Ground-Support-Equipment-SCRT/Pad-Side-Systems/LRUs/Pad Control Unit/IDC Interface Board/idc_interface_board/.step

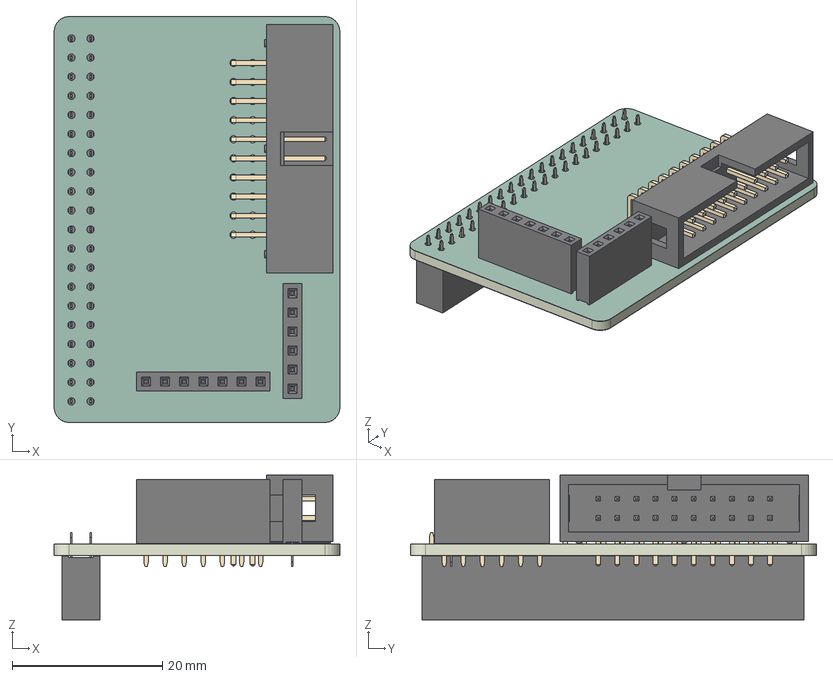
[picture p3: CAD file, 2026-10-17]
LRUs/Pad Control Unit/IDC Interface Board/idc_interface_board/.step
38.0 x 54.0 x 19.3 mm
PinSocket_1x06_P2.54mm_Vertical
IDC_Header_2x10_P254mm_Horizontal
PinSocket_1x07_P2.54mm_Vertical
PinSocket_2x20_P2.54mm_Vertical
idc_interface_board_copper
idc_interface_board_soldermask x 2
idc_interface_board_PCB
