Ground-Support-Equipment-SCRT/Pad-Side-Systems/LRUs/Valve Control Unit/Electrical/Valve Power Board/valve_control_pcb/components/36903255S/Download_STP_WE-SHC-36903255S+%28rev1%29.stp

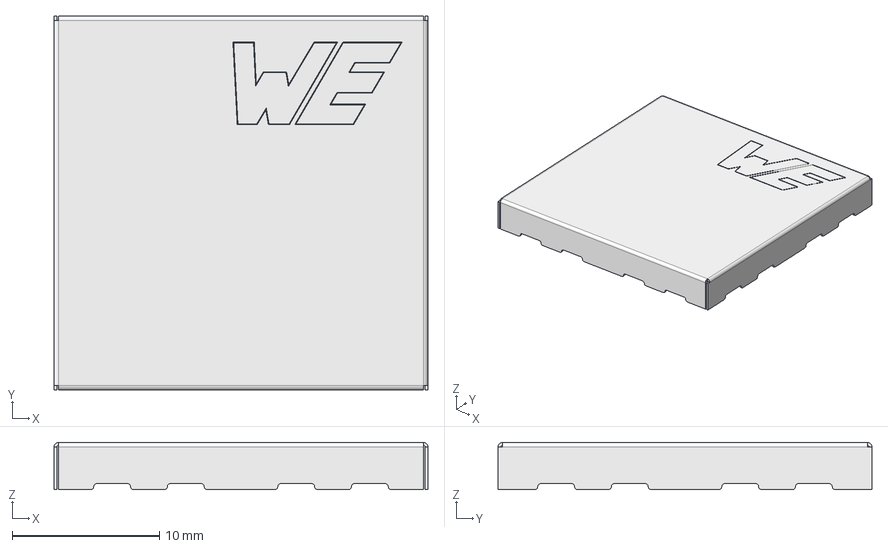
[picture p4: CAD file, 2026-07-26]
LRUs/Valve Control Unit/Electrical/Valve Power Board/valve_control_pcb/components/36903255S/Download_STP_WE-SHC-36903255S+%28rev1%29.stp
25.4 x 25.4 x 3.20 mm
