Ground-Support-Equipment-SCRT/Pad-Side-Systems/LRUs/Valve Control Unit/Electrical/Valve Power Board/valve_control_pcb/components/4259_63/SC-70-6_PSM.step

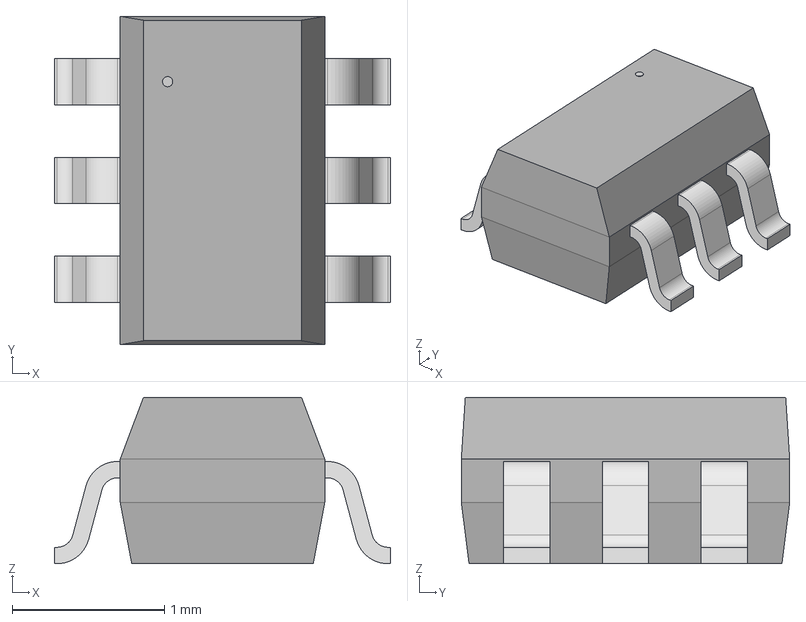
[picture p5: CAD file, 2026-07-26]
LRUs/Valve Control Unit/Electrical/Valve Power Board/valve_control_pcb/components/4259_63/SC-70-6_PSM.step
2.21 x 2.16 x 1.09 mm
