Ground-Support-Equipment-SCRT/Pad-Side-Systems/LRUs/Valve Control Unit/Electrical/Valve Power Board/valve_control_pcb/components/ADS124S08IPBSR/ADS124S08IPBSR.step

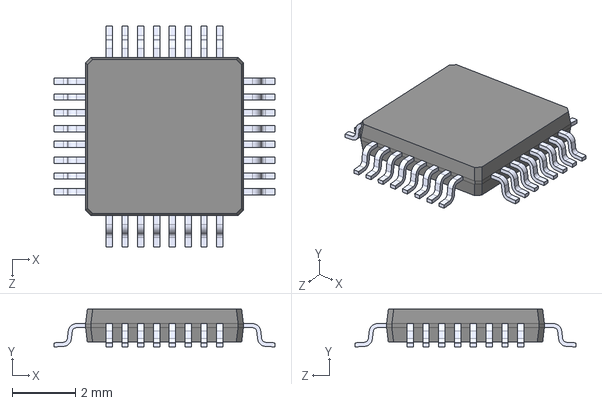
[picture p6: CAD file, 2026-08-30]
LRUs/Valve Control Unit/Electrical/Valve Power Board/valve_control_pcb/components/ADS124S08IPBSR/ADS124S08IPBSR.step
7.00 x 1.20 x 7.00 mm
