Ground-Support-Equipment-SCRT/Pad-Side-Systems/LRUs/Valve Control Unit/Electrical/Valve Power Board/valve_control_pcb/components/ESD441DPLR/DPL0002A.stp

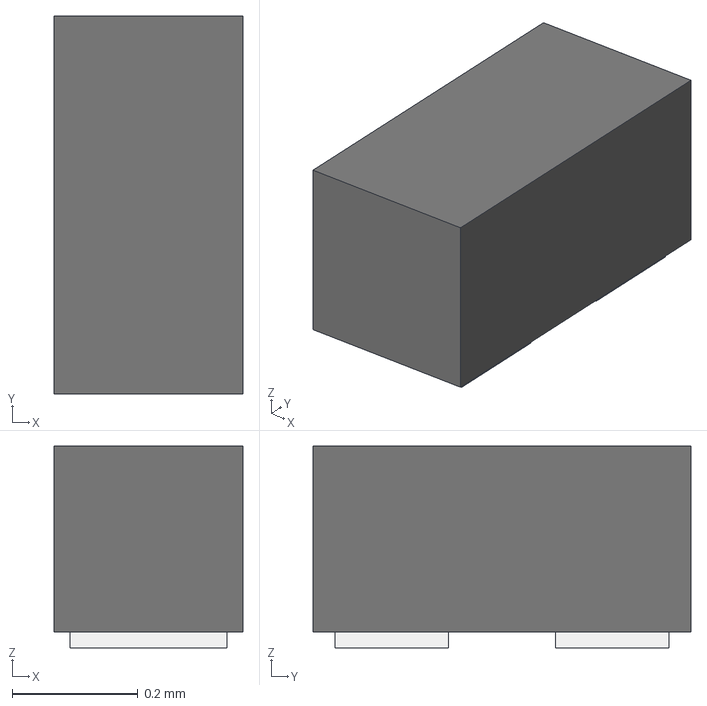
[picture p7: CAD file, 2026-07-26]
LRUs/Valve Control Unit/Electrical/Valve Power Board/valve_control_pcb/components/ESD441DPLR/DPL0002A.stp
0.3 x 0.6 x 0.32 mm
FRAME
MOLD
