Ground-Support-Equipment-SCRT/Pad-Side-Systems/LRUs/Valve Control Unit/Electrical/Valve Power Board/valve_control_pcb/components/FTSH_107_01_L_DV_K/FTSH-107-01-X-DV-K.step

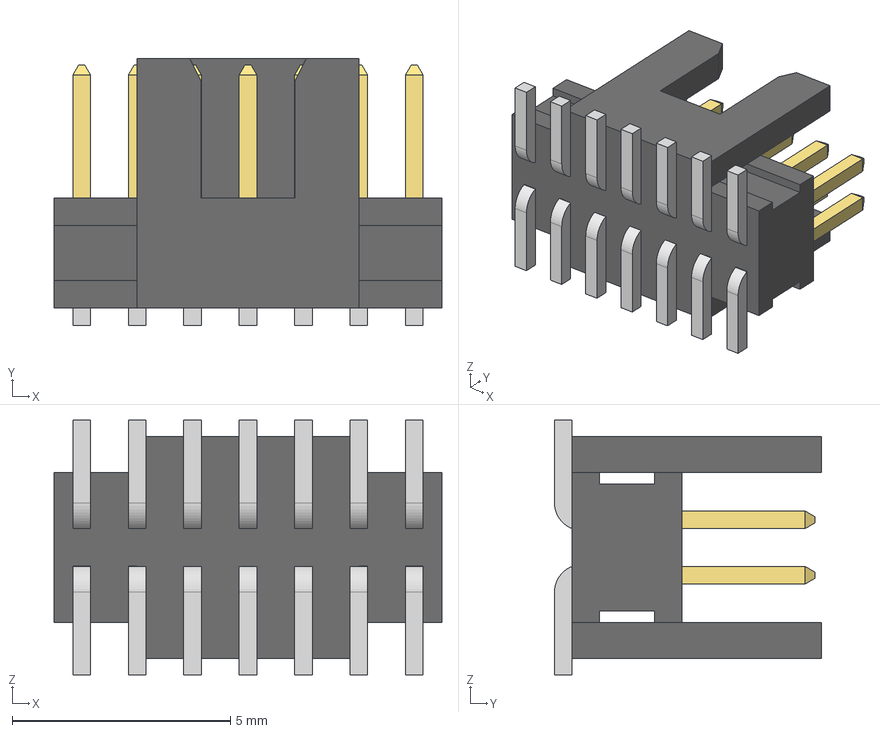
[picture p8: CAD file, 2026-10-01]
LRUs/Valve Control Unit/Electrical/Valve Power Board/valve_control_pcb/components/FTSH_107_01_L_DV_K/FTSH-107-01-X-DV-K.step
8.89 x 6.12 x 5.84 mm
FTSH-107-01-L-DV-K_body
FTSH-107-01-L-DV-K_pins1
FTSH-107-01-L-DV-K_pins2
