Ground-Support-Equipment-SCRT/Pad-Side-Systems/LRUs/Valve Control Unit/Electrical/Valve Power Board/valve_control_pcb/components/GSB1C41110SSHR/GSB1C41110SSHR.step

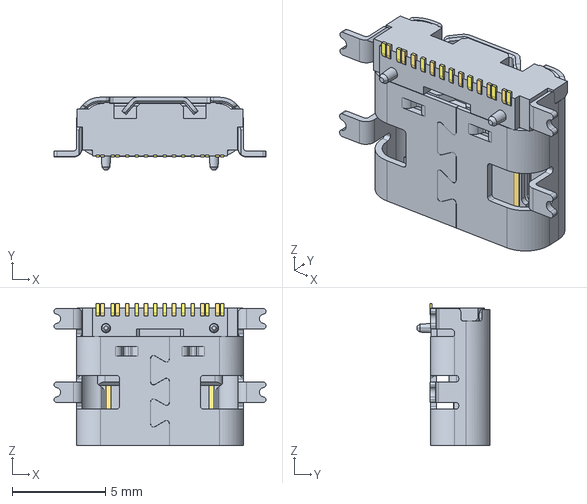
[picture p9: CAD file, 2026-07-26]
LRUs/Valve Control Unit/Electrical/Valve Power Board/valve_control_pcb/components/GSB1C41110SSHR/GSB1C41110SSHR.step
11.3 x 3.89 x 7.60 mm
