Ground-Support-Equipment-SCRT/Pad-Side-Systems/LRUs/Valve Control Unit/Electrical/Valve Power Board/valve_control_pcb/components/INA220/INA220AIDGSR-Henry-comp.step

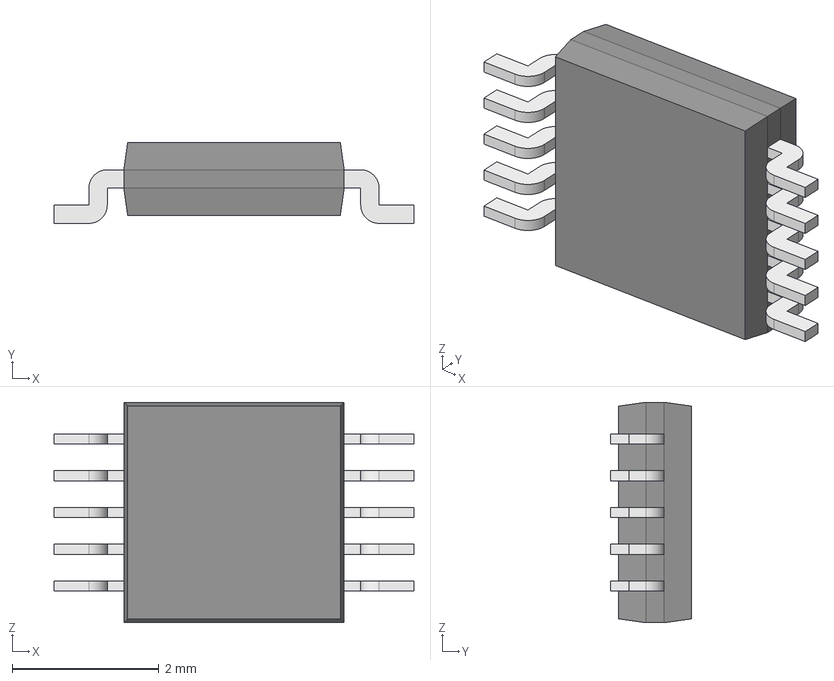
[picture p10: CAD file, 2026-08-24]
LRUs/Valve Control Unit/Electrical/Valve Power Board/valve_control_pcb/components/INA220/INA220AIDGSR-Henry-comp.step
4.90 x 1.10 x 3.00 mm
Body001 (Mirror #1) x 5
XY-plane x 12
X-axis x 12
