Ground-Support-Equipment-SCRT/Pad-Side-Systems/LRUs/Valve Control Unit/Electrical/Valve Power Board/valve_control_pcb/components/J107F1CS205VDC_45/J107F1C.stp

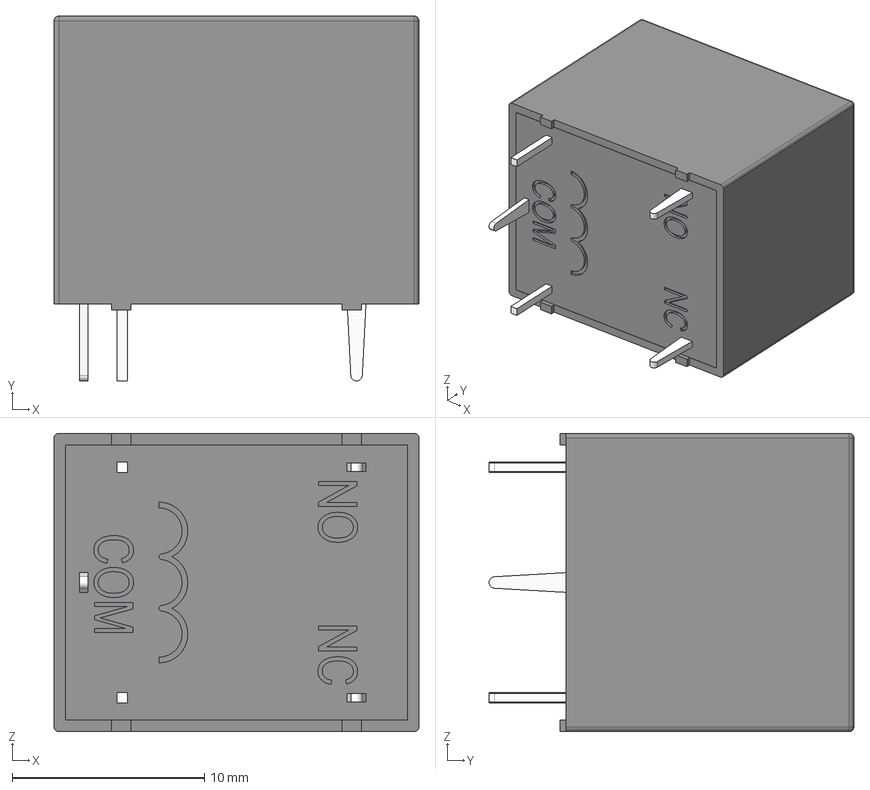
[picture p11: CAD file, 2026-07-26]
LRUs/Valve Control Unit/Electrical/Valve Power Board/valve_control_pcb/components/J107F1CS205VDC_45/J107F1C.stp
19.0 x 19.0 x 15.5 mm
J107F1C_BASE
J107F_COVER
J107F_SQ_LEAD x 2
J107F_LEAD 1 x 2
J107F_LEAD 2
