Ground-Support-Equipment-SCRT/Pad-Side-Systems/LRUs/Valve Control Unit/Electrical/Valve Power Board/valve_control_pcb/components/LM5145RGYR/RGY0020B.stp

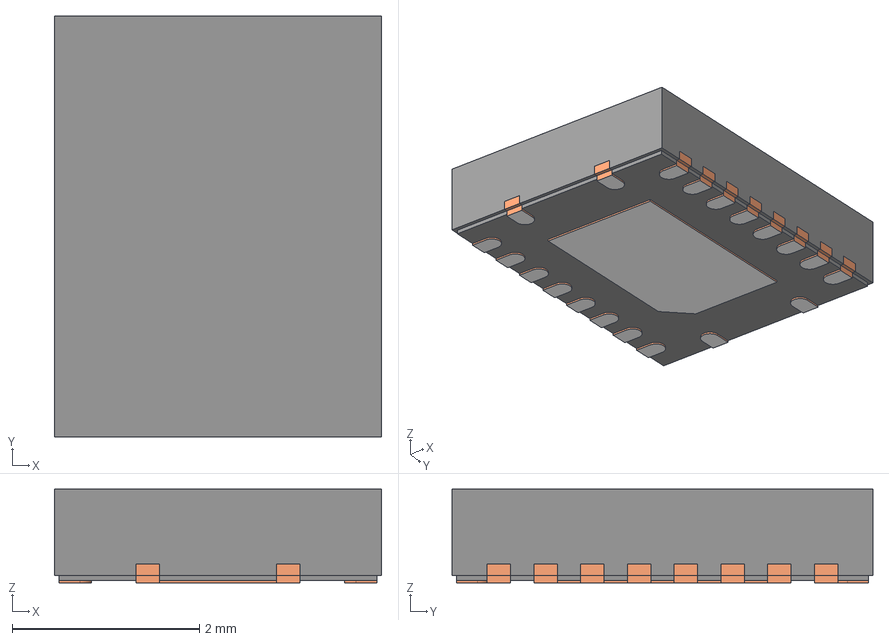
[picture p12: CAD file, 2026-07-26]
LRUs/Valve Control Unit/Electrical/Valve Power Board/valve_control_pcb/components/LM5145RGYR/RGY0020B.stp
3.50 x 4.50 x 1.00 mm
BODY-QFN_AF0
FRAME-RGY0020B_AF0
PIN1-ID
