Ground-Support-Equipment-SCRT/Pad-Side-Systems/LRUs/Valve Control Unit/Electrical/Valve Power Board/valve_control_pcb/components/MSS1278_822MLD/MSS1278.STEP

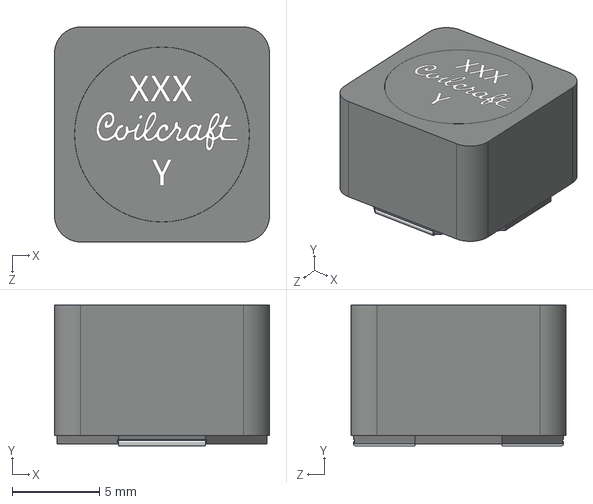
[picture p13: CAD file, 2026-08-24]
LRUs/Valve Control Unit/Electrical/Valve Power Board/valve_control_pcb/components/MSS1278_822MLD/MSS1278.STEP
12.3 x 8.05 x 12.3 mm
