Ground-Support-Equipment-SCRT/Pad-Side-Systems/LRUs/Valve Control Unit/Electrical/Valve Power Board/valve_control_pcb/components/NVMFS021N10MCLT1G/NVMFS021N10MCLT1G.step

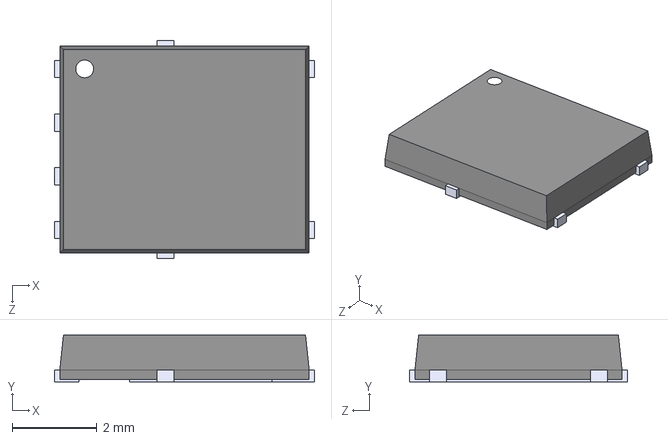
[picture p14: CAD file, 2026-07-26]
LRUs/Valve Control Unit/Electrical/Valve Power Board/valve_control_pcb/components/NVMFS021N10MCLT1G/NVMFS021N10MCLT1G.step
6.15 x 1.10 x 5.15 mm
