Ground-Support-Equipment-SCRT/Pad-Side-Systems/LRUs/Valve Control Unit/Electrical/Valve Power Board/valve_control_pcb/components/PKM22EPPH2002_B0/PKM22EPPH2002-B0.step

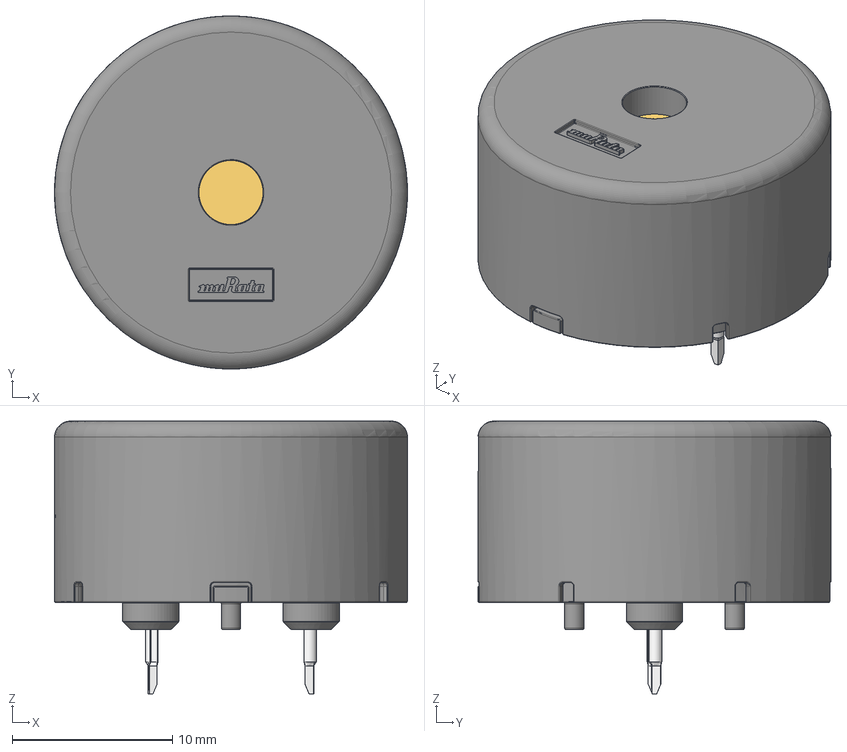
[picture p15: CAD file, 2026-07-26]
LRUs/Valve Control Unit/Electrical/Valve Power Board/valve_control_pcb/components/PKM22EPPH2002_B0/PKM22EPPH2002-B0.step
22.0 x 22.0 x 17.0 mm
Package
Membrane
Leads
