Ground-Support-Equipment-SCRT/Pad-Side-Systems/LRUs/Valve Control Unit/Electrical/Valve Power Board/valve_control_pcb/components/RAPC722X/RAPC722X.step

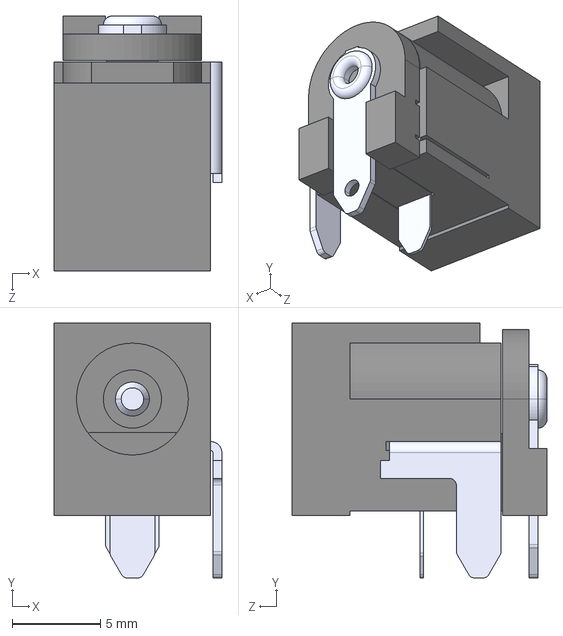
[picture p16: CAD file, 2026-07-26]
LRUs/Valve Control Unit/Electrical/Valve Power Board/valve_control_pcb/components/RAPC722X/RAPC722X.step
9.53 x 14.5 x 14.5 mm
