Ground-Support-Equipment-SCRT/Pad-Side-Systems/LRUs/Valve Control Unit/Electrical/Valve Power Board/valve_control_pcb/components/RFM69HW_433S2/RFM69HW-433S2.STEP

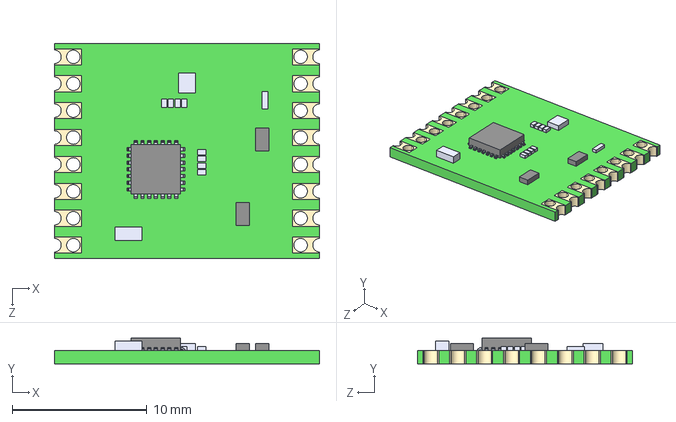
[picture p17: CAD file, 2026-07-26]
LRUs/Valve Control Unit/Electrical/Valve Power Board/valve_control_pcb/components/RFM69HW_433S2/RFM69HW-433S2.STEP
19.7 x 1.90 x 16.0 mm
