Ground-Support-Equipment-SCRT/Pad-Side-Systems/LRUs/Valve Control Unit/Electrical/Valve Power Board/valve_control_pcb/components/SiR882ADP/SIR882ADP-T1-GE3.STEP

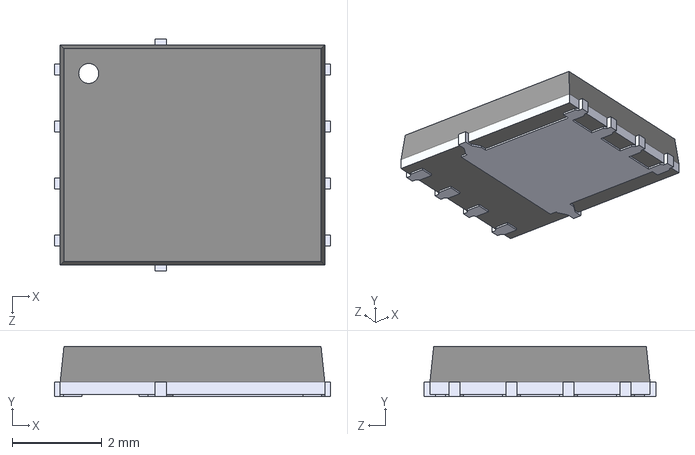
[picture p18: CAD file, 2026-07-26]
LRUs/Valve Control Unit/Electrical/Valve Power Board/valve_control_pcb/components/SiR882ADP/SIR882ADP-T1-GE3.STEP
6.15 x 1.12 x 5.16 mm
