Ground-Support-Equipment-SCRT/Pad-Side-Systems/LRUs/Valve Control Unit/Electrical/Valve Power Board/valve_control_pcb/components/SN74HC32DR/SN74HC32DR-Henry-comp.step

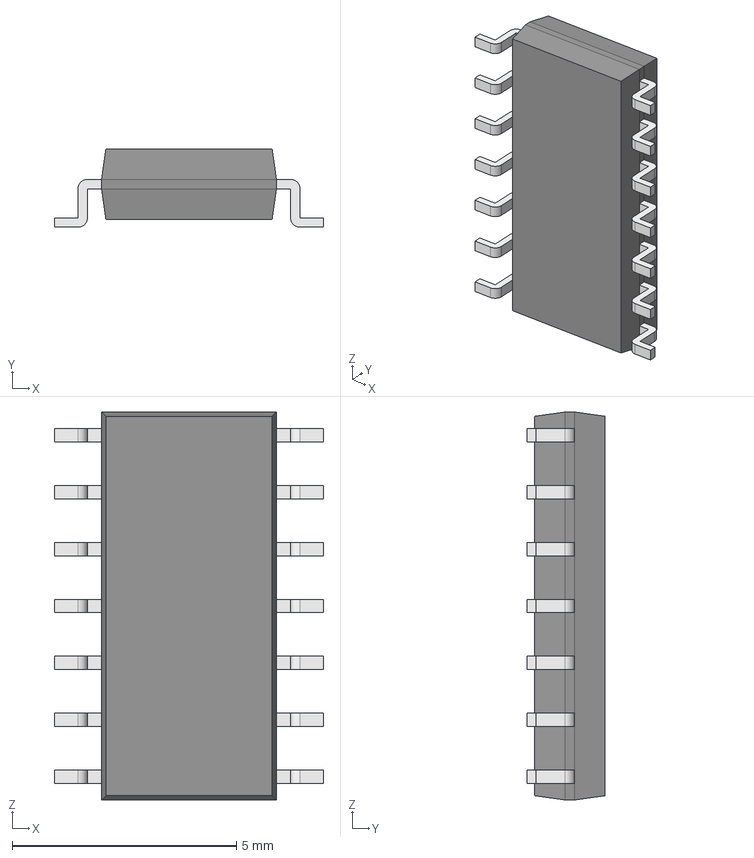
[picture p19: CAD file, 2026-08-24]
LRUs/Valve Control Unit/Electrical/Valve Power Board/valve_control_pcb/components/SN74HC32DR/SN74HC32DR-Henry-comp.step
6.00 x 1.75 x 8.65 mm
Body001 (Mirror #1) x 7
XY-plane x 12
X-axis x 12
