Ground-Support-Equipment-SCRT/Pad-Side-Systems/LRUs/Valve Control Unit/Electrical/Valve Power Board/valve_control_pcb/components/SN74LVC2G08MDCUREP/SN74LVC2G08MDCUREP.step

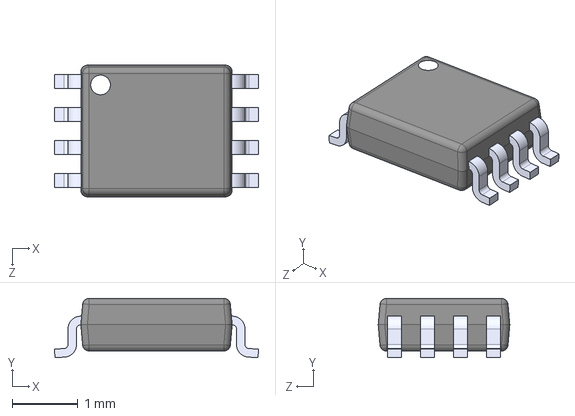
[picture p20: CAD file, 2026-07-26]
LRUs/Valve Control Unit/Electrical/Valve Power Board/valve_control_pcb/components/SN74LVC2G08MDCUREP/SN74LVC2G08MDCUREP.step
3.10 x 0.9 x 2.00 mm
