Ground-Support-Equipment-SCRT/Pad-Side-Systems/LRUs/Valve Control Unit/Electrical/Valve Power Board/valve_control_pcb/components/SP485EEN_L_TR/NSOIC-8.step

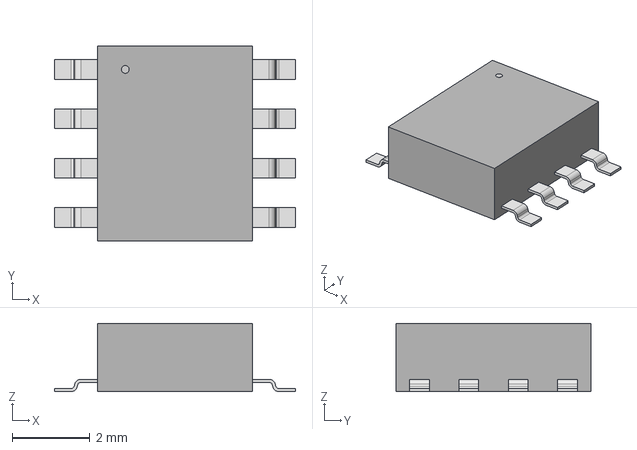
[picture p21: CAD file, 2026-07-26]
LRUs/Valve Control Unit/Electrical/Valve Power Board/valve_control_pcb/components/SP485EEN_L_TR/NSOIC-8.step
6.20 x 5.00 x 1.75 mm
