Ground-Support-Equipment-SCRT/Pad-Side-Systems/LRUs/Valve Control Unit/Electrical/Valve Power Board/valve_control_pcb/components/ul_TPS27SA08CPWPR/PWP0016M.stp

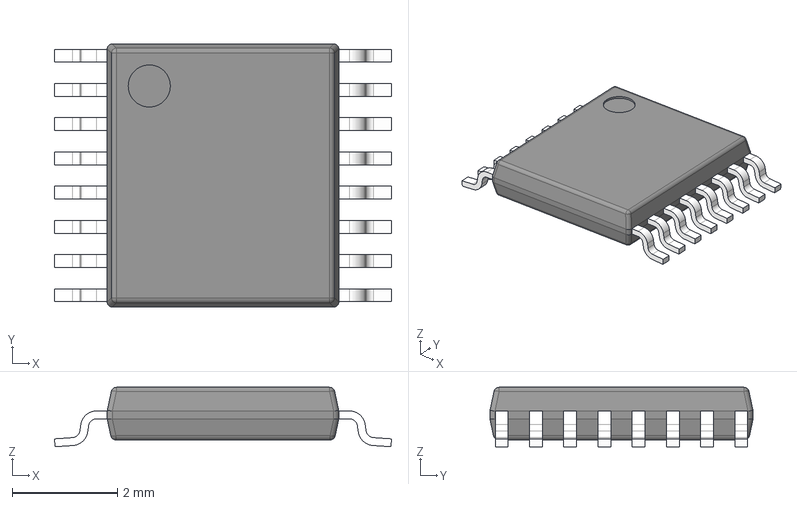
[picture p22: CAD file, 2026-08-24]
LRUs/Valve Control Unit/Electrical/Valve Power Board/valve_control_pcb/components/ul_TPS27SA08CPWPR/PWP0016M.stp
6.40 x 5.00 x 1.13 mm
BODY-TSSOP
LEAD-TSSOP x 16
PIN1
DAP
