Ground-Support-Equipment-SCRT/Pad-Side-Systems/LRUs/Valve Control Unit/Electrical/Valve Power Board/valve_control_pcb/components/USB-C/CQ-USB-C16PSMT01--3DModel-STEP-1.STEP

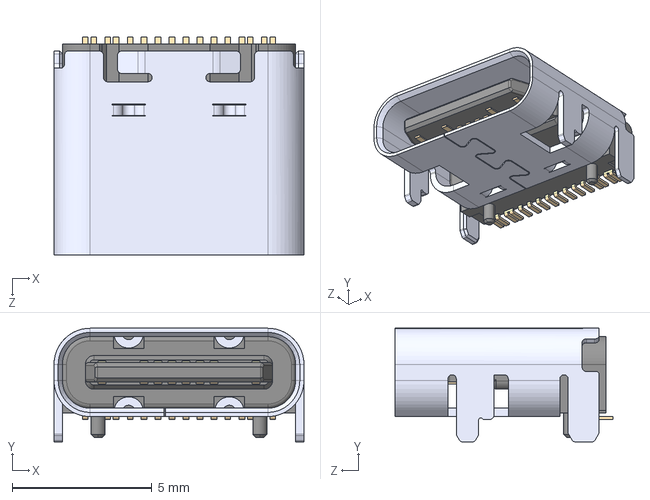
[picture p23: CAD file, 2026-07-26]
LRUs/Valve Control Unit/Electrical/Valve Power Board/valve_control_pcb/components/USB-C/CQ-USB-C16PSMT01--3DModel-STEP-1.STEP
8.94 x 4.06 x 7.81 mm
