Ground-Support-Equipment-SCRT/Pad-Side-Systems/LRUs/Valve Control Unit/Electrical/Valve Power Board/valve_control_pcb/components/W25Q128JVSIQ_TR/W25Q128JVSIQ TR.step

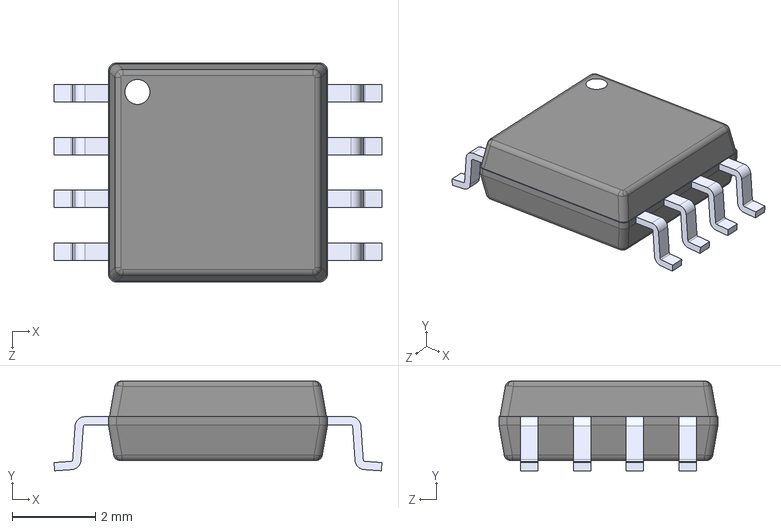
[picture p24: CAD file, 2026-10-01]
LRUs/Valve Control Unit/Electrical/Valve Power Board/valve_control_pcb/components/W25Q128JVSIQ_TR/W25Q128JVSIQ TR.step
7.90 x 2.16 x 5.28 mm
