Ground-Support-Equipment-SCRT/Pad-Side-Systems/LRUs/Valve Control Unit/Electrical/Valve Power Board/valve_control_pcb/components/XAL7030_161MEC/XAL7030-161MEC.step

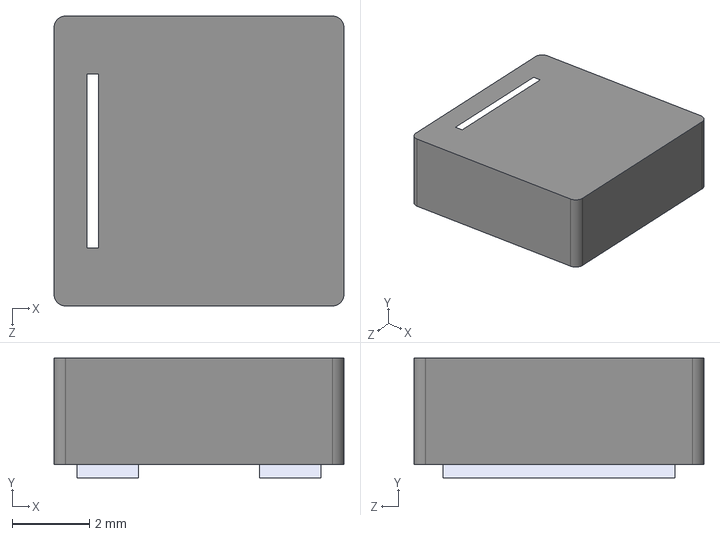
[picture p25: CAD file, 2026-08-24]
LRUs/Valve Control Unit/Electrical/Valve Power Board/valve_control_pcb/components/XAL7030_161MEC/XAL7030-161MEC.step
7.50 x 3.10 x 7.50 mm
