Ground-Support-Equipment-SCRT/Pad-Side-Systems/LRUs/Valve Control Unit/Electrical/Valve Power Board/valve_control_pcb/components/XAL7070-332MEC/XAL7070-332MEC-Henry-comp.step

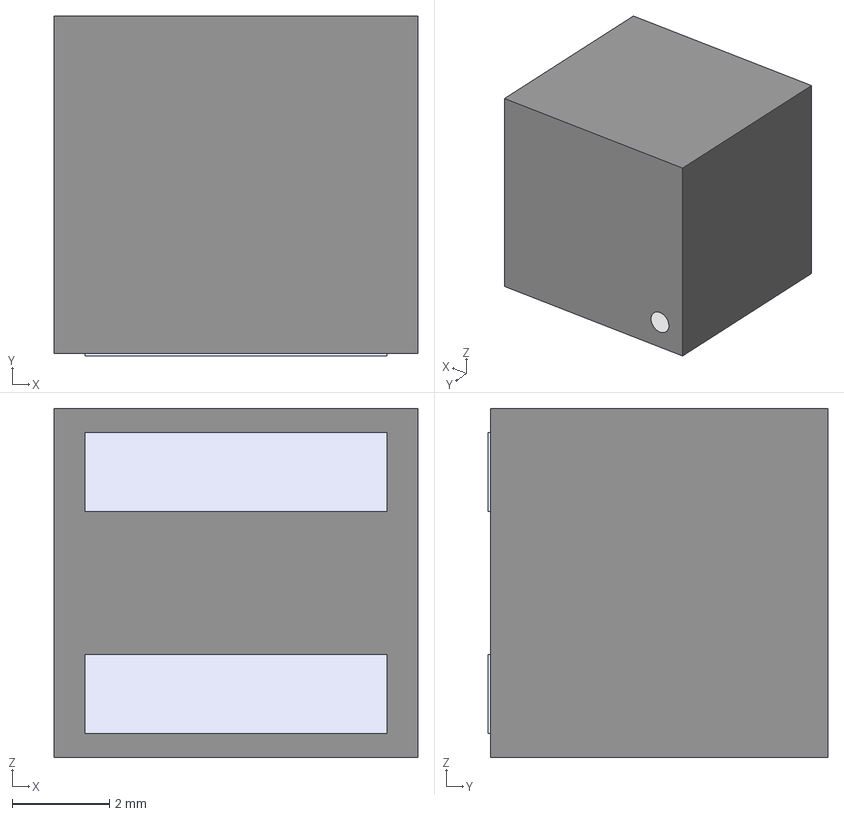
[picture p26: CAD file, 2026-08-24]
LRUs/Valve Control Unit/Electrical/Valve Power Board/valve_control_pcb/components/XAL7070-332MEC/XAL7070-332MEC-Henry-comp.step
7.50 x 7.00 x 7.20 mm
BaseWithTopCut
TopCircle_NewBody
