Ground-Support-Equipment-SCRT/Pad-Side-Systems/LRUs/Valve Control Unit/Electrical/Valve Power Board/valve_control_pcb/valve_control_pcb.step

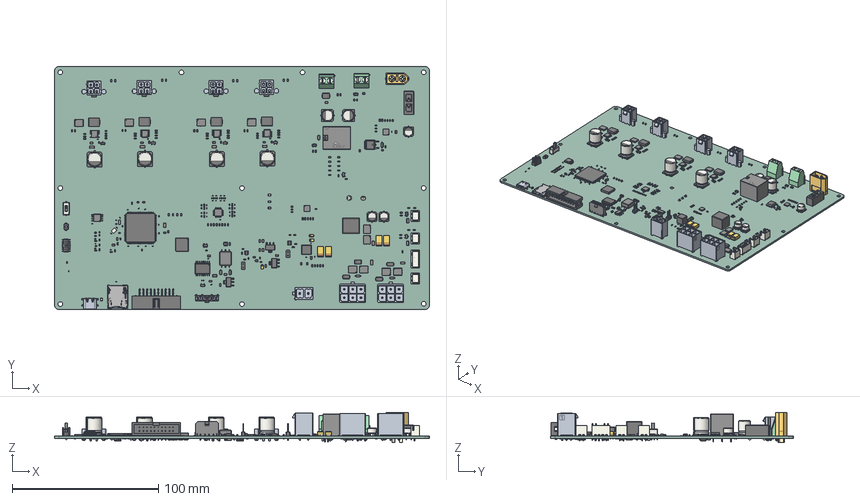
[picture p27: CAD file, 2026-10-08]
LRUs/Valve Control Unit/Electrical/Valve Power Board/valve_control_pcb/valve_control_pcb.step
256.0 x 166.0 x 20.5 mm
C_0402_1005Metric x 59
CP_Elec_10x126 x 4
R_0402_1005Metric x 44
LQFP-144_20x20mm_P0.5mm
LED_0603_1608Metric x 19
R_0603_1608Metric x 195
C_0805_2012Metric x 25
microSD_HC_Hirose_DM3AT-SF-PEJM5
D_SMB
C_0603_1608Metric x 16
CP_Elec_63x54 x 3
D_SOD-123 x 6
BODY-TSSOP x 4
LEAD-TSSOP x 64
PIN1 x 4
DAP x 4
SOT-223 x 3
SIR826ADP-T1-GE3 x 10
SOT-23 x 16
R_1206_3216Metric
JST_B2B_XH_A x 3
UCC21750
TerminalBlock_Phoenix_MKDS-1,5-2-5.08_1x02_P5.08mm_Horizontal x 2
LED_0805_2012Metric x 4
ADS124S08IPBSR
C_1206_3216Metric x 11
CP_EIA_3216_18_Kemet_A x 3
RGE24 x 2
Buzzer_Murata_PKMCS0909E4000_R1
A_Keystone_3568
CP_EIA_7343_31_Kemet_D x 4
CP_Elec_8x105 x 2
JST_B4B_XH_A
L_0603_1608Metric x 2
J107F1C_BASE
J107F_COVER
J107F_SQ_LEAD x 2
J107F_LEAD 1 x 2
J107F_LEAD 2
Crystal_SMD_3215-2Pin_3.2x1.5mm
U.FL_Hirose_U.FL-R-SMT-1_Vertical x 2
D_SMC x 4
SOT-583-8 x 2
L_Coilcraft_XAL1010-XXX
D_SMA x 4
SW_Push_SPST_NO_Alps_SKRK
FTSH-107-01-L-DV-K_body
FTSH-107-01-L-DV-K_pins1
FTSH-107-01-L-DV-K_pins2
SOT-23-6 x 3
W25Q32JWSSIQ
SOT-23-5
PinHeader_1x02_P254mm_Vertical x 2
250-1201_6A
150-3076_6A
SW_Slide_SPDT_Straight_CK_OS102011MS2Q
L_Coilcraft_XAL6060-XXX
_16P_7_35_3D_
IDC_Header_2x10_P254mm_Horizontal
Crystal_SMD_3225-4Pin_3.2x2.5mm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
