Ground-Support-Equipment-SCRT/Pad-Side-Systems/(list of files, cad)

Other CAD files:
LRUs/Valve Control Unit/Electrical/Valve Power Board/valve_control_pcb/components/09242206824/09242206824.stp
LRUs/Valve Control Unit/Electrical/Valve Power Board/valve_control_pcb/components/39299047/39299047.STEP
LRUs/Valve Control Unit/Electrical/Valve Power Board/valve_control_pcb/components/436500215/436500215.STEP
LRUs/Valve Control Unit/Electrical/Valve Power Board/valve_control_pcb/components/436500415/436500415.STEP
LRUs/Valve Control Unit/Electrical/Valve Power Board/valve_control_pcb/components/436500600/436500600.STEP
LRUs/Valve Control Unit/Electrical/Valve Power Board/valve_control_pcb/components/750315371/750315371.stp
LRUs/Valve Control Unit/Electrical/Valve Power Board/valve_control_pcb/components/768290110/768290110.STEP
LRUs/Valve Control Unit/Electrical/Valve Power Board/valve_control_pcb/components/ISO1450BDWR (1)/ISO1450BDWR.step
LRUs/Valve Control Unit/Electrical/Valve Power Board/valve_control_pcb/components/ISO3080DWR/ISO3080DWR.step
LRUs/Valve Control Unit/Electrical/Valve Power Board/valve_control_pcb/components/LIB_76829-0102/76829-0102/3D/76829-0102.stp
LRUs/Valve Control Unit/Electrical/Valve Power Board/valve_control_pcb/components/LIB_76829-0102/76829-0102/Allegro/768290102.psm
LRUs/Valve Control Unit/Electrical/Valve Power Board/valve_control_pcb/components/LIB_76829-0102/76829-0102/DEHDL/76829_0102/chips/chips.prt
LRUs/Valve Control Unit/Electrical/Valve Power Board/valve_control_pcb/components/LIB_76829-0106/76829-0106/3D/76829-0106.stp
LRUs/Valve Control Unit/Electrical/Valve Power Board/valve_control_pcb/components/LIB_76829-0106/76829-0106/Allegro/768290106.psm
LRUs/Valve Control Unit/Electrical/Valve Power Board/valve_control_pcb/components/LIB_76829-0106/76829-0106/DEHDL/76829_0106/chips/chips.prt
LRUs/Valve Control Unit/Electrical/Valve Power Board/valve_control_pcb/components/TPS259830ONRGER (1)/TPS259830ONRGER.step
LRUs/Valve Control Unit/Electrical/Valve Power Board/valve_control_pcb/components/TPS79533DCQR/TPS79533DCQR.step
