Ground-Support-Equipment-SCRT/Pad-Side-Systems/LRUs/Valve Control Unit/Electrical/Valve Power Board/Review Package/RUBY_REVA_SCHEMATIC.pdf

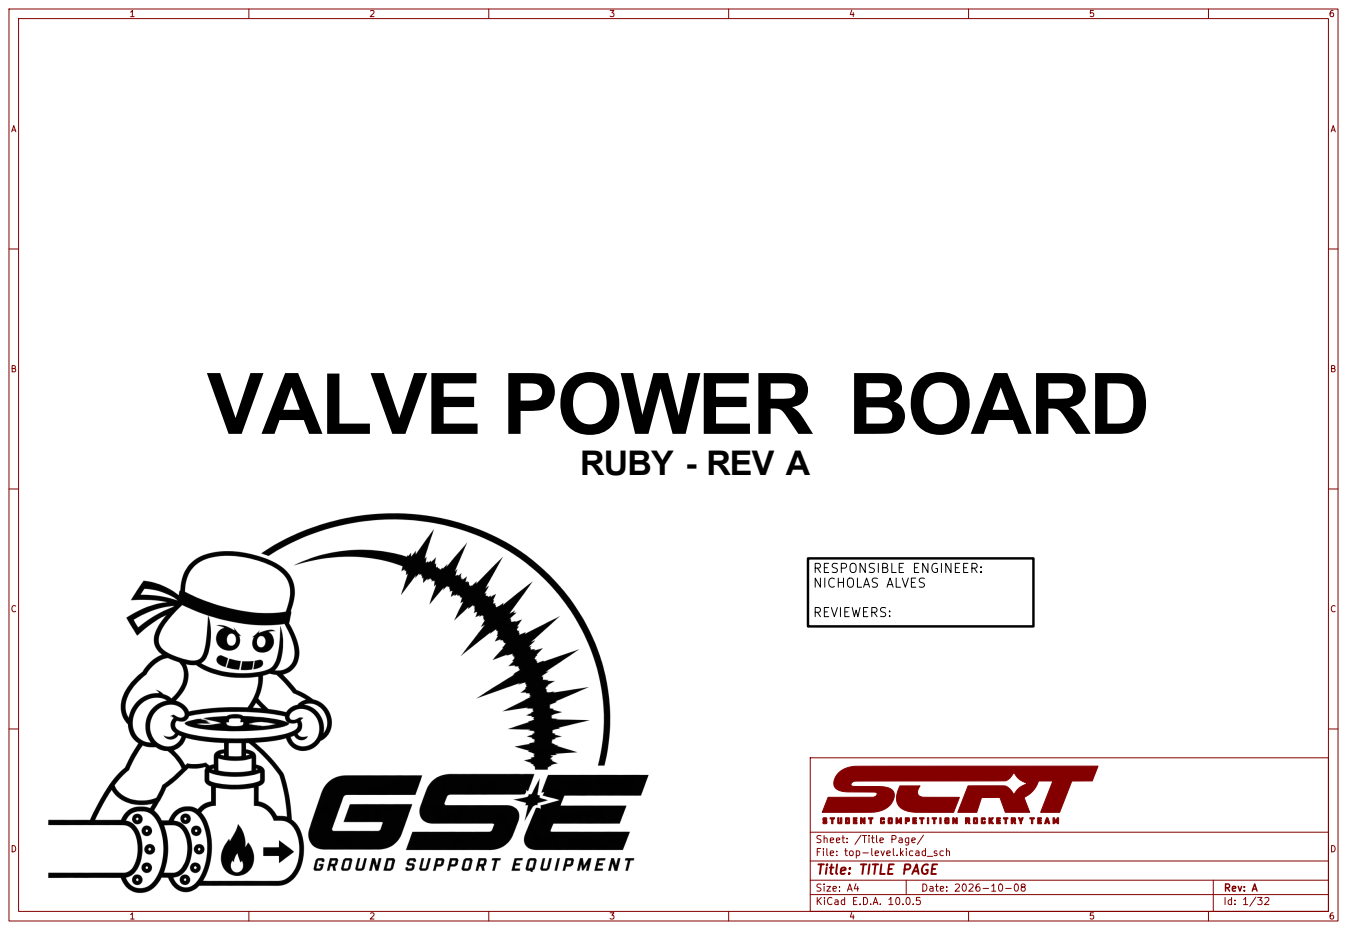
[picture p28: page 1]

Size: A4 | Rev: A
KiCad E.D.A. 10.0.5 | Id: 1/32

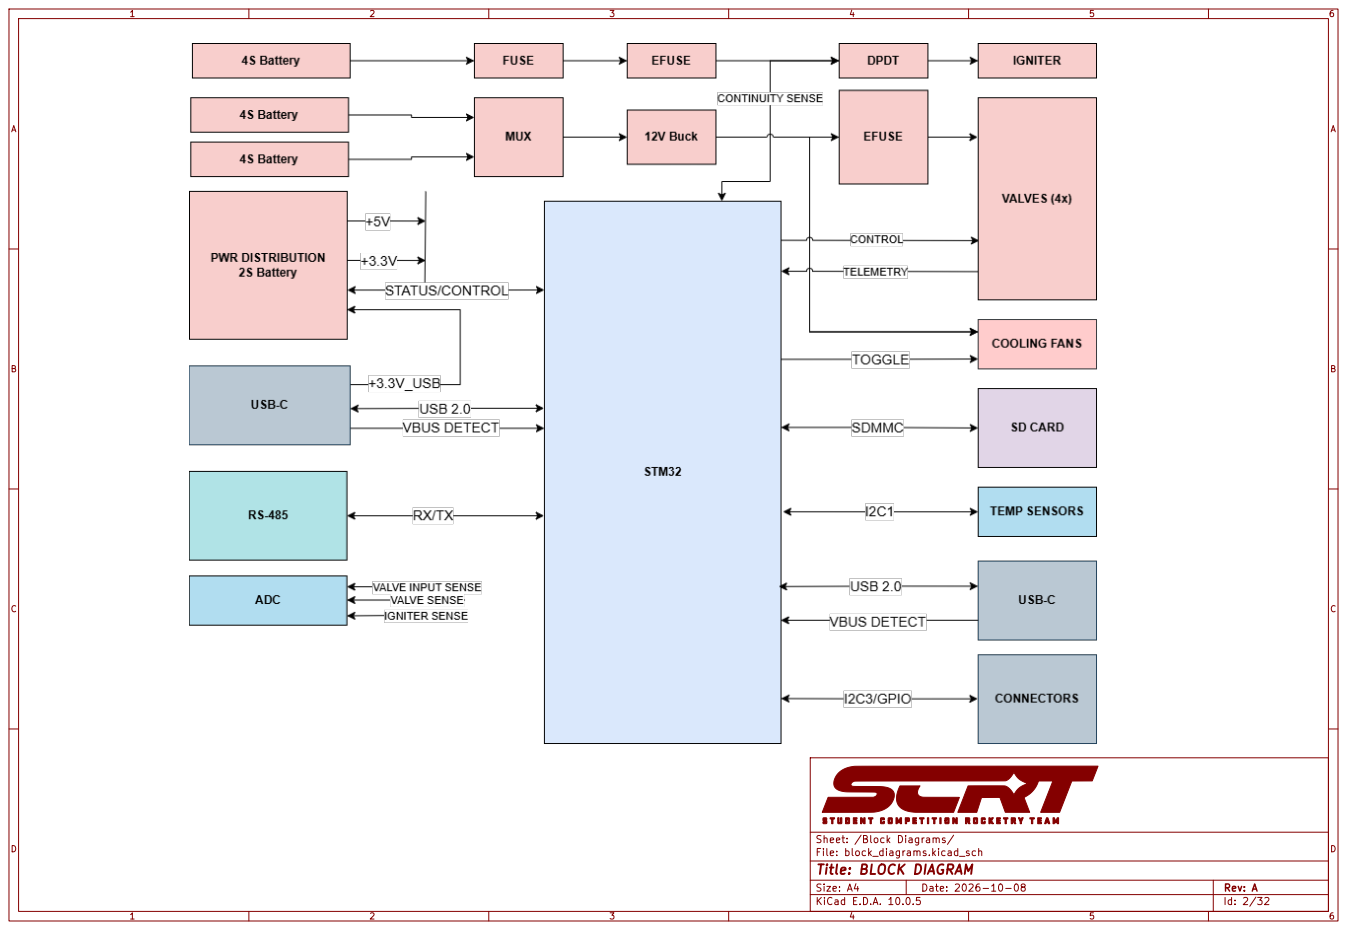
[picture p29: page 2]

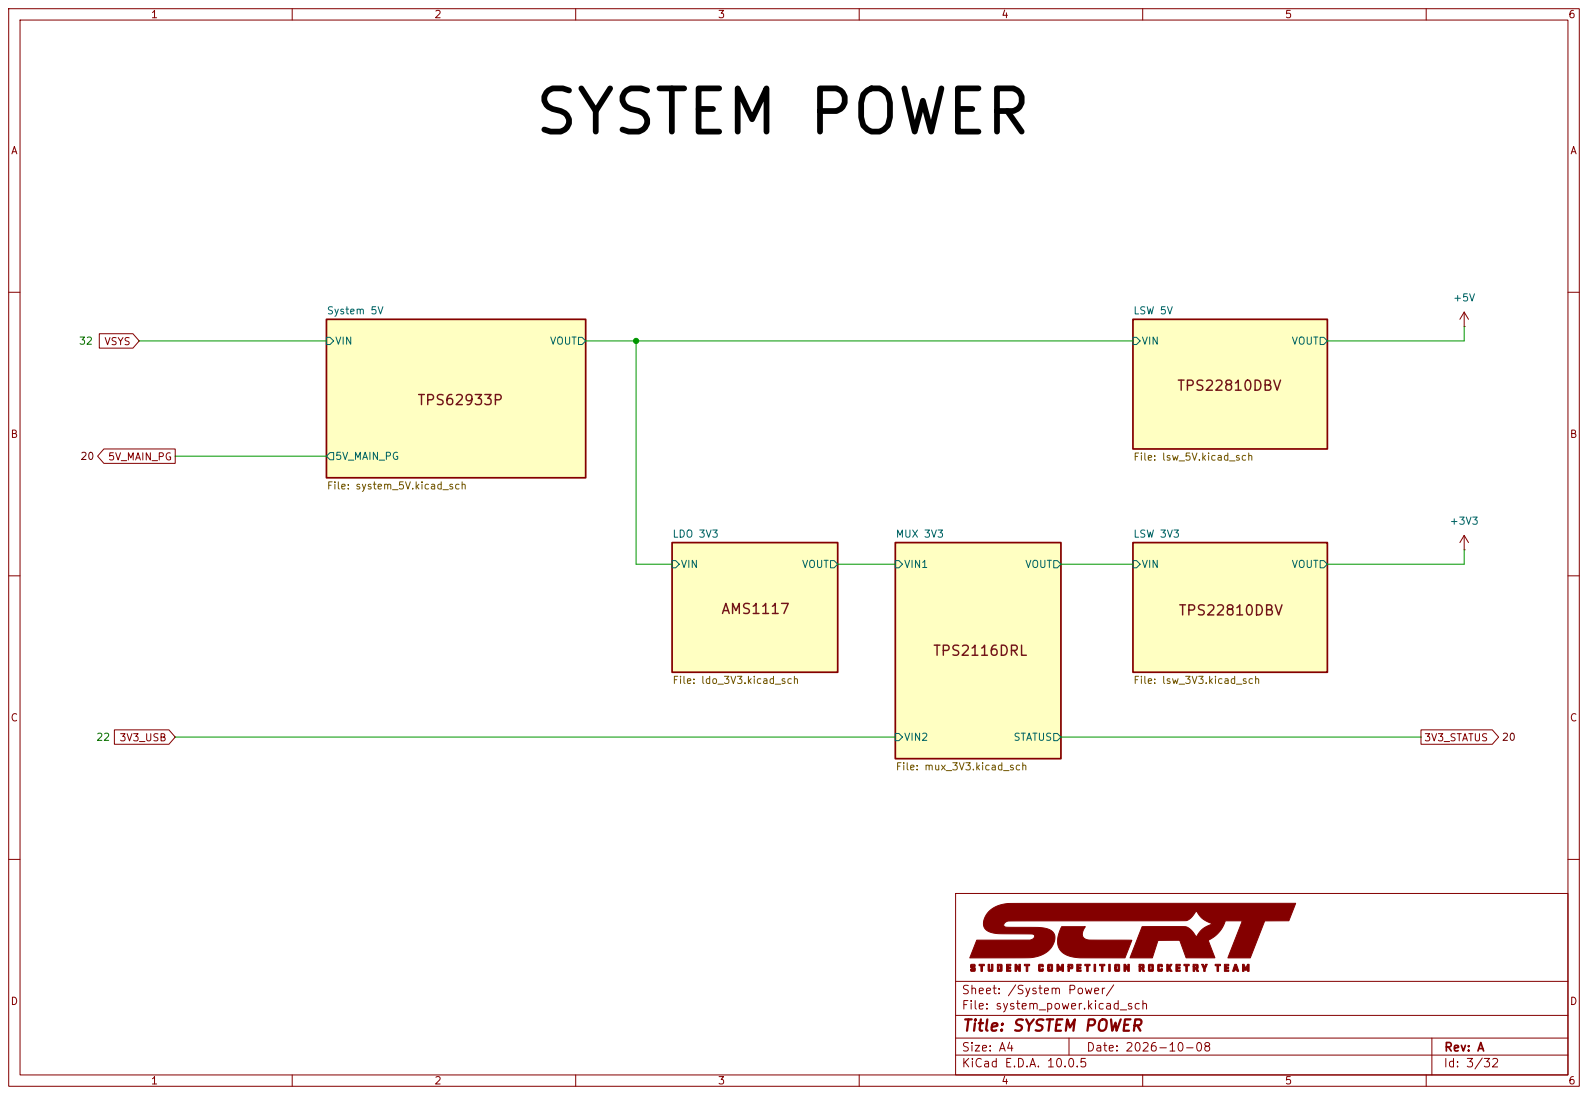
[picture p30: page 3]

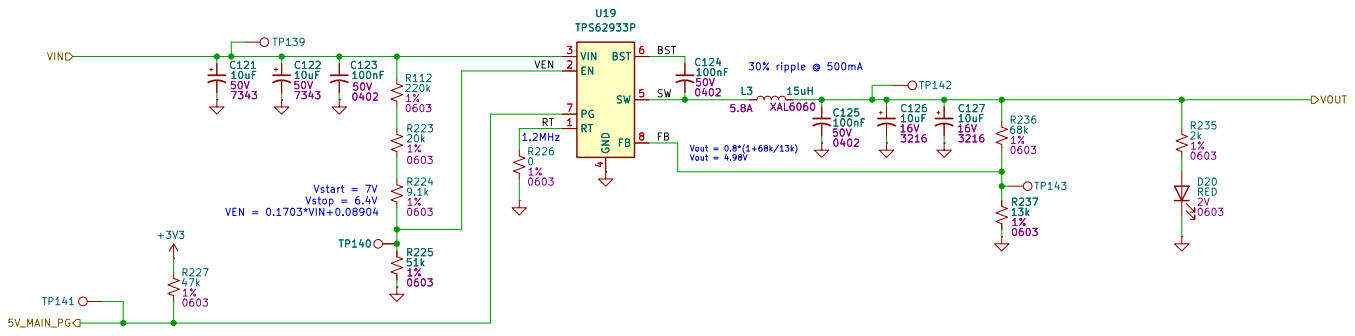
[picture p31: page 4]

Sheet: /System Power/System 5V/
File: system_5V.kicad_sch
Title: SYSTEM 5V

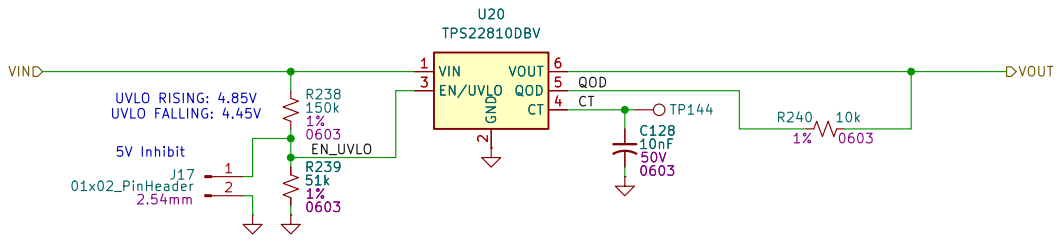
[picture p32: page 5]

Sheet: /System Power/LSW 5V/
File: lsw_5V.kicad_sch
Title: LSW 5V

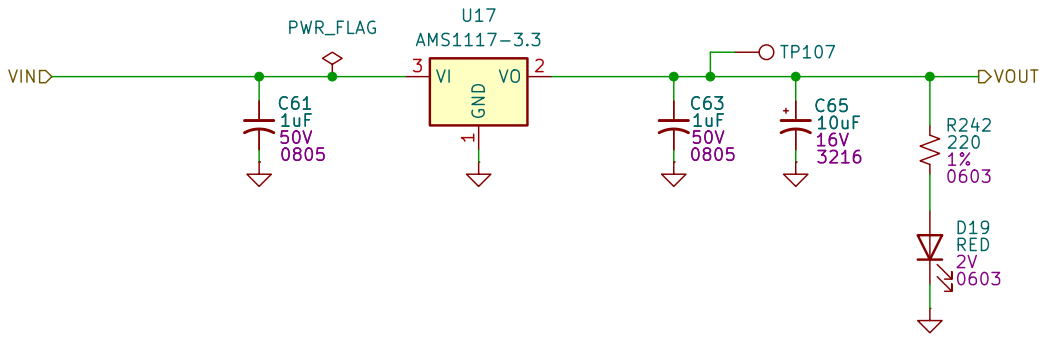
[picture p33: page 6]

Sheet: /System Power/LDO 3V3/
File: ldo_3V3.kicad_sch
Title: LDO 3V3

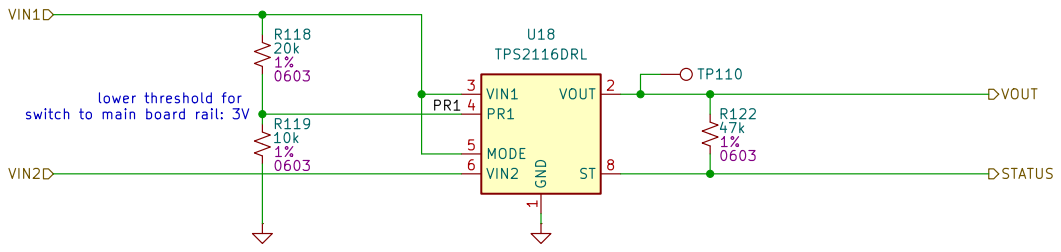
[picture p34: page 7]

Sheet: /System Power/MUX 3V3/
File: mux_3V3.kicad_sch
Title: MUX 3V3

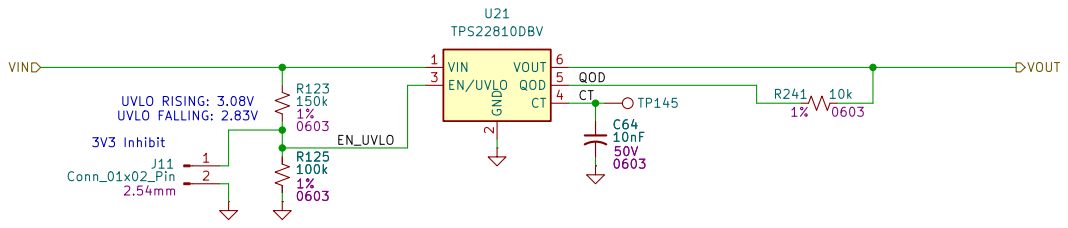
[picture p35: page 8]

Sheet: /System Power/LSW 3V3/
File: lsw_3V3.kicad_sch
Title: LSW 3V3

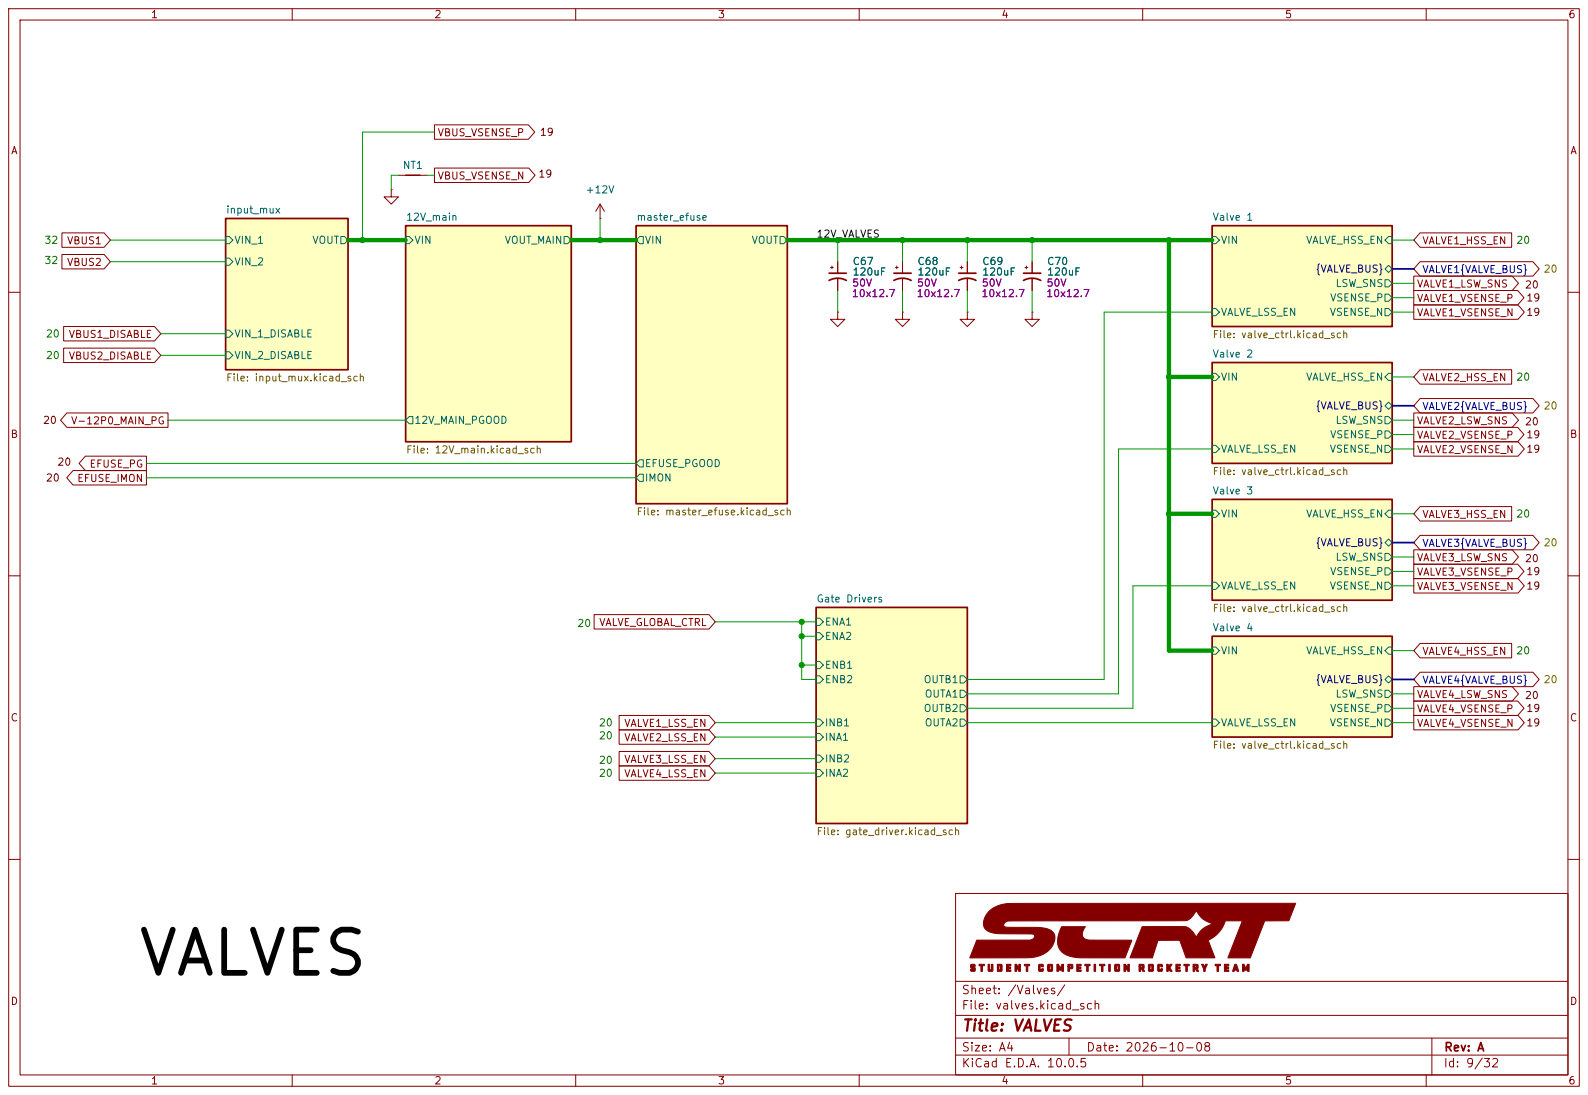
[picture p36: page 9]

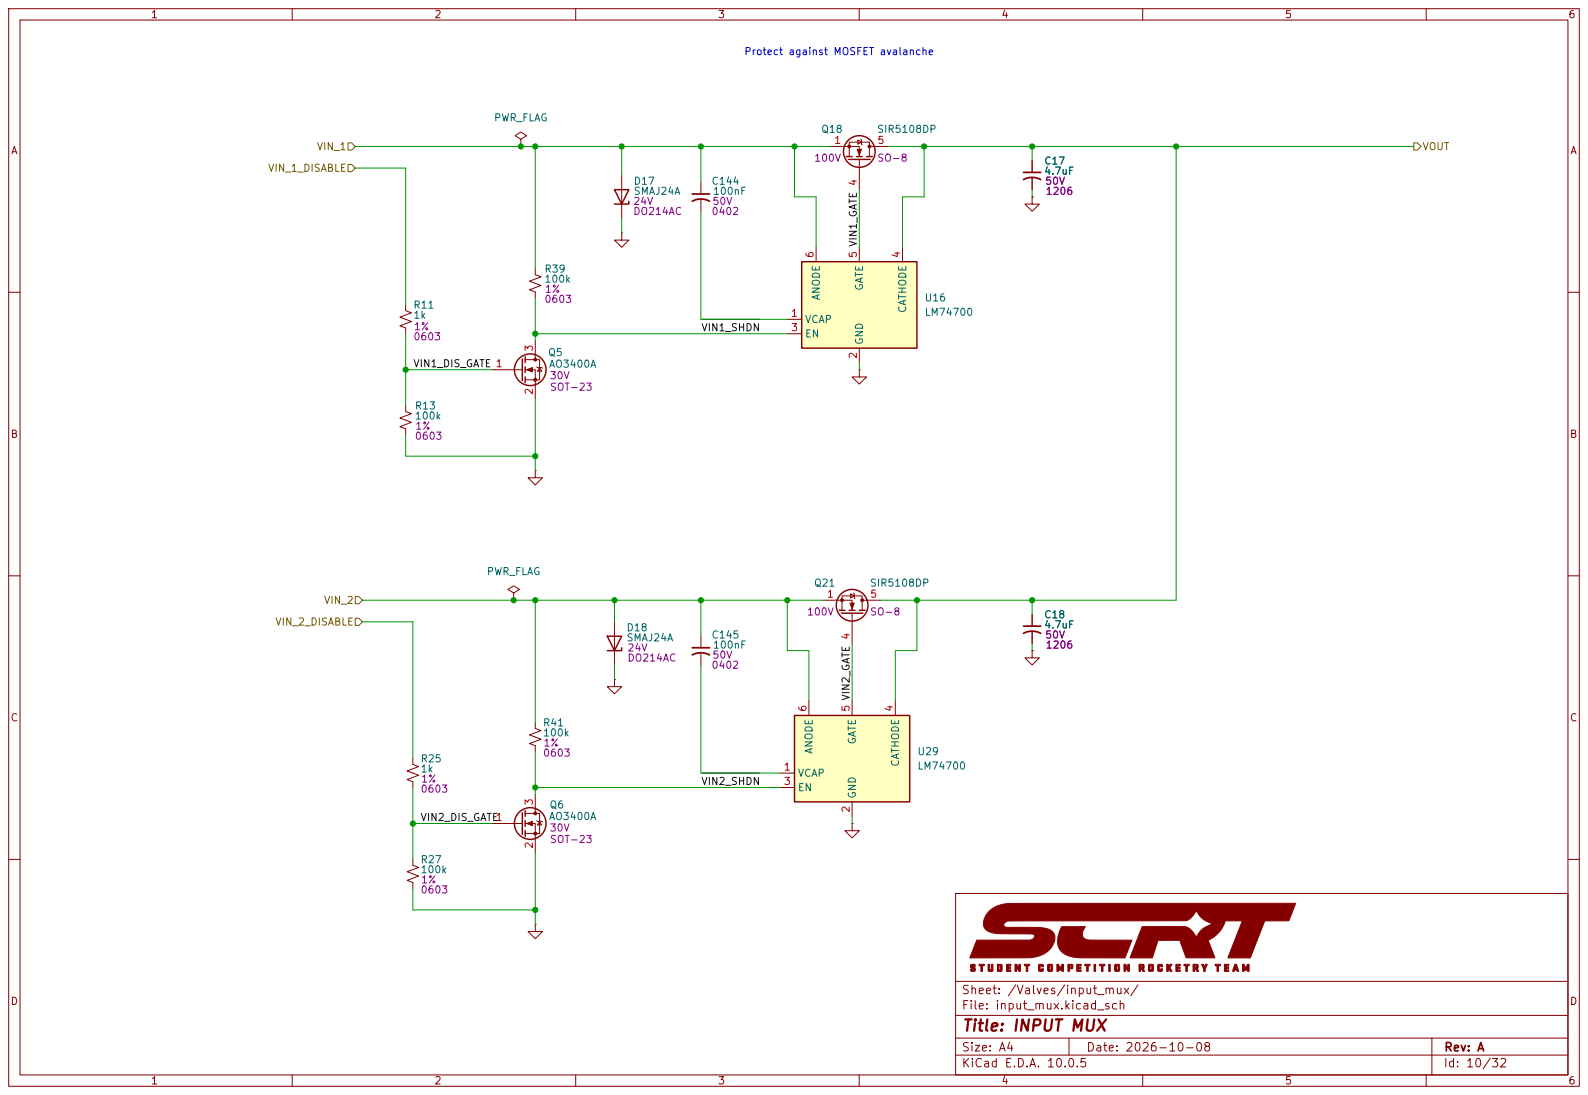
[picture p37: page 10]

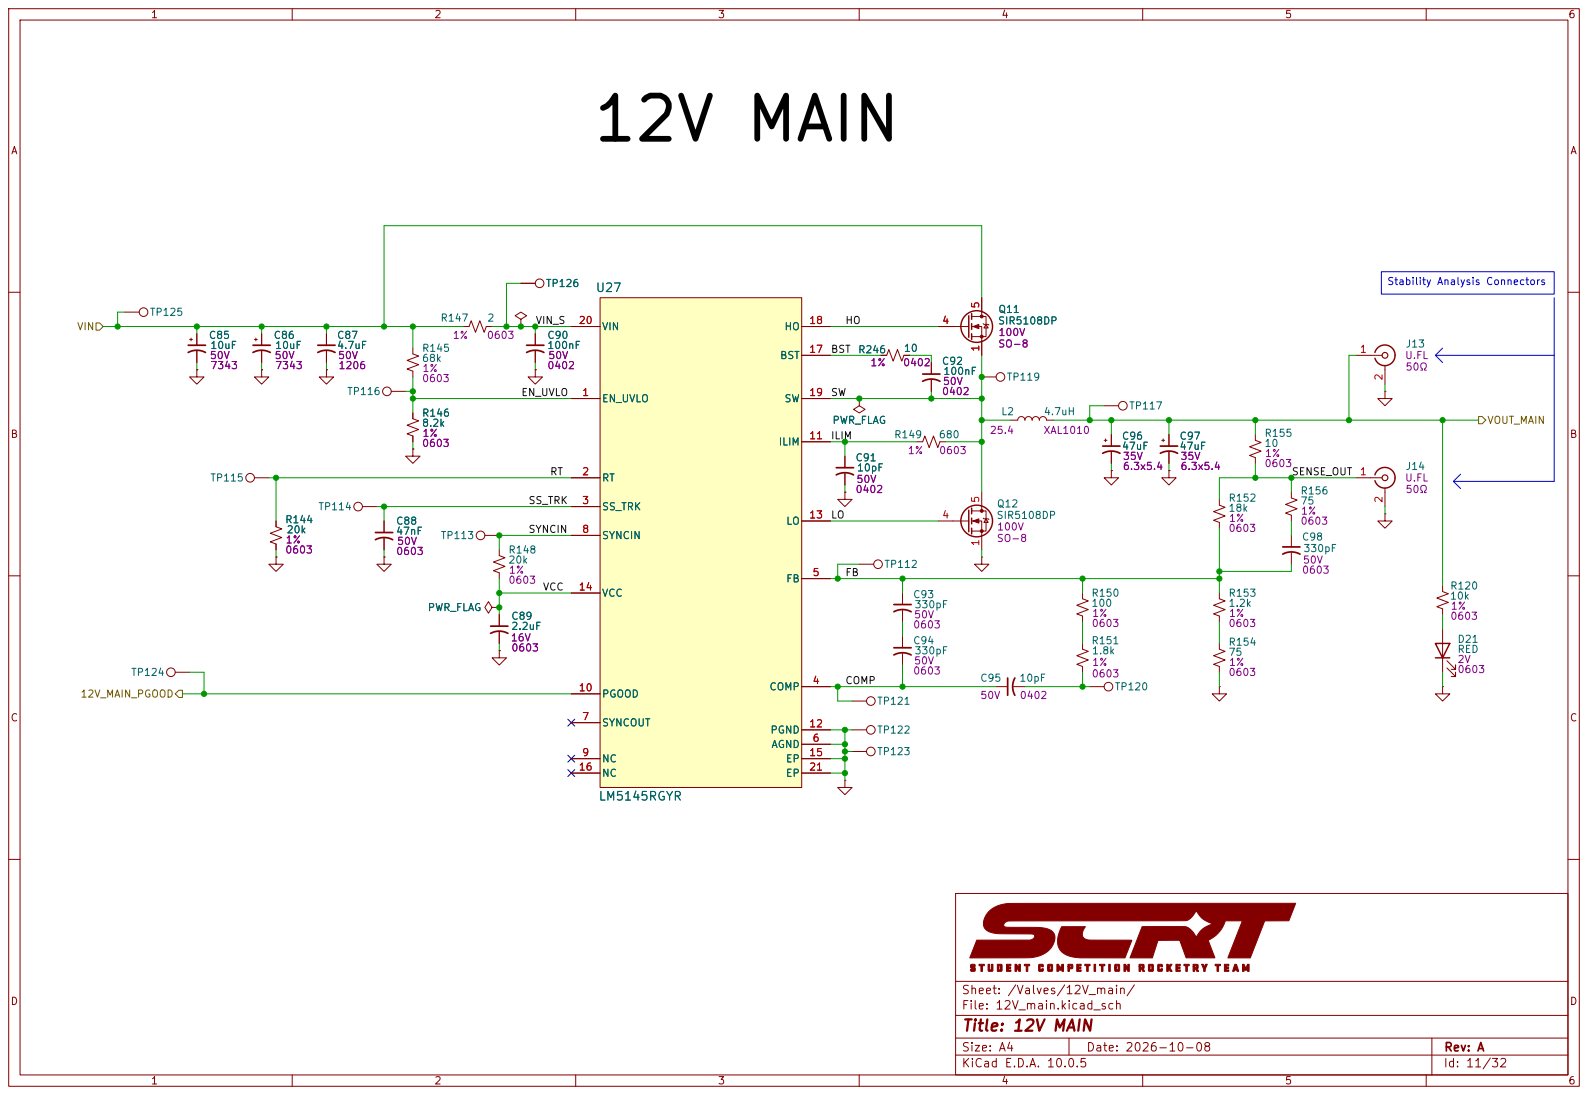
[picture p38: page 11]

Stability Analysis Connectors 12V MAIN

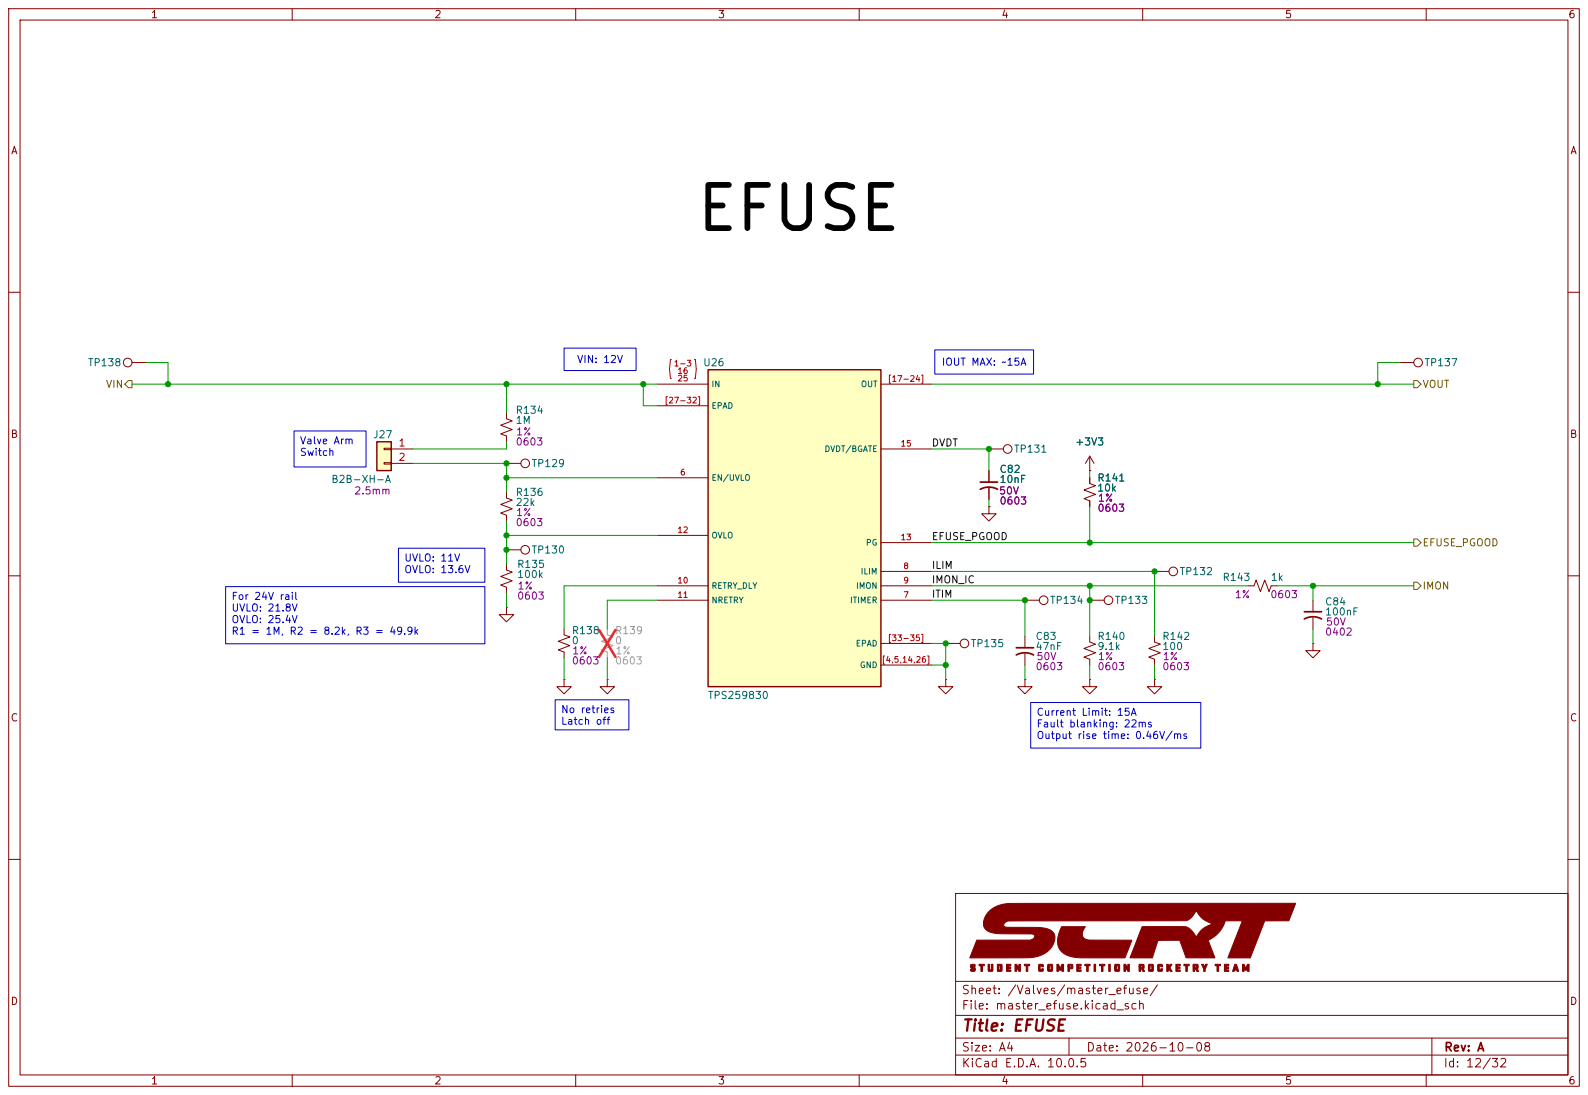
[picture p39: page 12]

Fault blanking: 22ms Output rise time: 0.46V/ms For 24V rail UVLO: 21.8V OVLO: 25.4V R1 = 1M, R2 = 8.2k, R3 = 49.9k UVLO: 11V OVLO: 13.6V

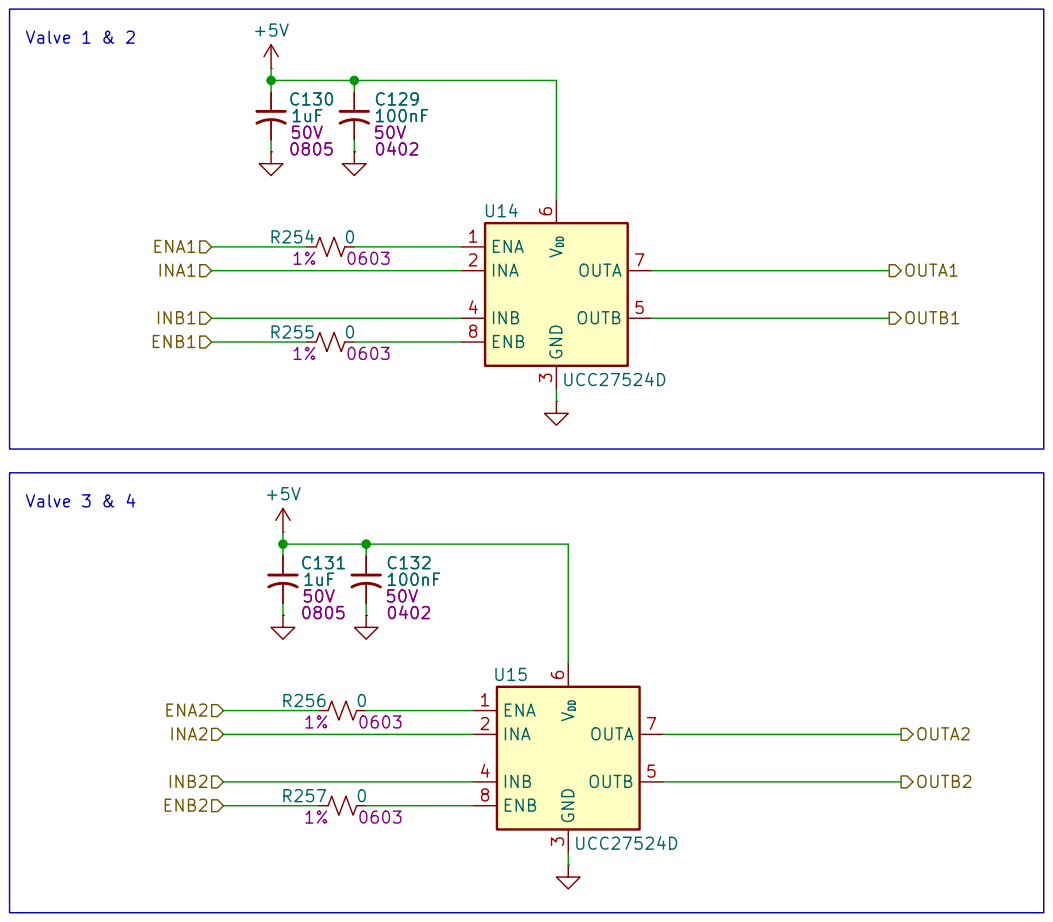
[picture p40: page 13]

Sheet: /Valves/Gate Drivers/
File: gate_driver.kicad_sch
Title: Gate Drivers

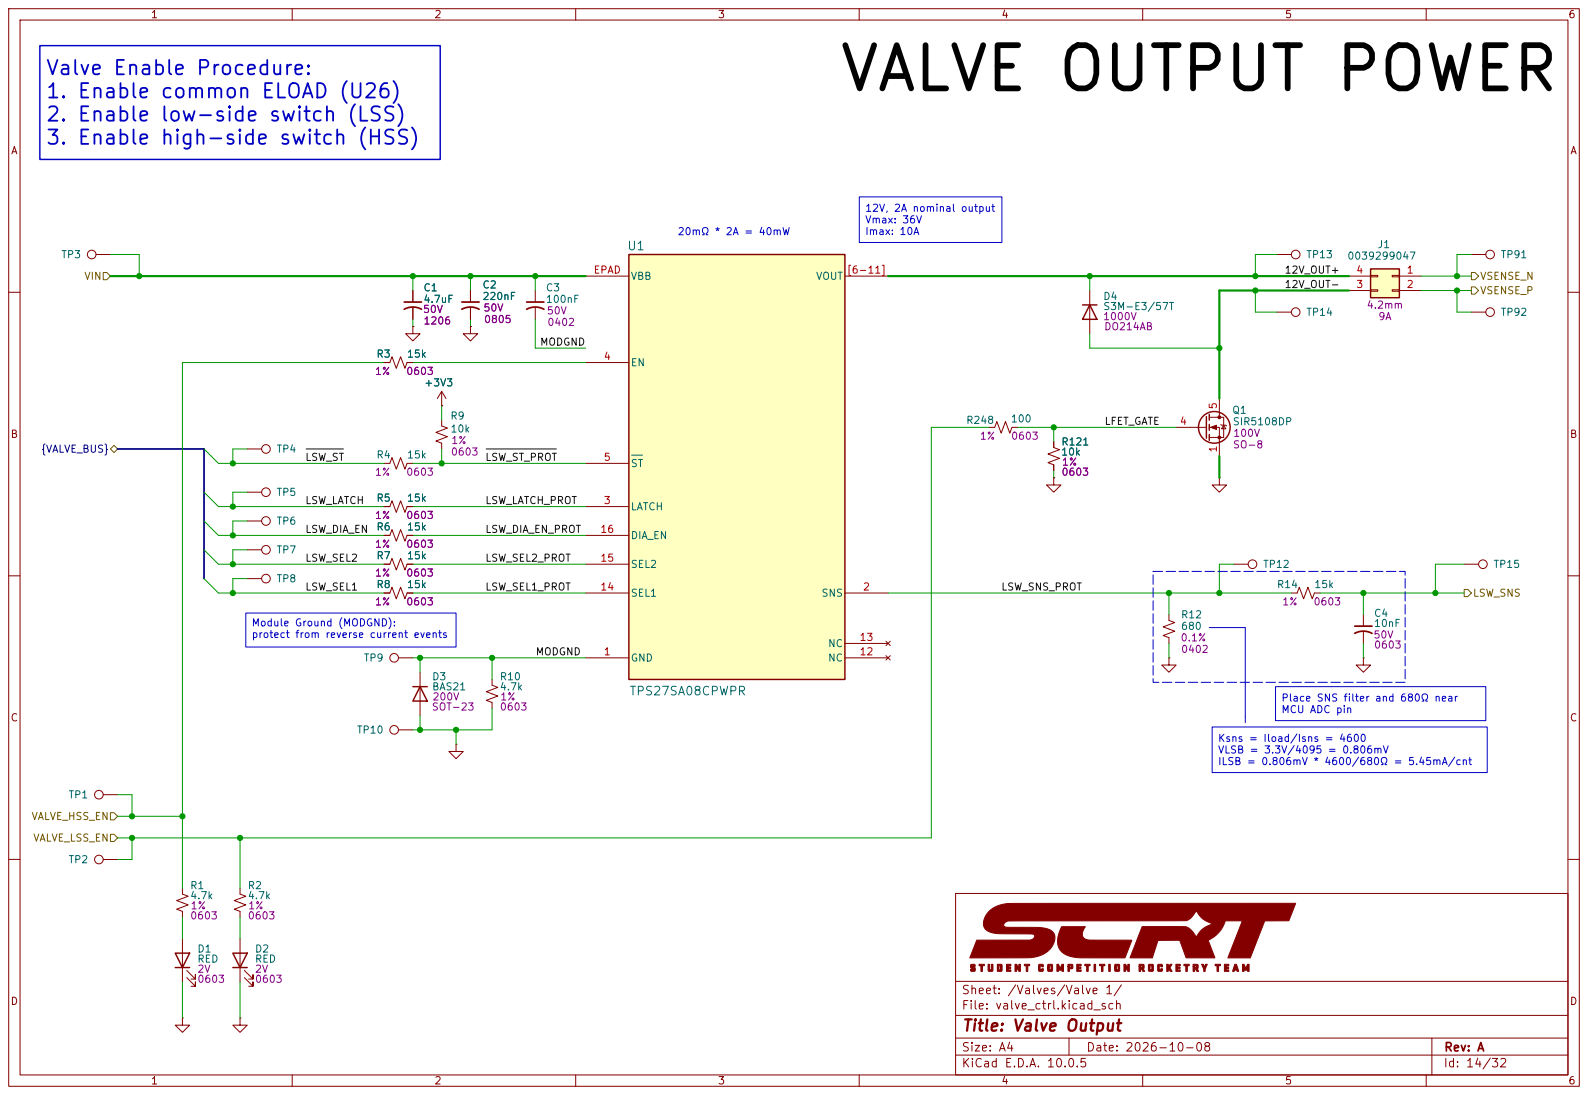
[picture p41: page 14]

Imax: 10A Valve Enable Procedure:
1. Enable common ELOAD (U26)
2. Enable low-side switch (LSS)
3. Enable high-side switch (HSS)

ILSB = 0.806mV * 4600/680Ω = 5.45mA/cnt Module Ground (MODGND):

Place SNS filter and 680Ω near MCU ADC pin

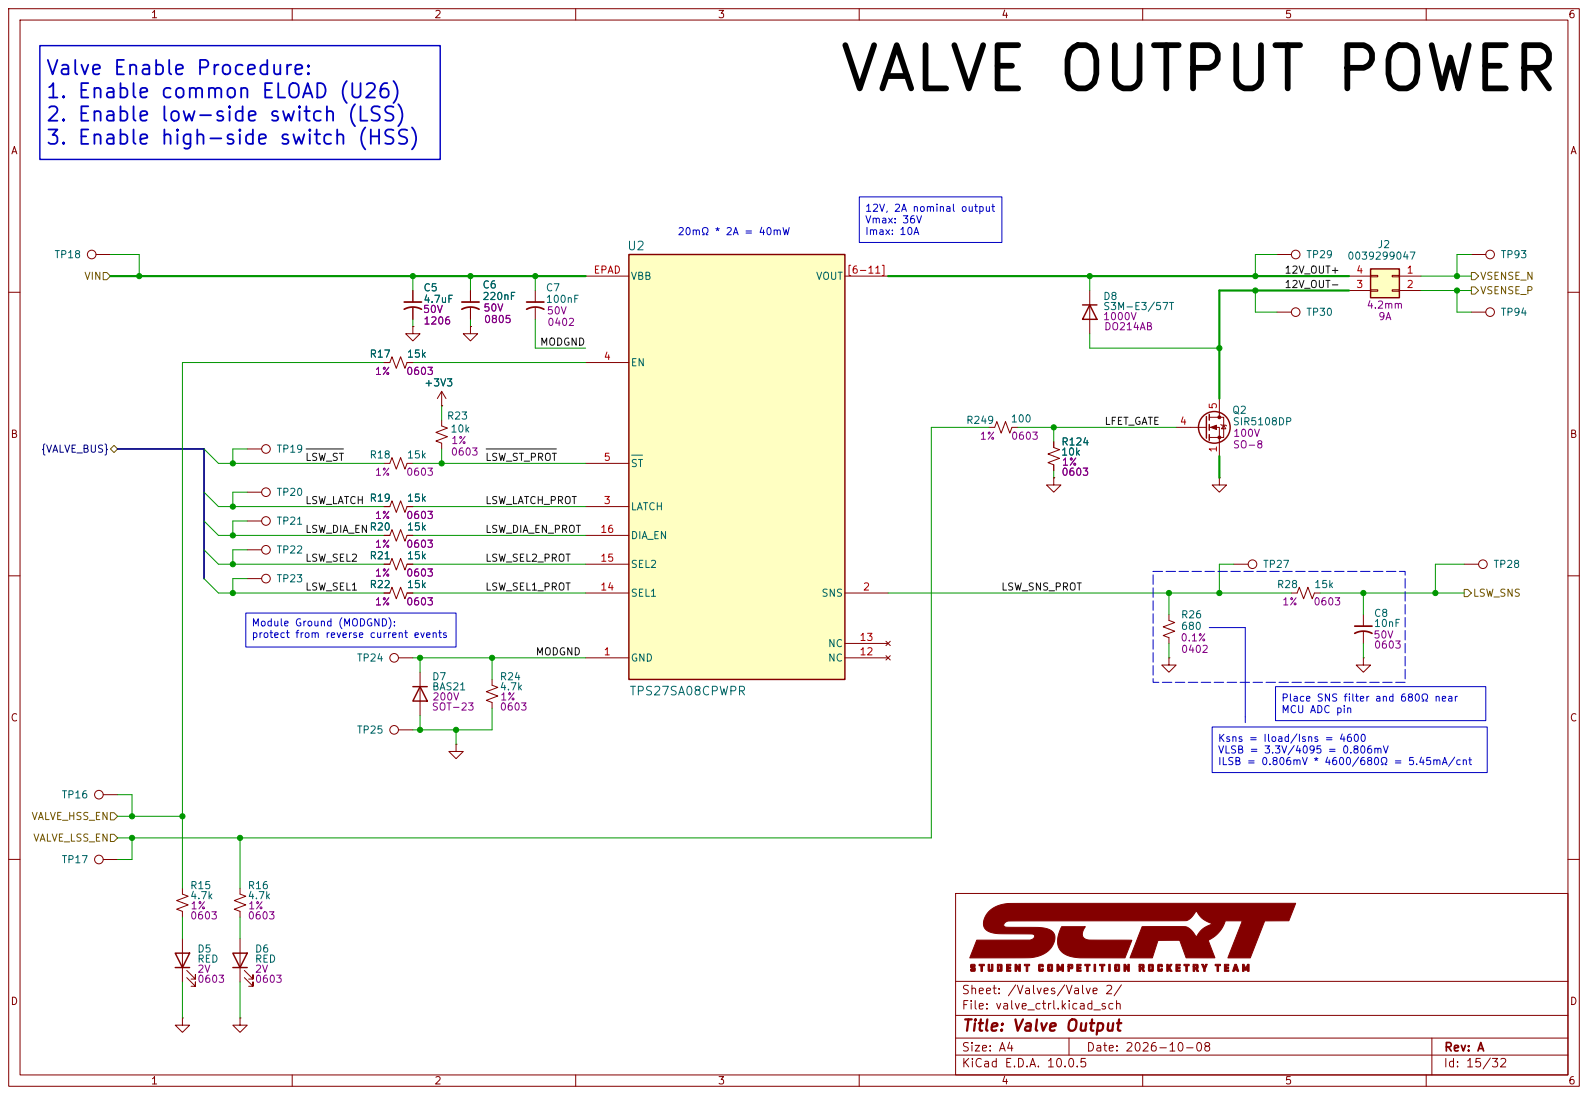
[picture p42: page 15]
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

ILSB = 0.806mV * 4600/680Ω = 5.45mA/cnt Module Ground (MODGND):

Place SNS filter and 680Ω near MCU ADC pin

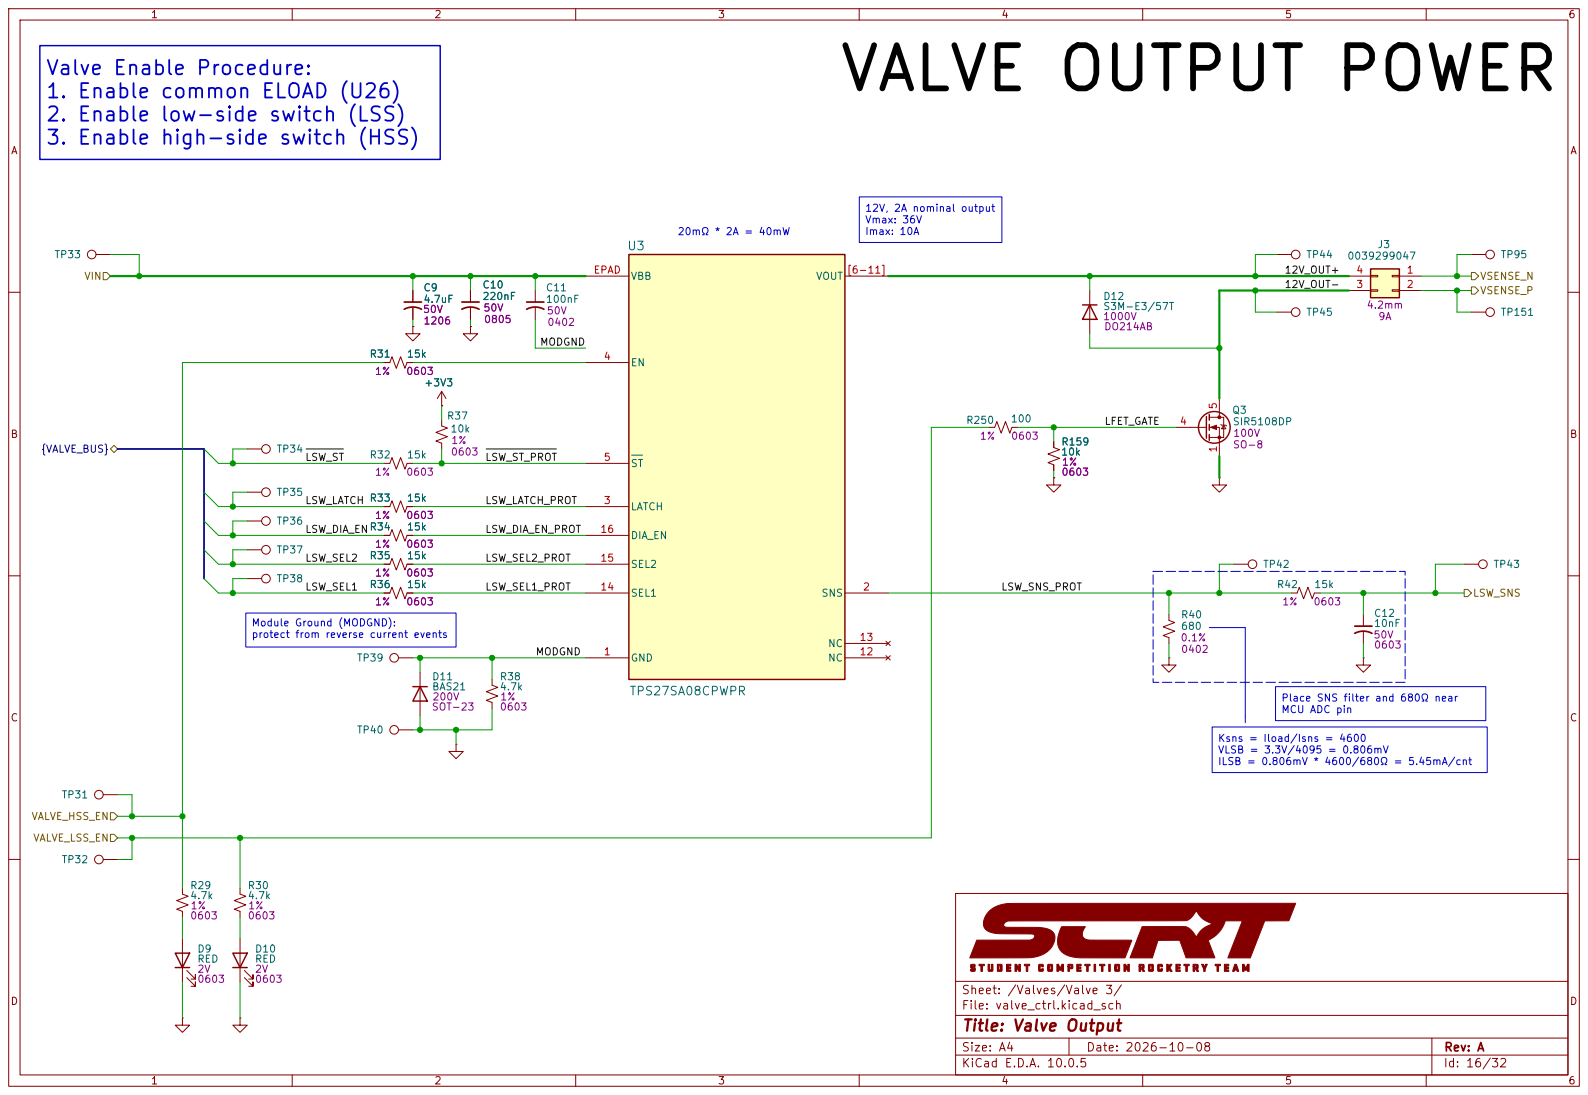
[picture p43: page 16]
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

ILSB = 0.806mV * 4600/680Ω = 5.45mA/cnt Module Ground (MODGND):

Place SNS filter and 680Ω near MCU ADC pin

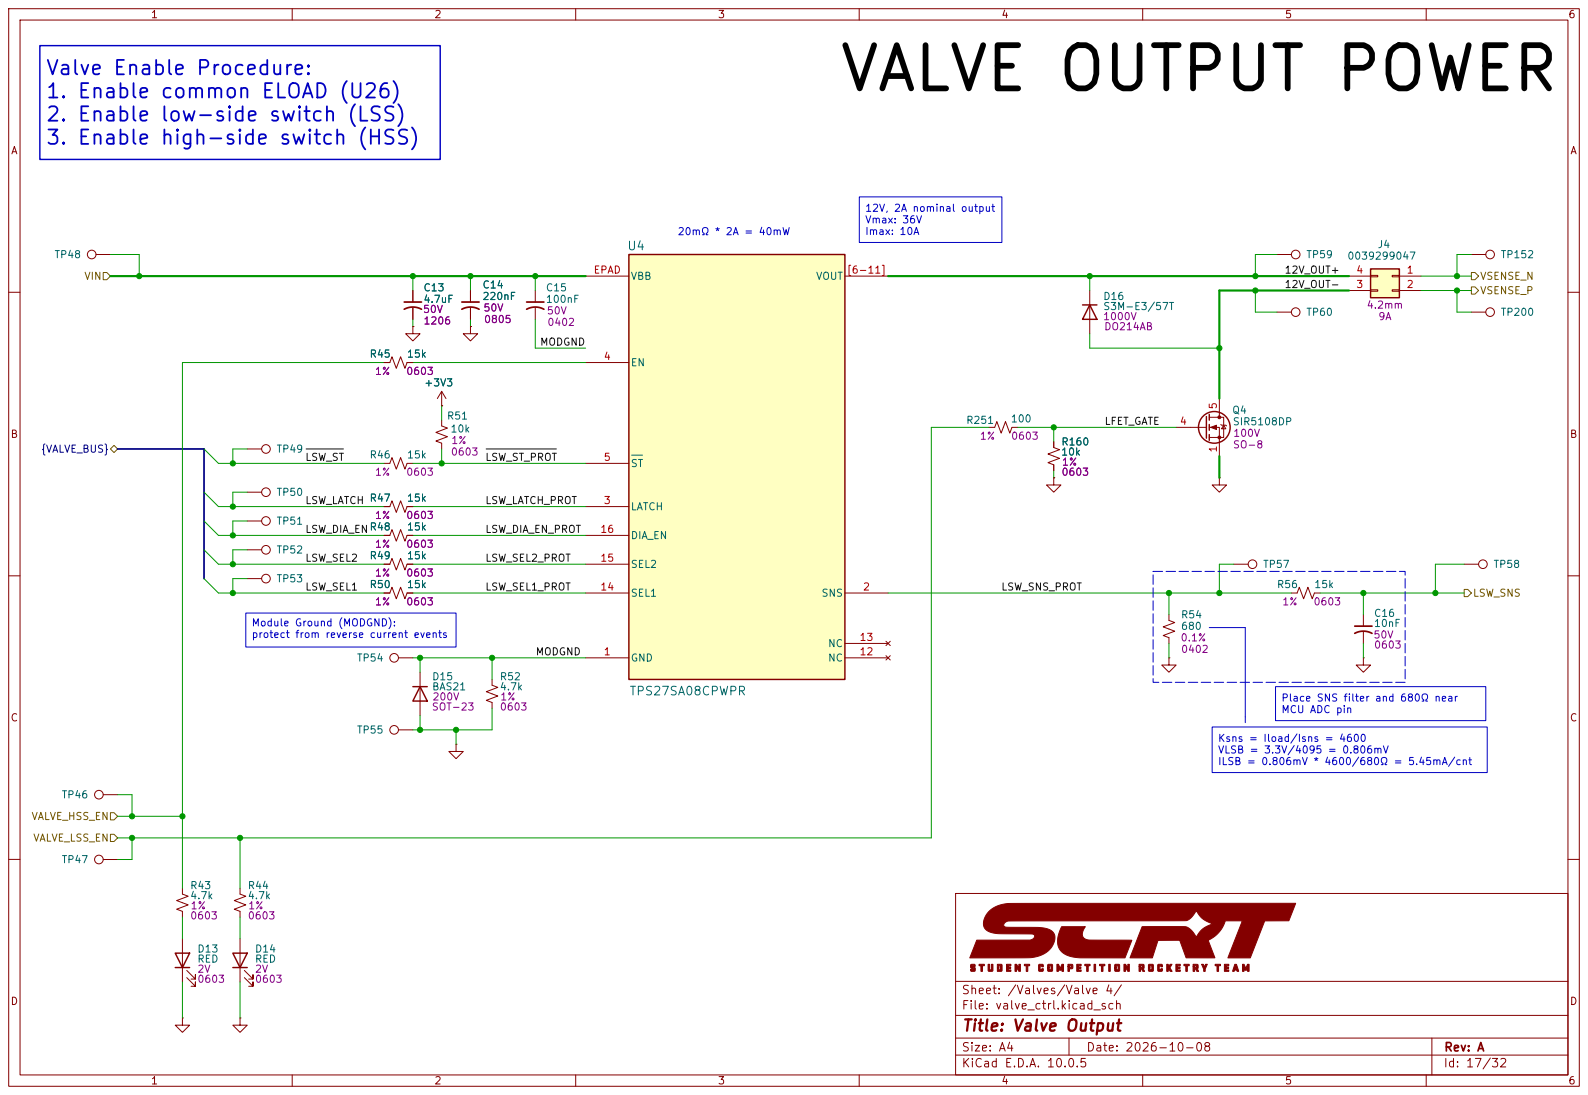
[picture p44: page 17]
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

ILSB = 0.806mV * 4600/680Ω = 5.45mA/cnt Module Ground (MODGND):

Place SNS filter and 680Ω near MCU ADC pin

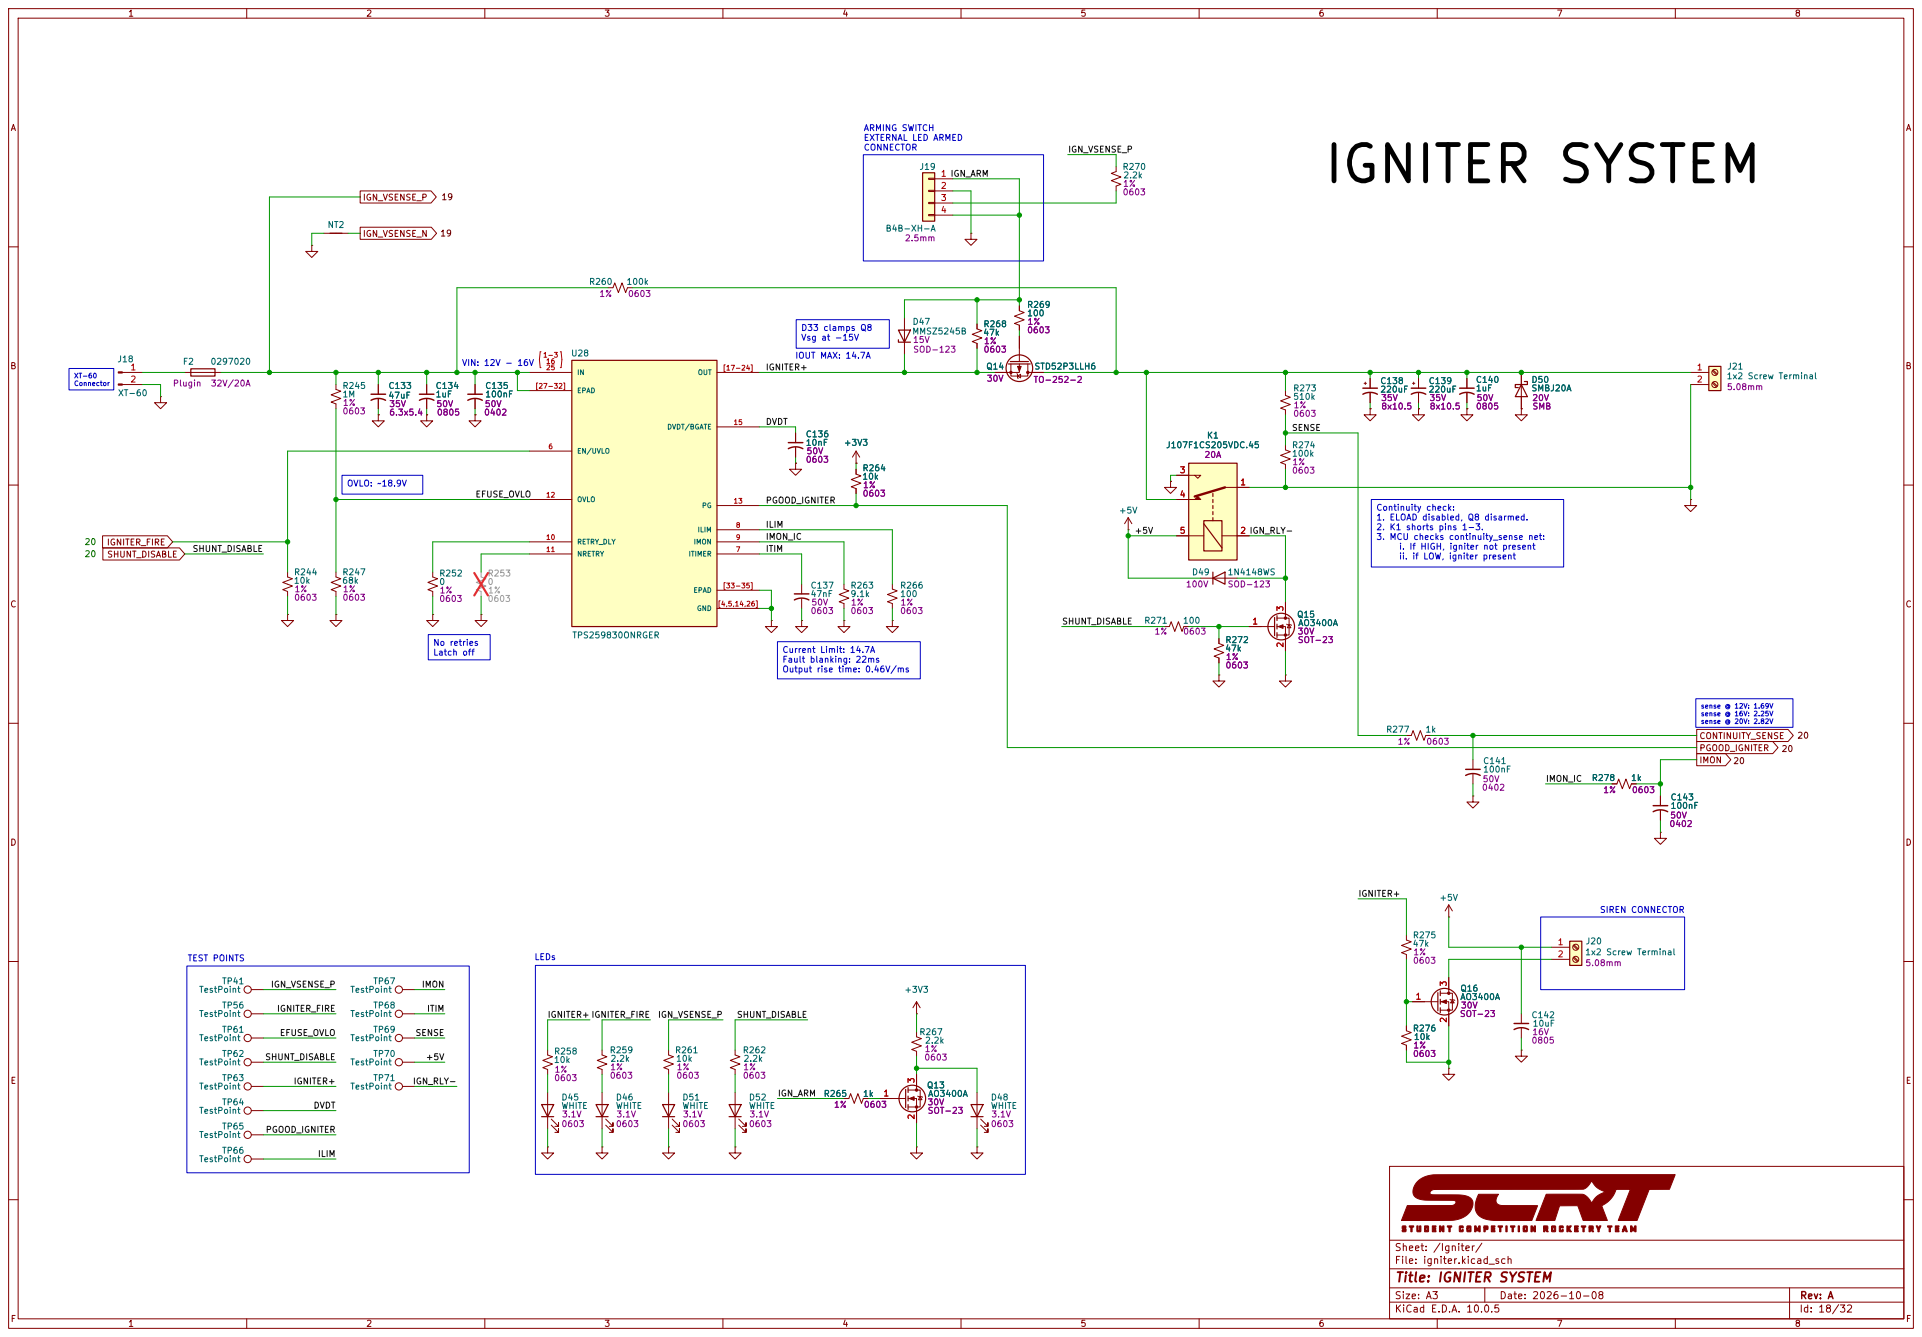
[picture p45: page 18]

i. If HIGH, igniter not present

Fault blanking: 22ms Output rise time: 0.46V/ms

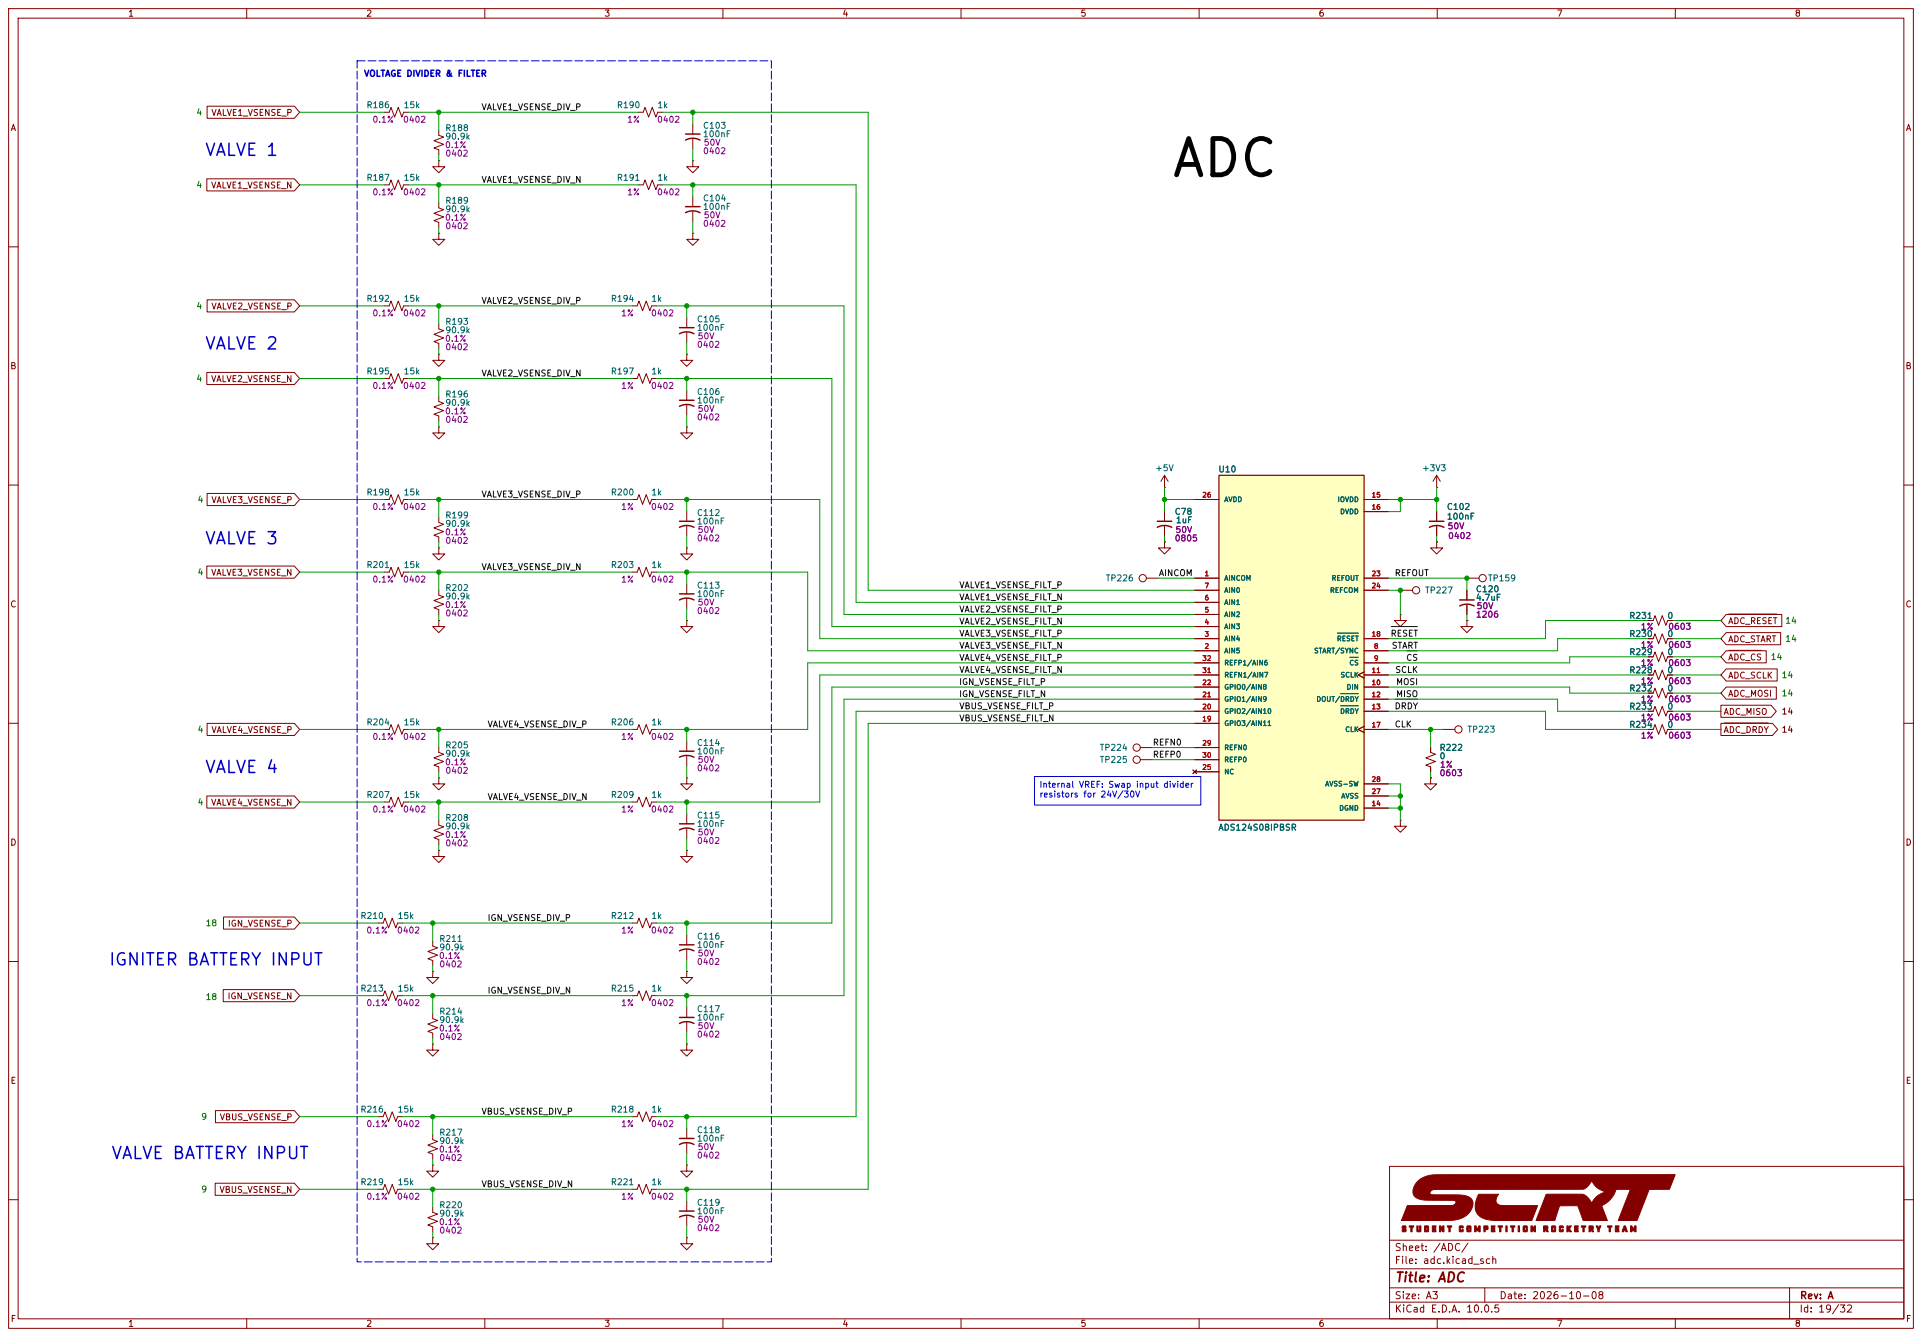
[picture p46: page 19]

RESET
START DRDY SCLK MISO MOSI CS

Internal VREF: Swap input divider
resistors for 24V/30V

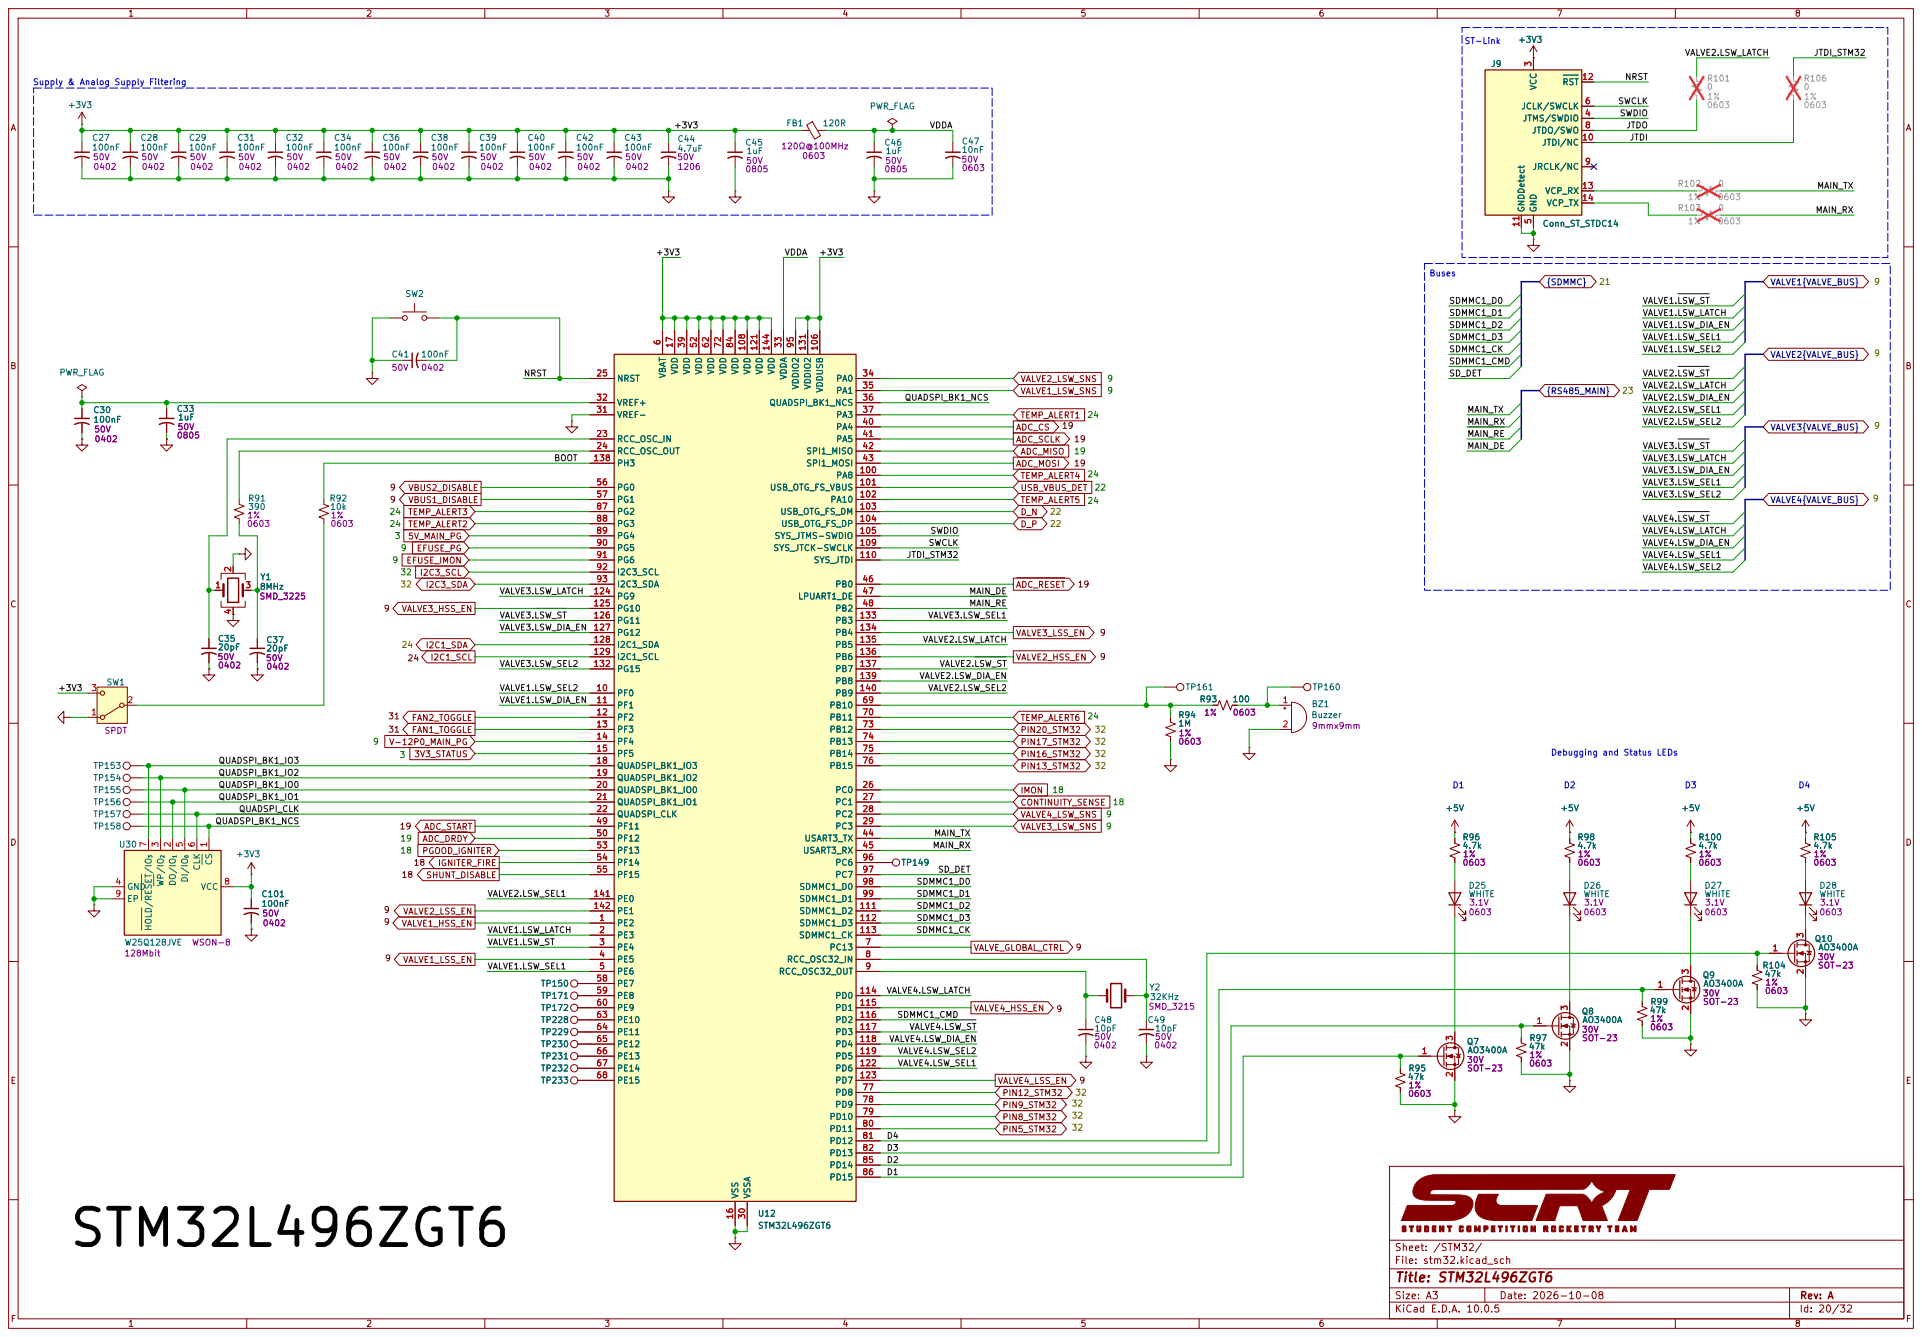
[picture p47: page 20]

1 DO/IO1 2 WP/IO2 3 GND 4 DI/IO0 5 CLK

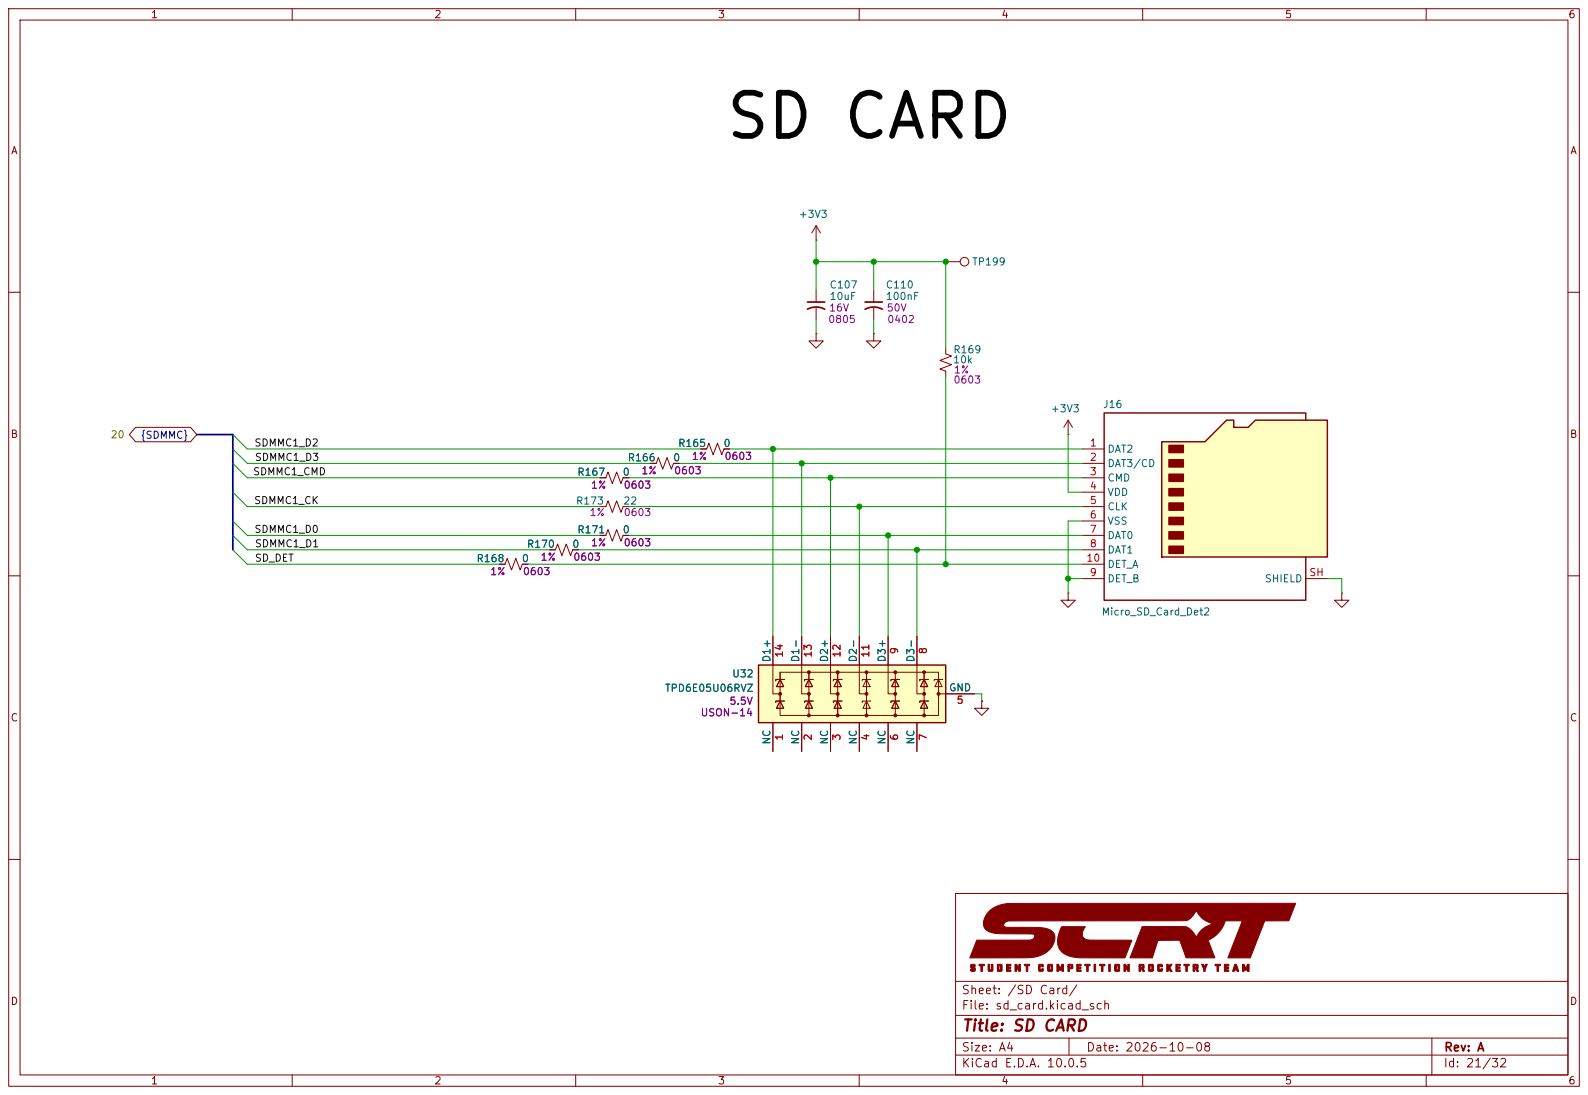
[picture p48: page 21]

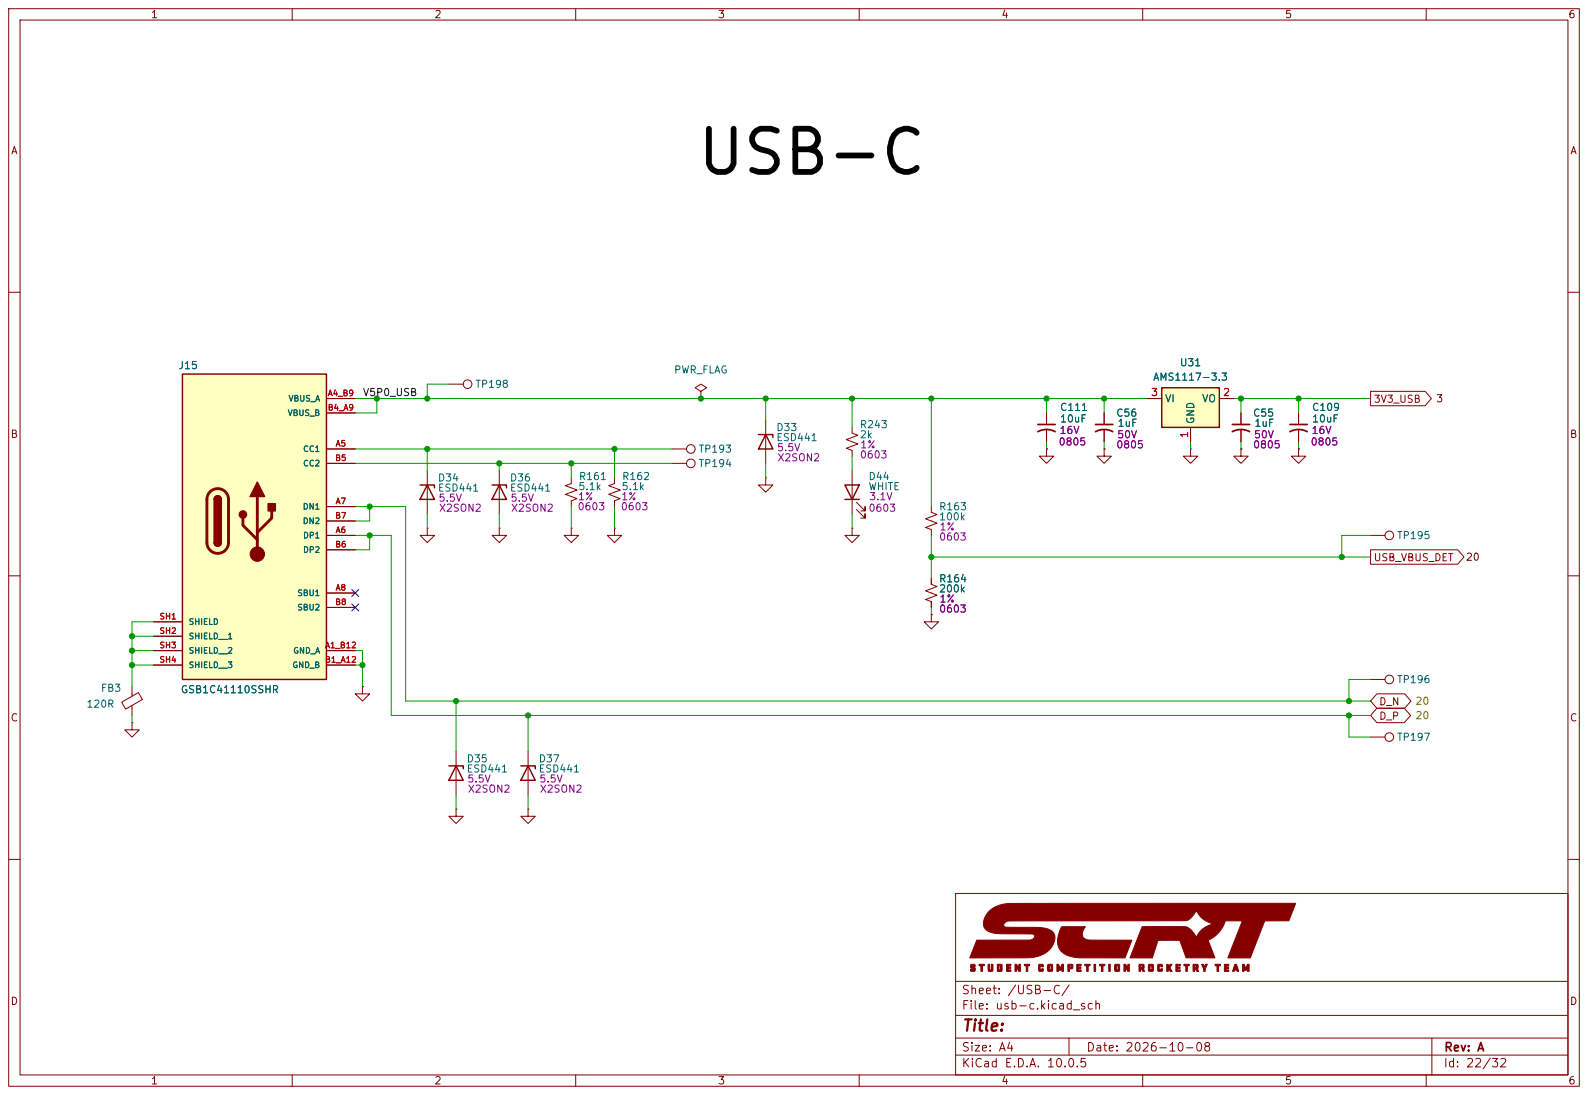
[picture p49: page 22]

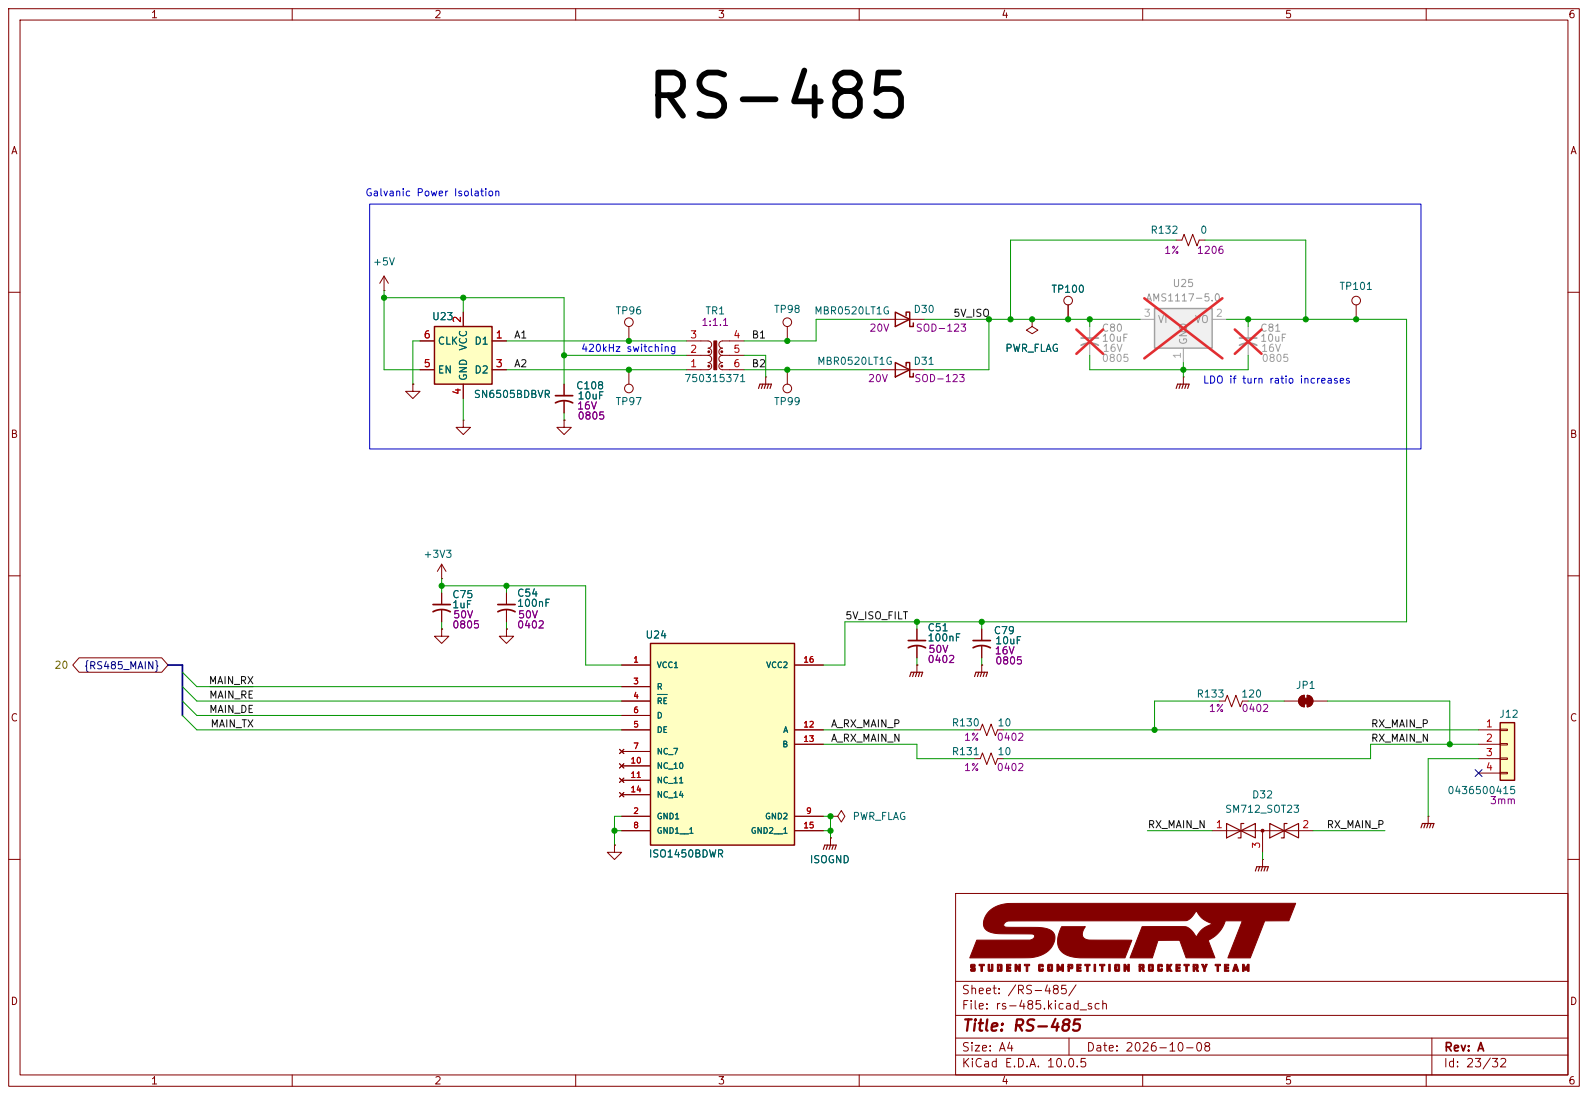
[picture p50: page 23]

LDO if turn ratio increases C108

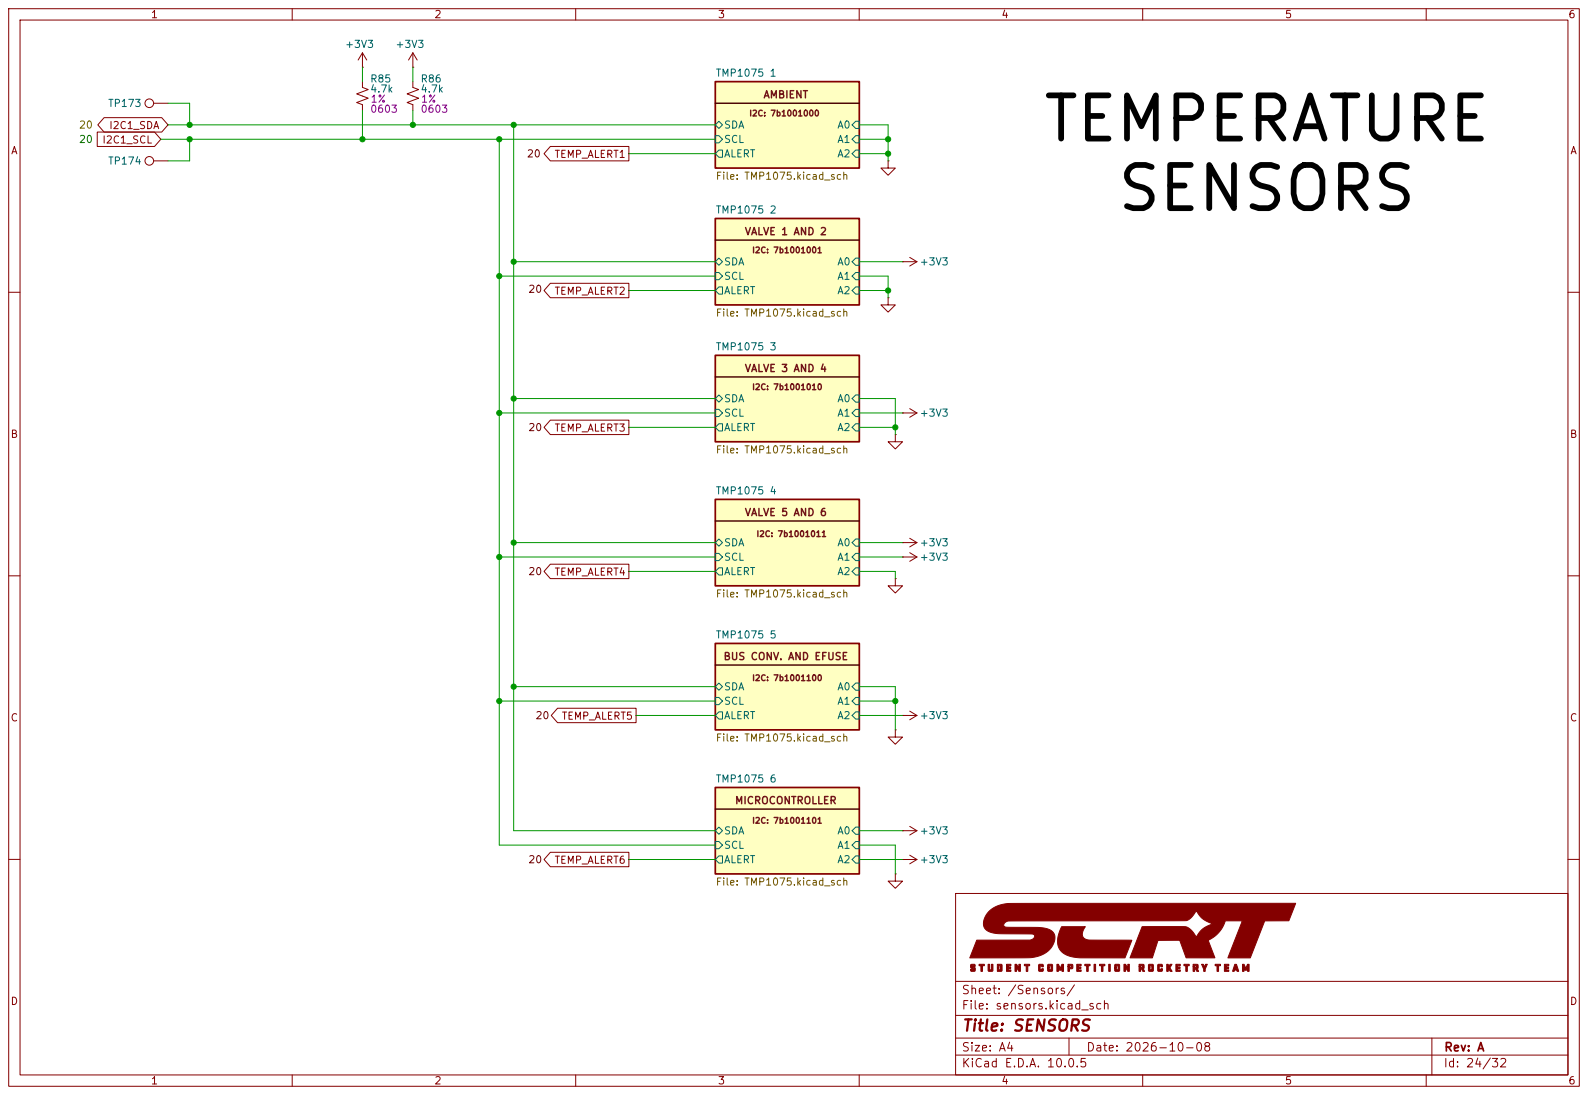
[picture p51: page 24]

BUS CONV. AND EFUSE 20
TEMP_ALERT3

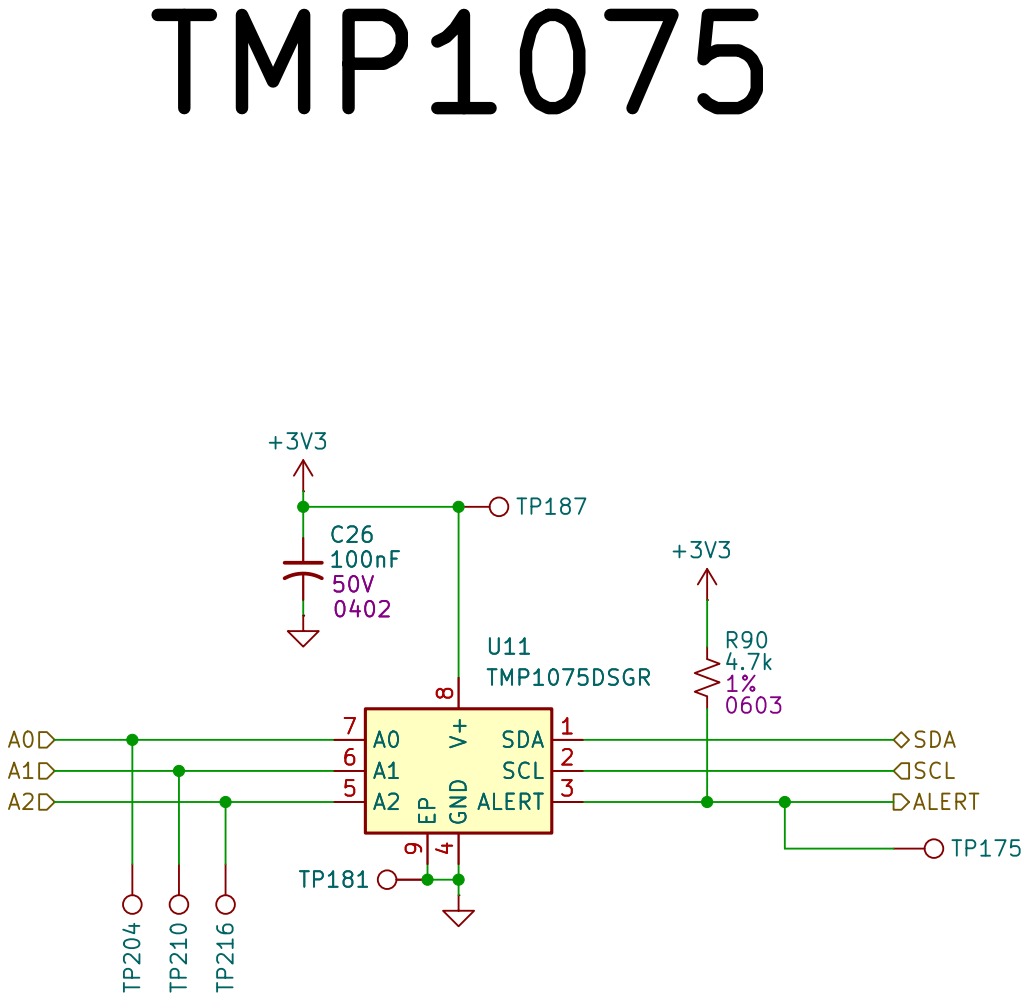
[picture p52: page 25]

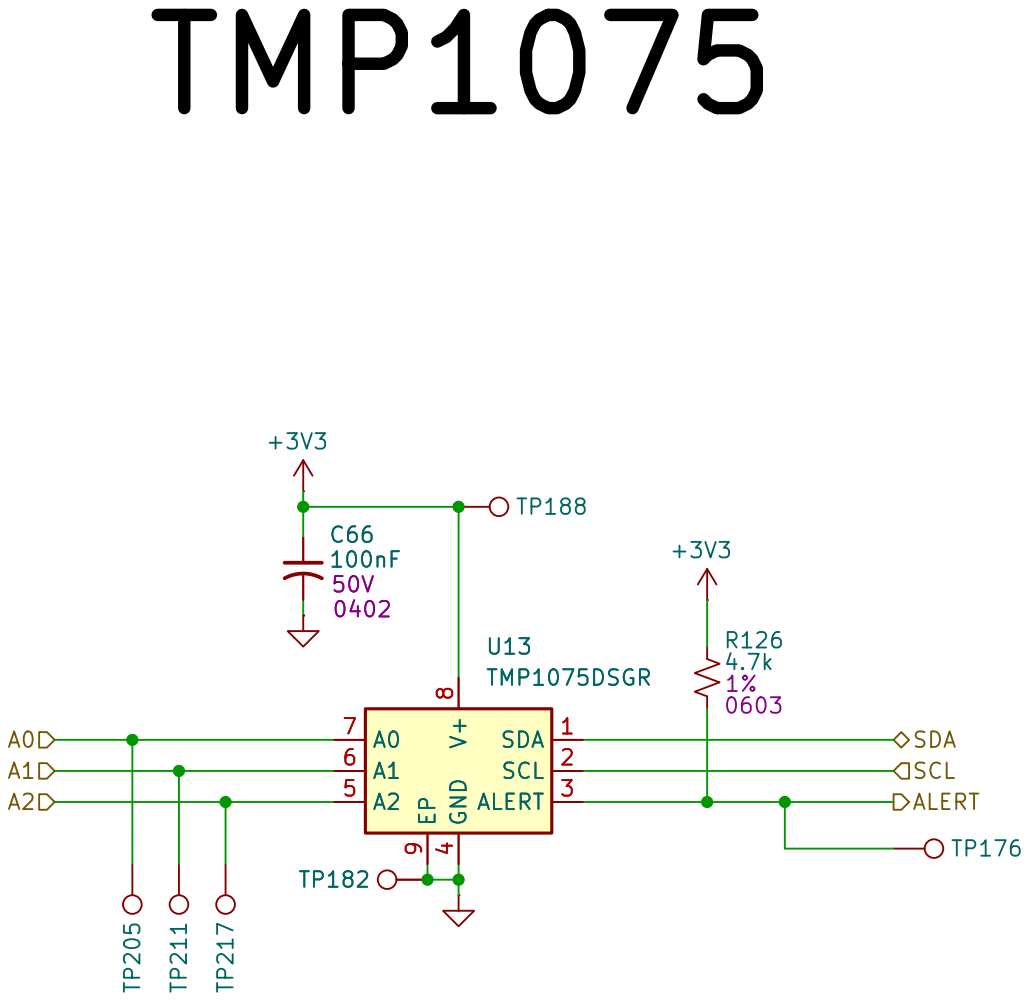
[picture p53: page 26]

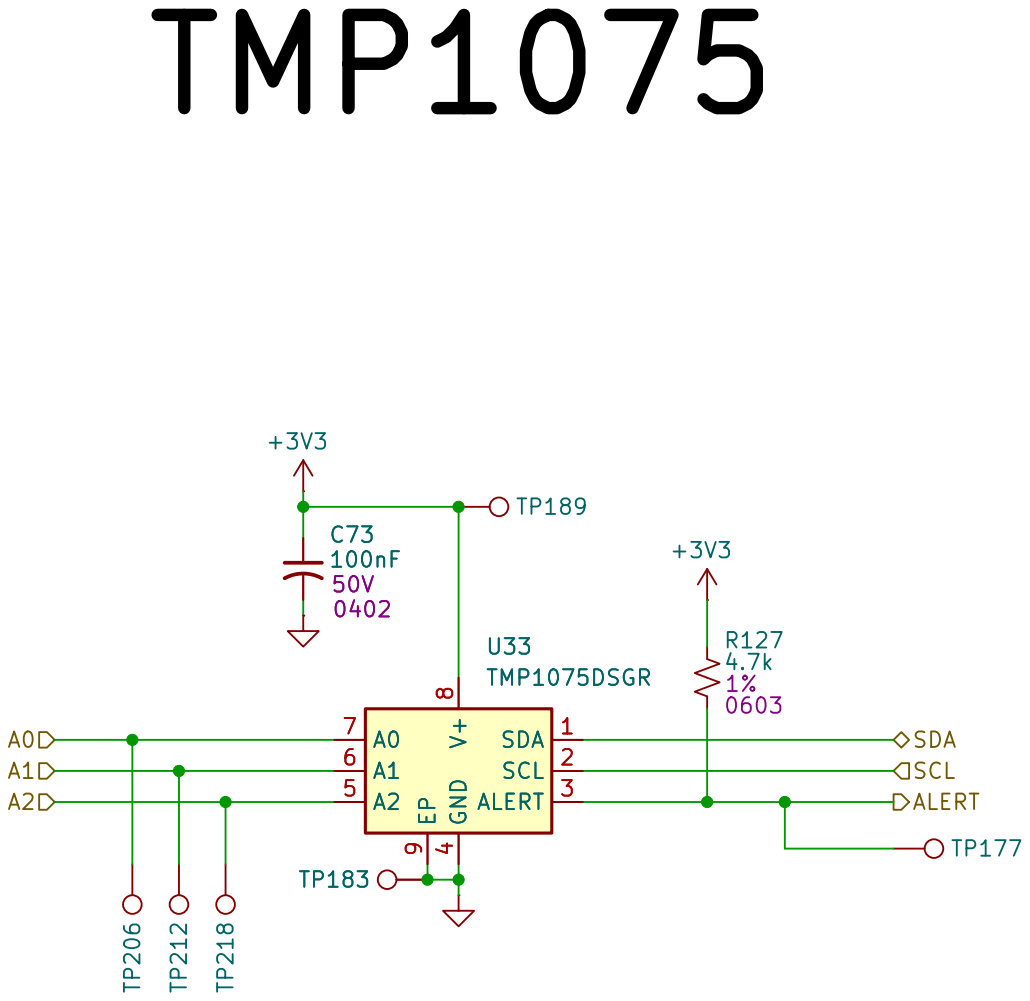
[picture p54: page 27]

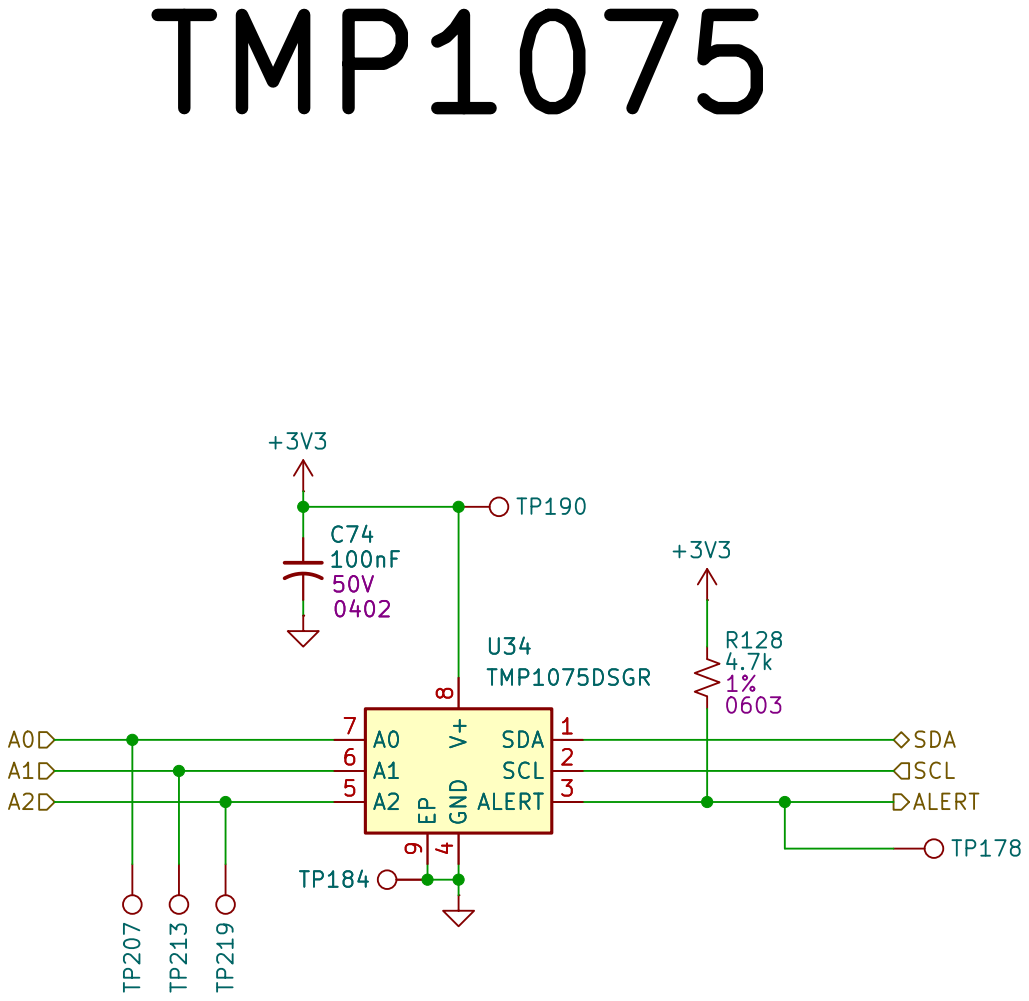
[picture p55: page 28]

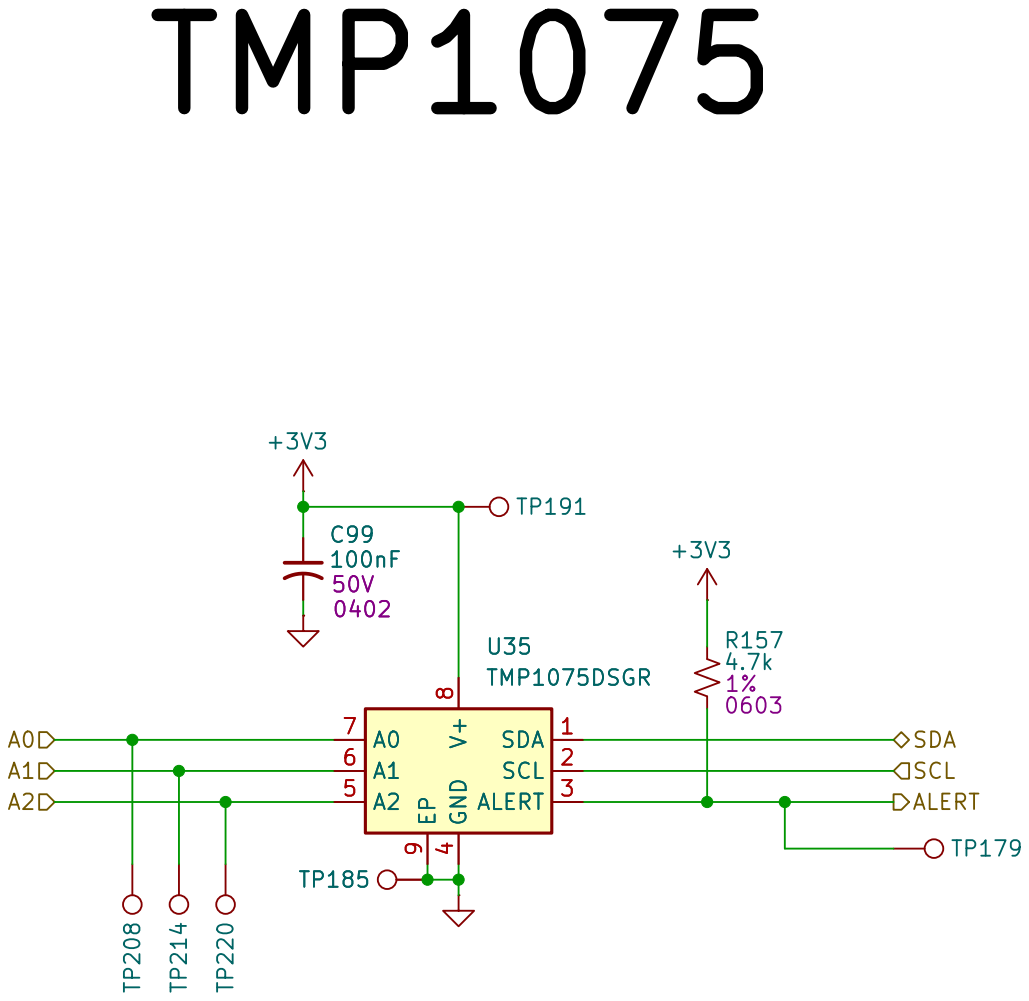
[picture p56: page 29]

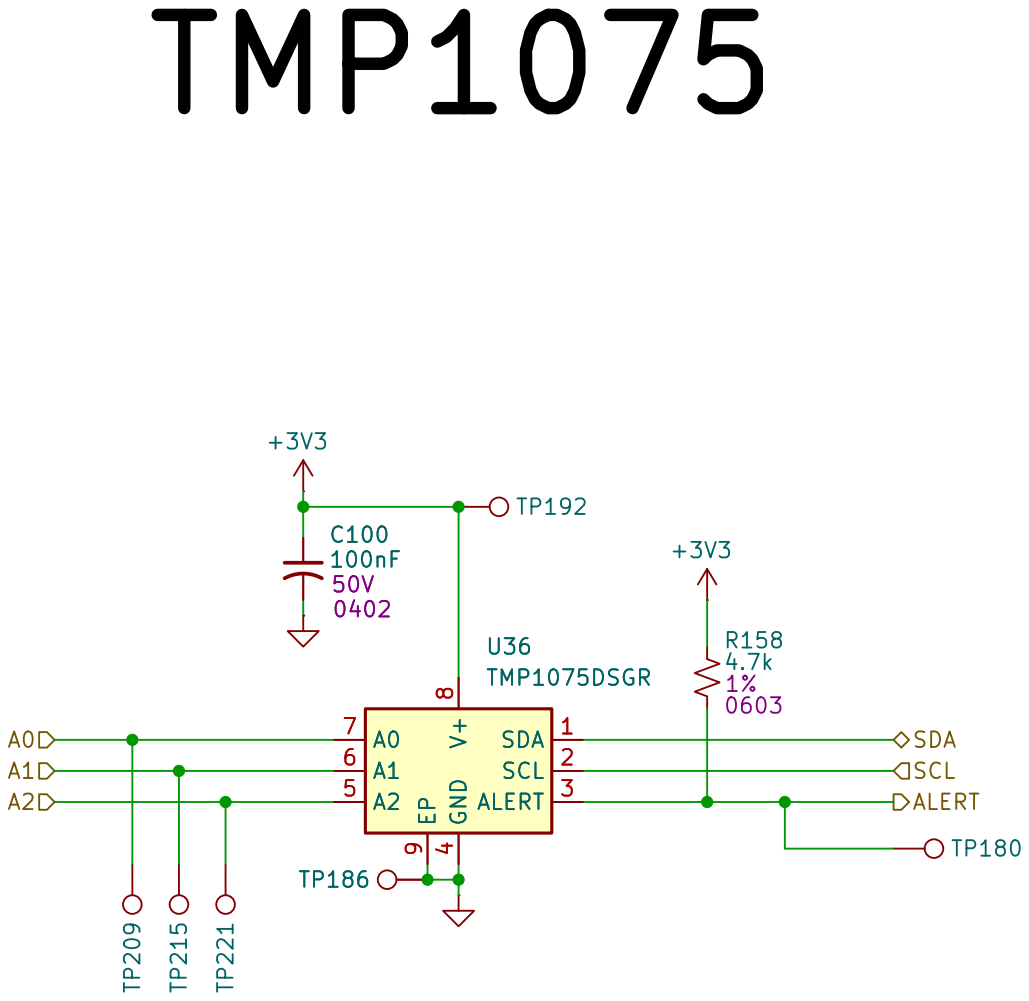
[picture p57: page 30]

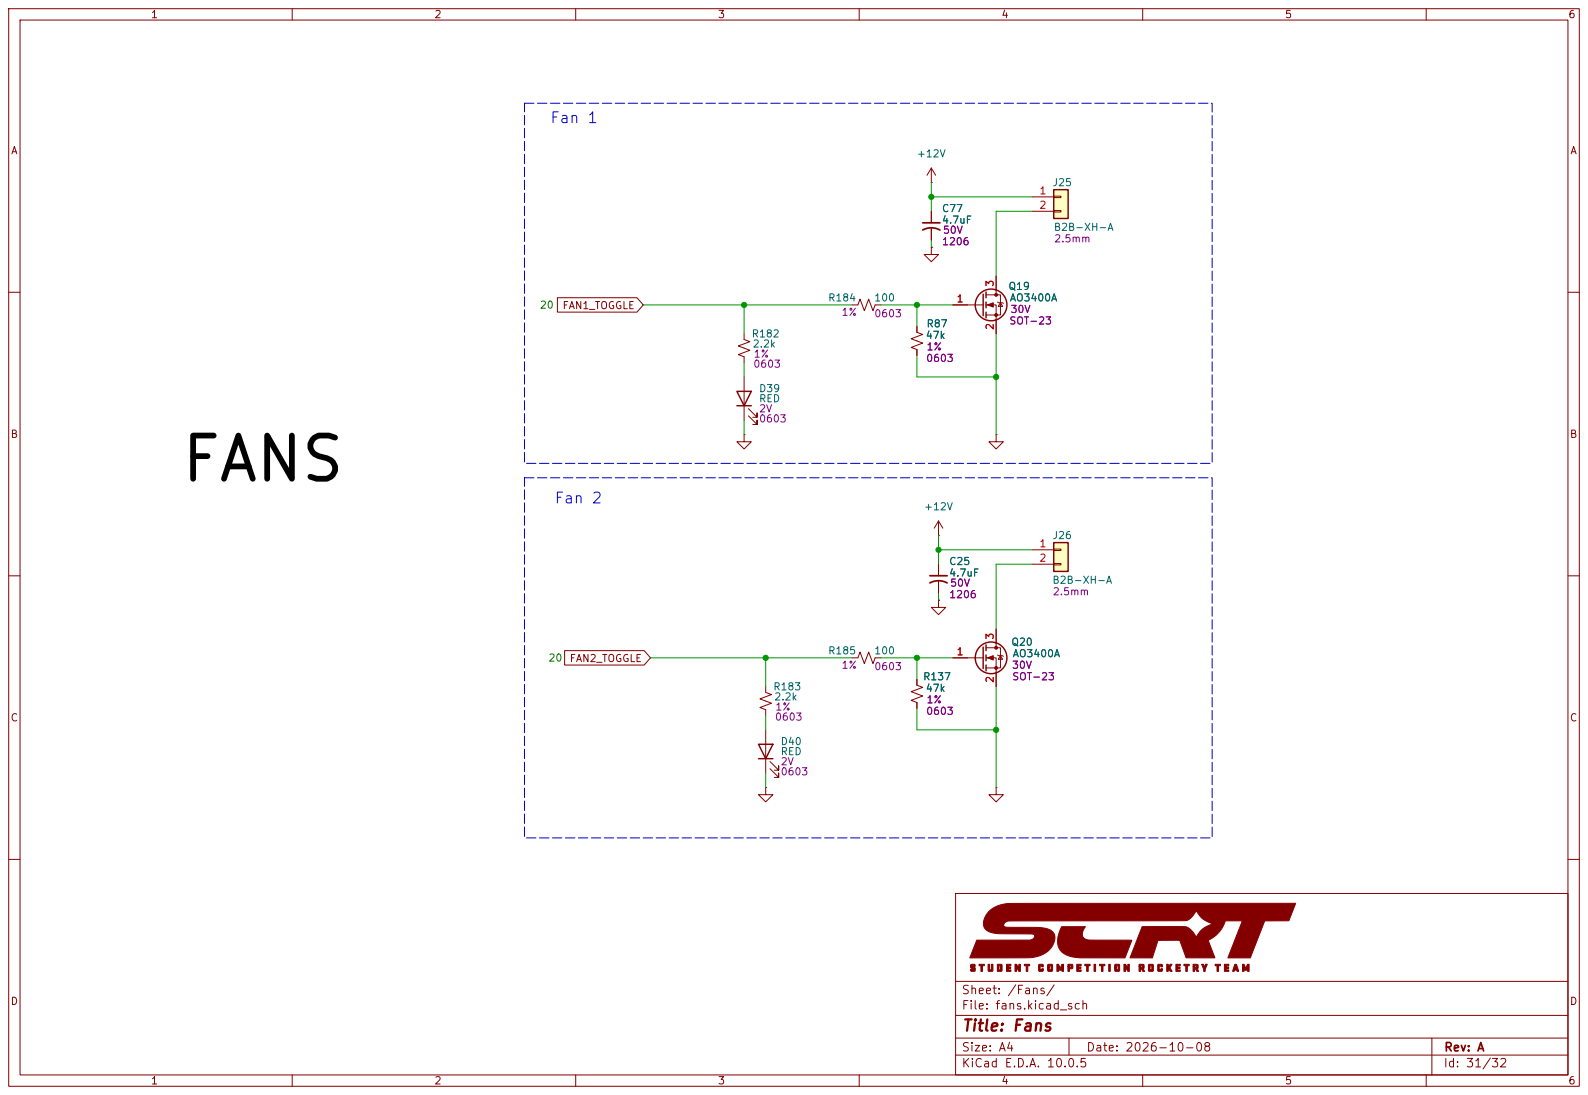
[picture p58: page 31]

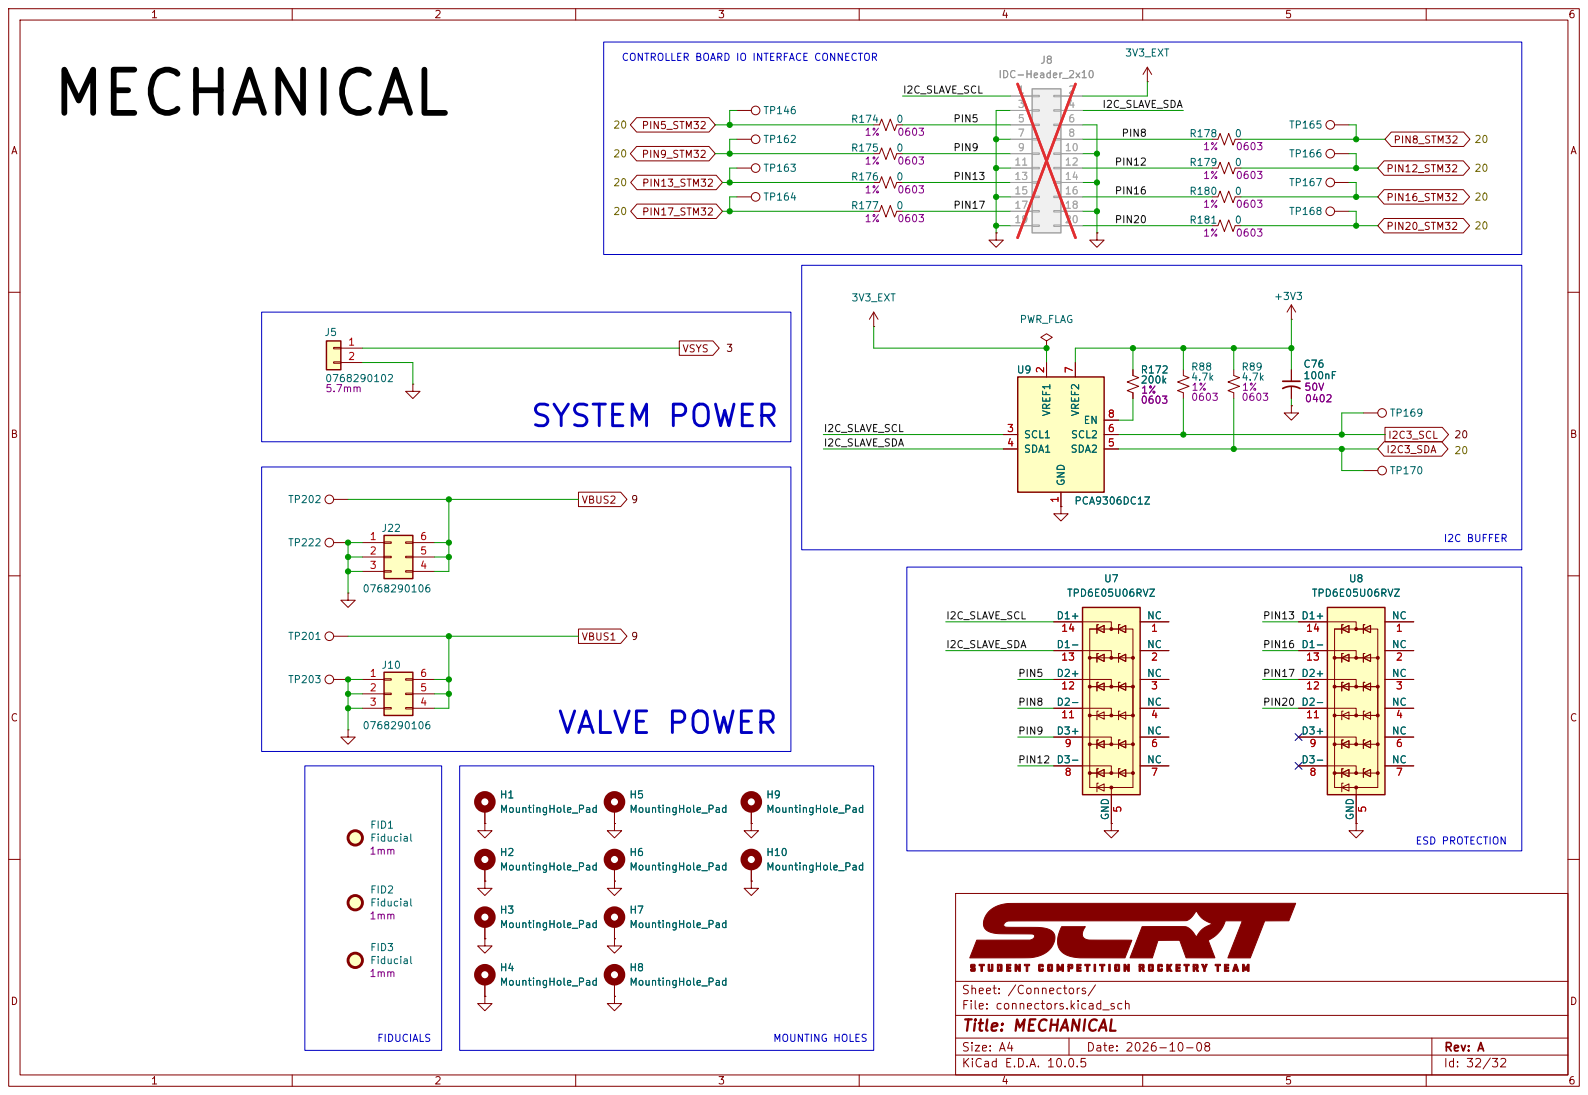
[picture p59: page 32]

CONTROLLER BOARD IO INTERFACE CONNECTOR
TP164 H9MountingHole_Pad
