Ground-Support-Equipment-SCRT/Pad-Side-Systems/LRUs/Pad Control Unit/Electrical/Main Controller Board/KICAD PROJECT/master_gse_pcb_project/Schematic.pdf

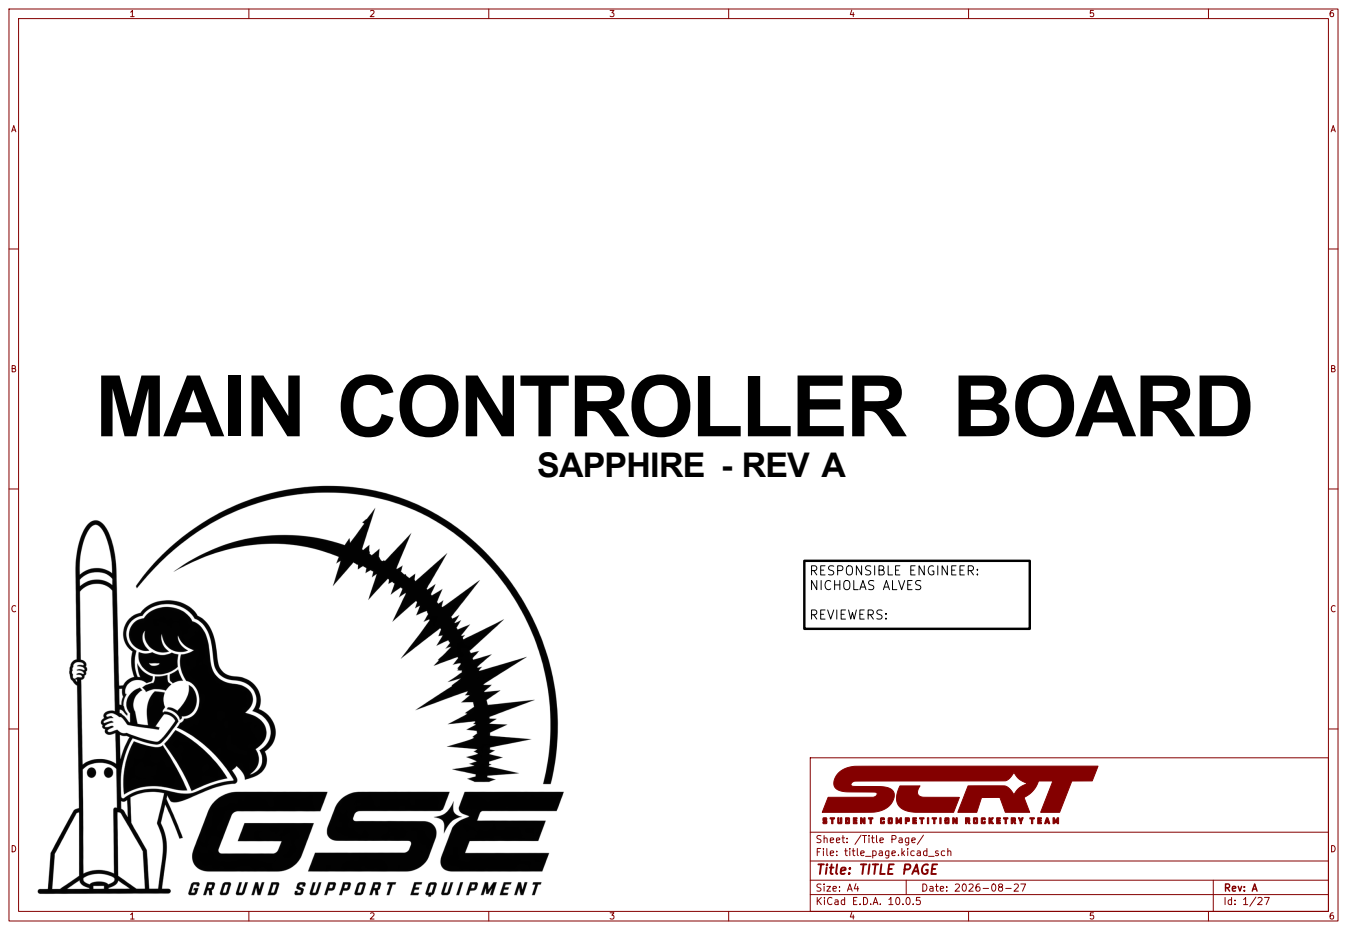
[picture p60: page 1]

Size: A4 | Rev: A
KiCad E.D.A. 10.0.5 | Id: 1/27

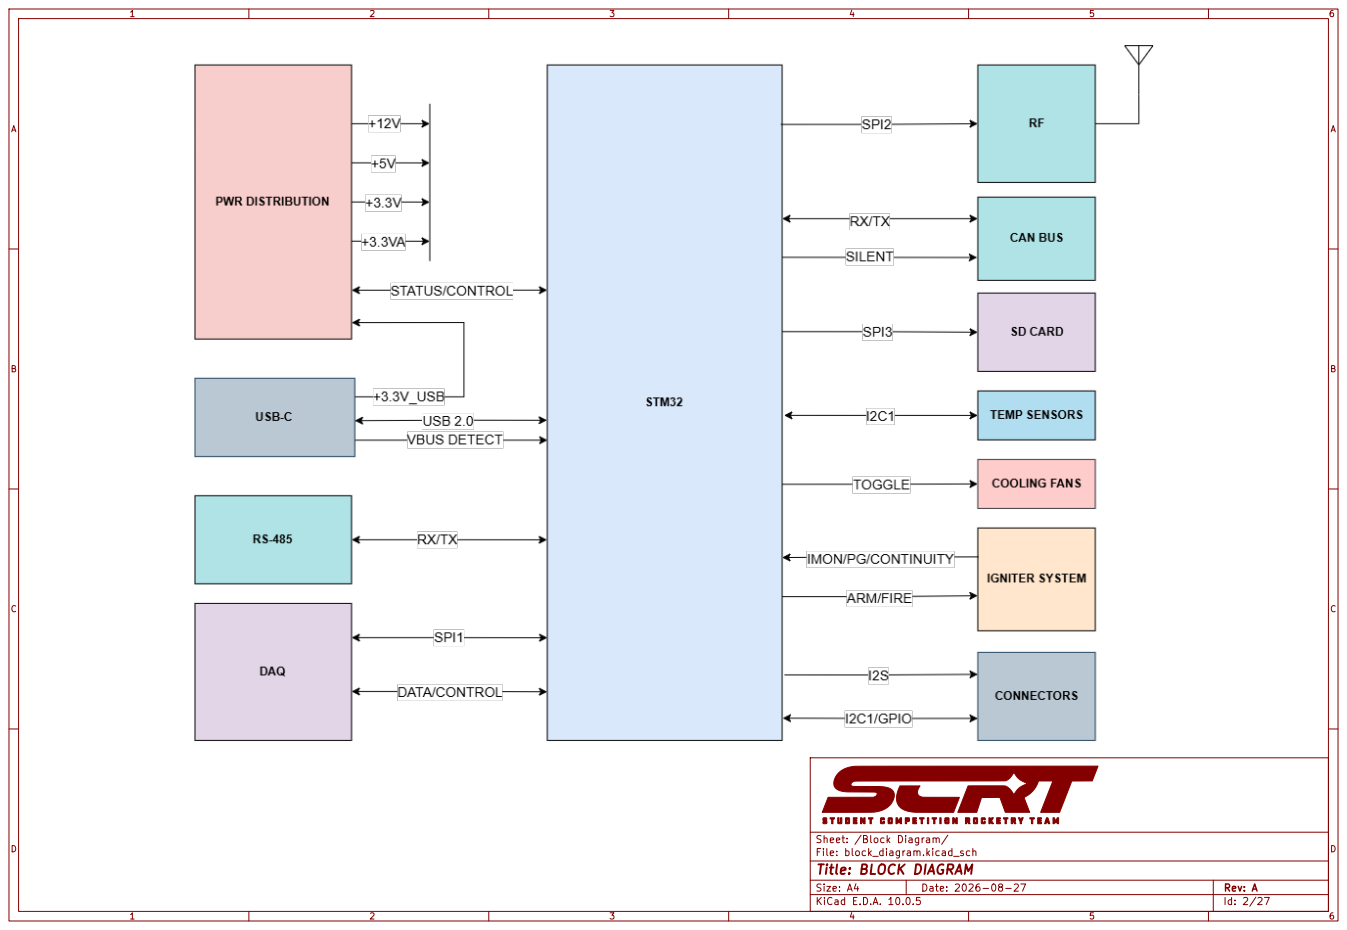
[picture p61: page 2]

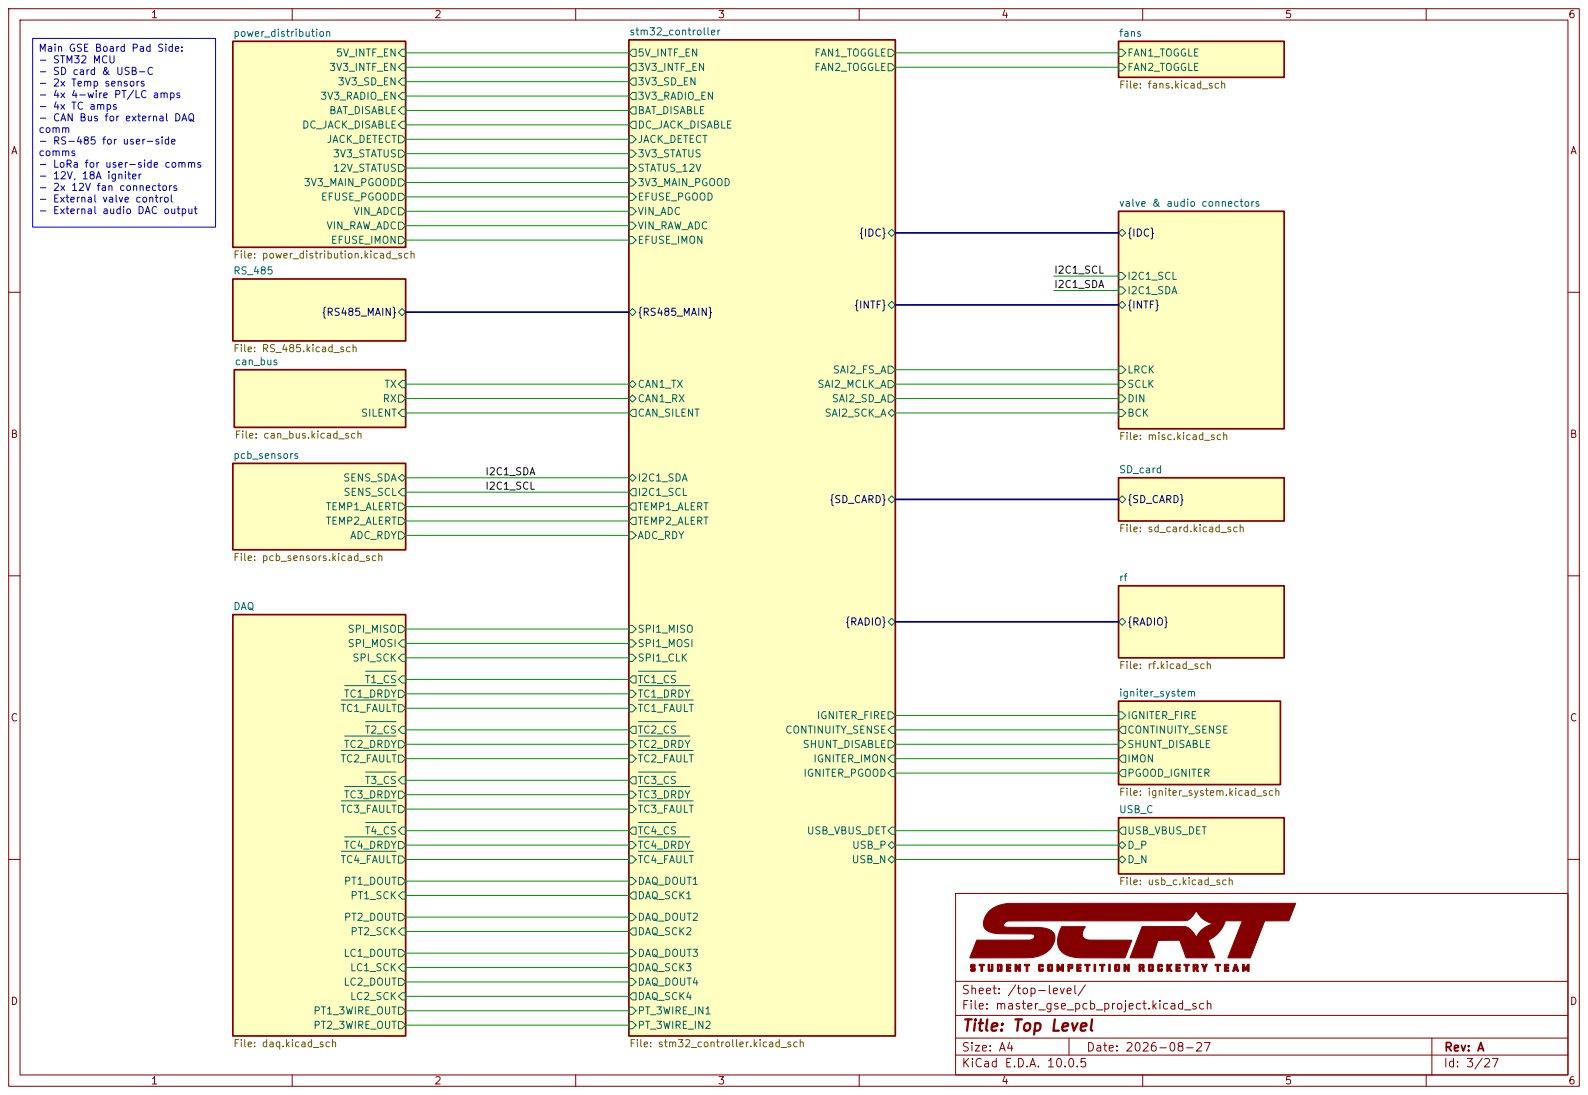
[picture p62: page 3]

I2C1_SCL Main GSE Board Pad Side: - STM32 MCU - SD card & USB-C - 2x Temp sensors - 4x 4-wire PT/LC amps - 4x TC amps - CAN Bus for external DAQ

comm
- RS-485 for user-side
comms - LoRa for user-side comms - 12V, 18A igniter - 2x 12V fan connectors - External valve control - External audio DAC output

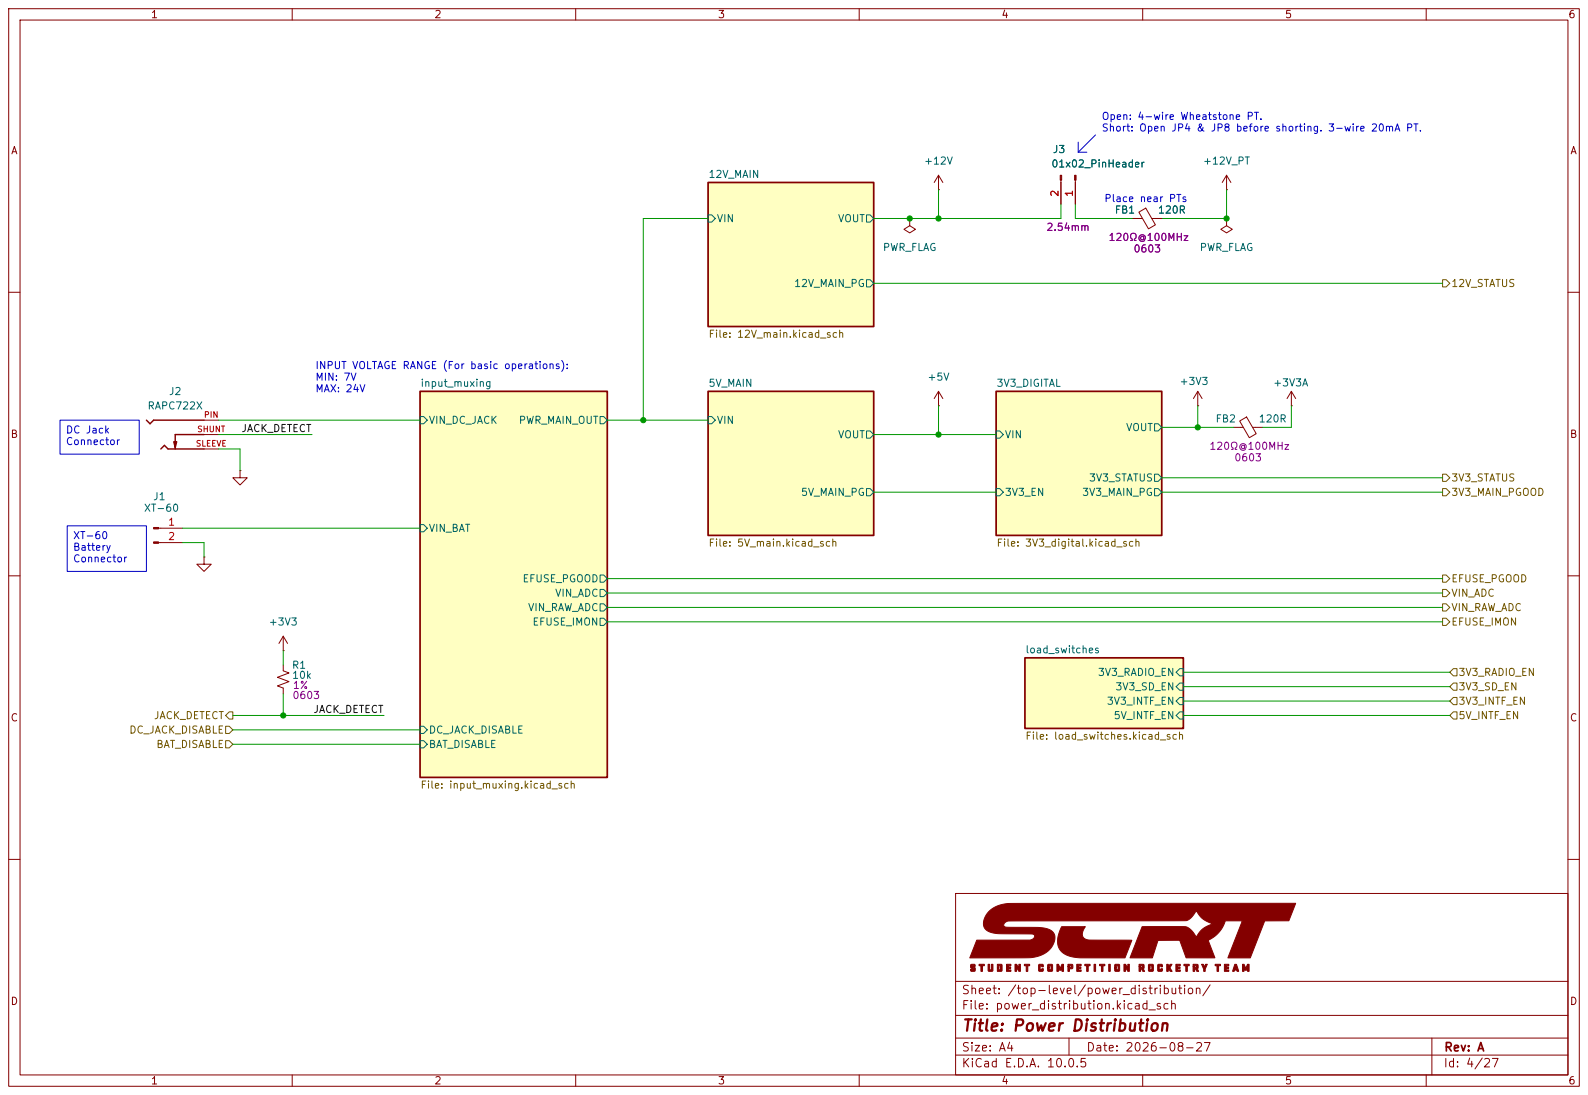
[picture p63: page 4]

JACK_DETECT DC Jack Connector XT-60 Battery Connector

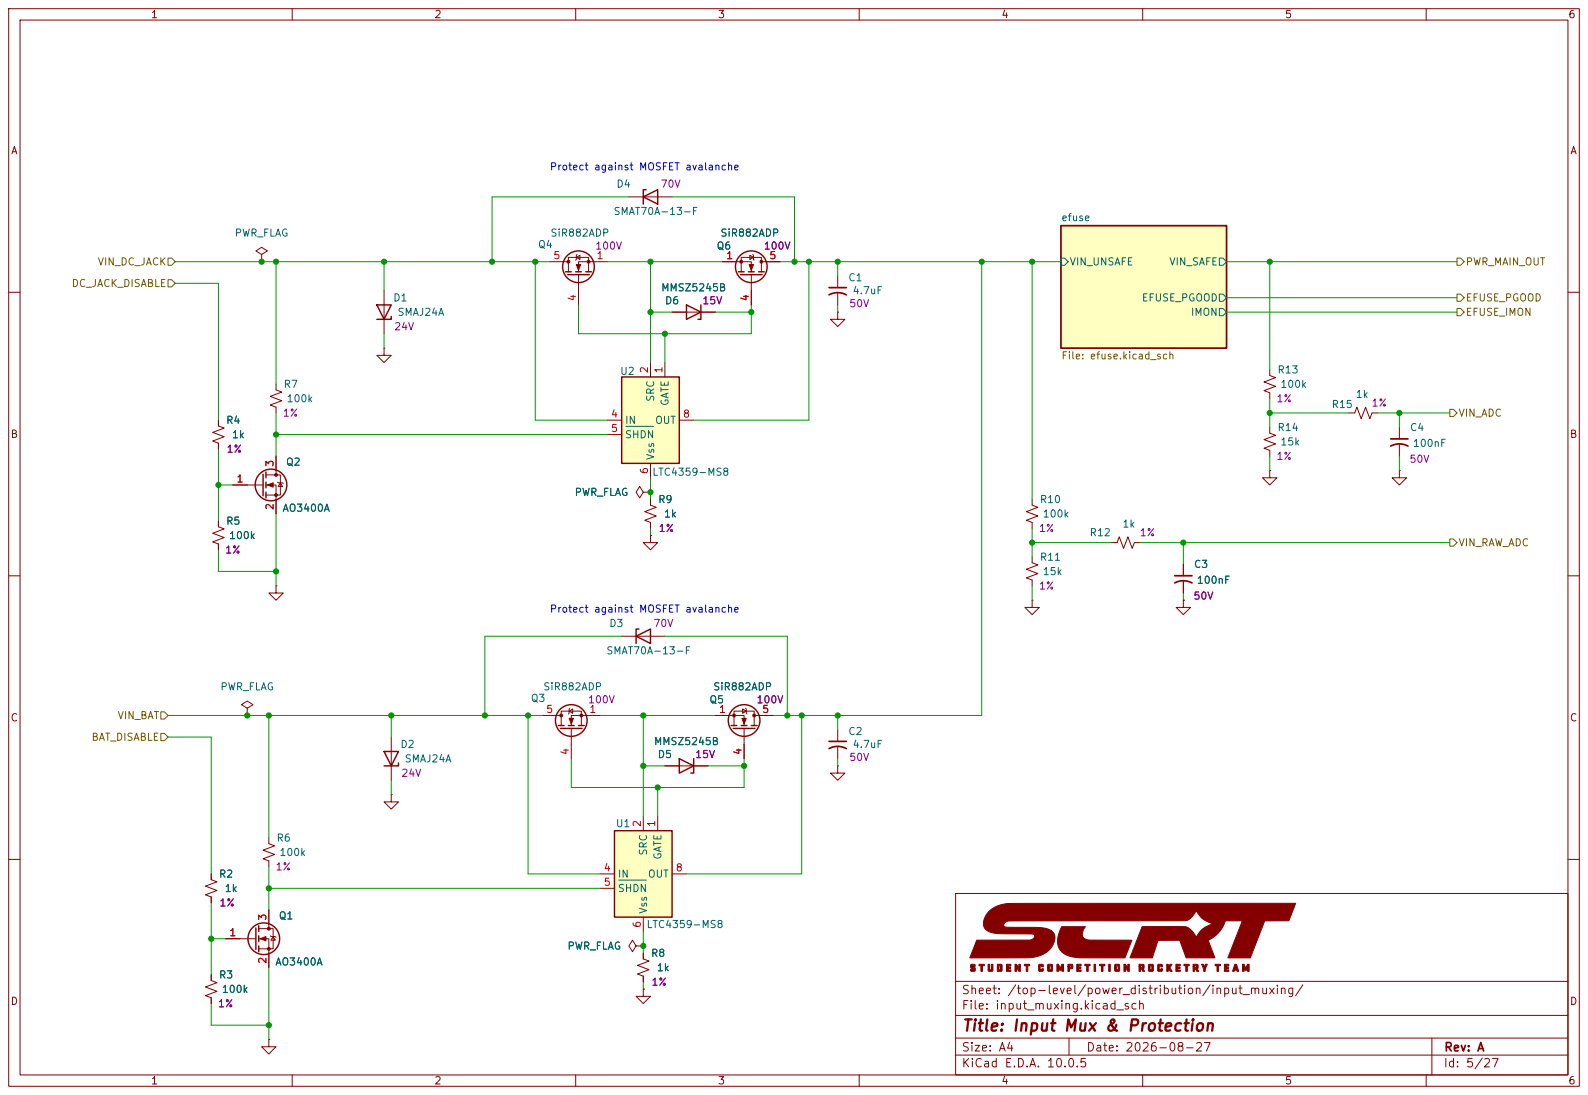
[picture p64: page 5]

Sheet: /top-level/power_distribution/input_muxing/
File: input_muxing.kicad_sch
Title: Input Mux & Protection

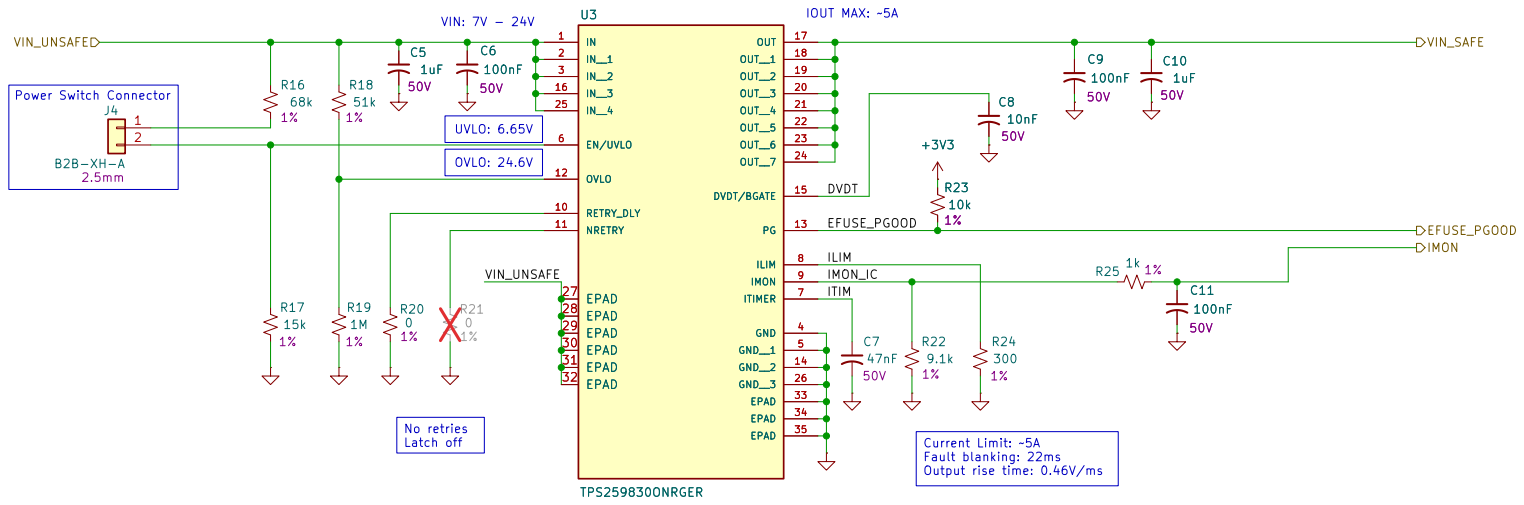
[picture p65: page 6]

Fault blanking: 22ms Output rise time: 0.46V/ms UVLO: 6.65V OVLO: 24.6V Power Switch Connector

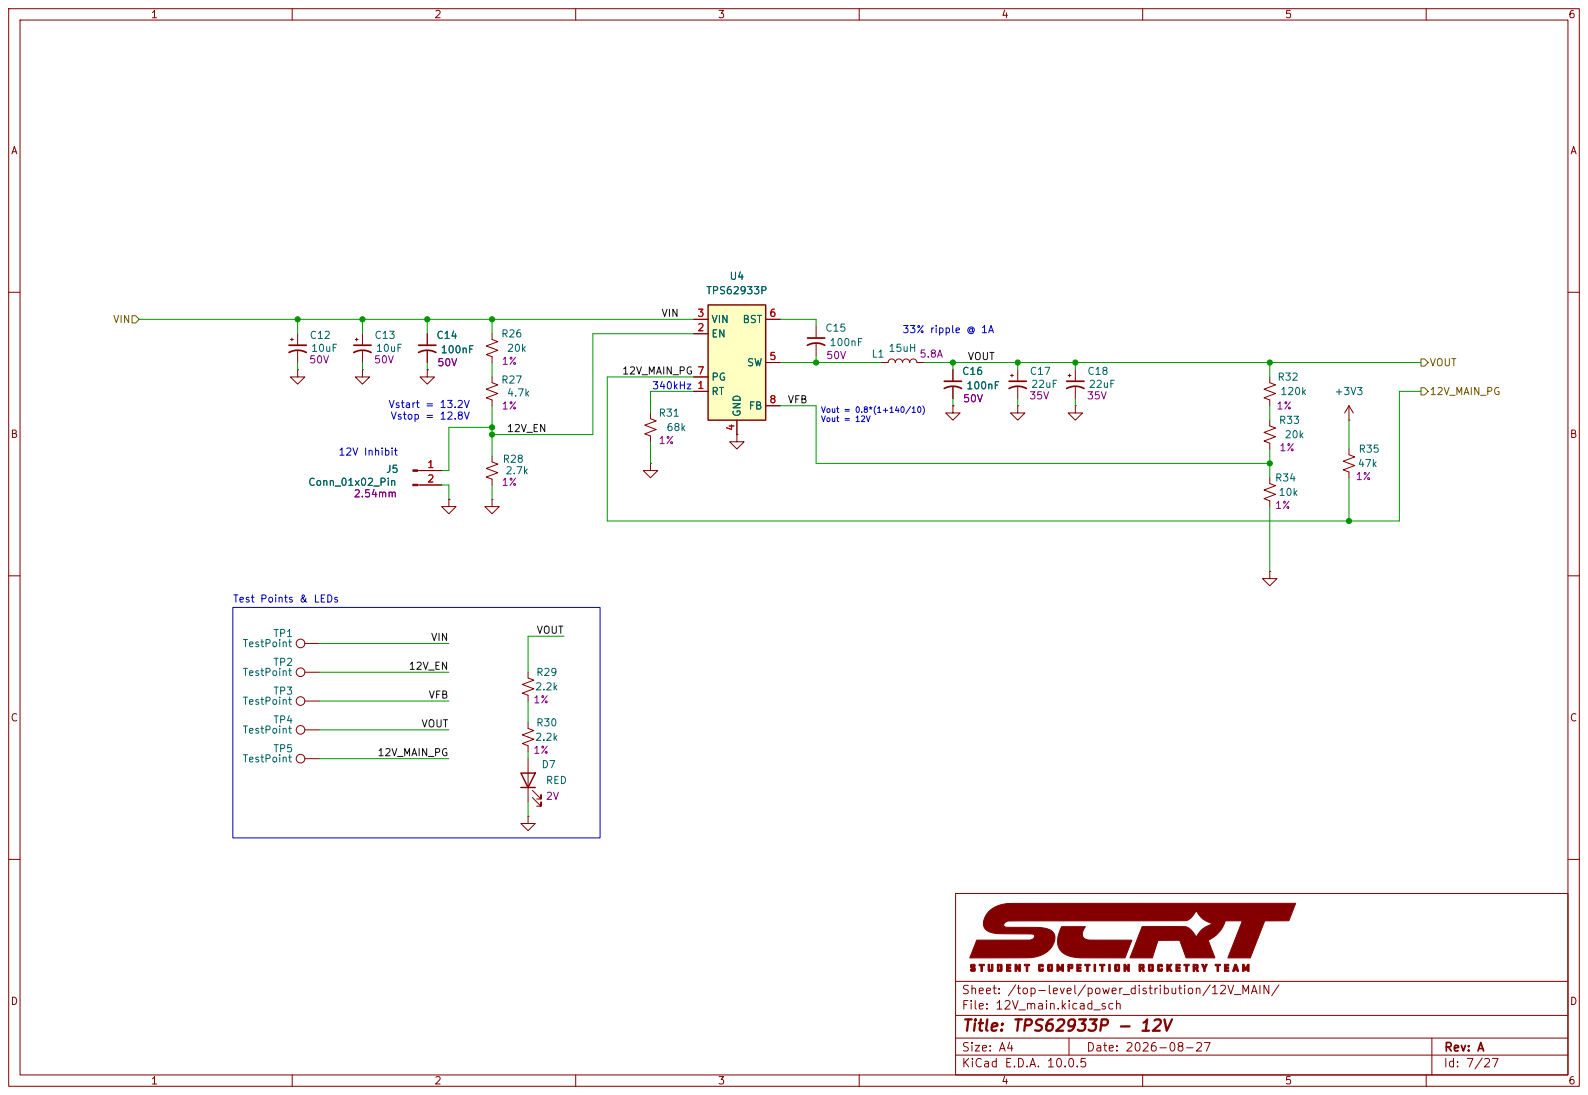
[picture p66: page 7]

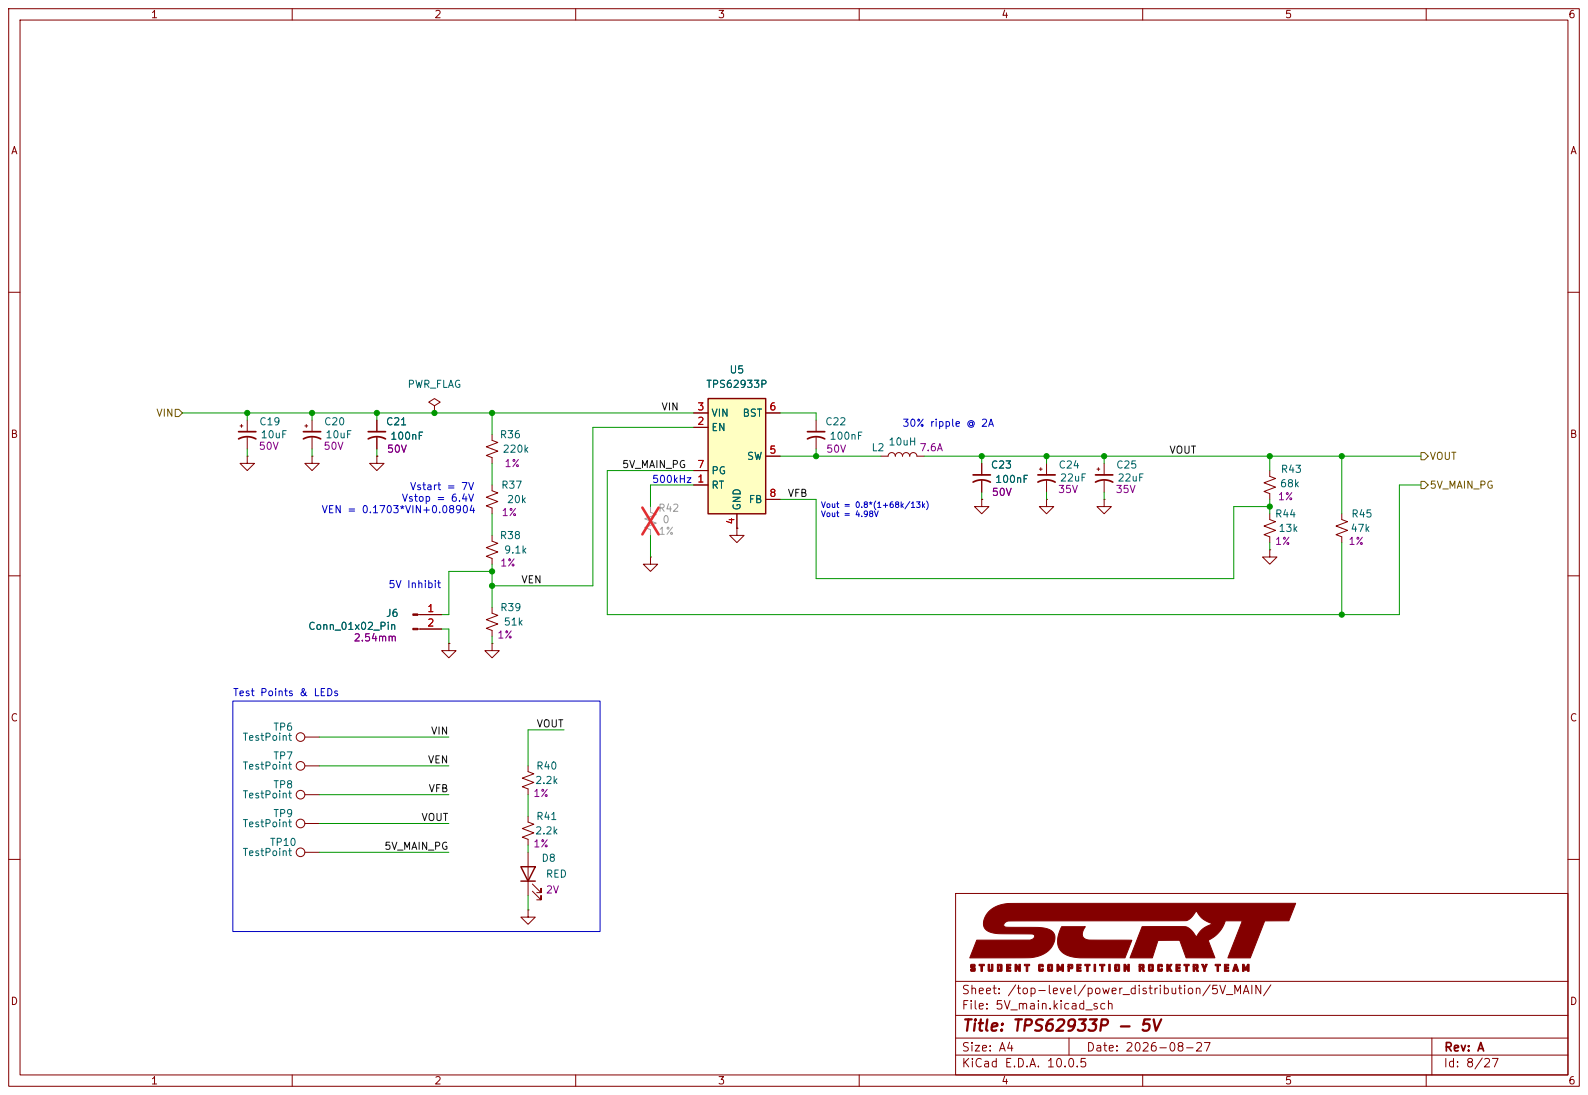
[picture p67: page 8]

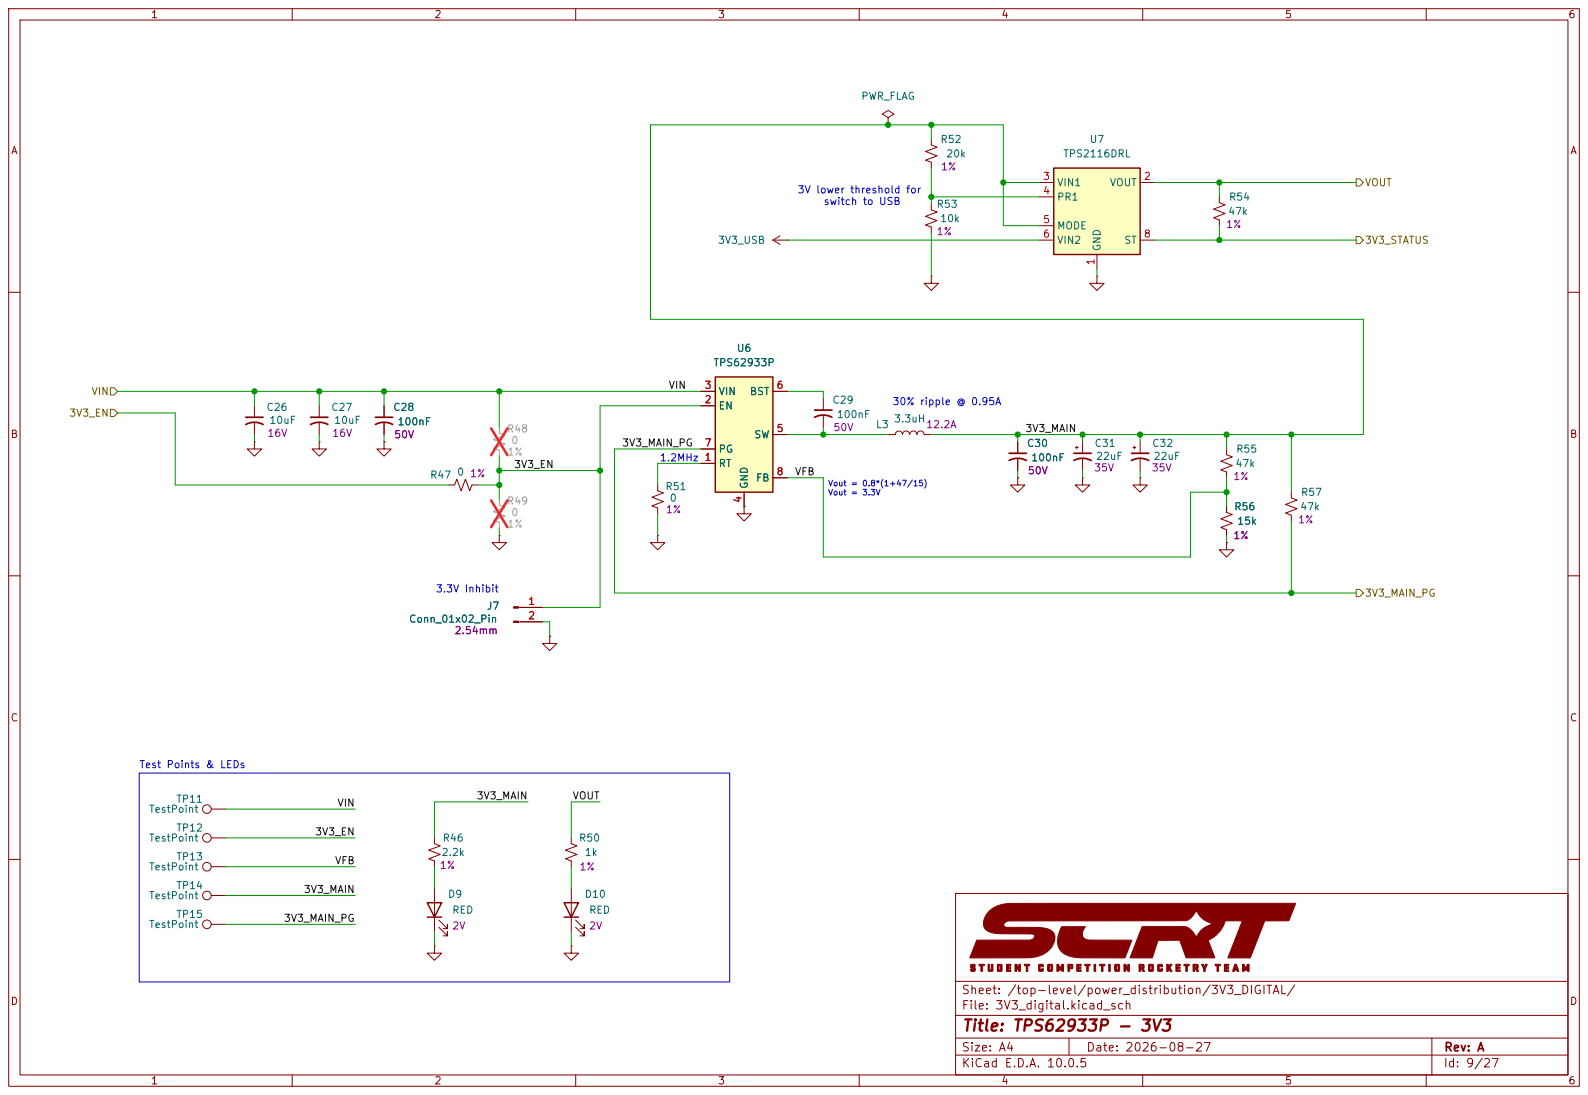
[picture p68: page 9]

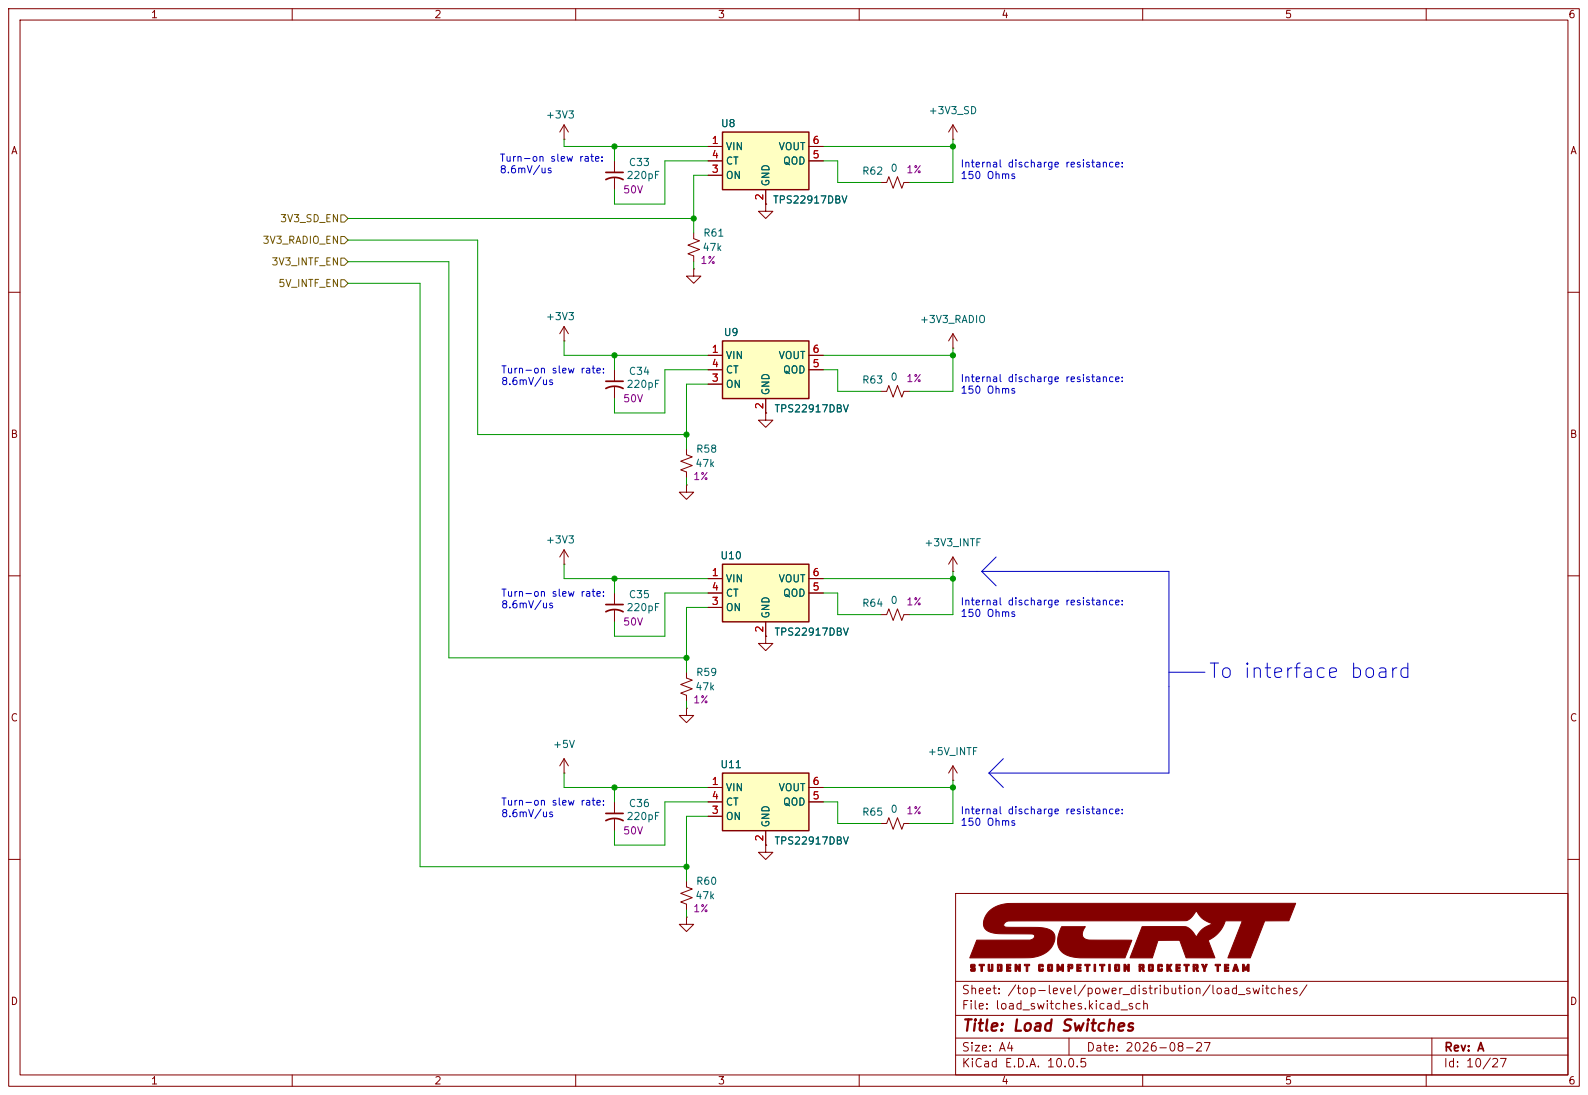
[picture p69: page 10]

2 ON 3 CT 4 QOD 5
Internal discharge resistance: 150 Ohms U11

Turn-on slew rate: 8.6mV/us

Internal discharge resistance: 150 Ohms

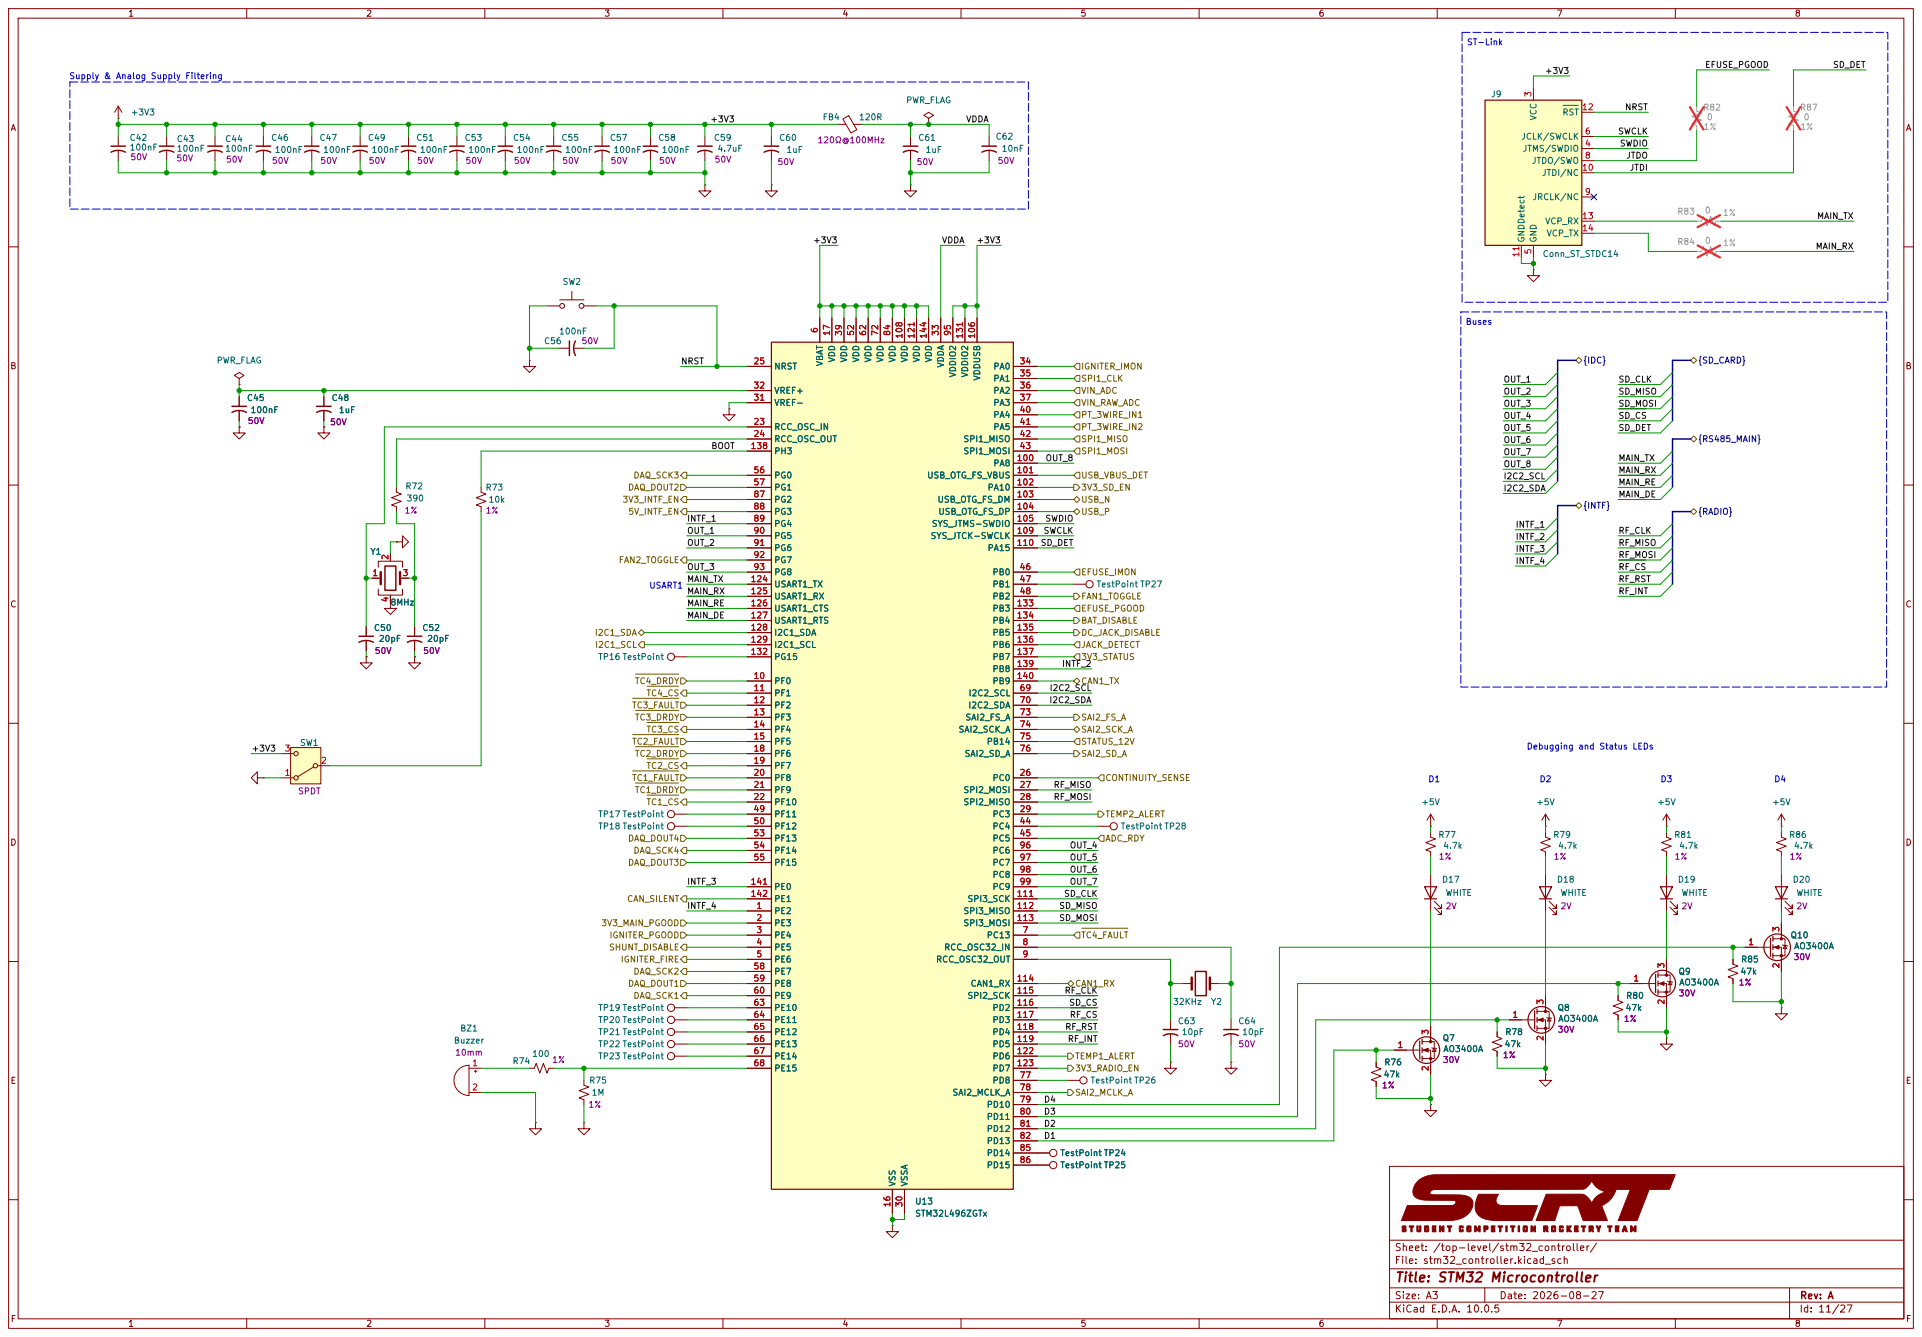
[picture p70: page 11]

TP21 TestPoint TP20 TestPoint TP19 TestPoint TP22 TestPoint TP23 TestPoint 1

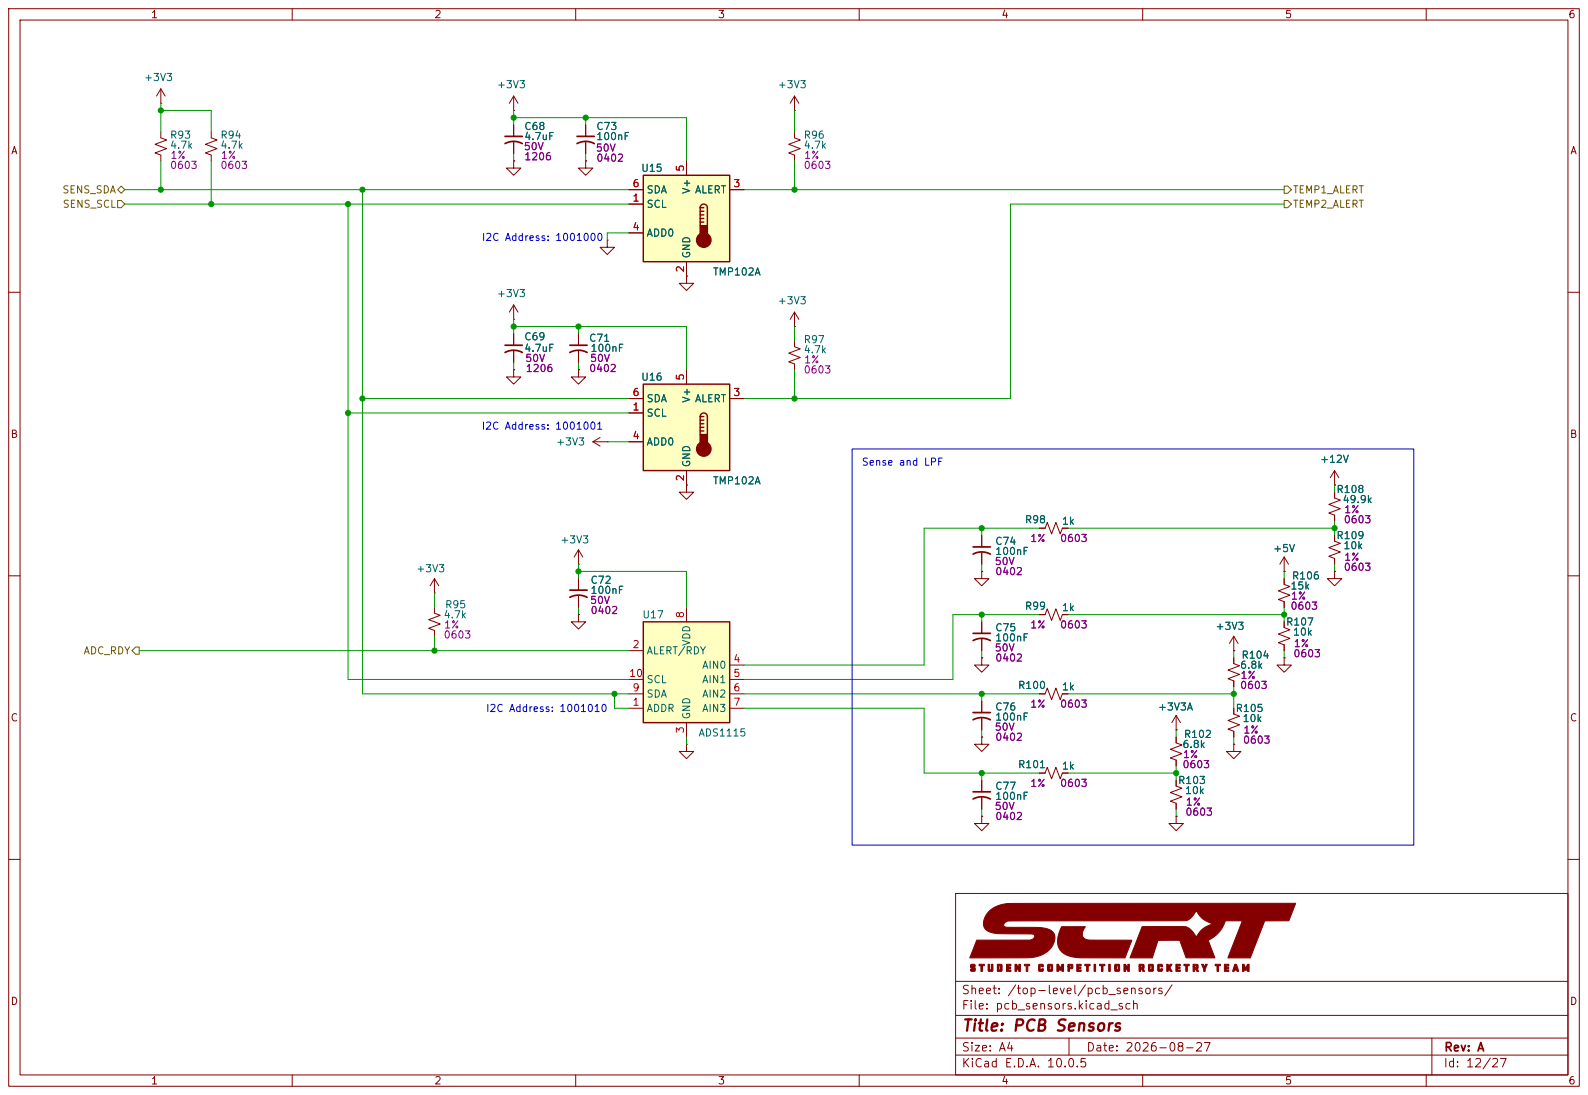
[picture p71: page 12]

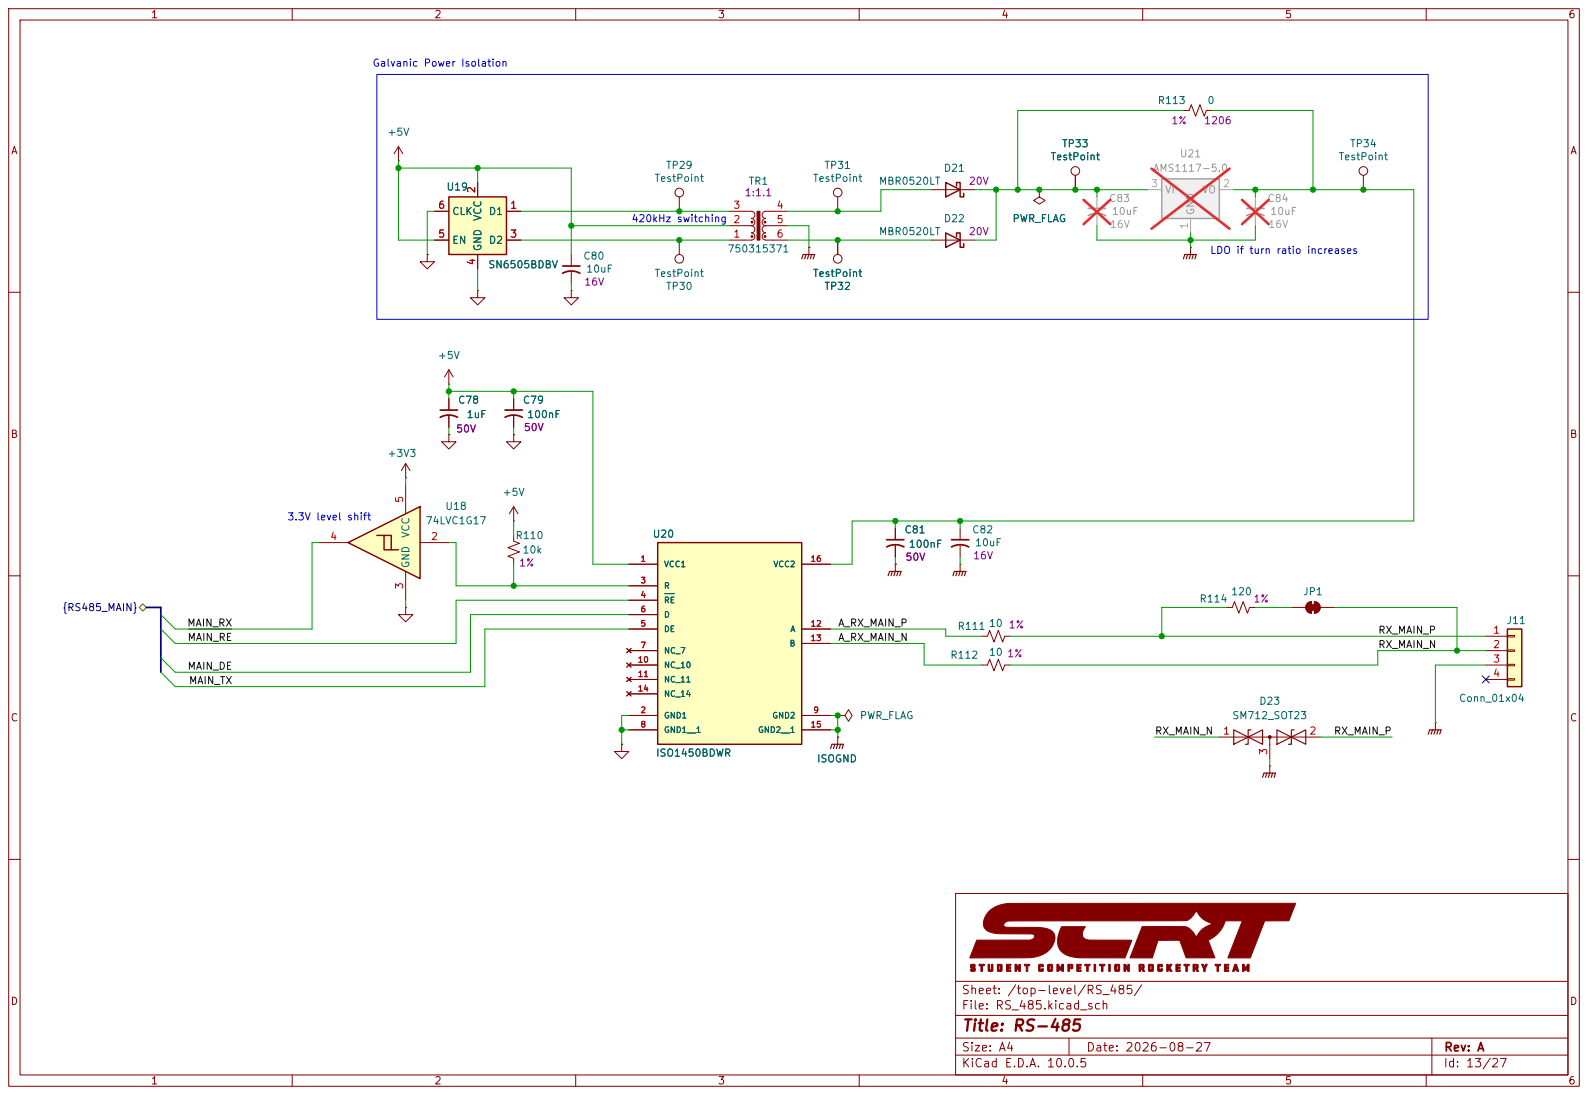
[picture p72: page 13]

LDO if turn ratio increases U19

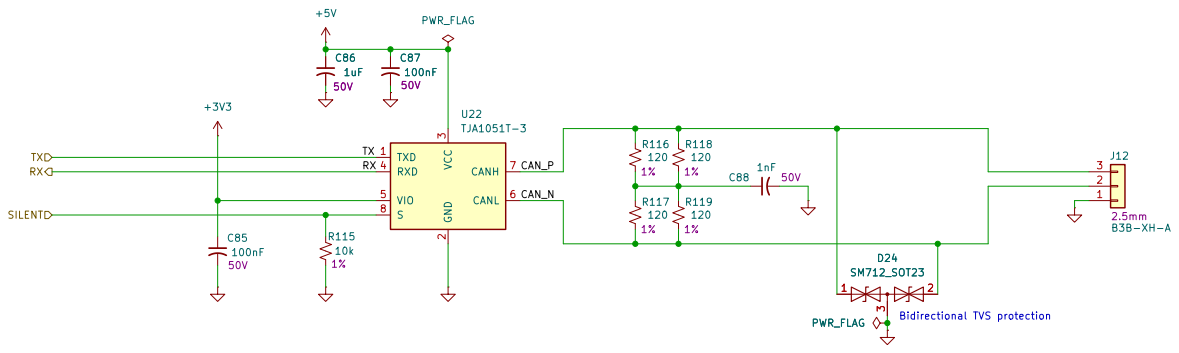
[picture p73: page 14]

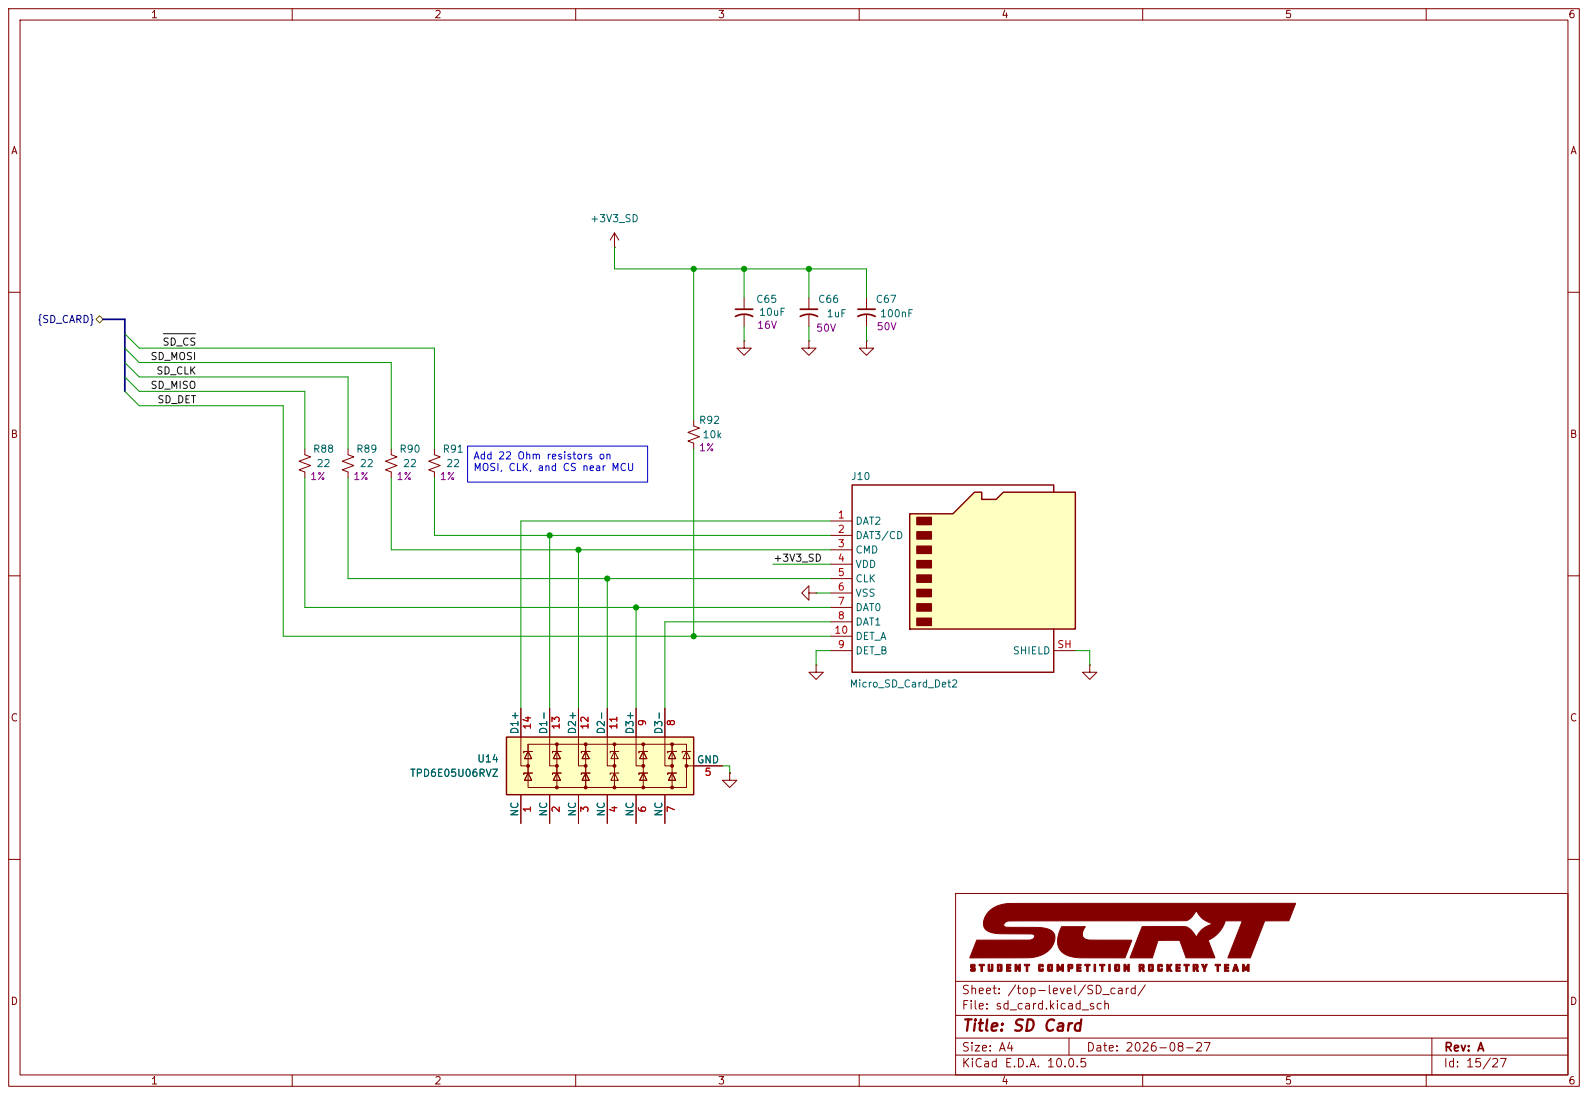
[picture p74: page 15]

Add 22 Ohm resistors on MOSI, CLK, and CS near MCU

DAT2 1 DAT3/CD 2 CMD 3

VDD 4 CLK 5

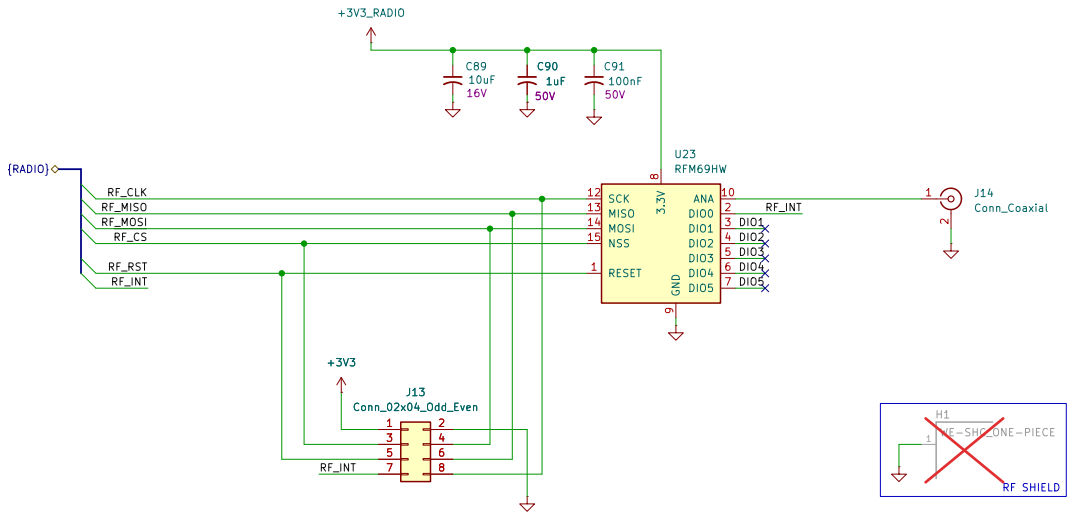
[picture p75: page 16]

Sheet: /top-level/rf/
File: rf.kicad_sch
Title: LoRa Radio

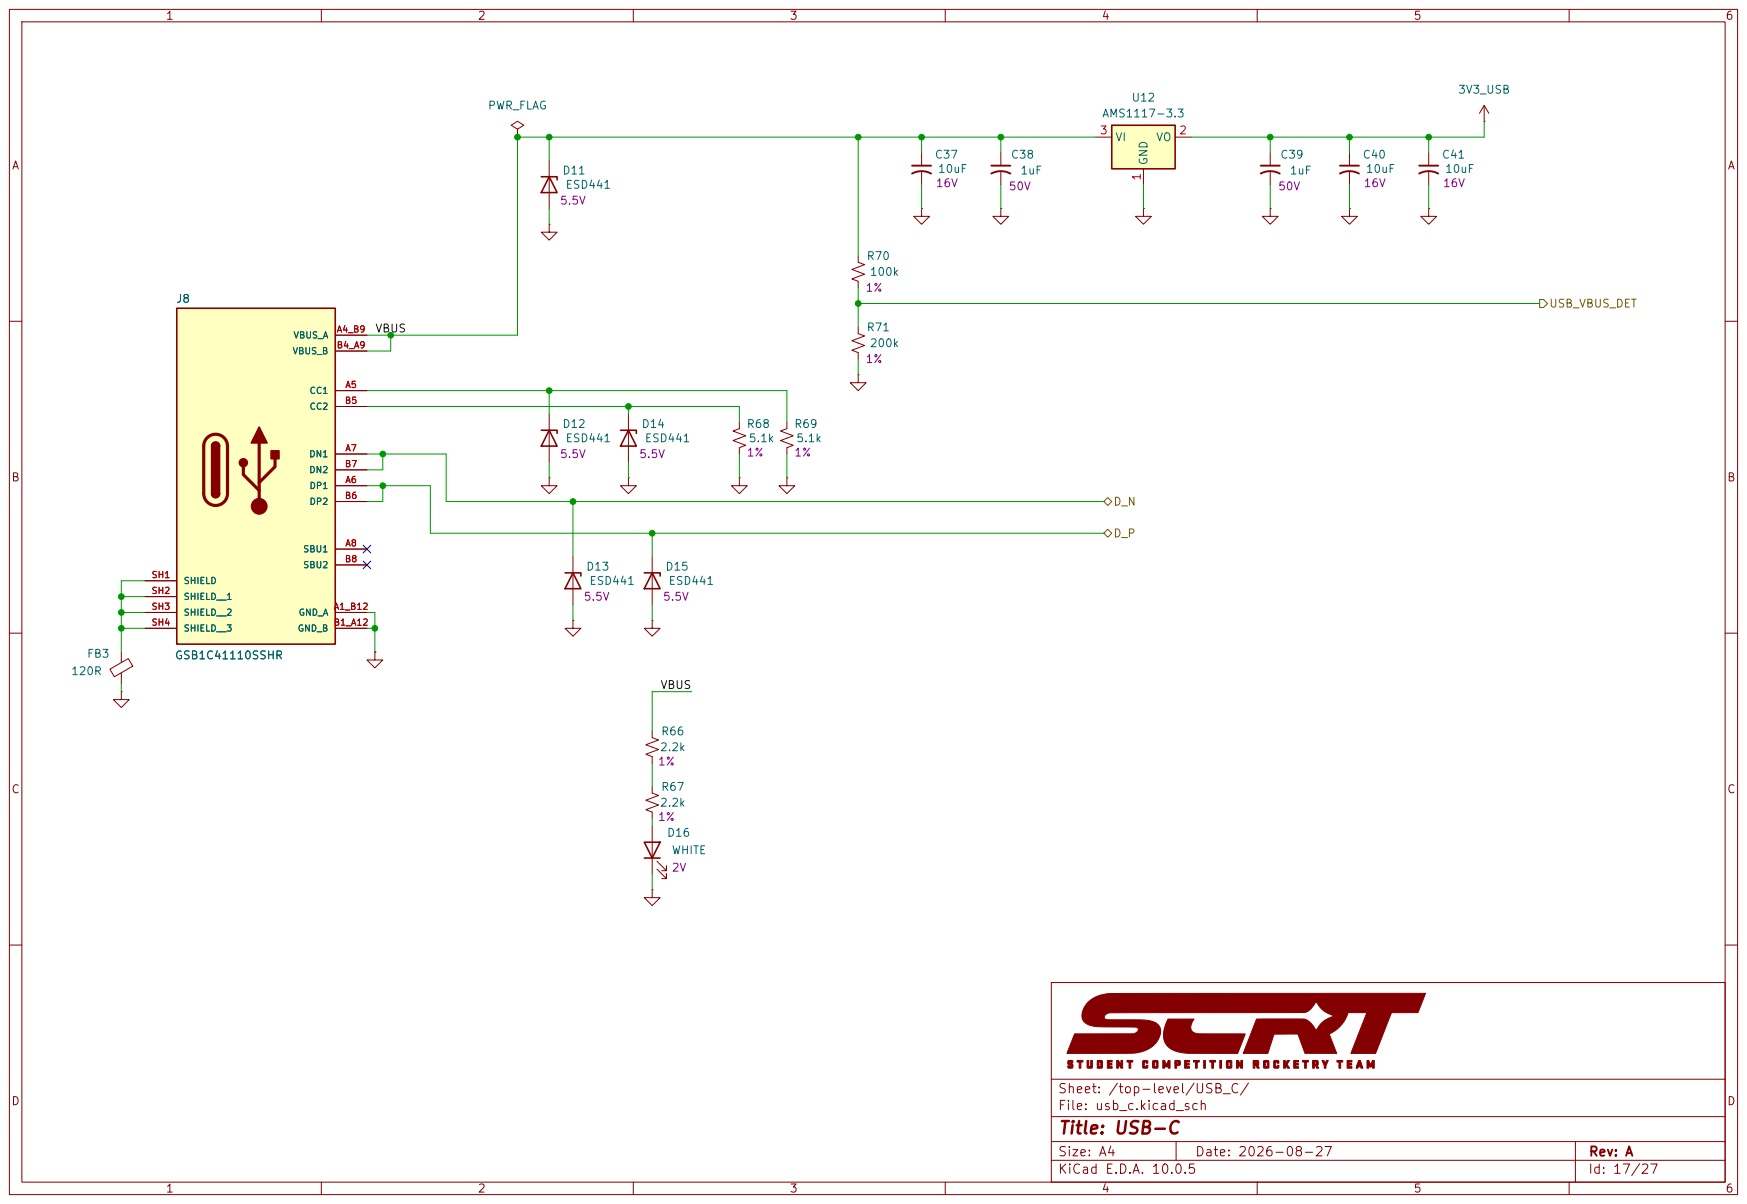
[picture p76: page 17]

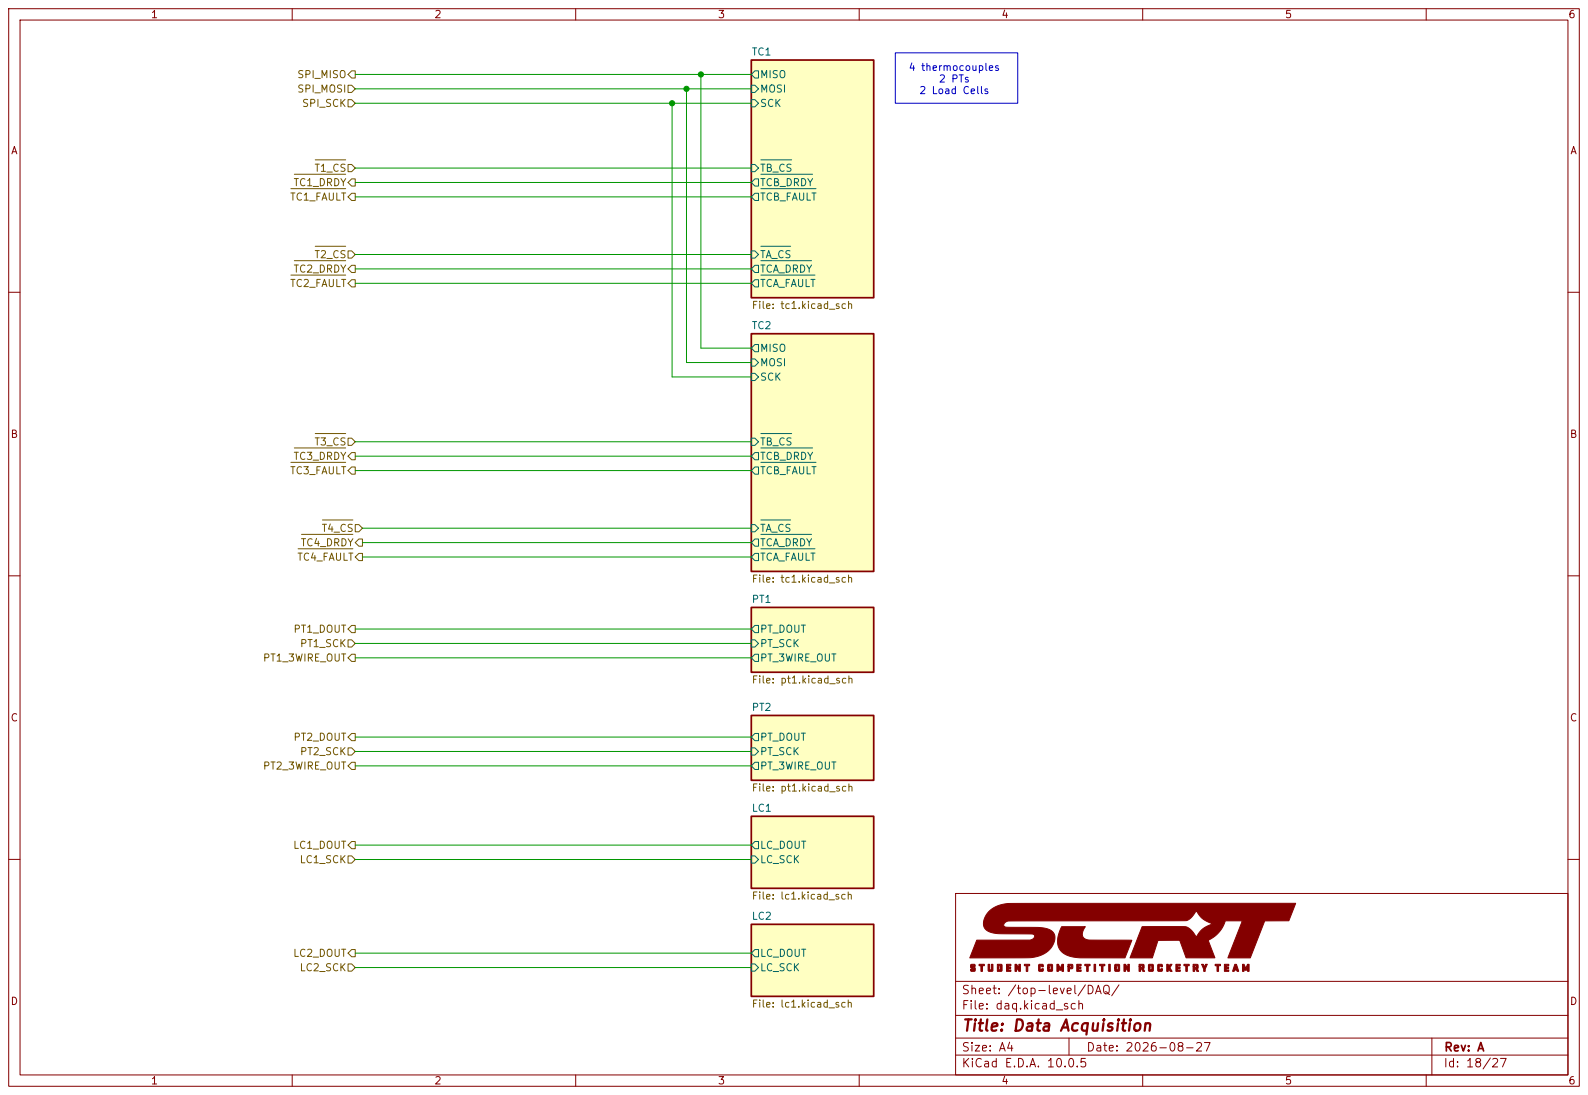
[picture p77: page 18]

Sheet: /top-level/DAQ/
File: daq.kicad_sch
Title: Data Acquisition

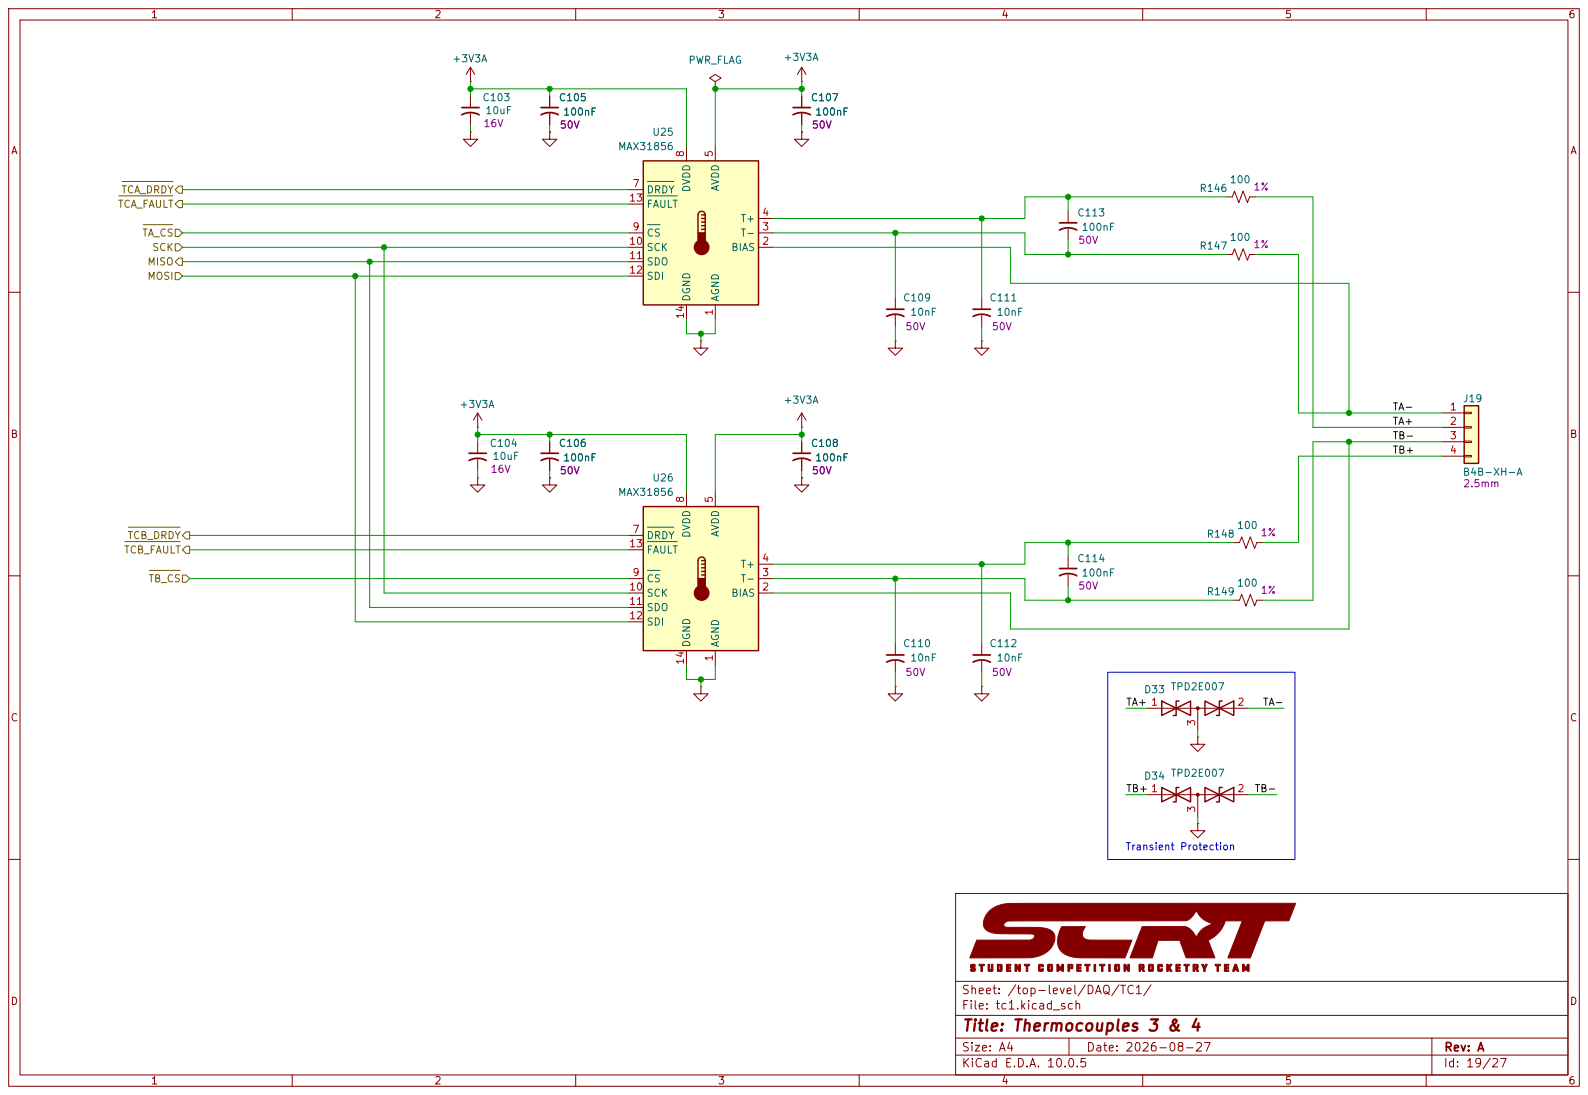
[picture p78: page 19]

Sheet: /top-level/DAQ/TC1/
File: tc1.kicad_sch
Title: Thermocouples 3 & 4

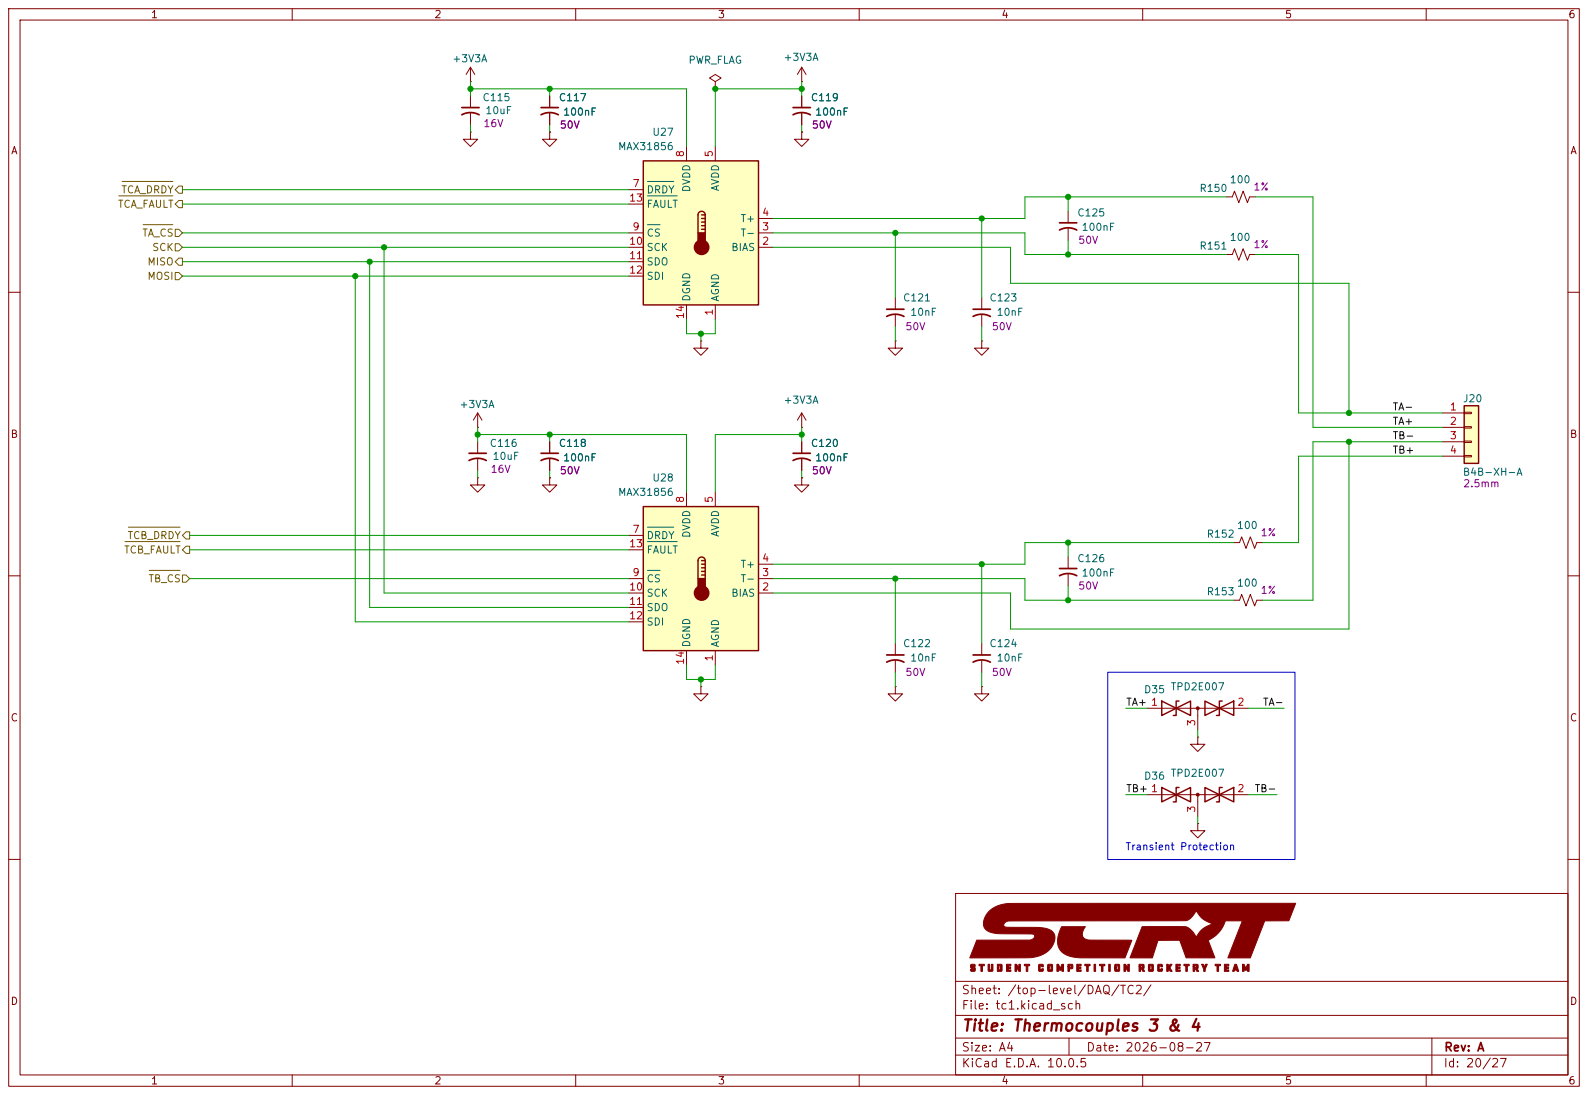
[picture p79: page 20]

Sheet: /top-level/DAQ/TC2/
File: tc1.kicad_sch
Title: Thermocouples 3 & 4

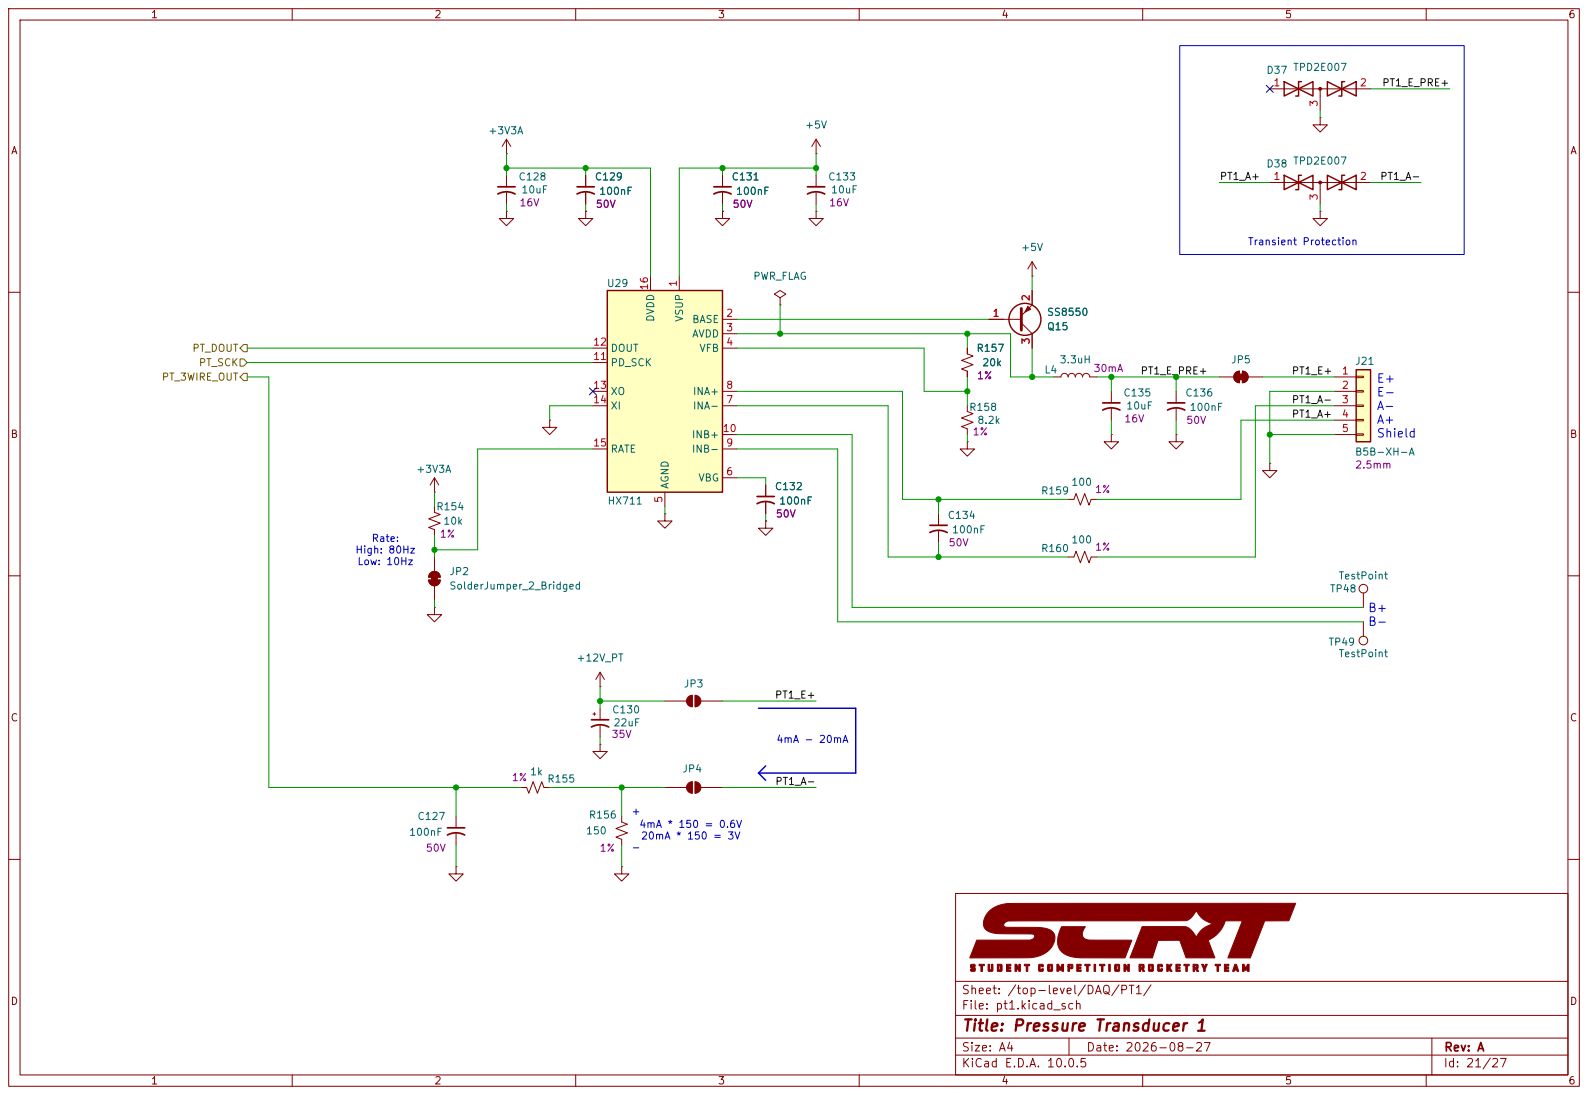
[picture p80: page 21]

Sheet: /top-level/DAQ/PT1/
File: pt1.kicad_sch
Title: Pressure Transducer 1

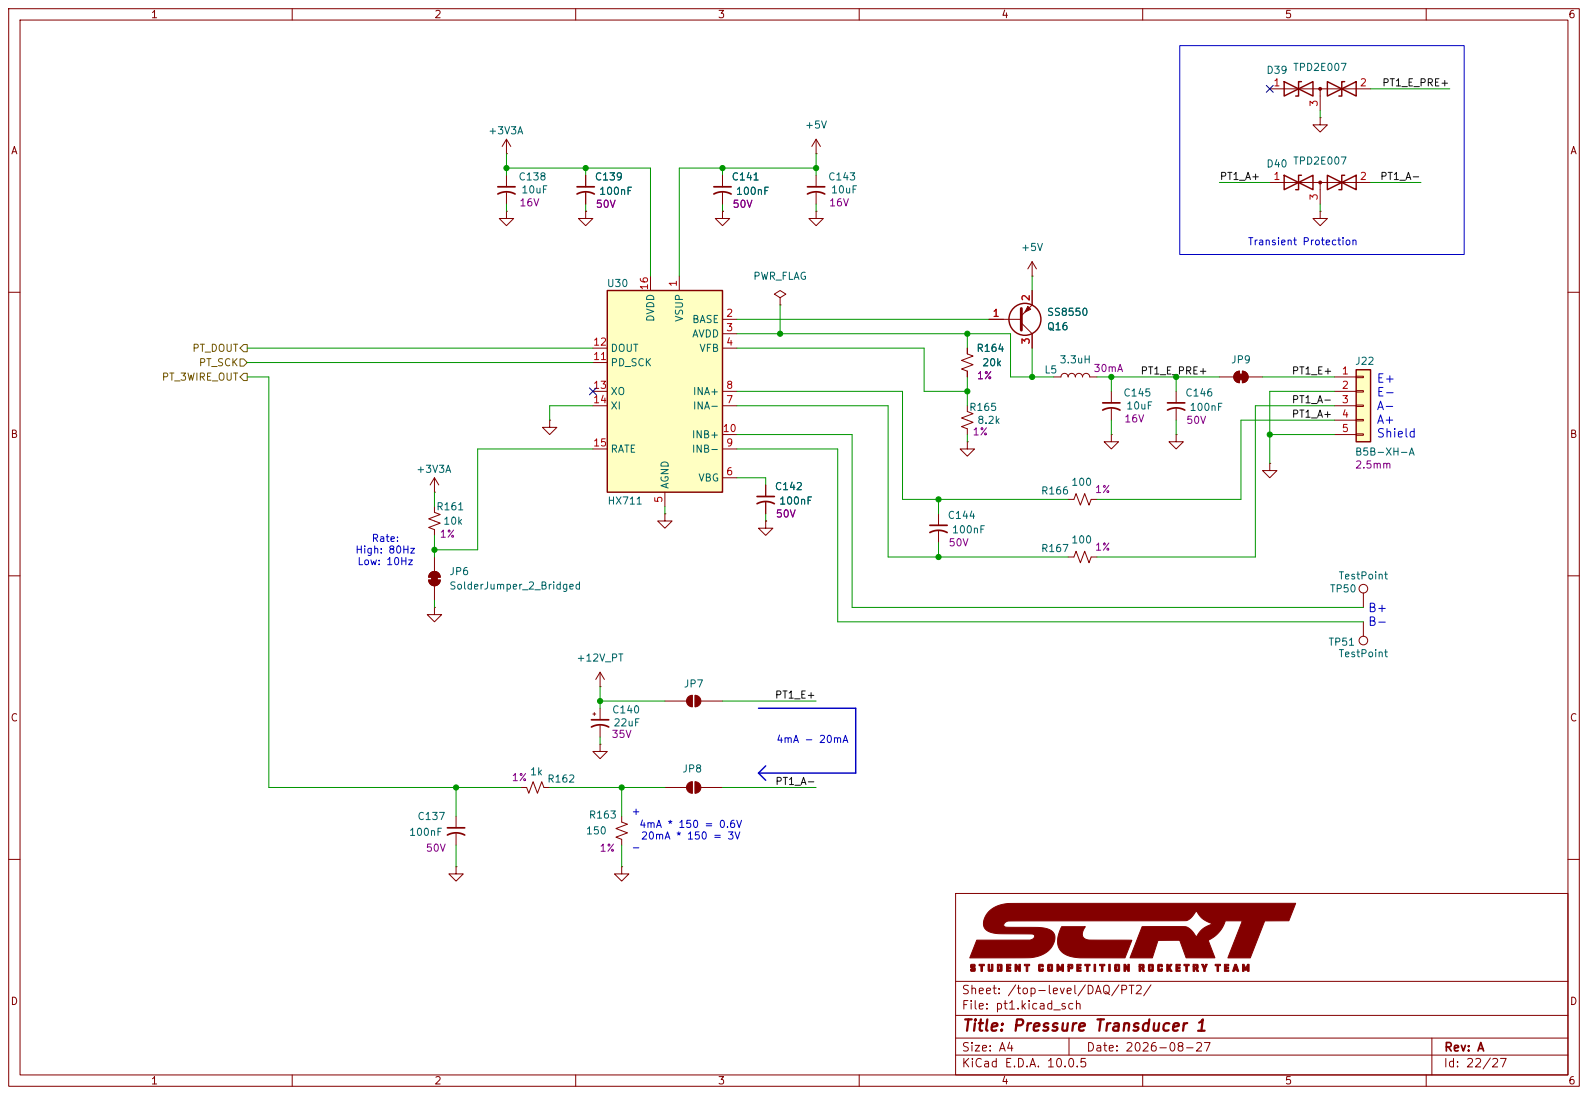
[picture p81: page 22]

Sheet: /top-level/DAQ/PT2/
File: pt1.kicad_sch
Title: Pressure Transducer 1

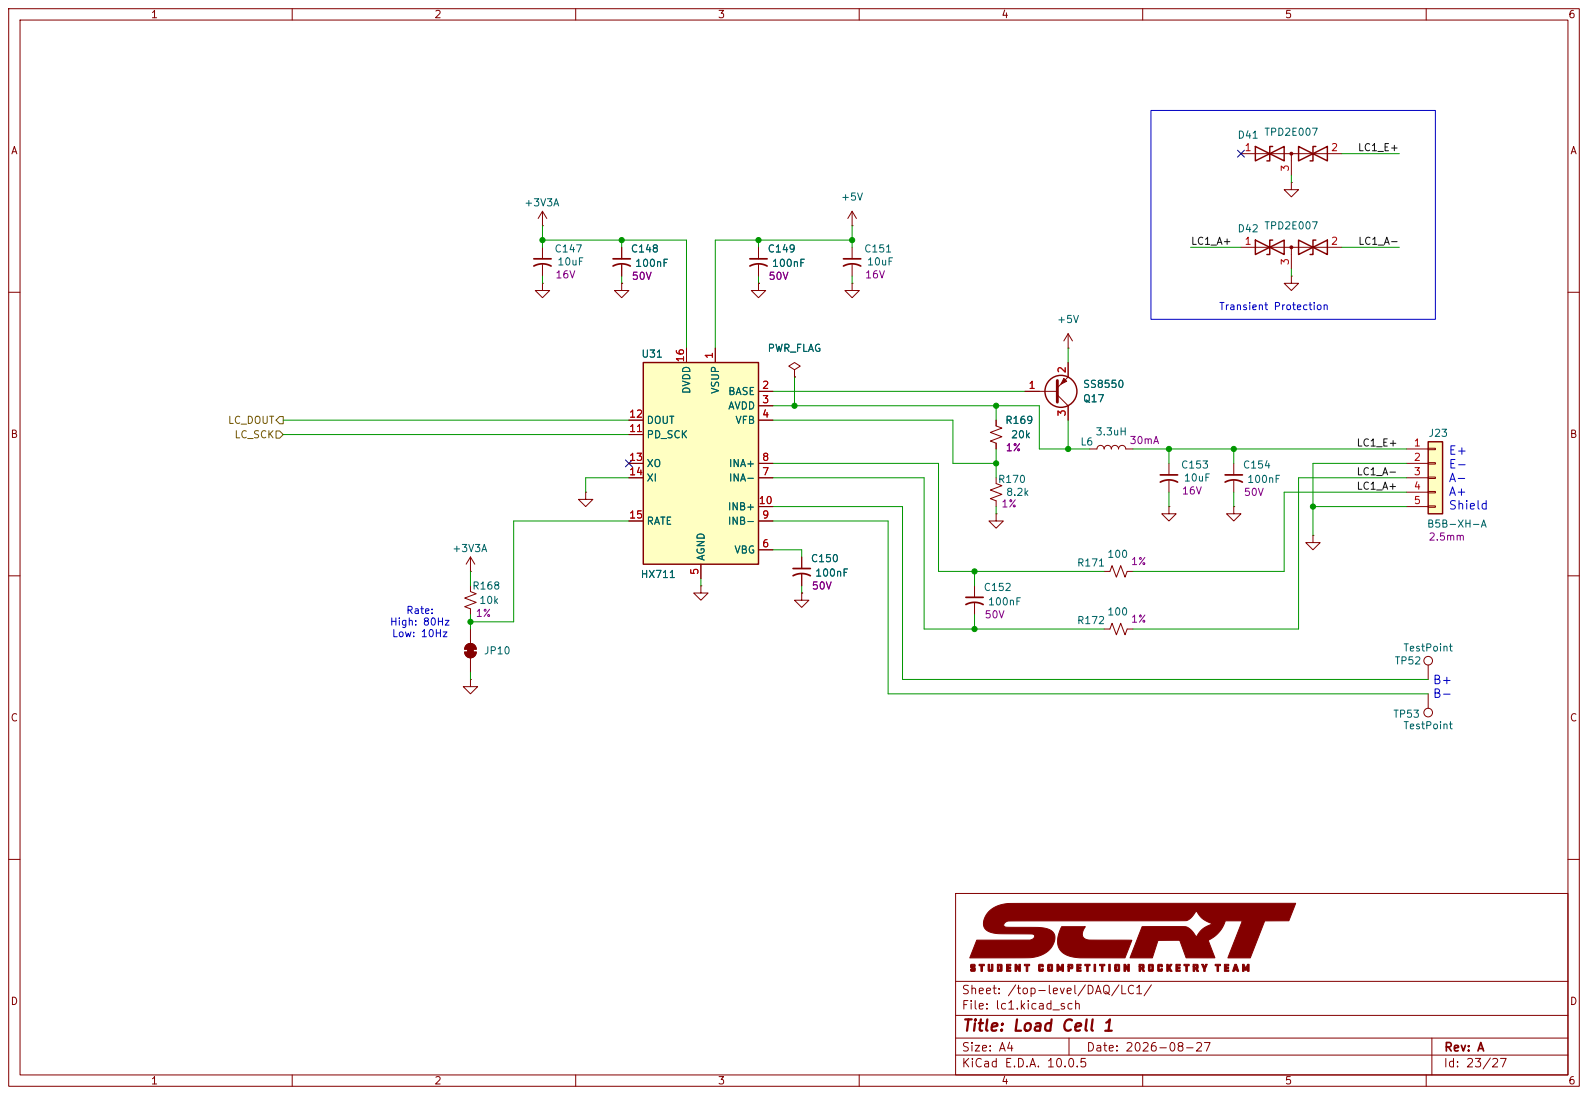
[picture p82: page 23]

Sheet: /top-level/DAQ/LC1/
File: lc1.kicad_sch
Title: Load Cell 1

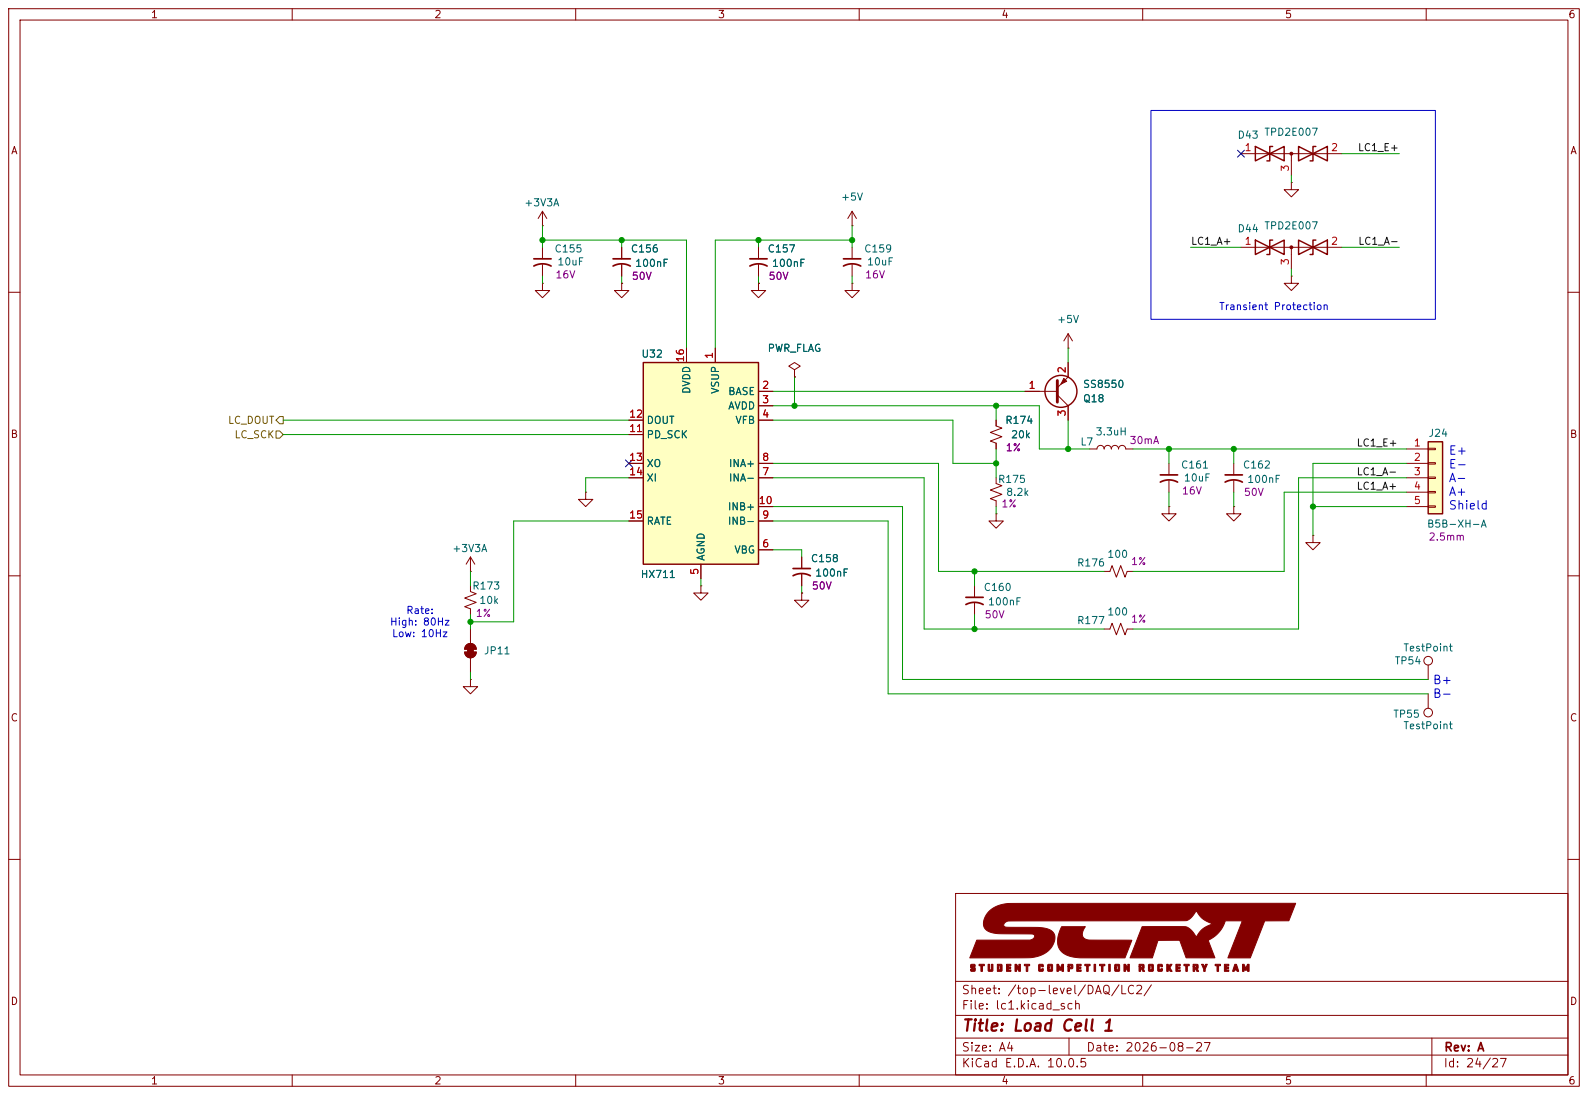
[picture p83: page 24]

Sheet: /top-level/DAQ/LC2/
File: lc1.kicad_sch
Title: Load Cell 1

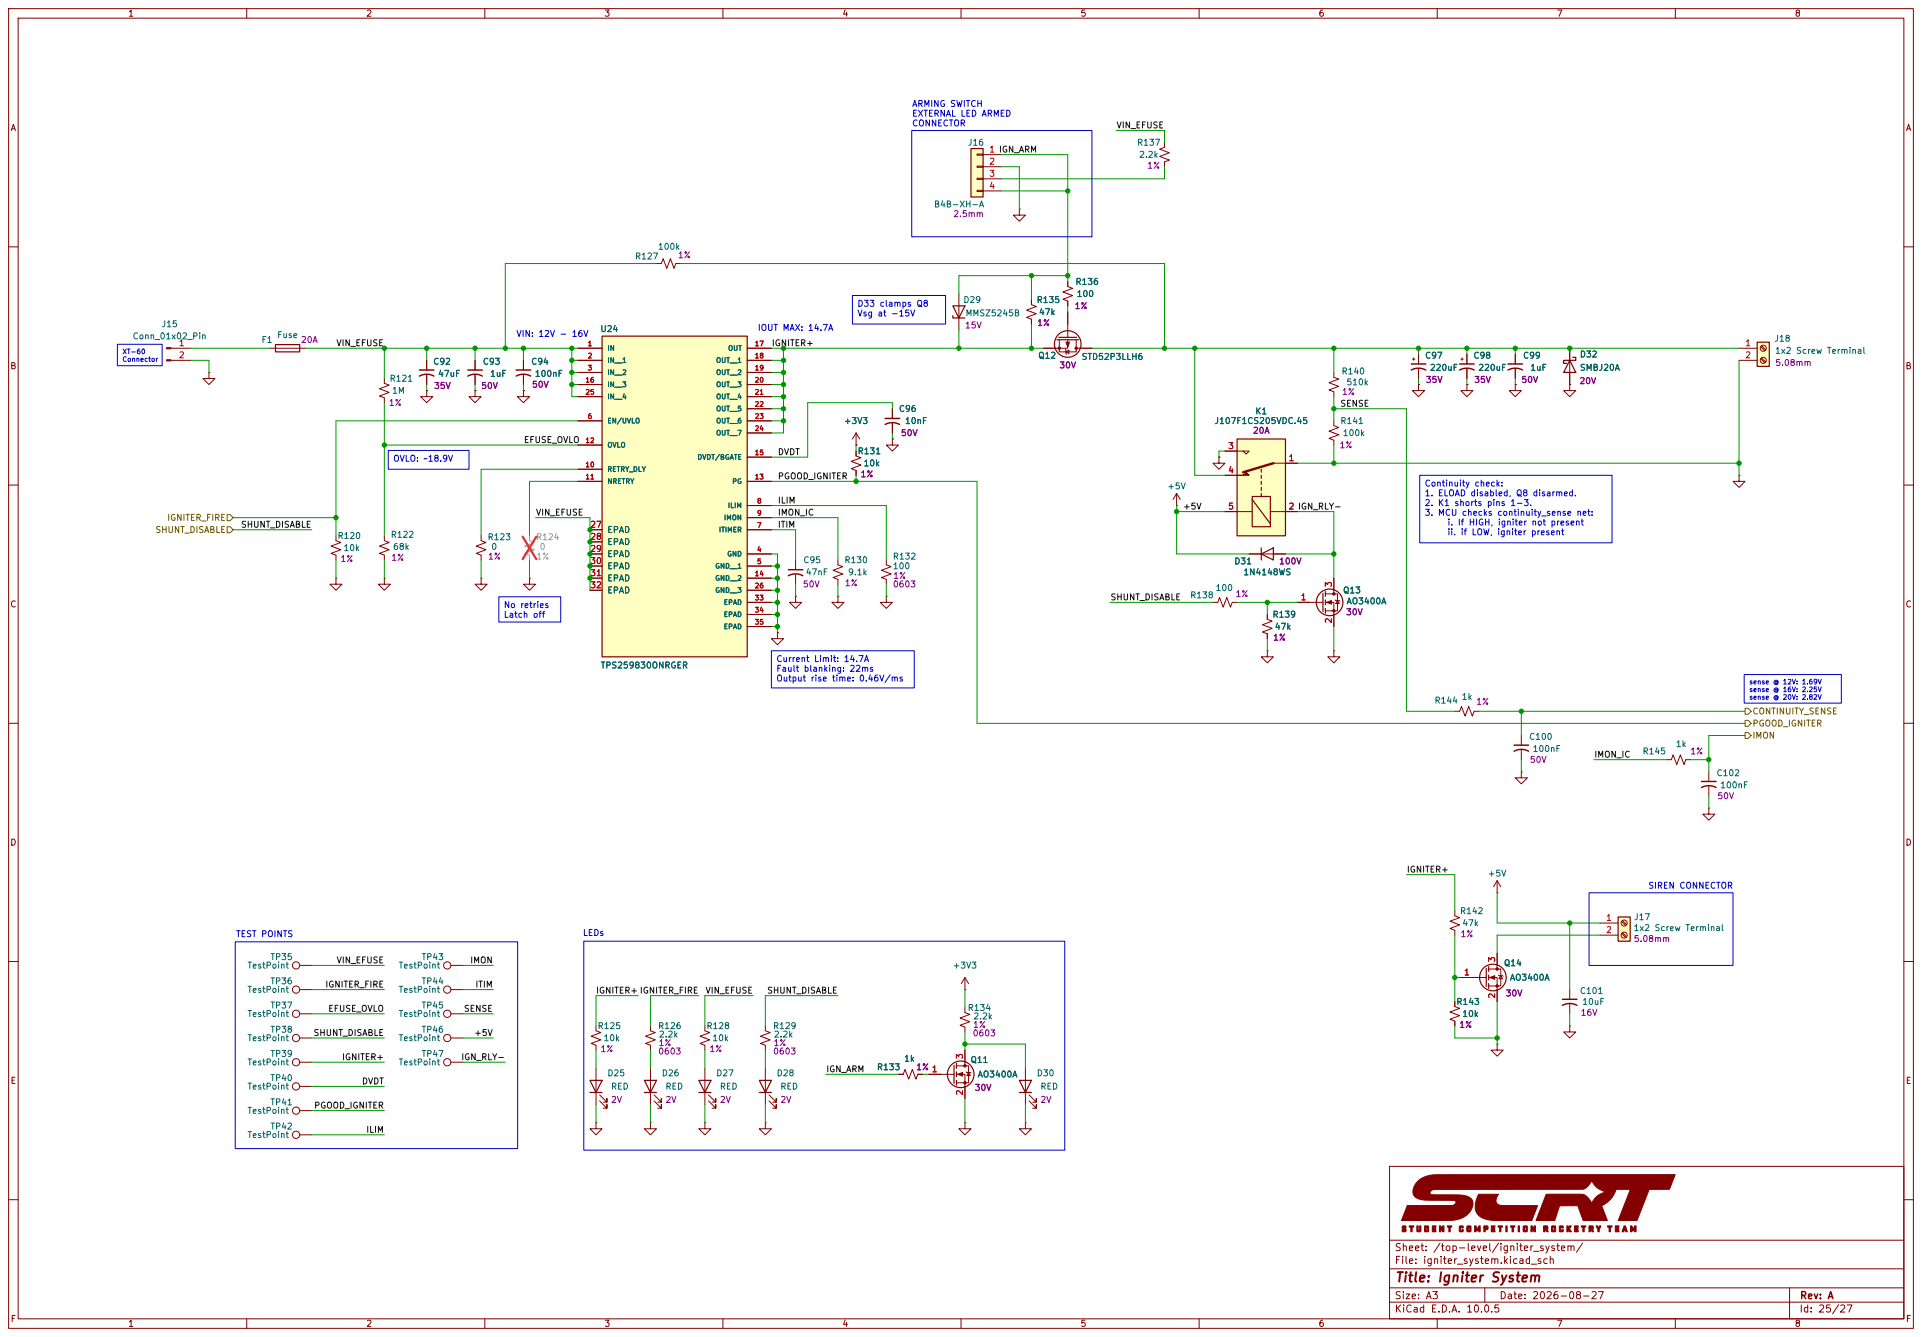
[picture p84: page 25]

ii. if LOW, igniter present D33 clamps Q8

Vsg at -15V No retries
IOUT MAX: 14.7A VIN: 12V - 16V

i. If HIGH, igniter not present

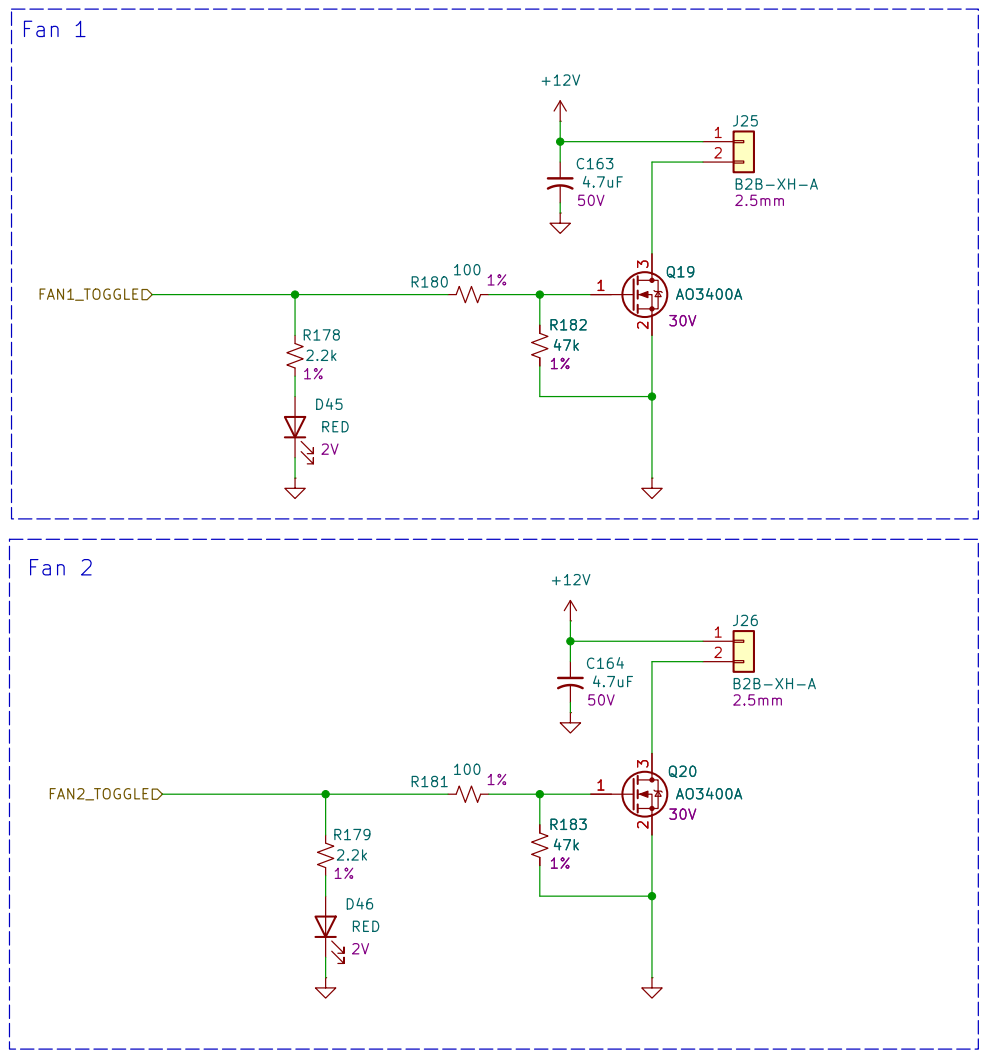
[picture p85: page 26]

Sheet: /top-level/fans/
File: fans.kicad_sch
Title: Fans

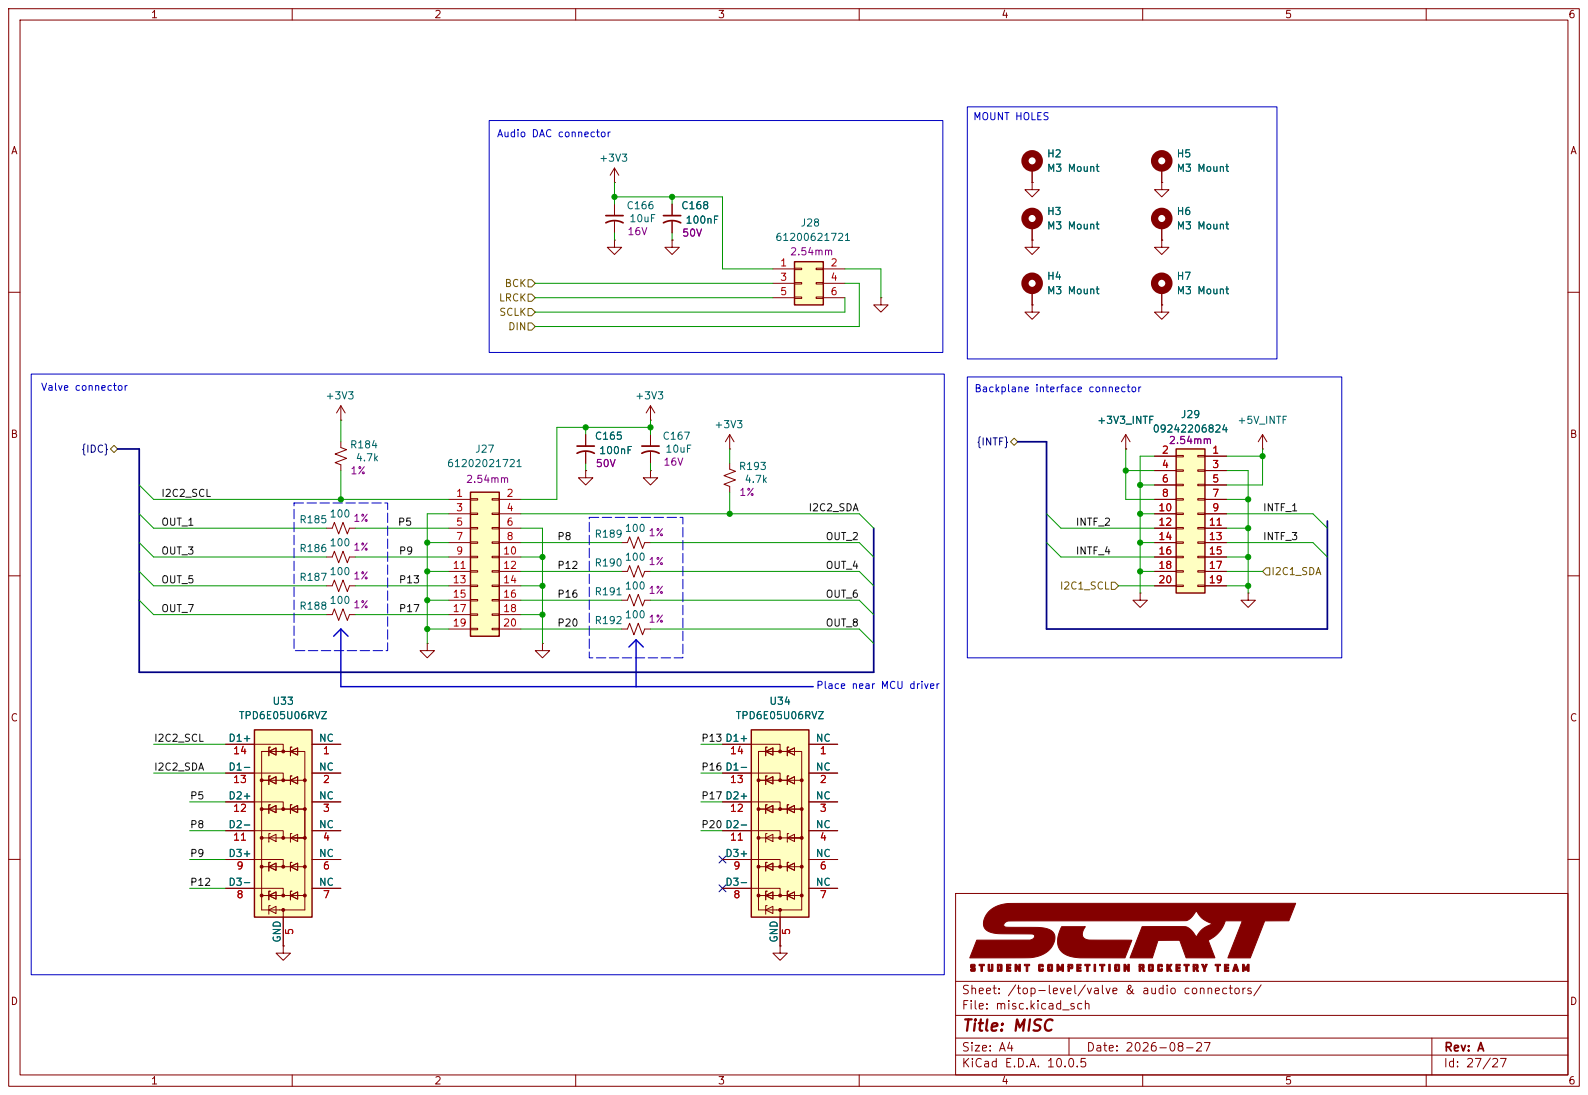
[picture p86: page 27]

H7M3 Mount H6M3 Mount H5M3 Mount H2M3 Mount H3M3 Mount H4M3 Mount R189 100 1% +3V3 R191 100 1%

4 4 | | 3 3
6 6 | | 5 5
8 8 | | 7 7

Sheet: /top-level/valve & audio connectors/
File: misc.kicad_sch
Title: MISC
