Ground-Support-Equipment-SCRT/Pad-Side-Systems/LRUs/Valve Control Unit/Electrical/Valve Power Board/valve_control_pcb/top-level.pdf

Size: A4 | Rev: A
KiCad E.D.A. 10.0.5 | Id: 1/32



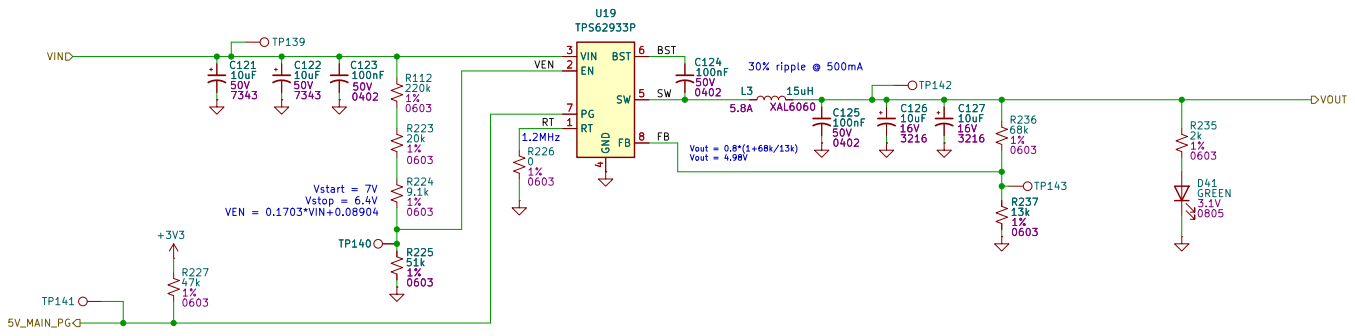
[picture p87: page 4]

Sheet: /System Power/System 5V/
File: system_5V.kicad_sch
Title: SYSTEM 5V


Sheet: /System Power/LSW 5V/
File: lsw_5V.kicad_sch
Title: LSW 5V

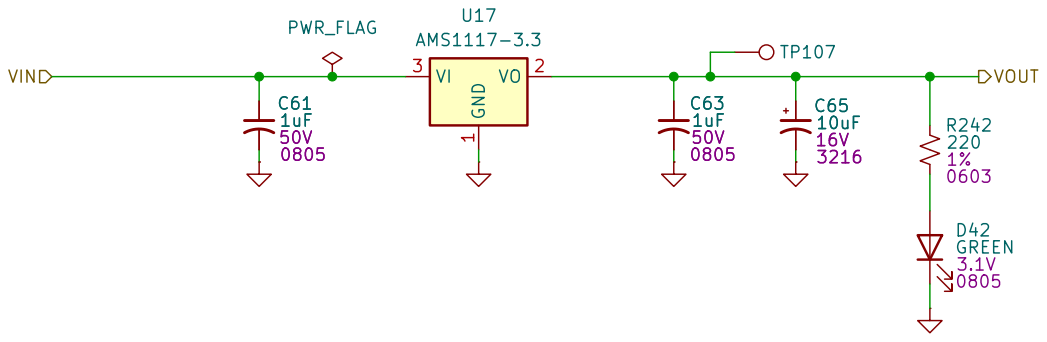
[picture p88: page 6]

Sheet: /System Power/LDO 3V3/
File: ldo_3V3.kicad_sch
Title: LDO 3V3


Sheet: /System Power/MUX 3V3/
File: mux_3V3.kicad_sch
Title: MUX 3V3


Sheet: /System Power/LSW 3V3/
File: lsw_3V3.kicad_sch
Title: LSW 3V3



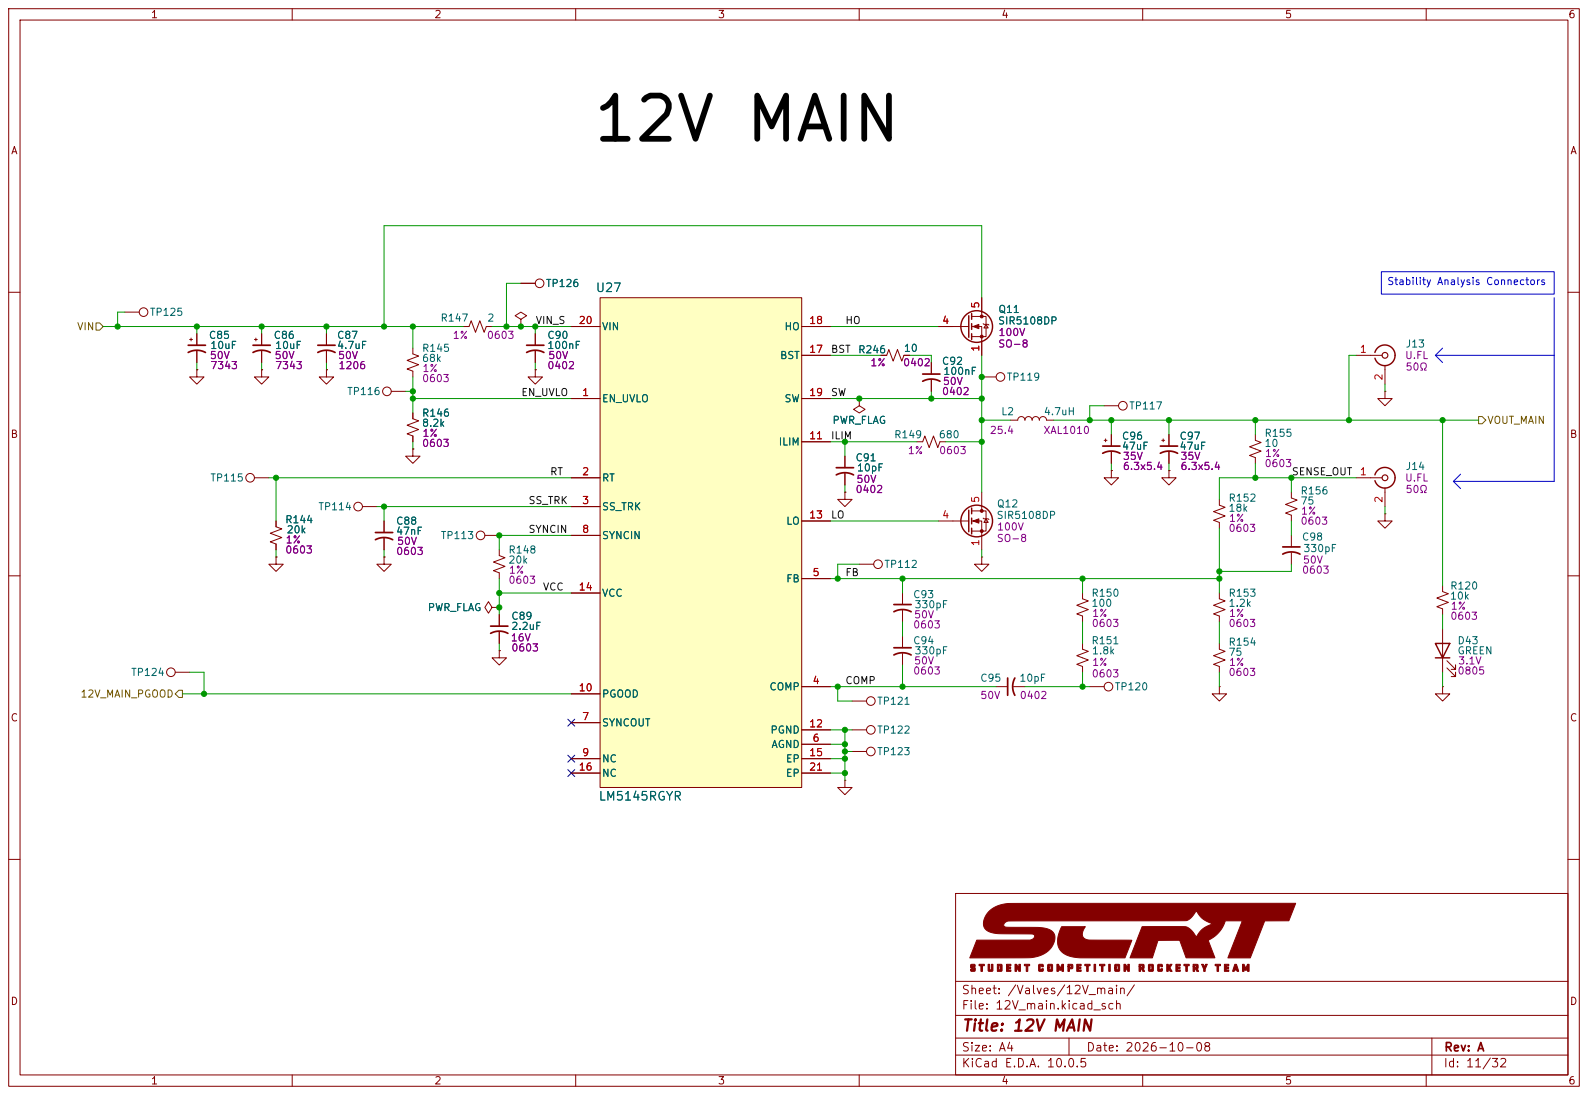
[picture p89: page 11]

Stability Analysis Connectors 12V MAIN


Fault blanking: 22ms Output rise time: 0.46V/ms For 24V rail UVLO: 21.8V OVLO: 25.4V R1 = 1M, R2 = 8.2k, R3 = 49.9k UVLO: 11V OVLO: 13.6V

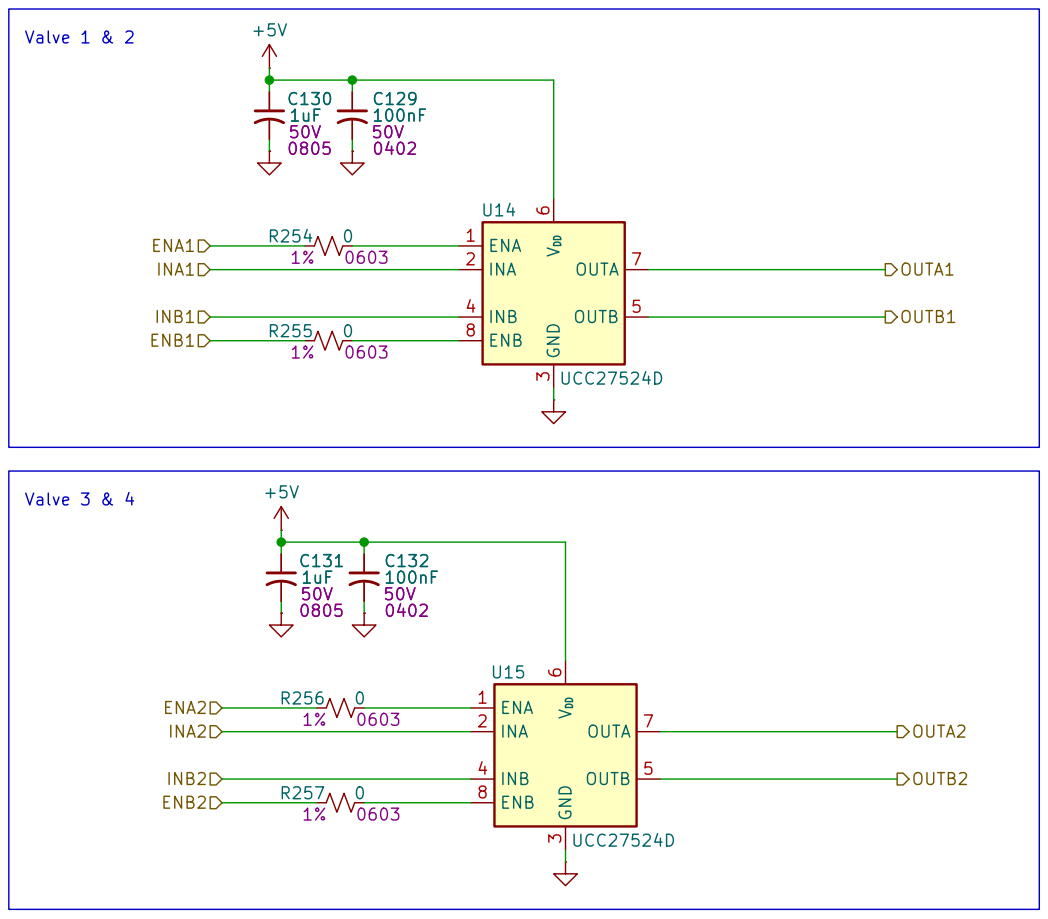
[picture p90: page 13]

Sheet: /Valves/Gate Drivers/
File: gate_driver.kicad_sch
Title: Gate Drivers

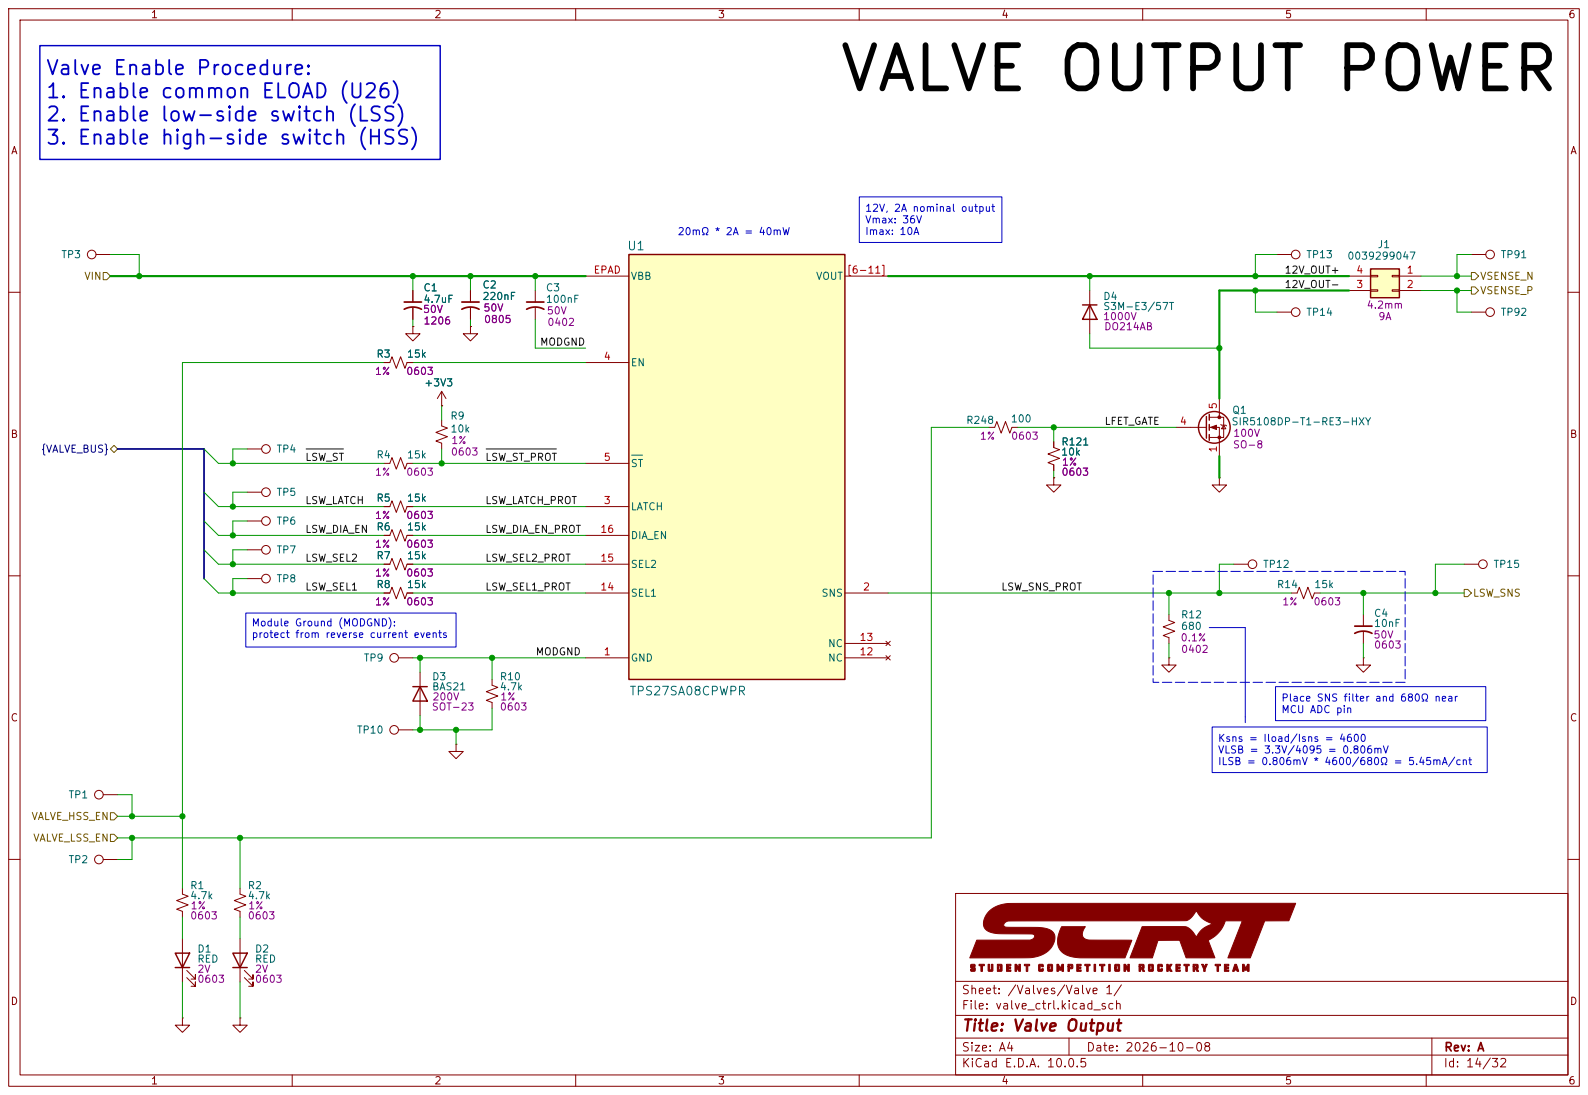
[picture p91: page 14]

Imax: 10A Valve Enable Procedure:
1. Enable common ELOAD (U26)
2. Enable low-side switch (LSS)
3. Enable high-side switch (HSS)

Place SNS filter and 680Ω near MCU ADC pin Ksns = Iload/Isns = 4600

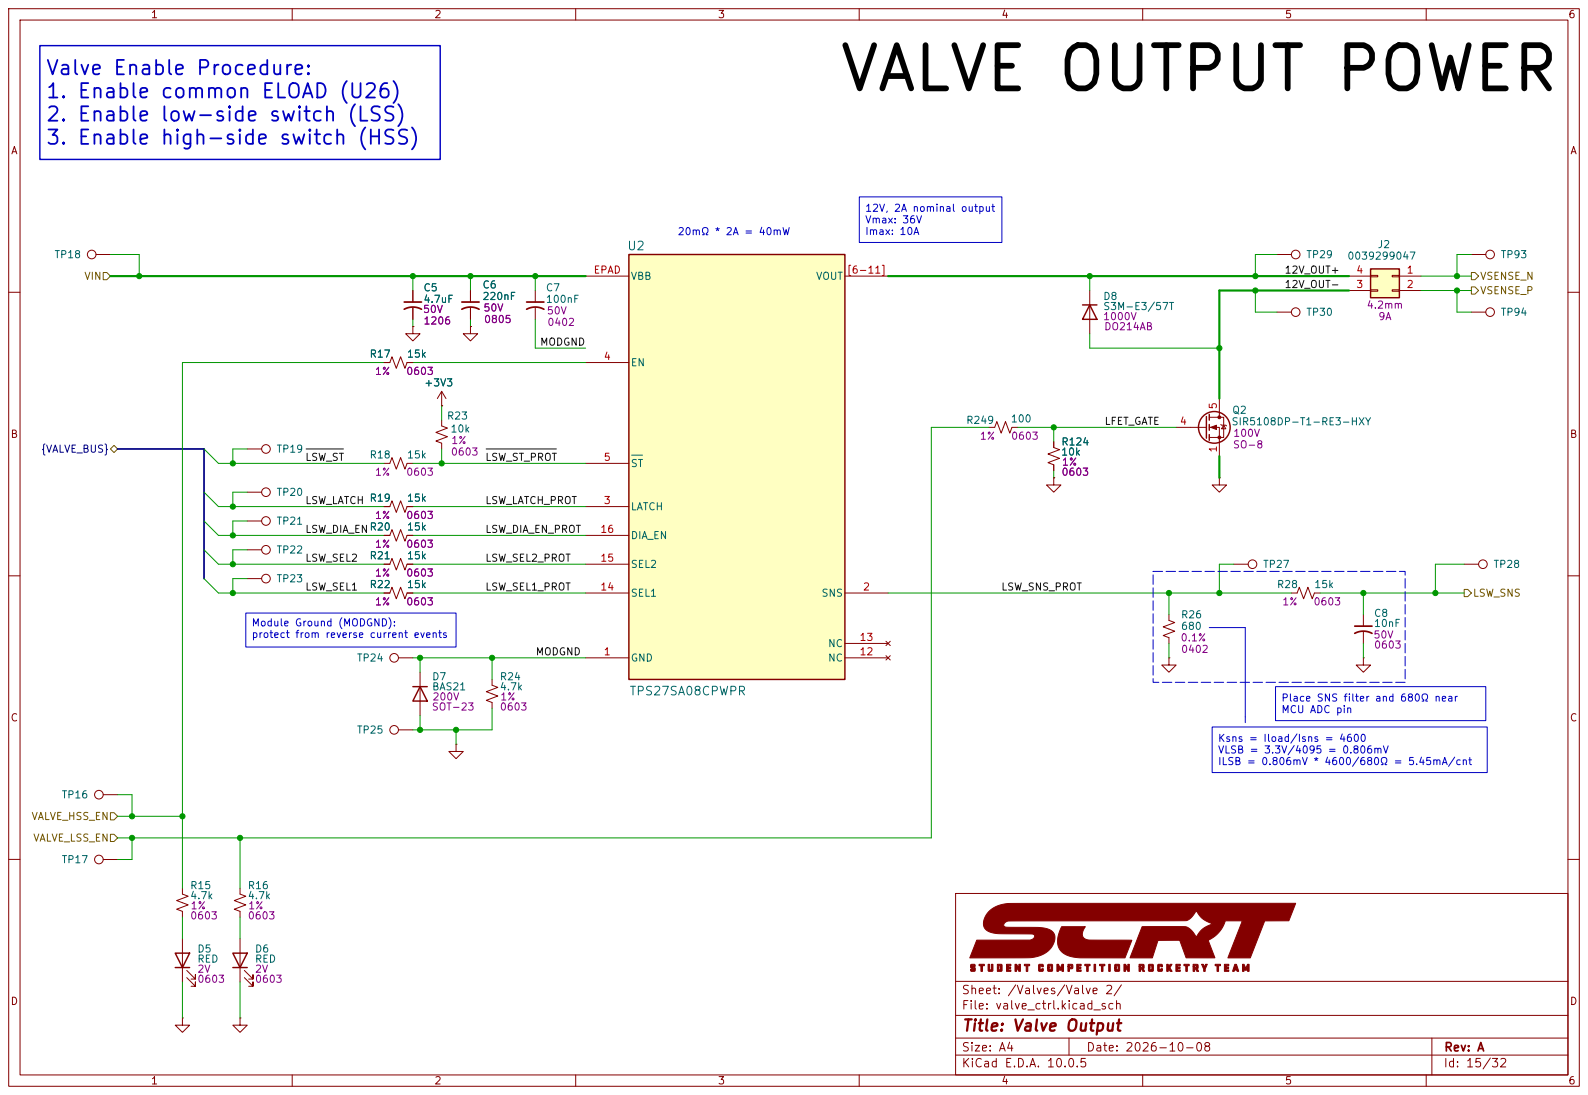
[picture p92: page 15]

LSW_ST Valve Enable Procedure:
1. Enable common ELOAD (U26)
2. Enable low-side switch (LSS)
3. Enable high-side switch (HSS)

Imax: 10A Module Ground (MODGND):

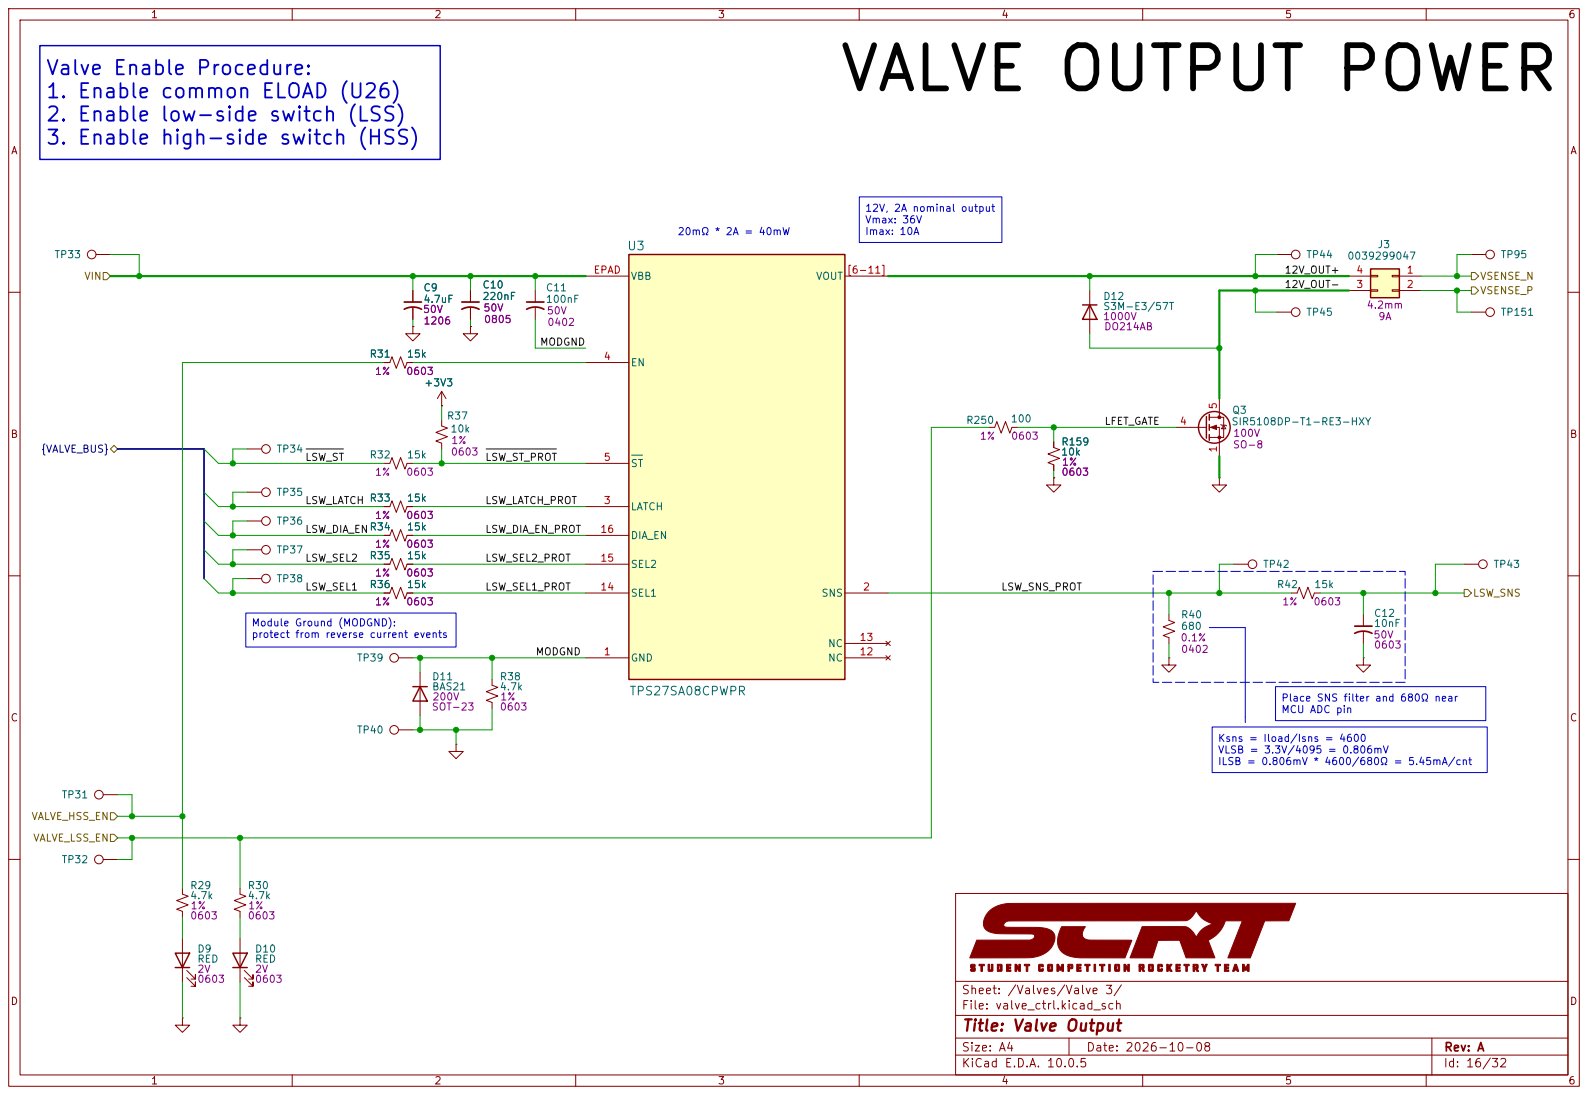
[picture p93: page 16]
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

ILSB = 0.806mV * 4600/680Ω = 5.45mA/cnt Module Ground (MODGND):

Place SNS filter and 680Ω near MCU ADC pin

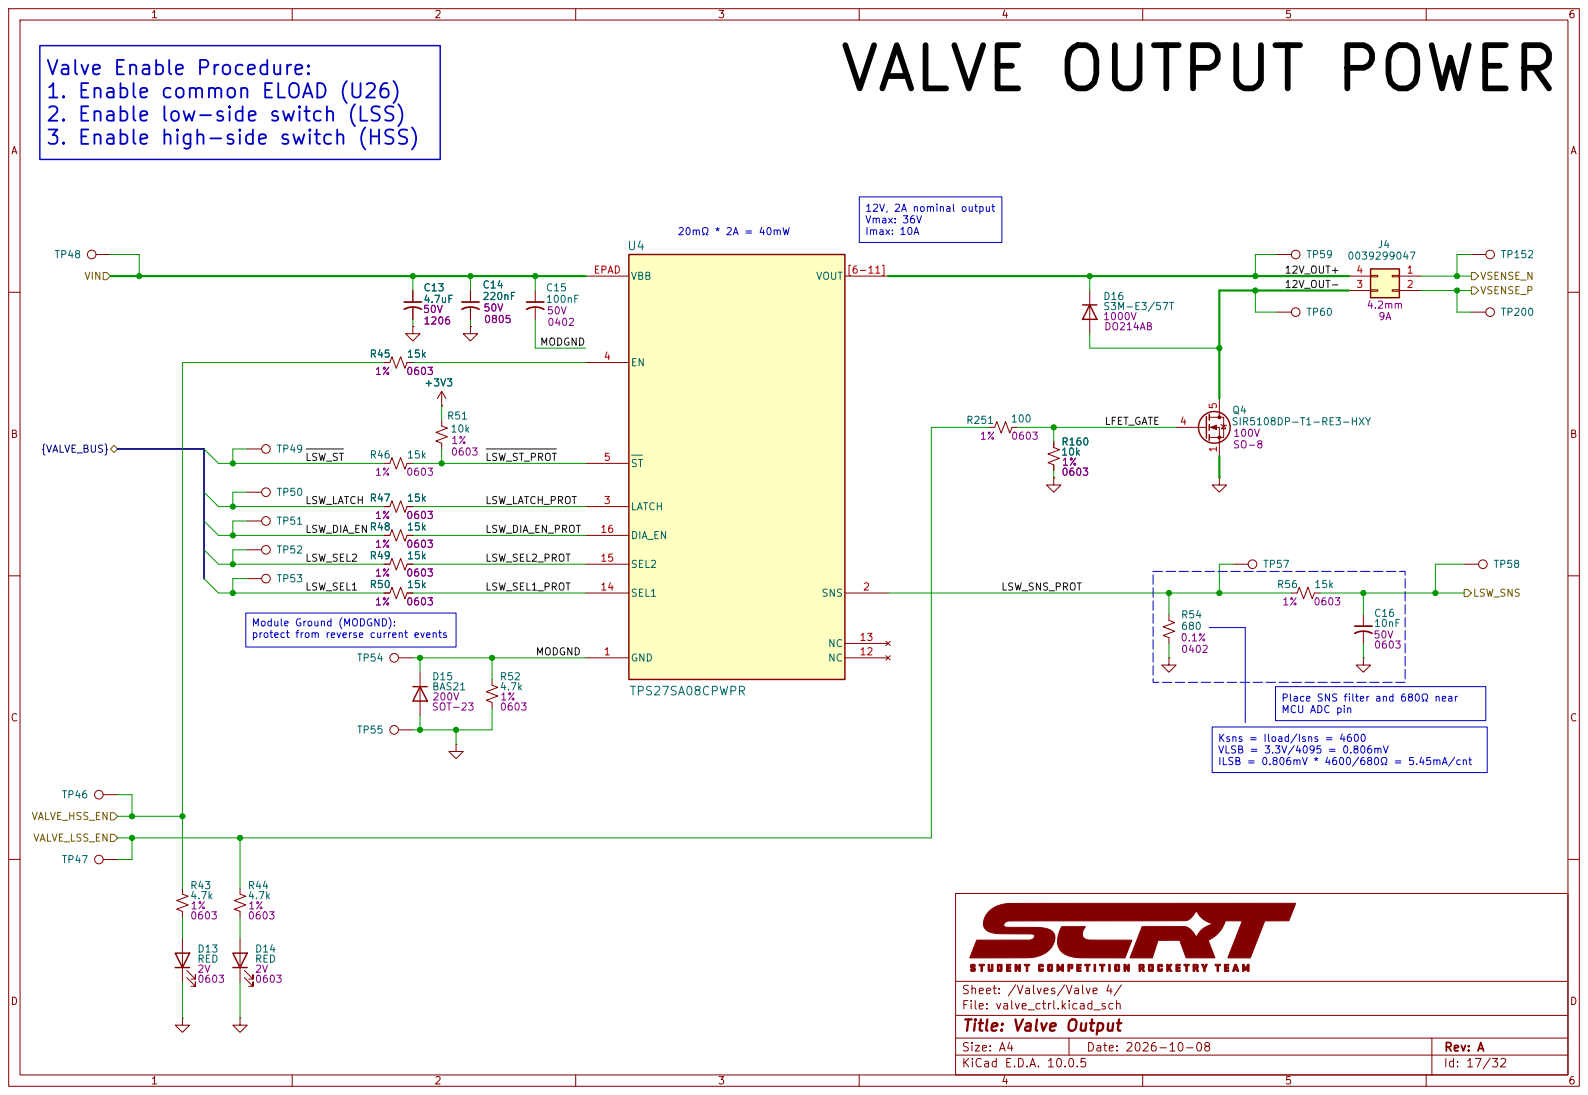
[picture p94: page 17]
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

ILSB = 0.806mV * 4600/680Ω = 5.45mA/cnt Module Ground (MODGND):

Place SNS filter and 680Ω near MCU ADC pin

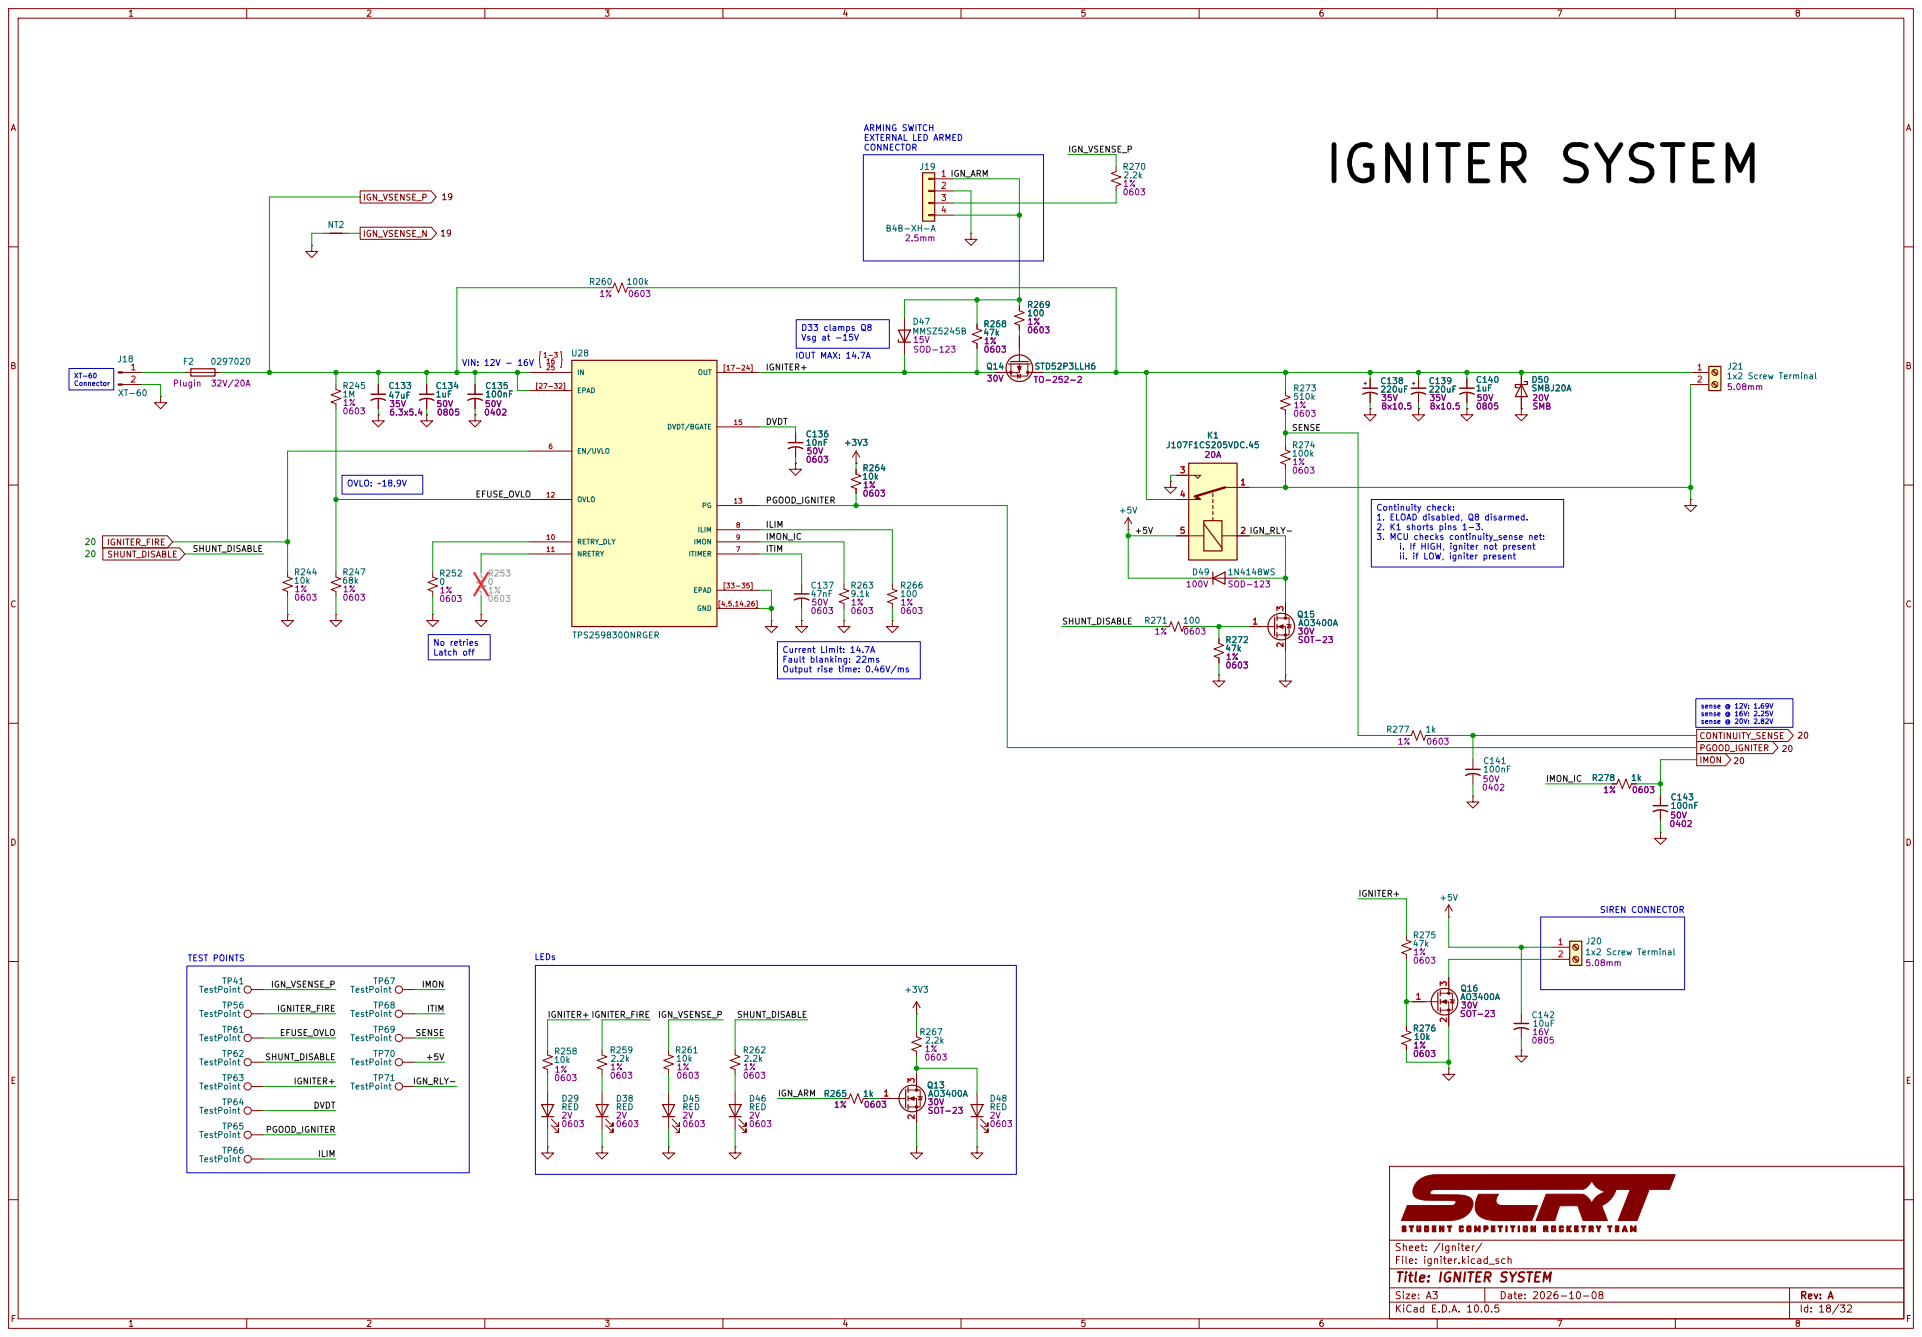
[picture p95: page 18]

ILIM
IMON_IC
ITIM
ii. if LOW, igniter present Current Limit: 14.7A

i. If HIGH, igniter not present

Fault blanking: 22ms Output rise time: 0.46V/ms

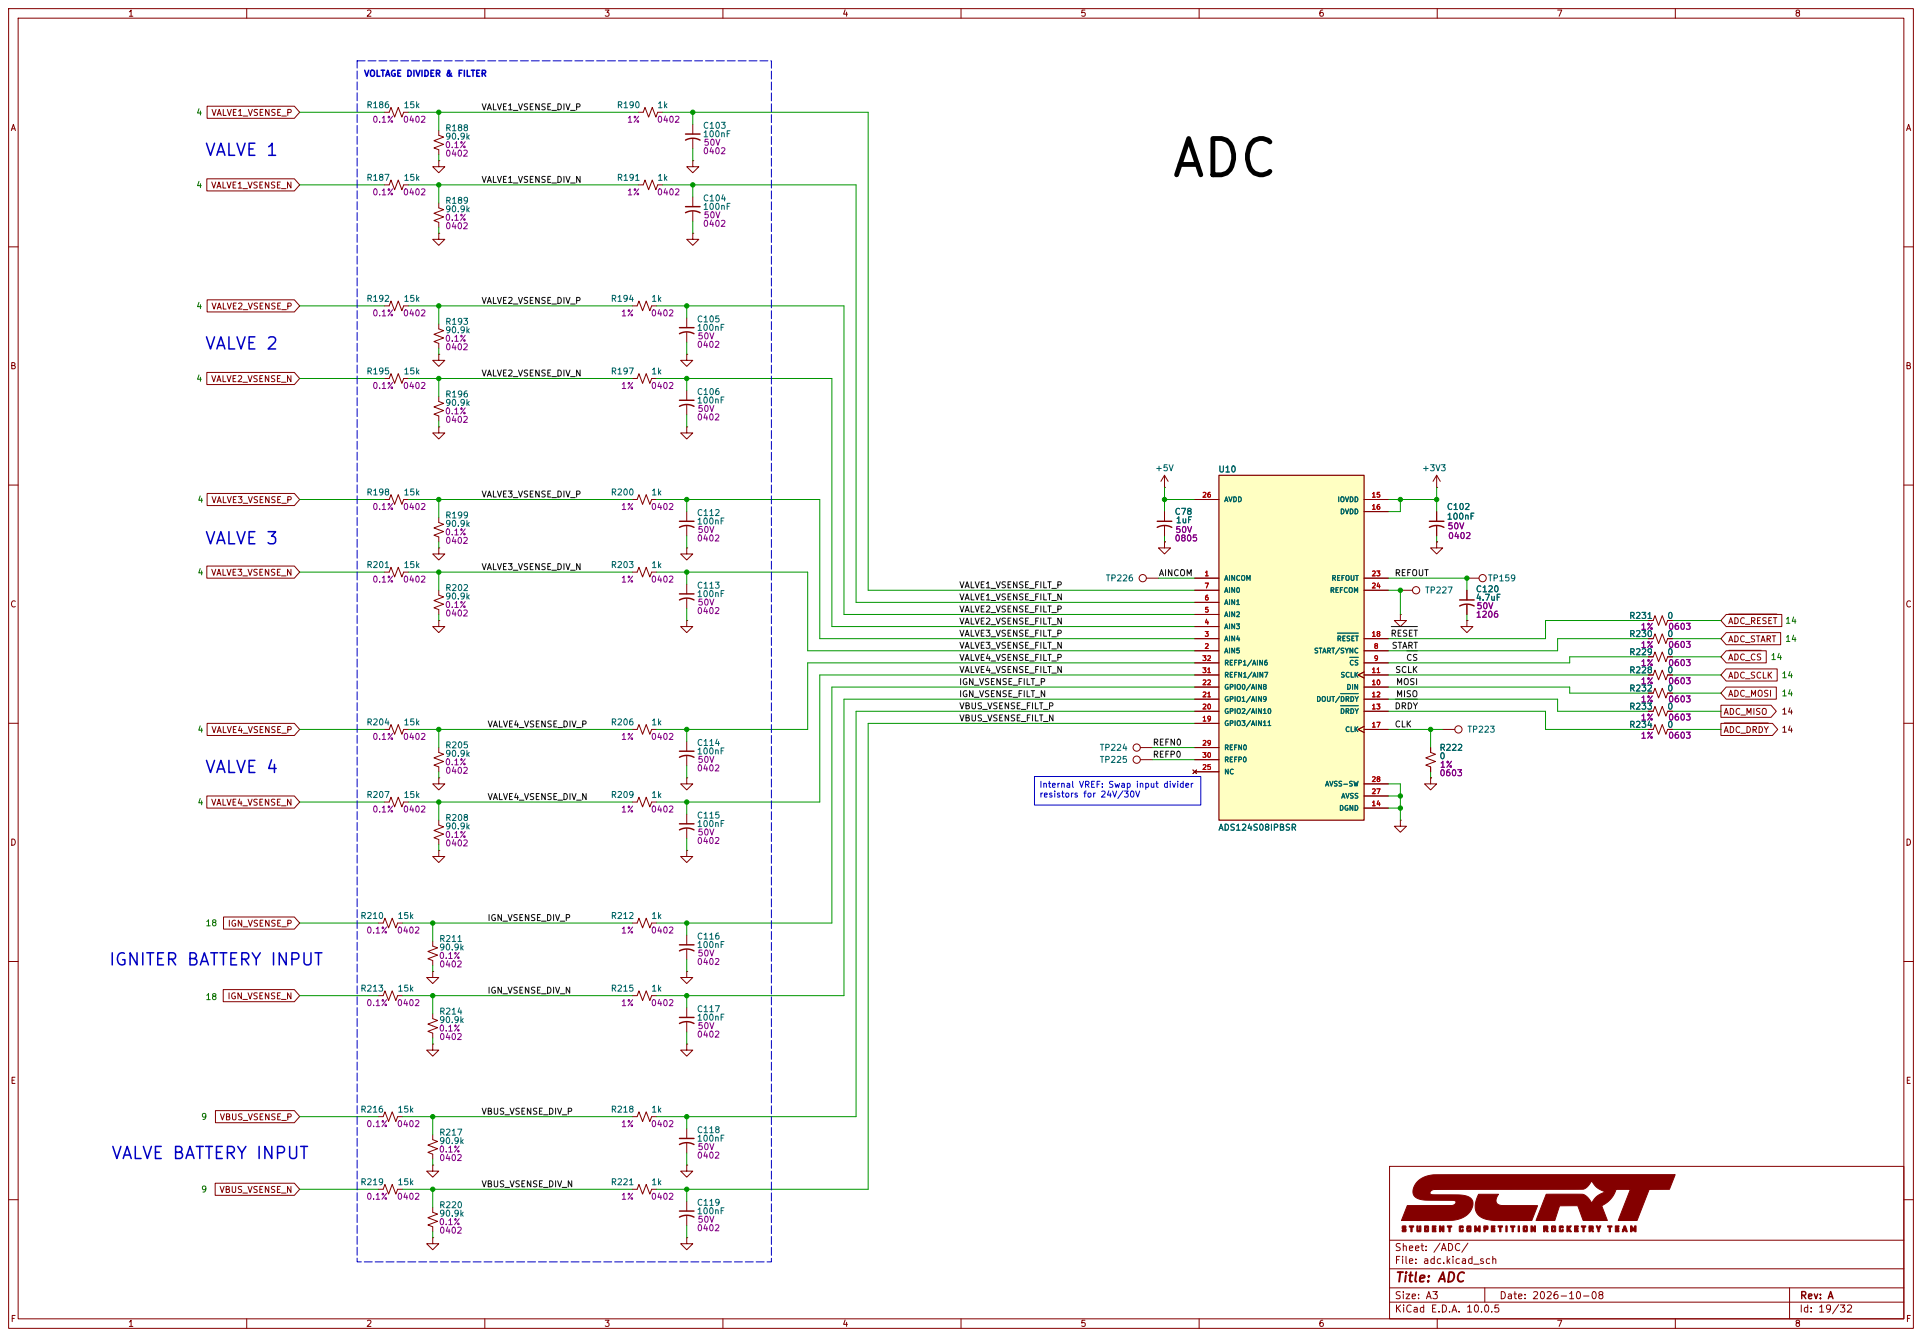
[picture p96: page 19]

DRDY SCLK MISO MOSI CS

Internal VREF: Swap input divider
resistors for 24V/30V


1 DO/IO1 2 WP/IO2 3 GND 4 DI/IO0 5 CLK

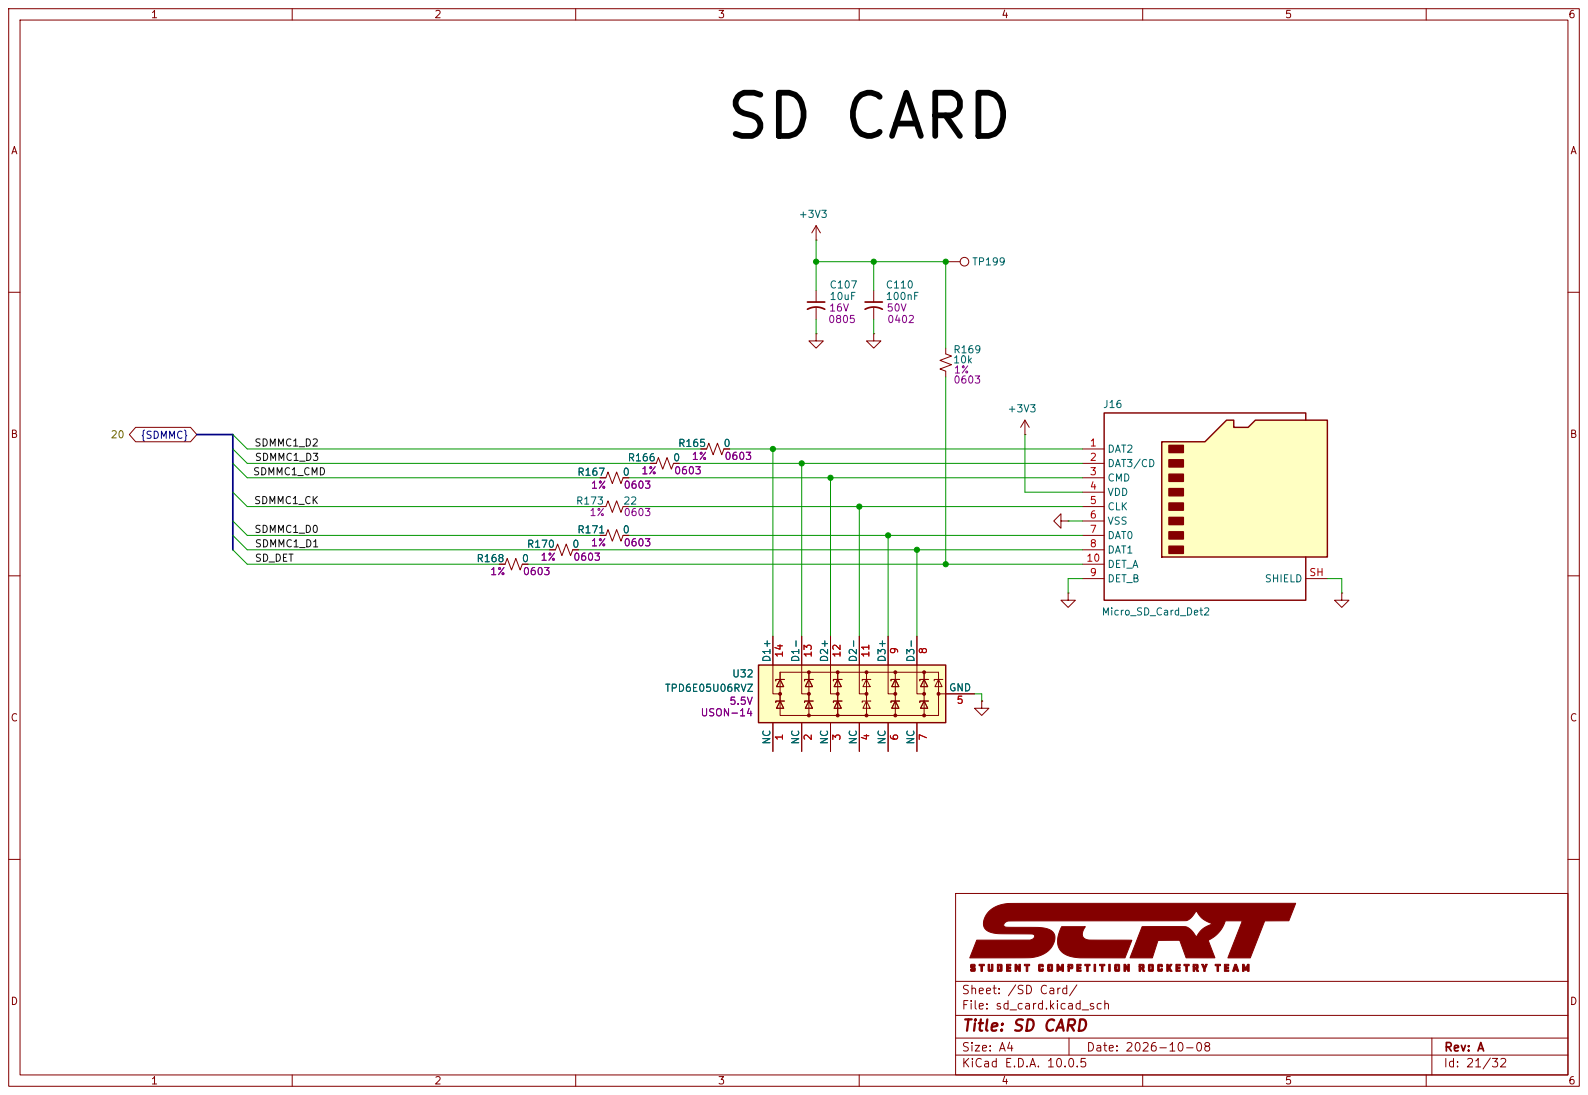
[picture p97: page 21]

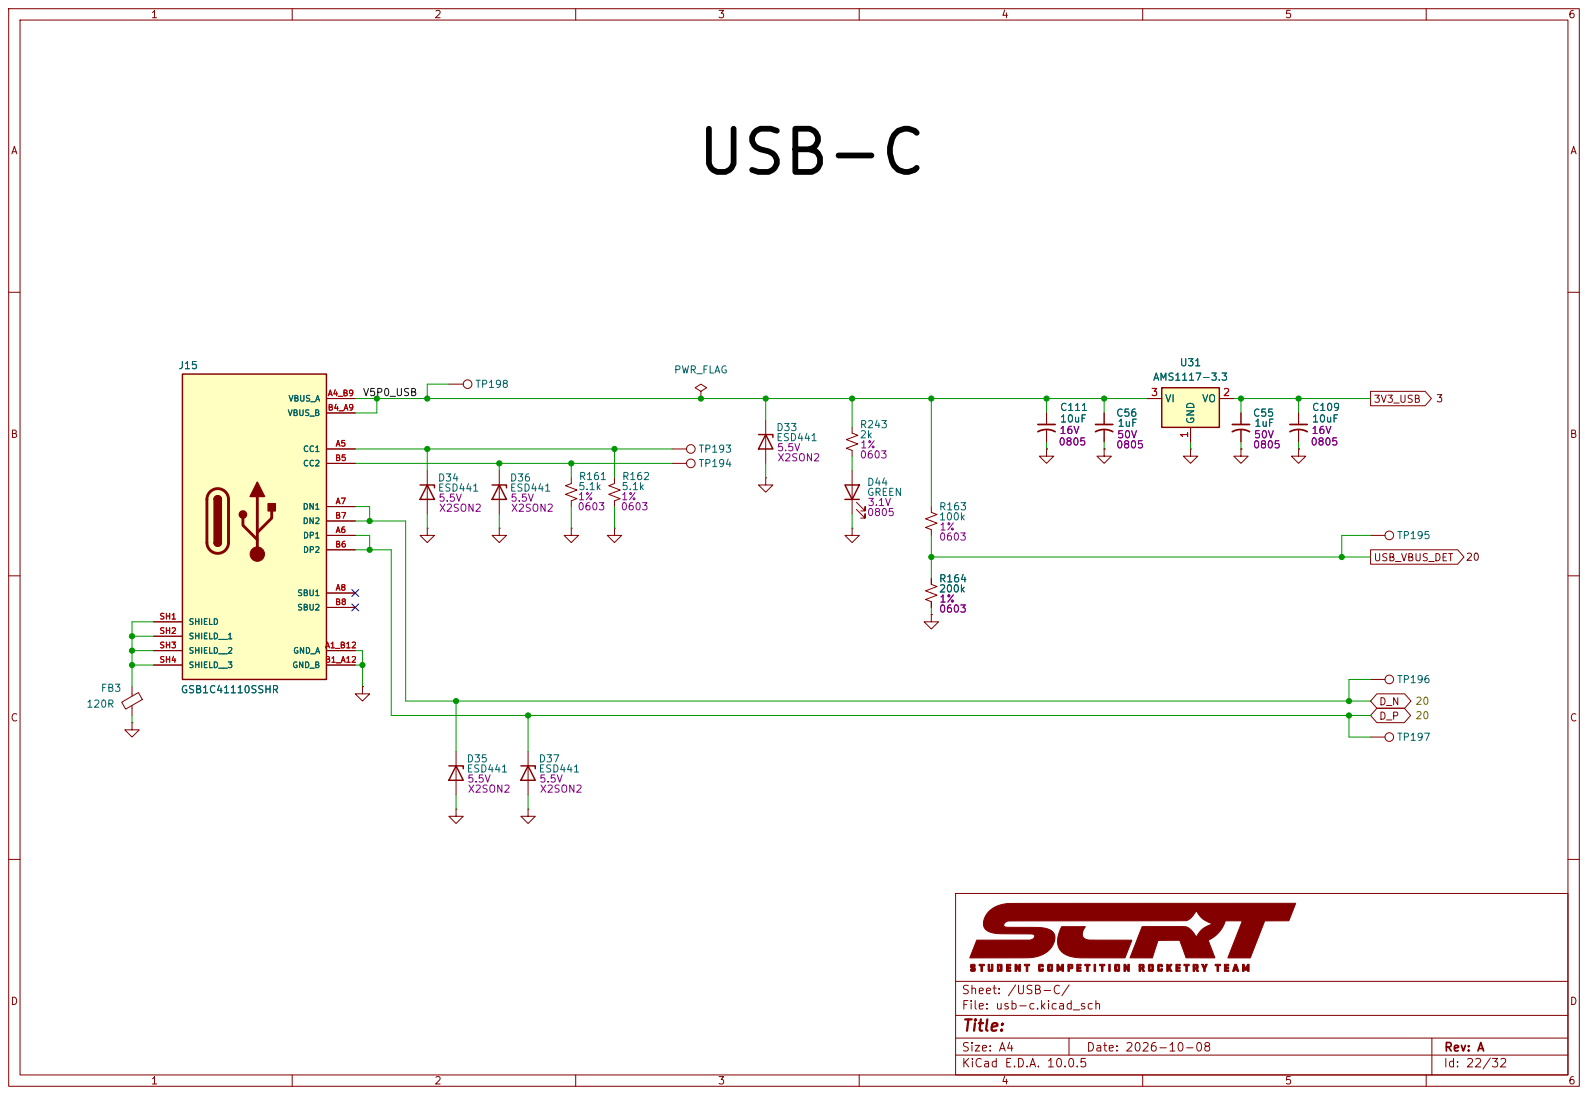
[picture p98: page 22]

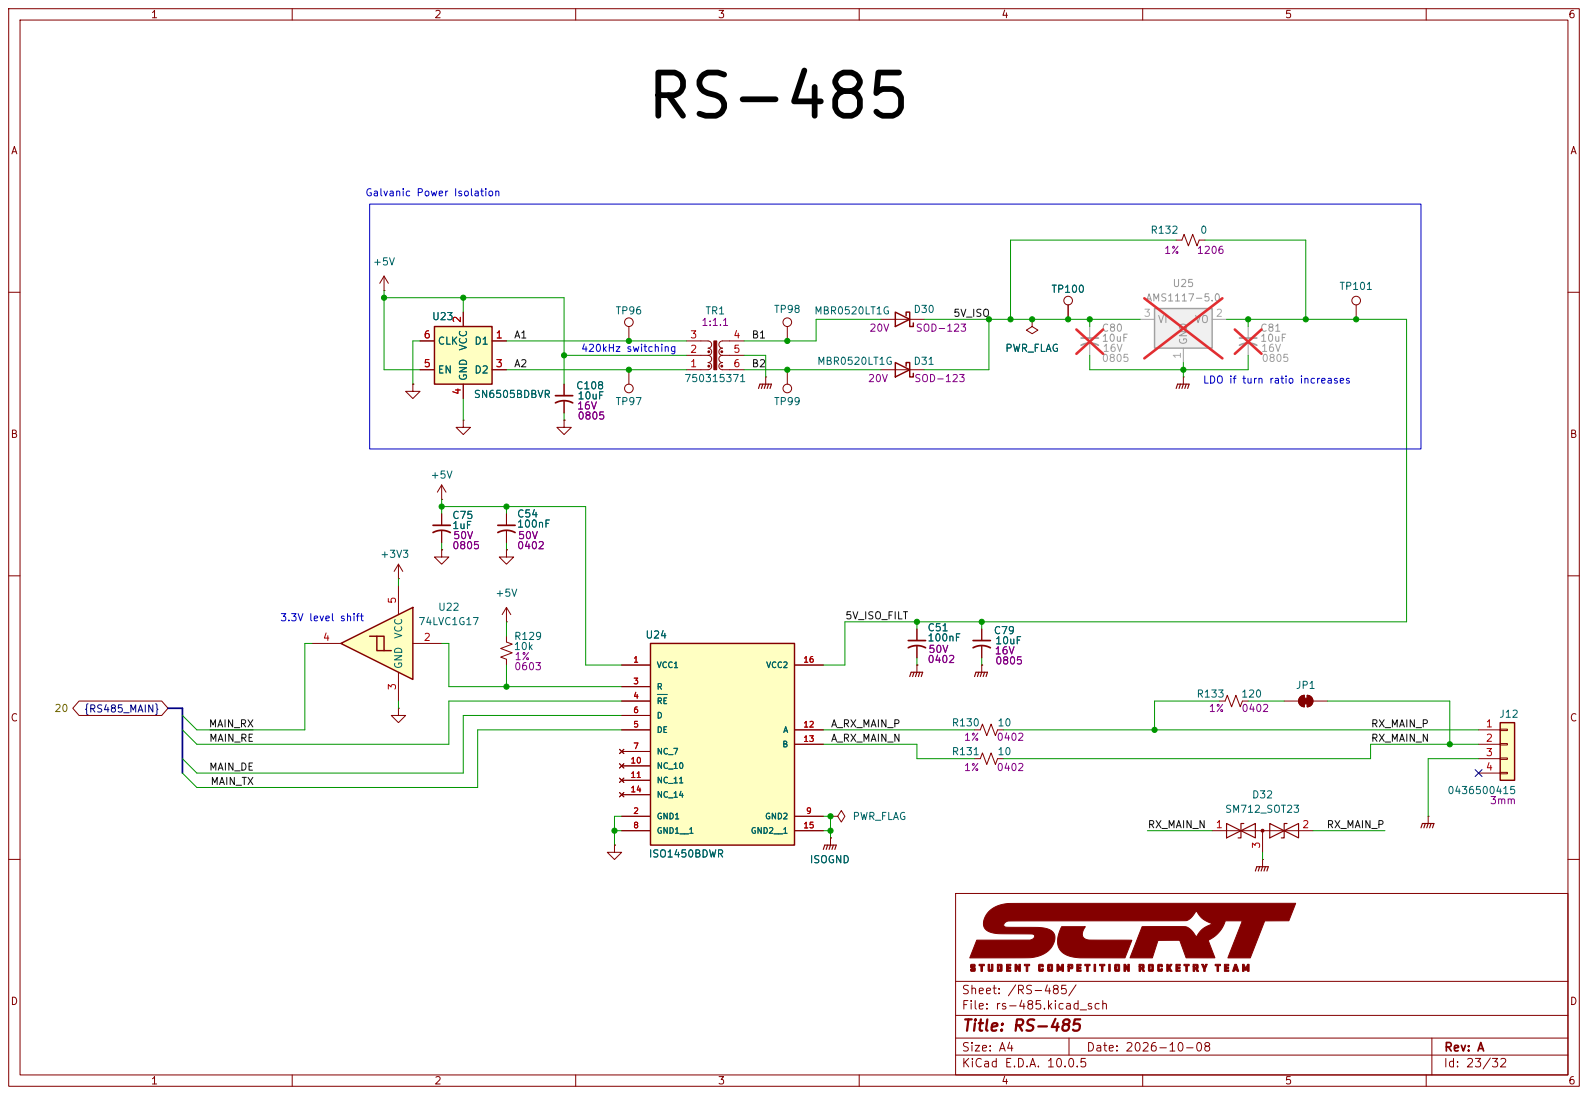
[picture p99: page 23]


BUS CONV. AND EFUSE 20
TEMP_ALERT3







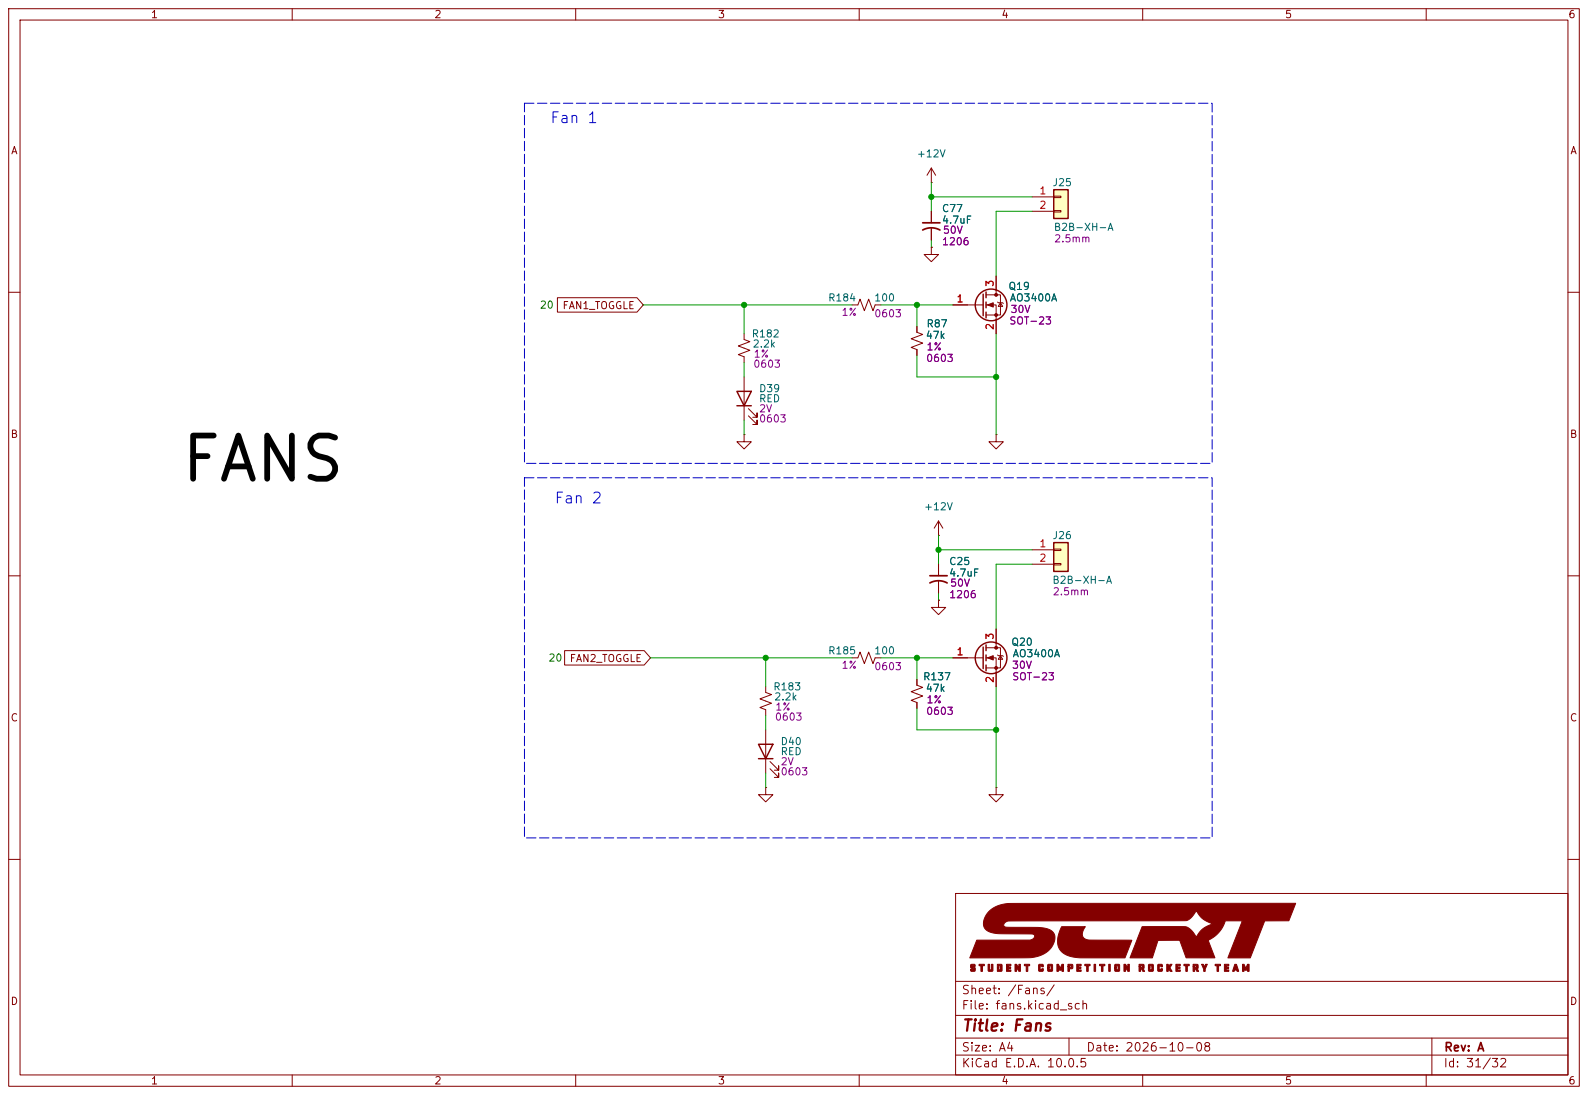
[picture p100: page 31]

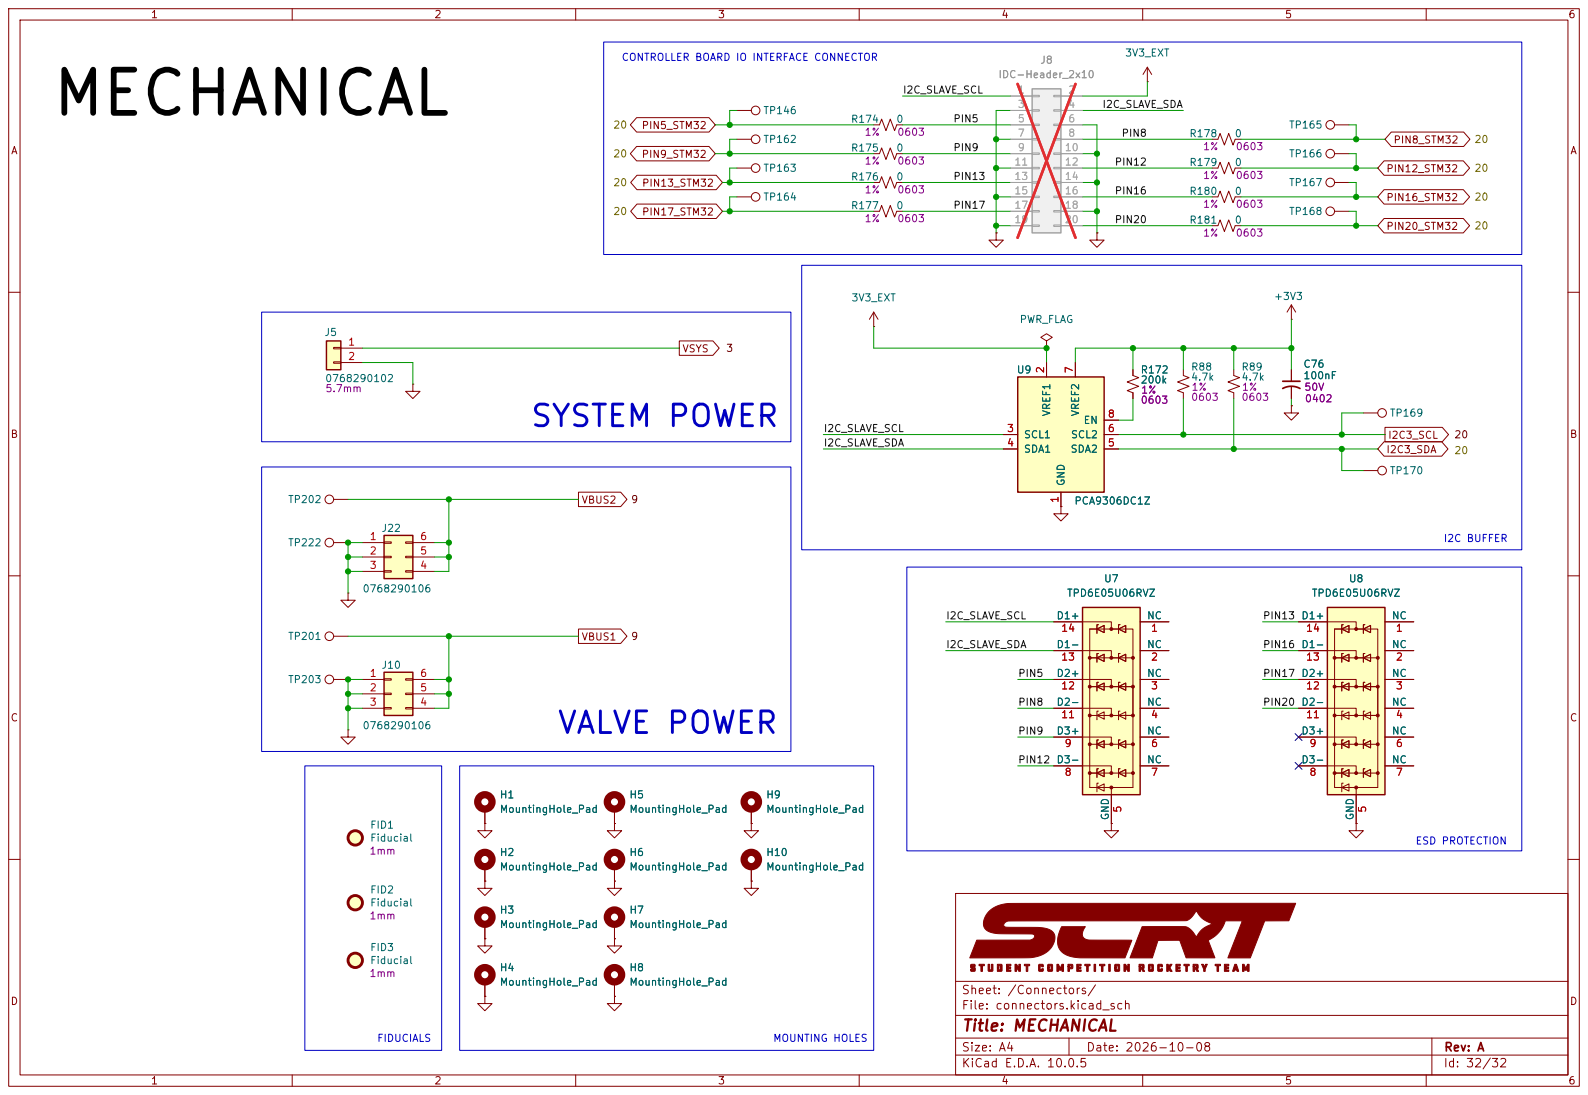
[picture p101: page 32]

20 CONTROLLER BOARD IO INTERFACE CONNECTOR
