Ground-Support-Equipment-SCRT/Pad-Side-Systems/LRUs/Valve Control Unit/Electrical/Valve Power Board/valve_control_pcb/connectors.pdf

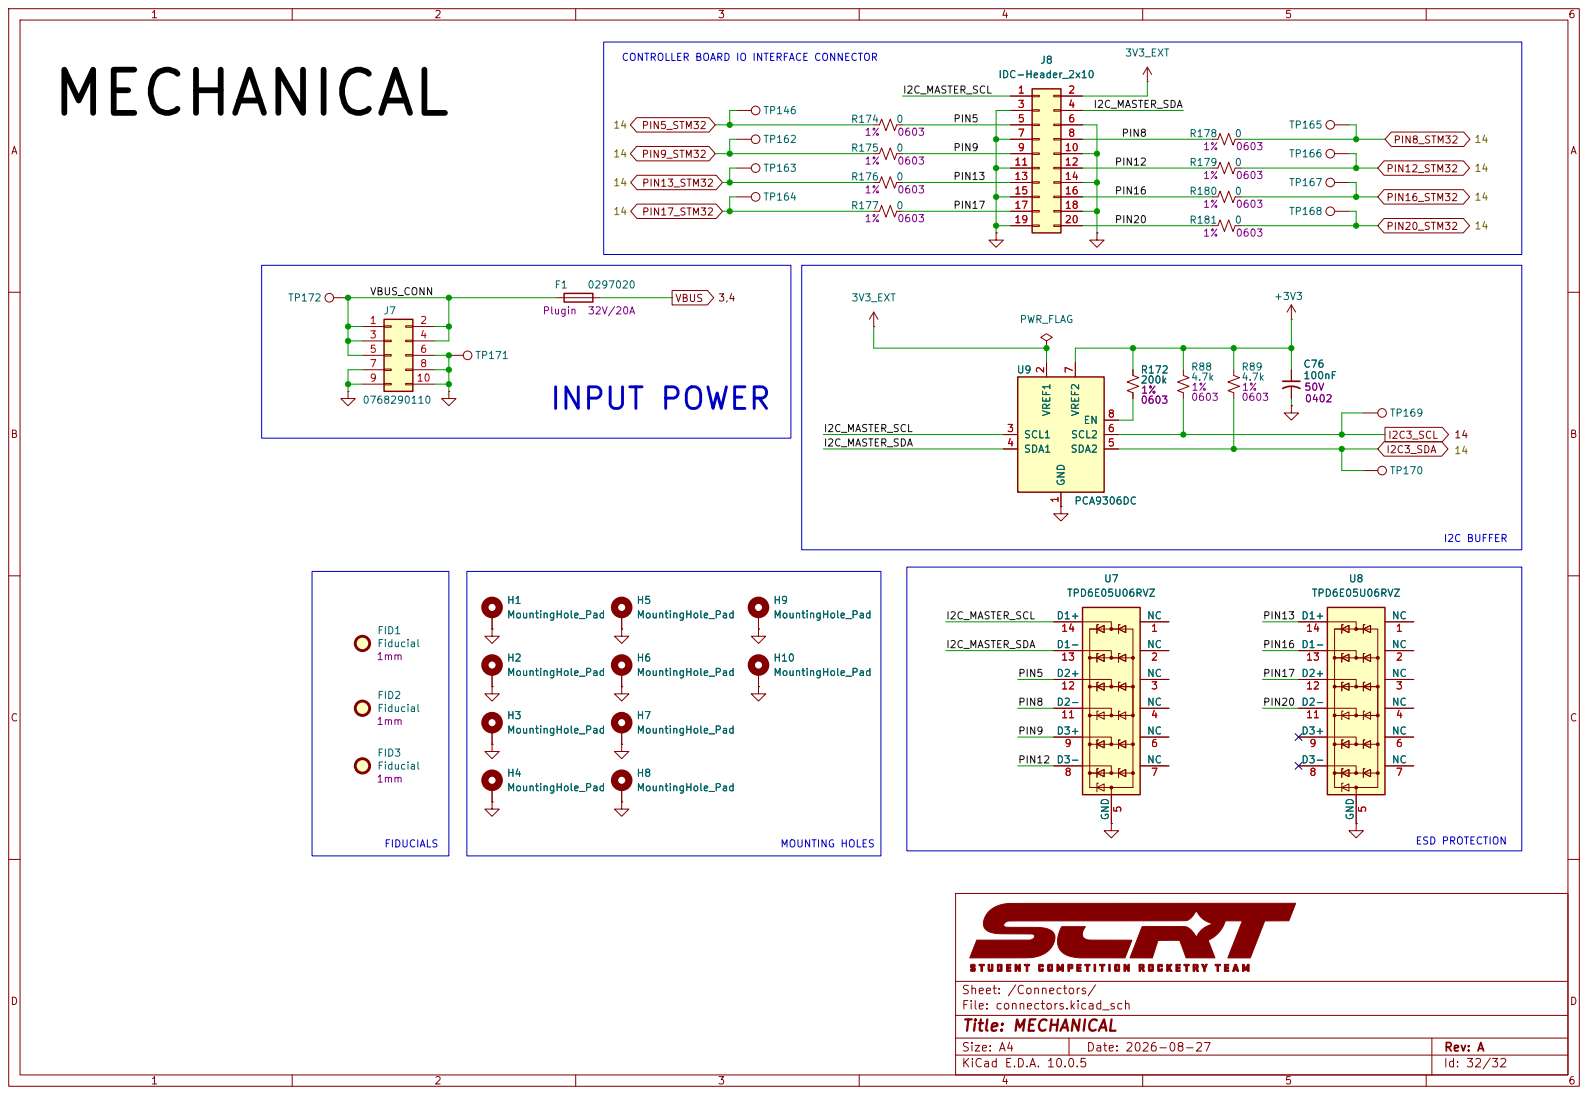
[picture p102: page 1]

CONTROLLER BOARD IO INTERFACE CONNECTOR INPUT POWER

Size: A4 | Rev: A
KiCad E.D.A. 10.0.5 | Id: 32/32
