Ground-Support-Equipment-SCRT/Pad-Side-Systems/LRUs/Pad Control Unit/Electrical/Main Controller Board/KICAD PROJECT/master_gse_pcb_project/title_page.pdf

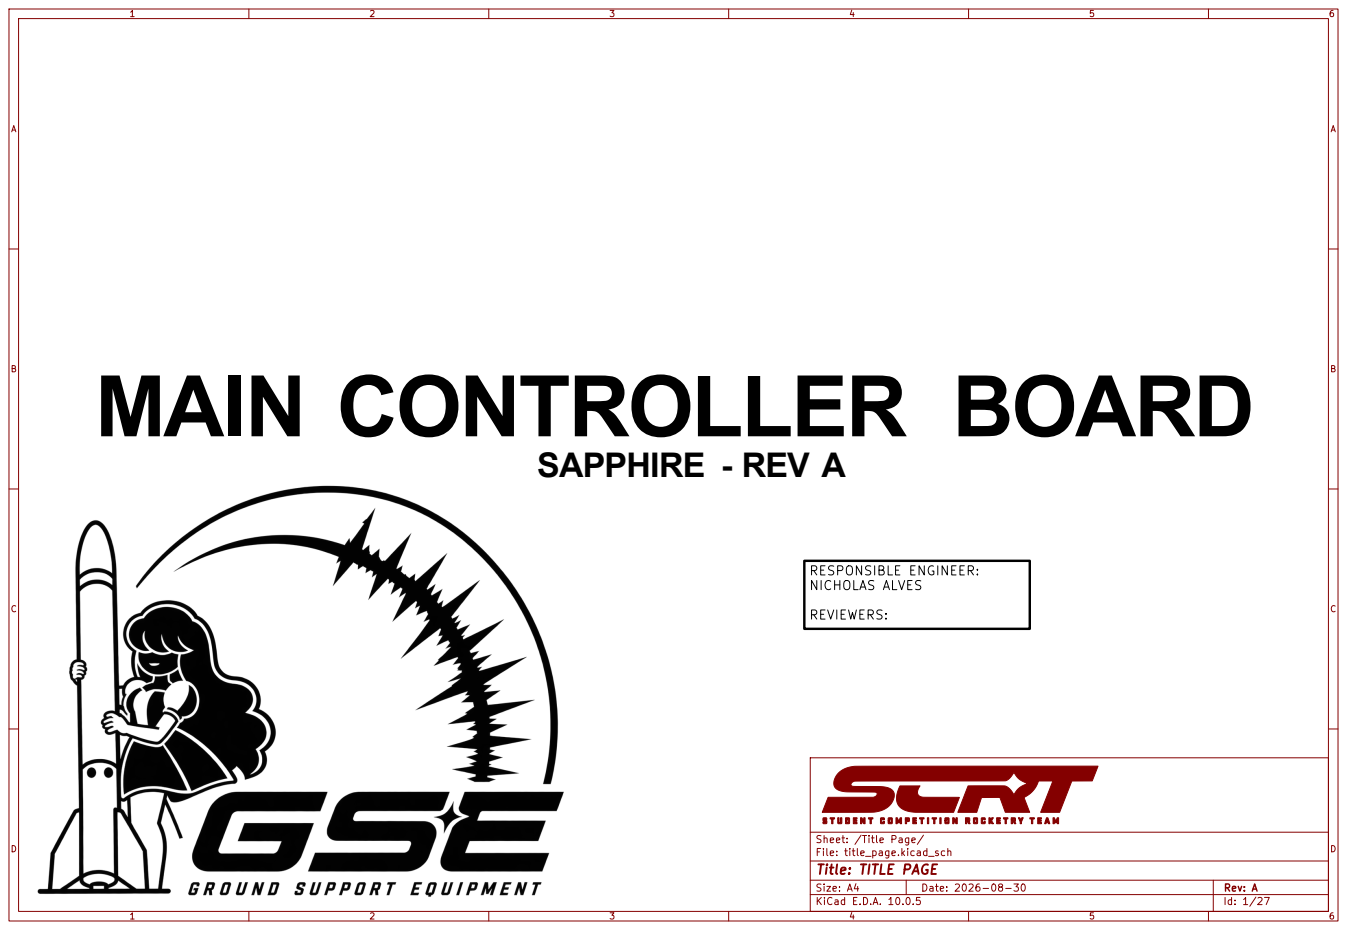
[picture p103: page 1]

Size: A4 | Rev: A
KiCad E.D.A. 10.0.5 | Id: 1/27

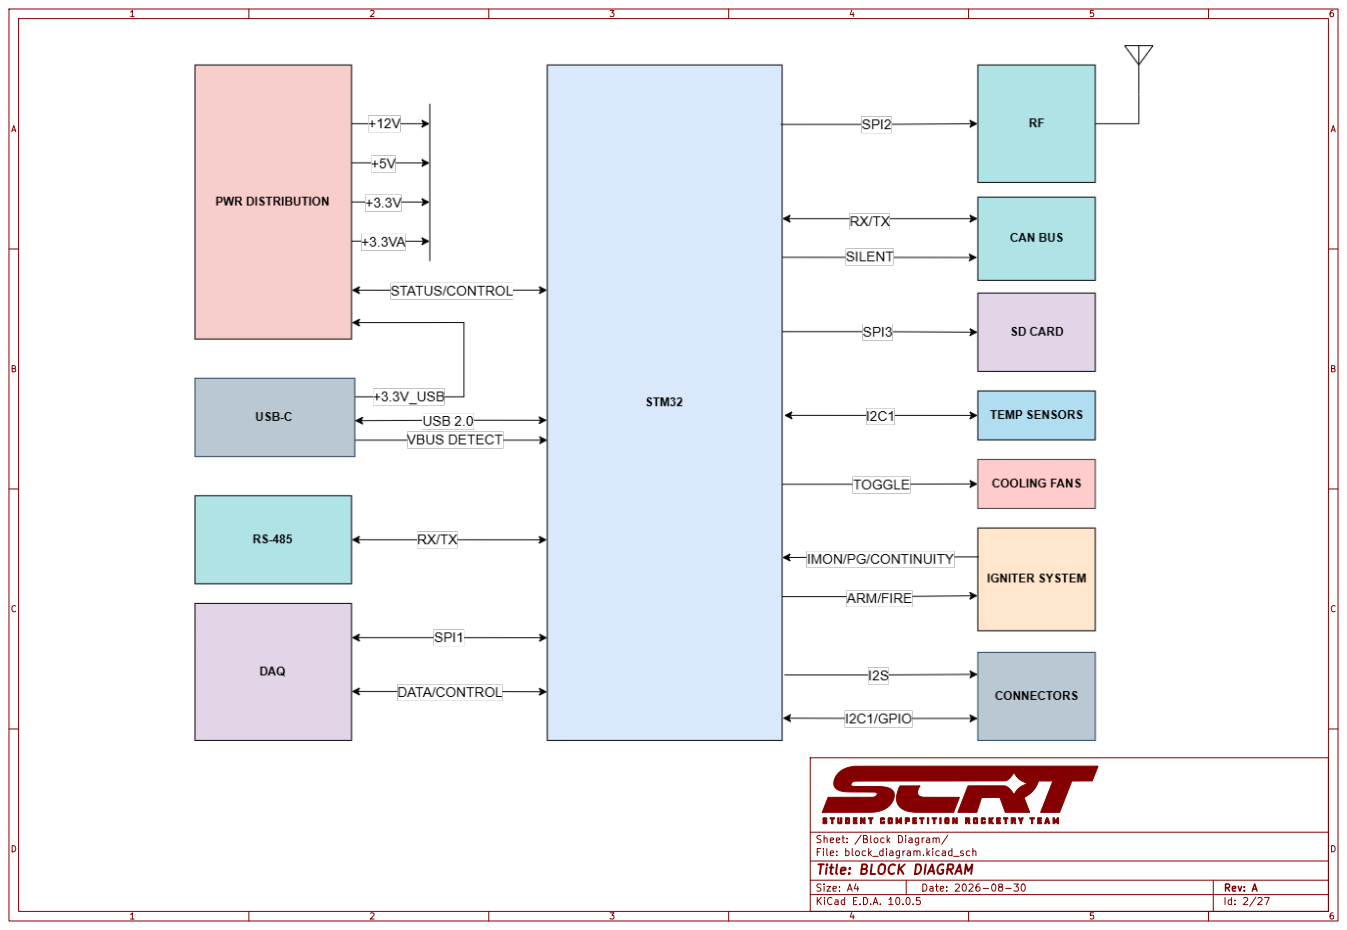
[picture p104: page 2]

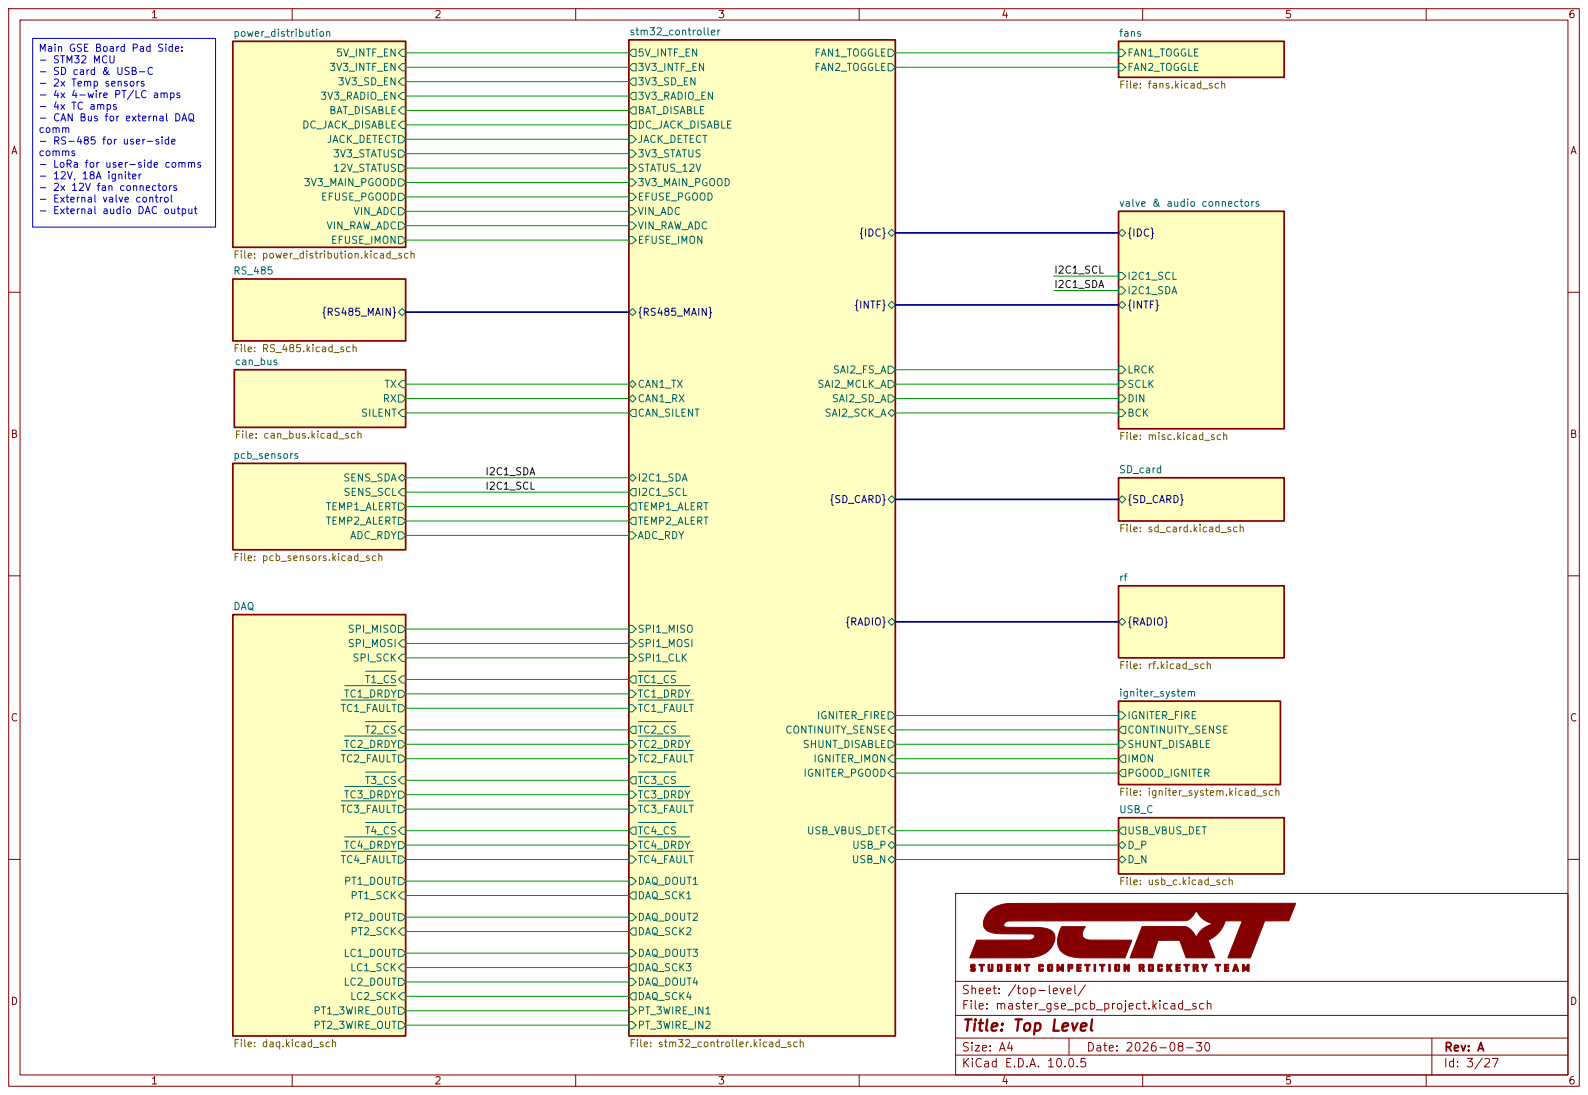
[picture p105: page 3]

I2C1_SCL Main GSE Board Pad Side: - STM32 MCU - SD card & USB-C - 2x Temp sensors - 4x 4-wire PT/LC amps - 4x TC amps - CAN Bus for external DAQ

comm
- RS-485 for user-side
comms - LoRa for user-side comms - 12V, 18A igniter - 2x 12V fan connectors - External valve control - External audio DAC output

{INTF} valve & audio connectors File: misc.kicad_sch

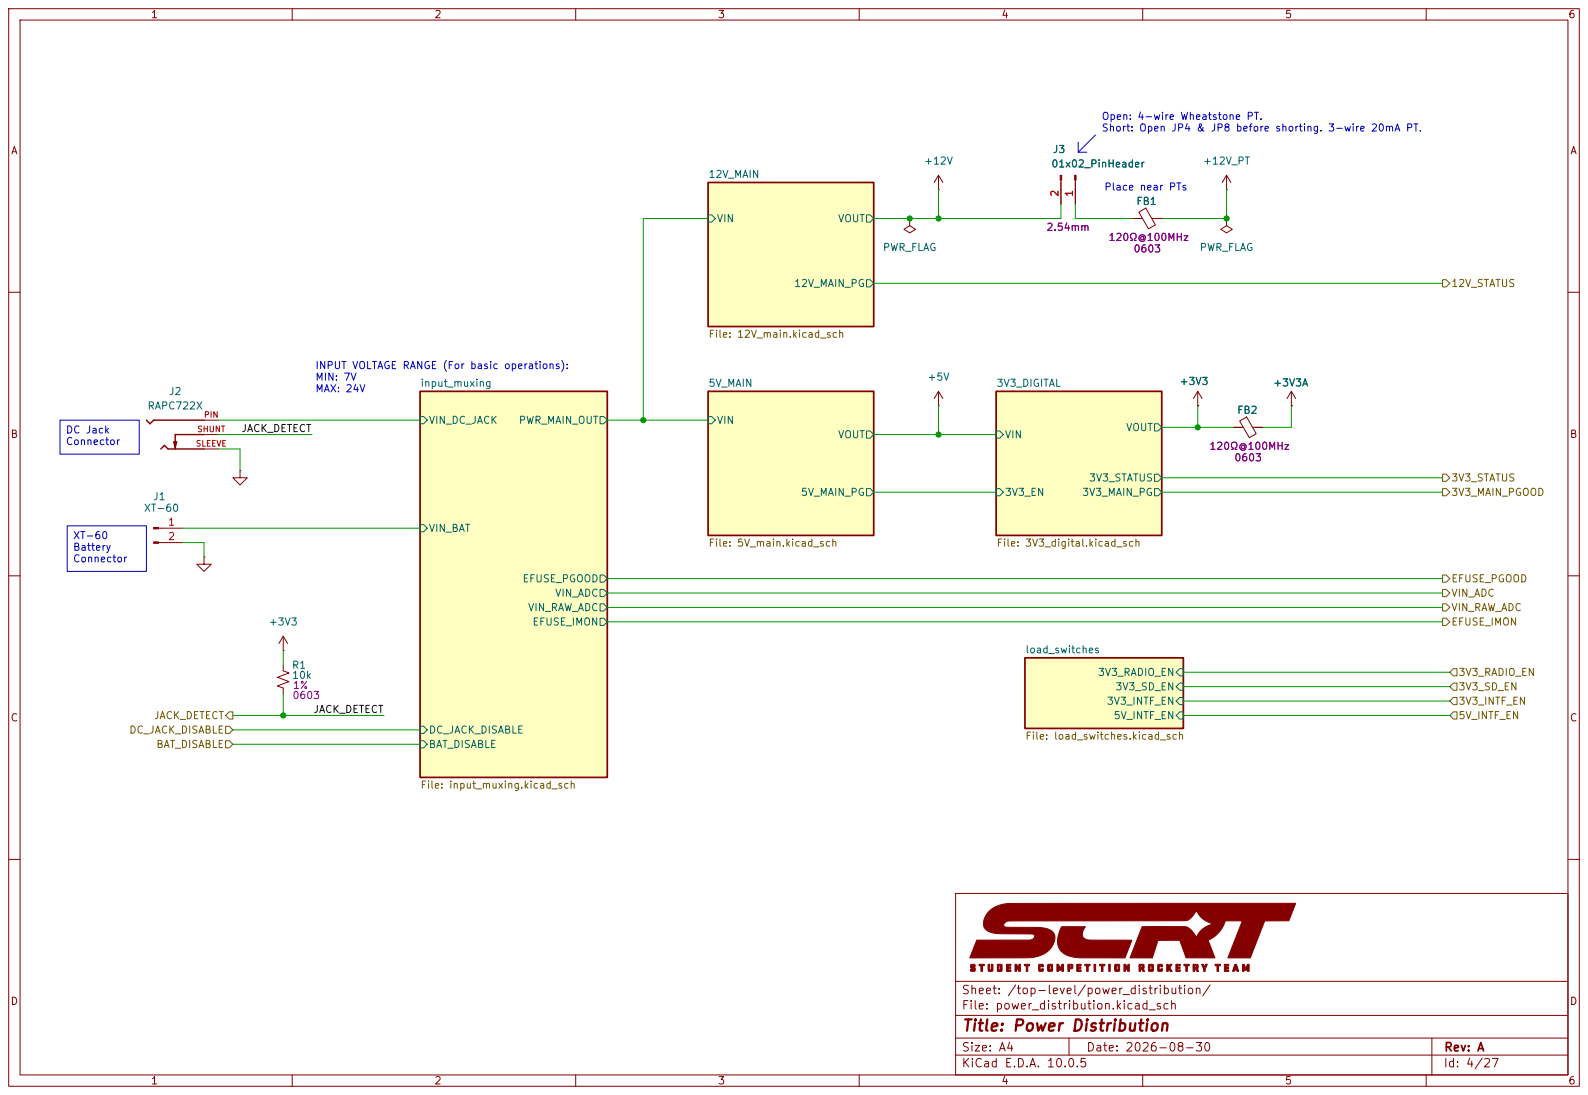
[picture p106: page 4]

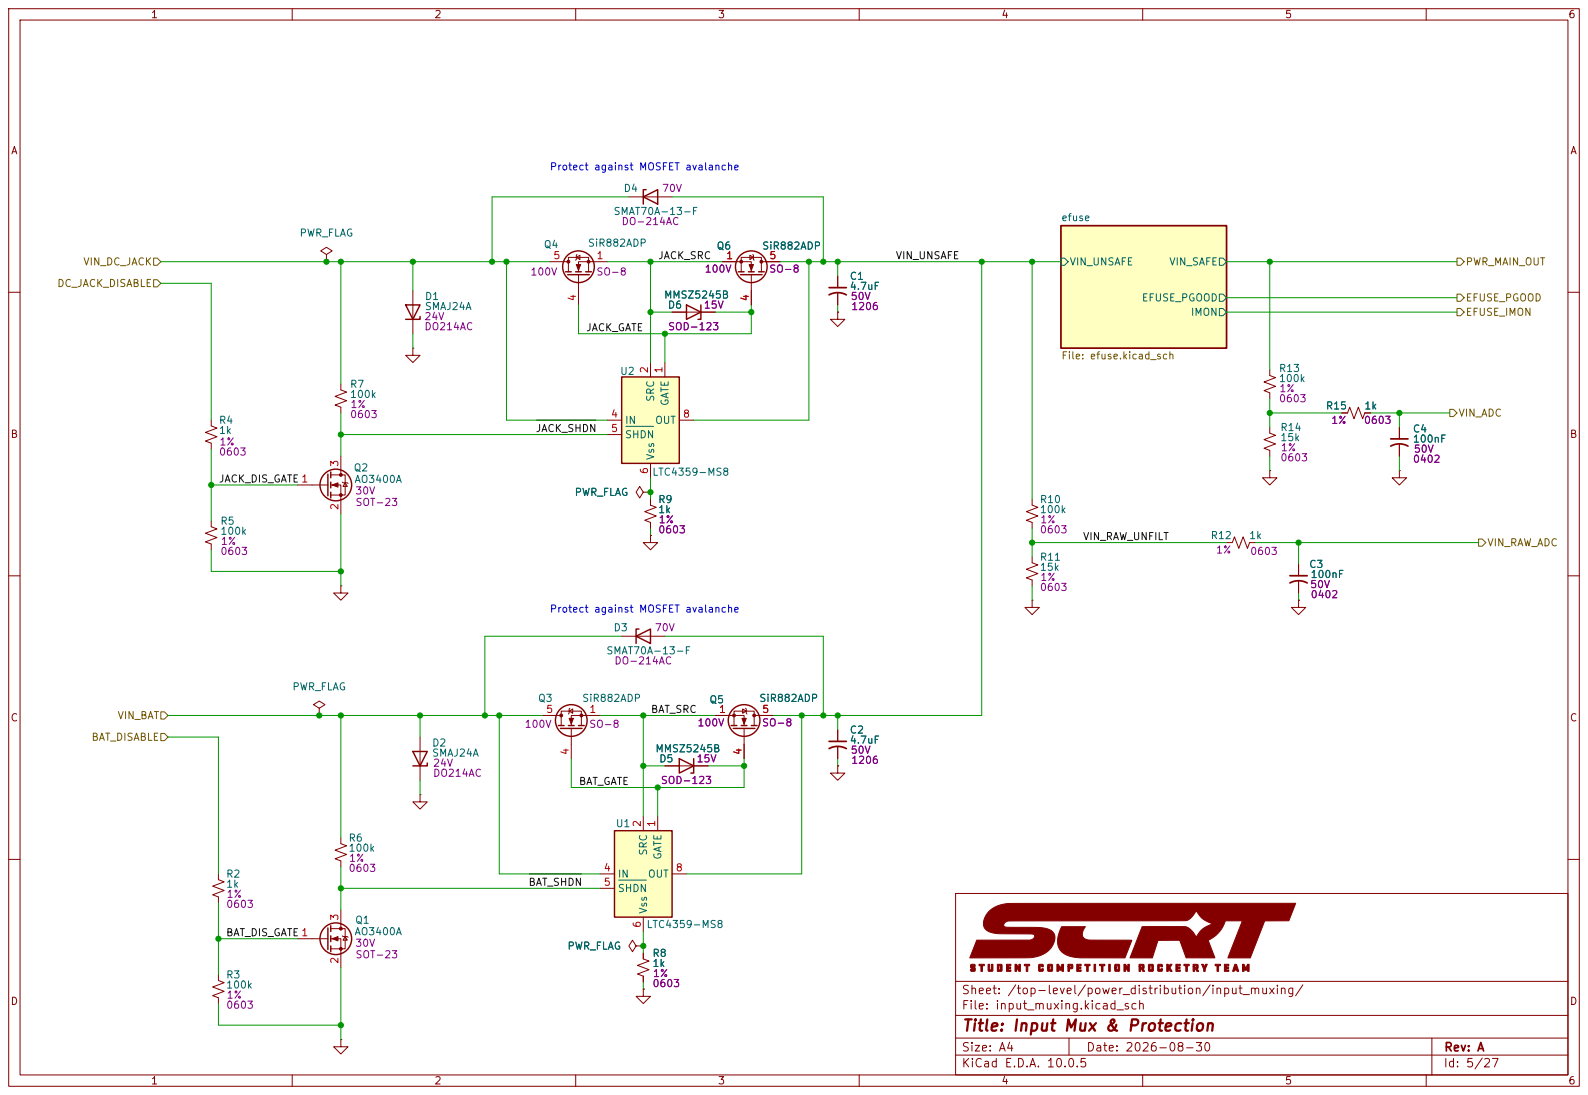
[picture p107: page 5]

Sheet: /top-level/power_distribution/input_muxing/
File: input_muxing.kicad_sch
Title: Input Mux & Protection

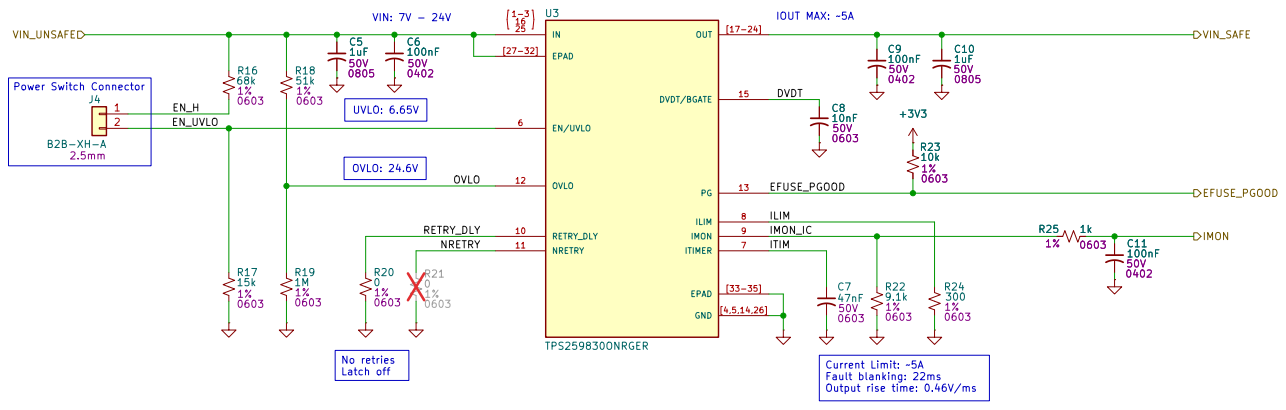
[picture p108: page 6]

Sheet: /top-level/power_distribution/input_muxing/efuse/
File: efuse.kicad_sch
Title: Input eFuse

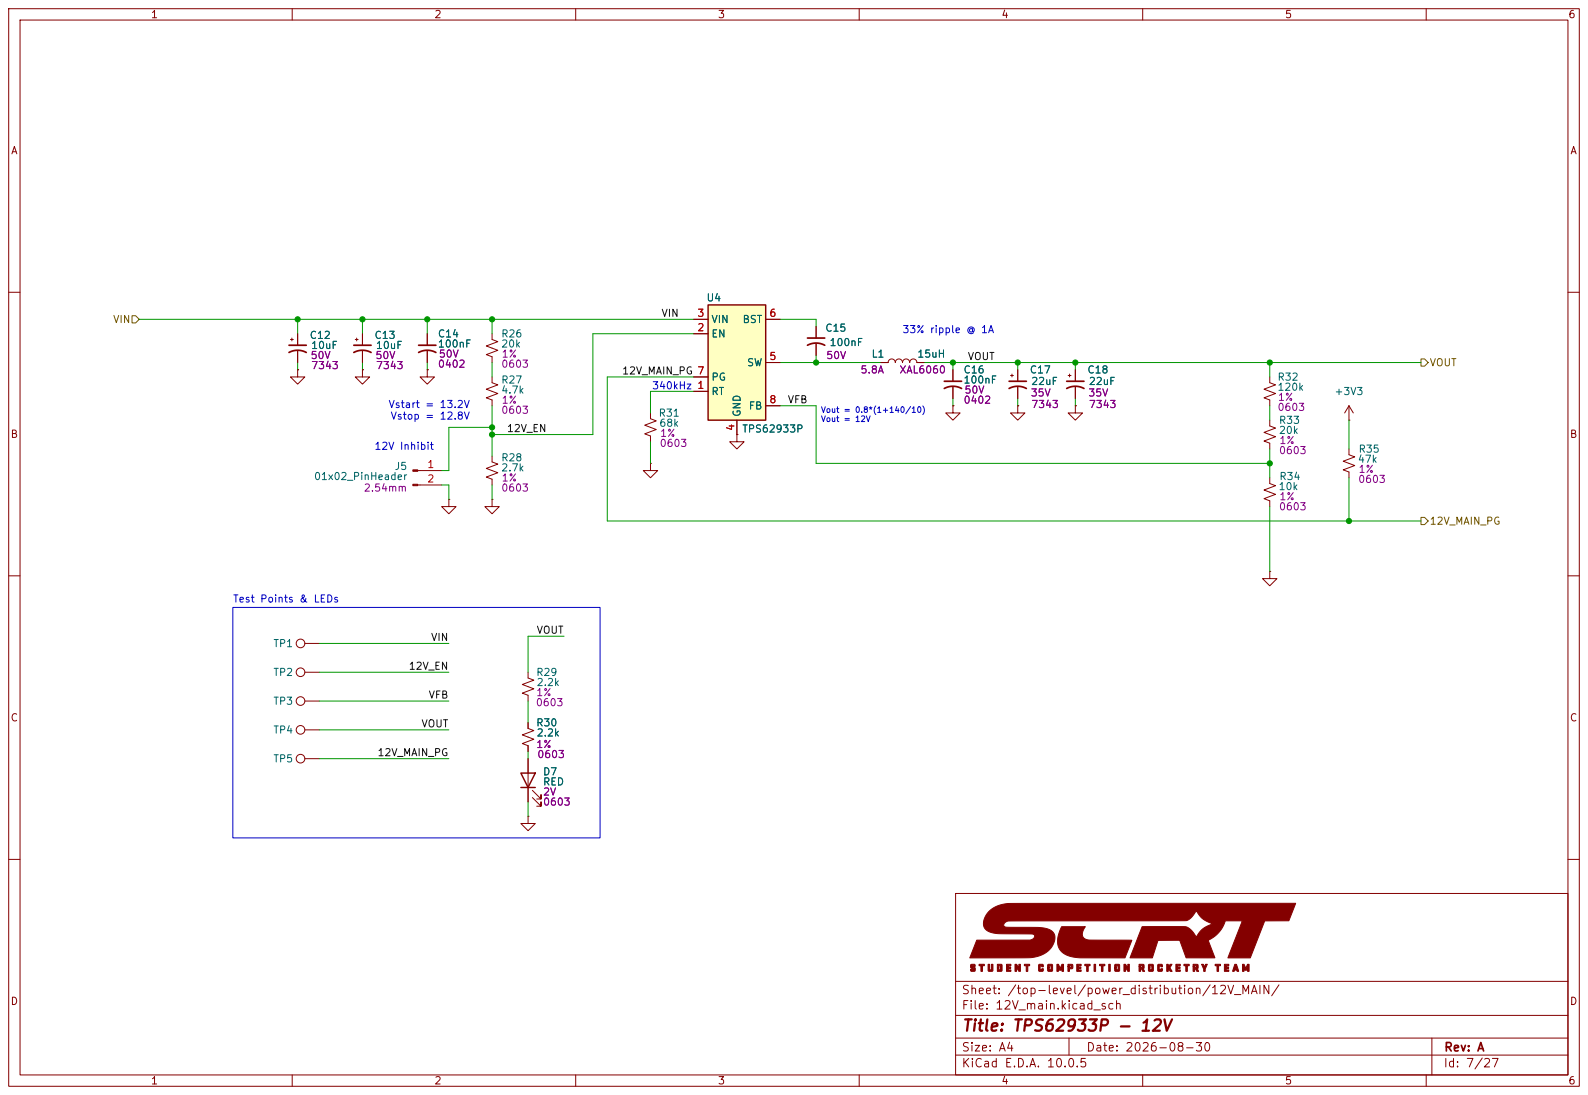
[picture p109: page 7]

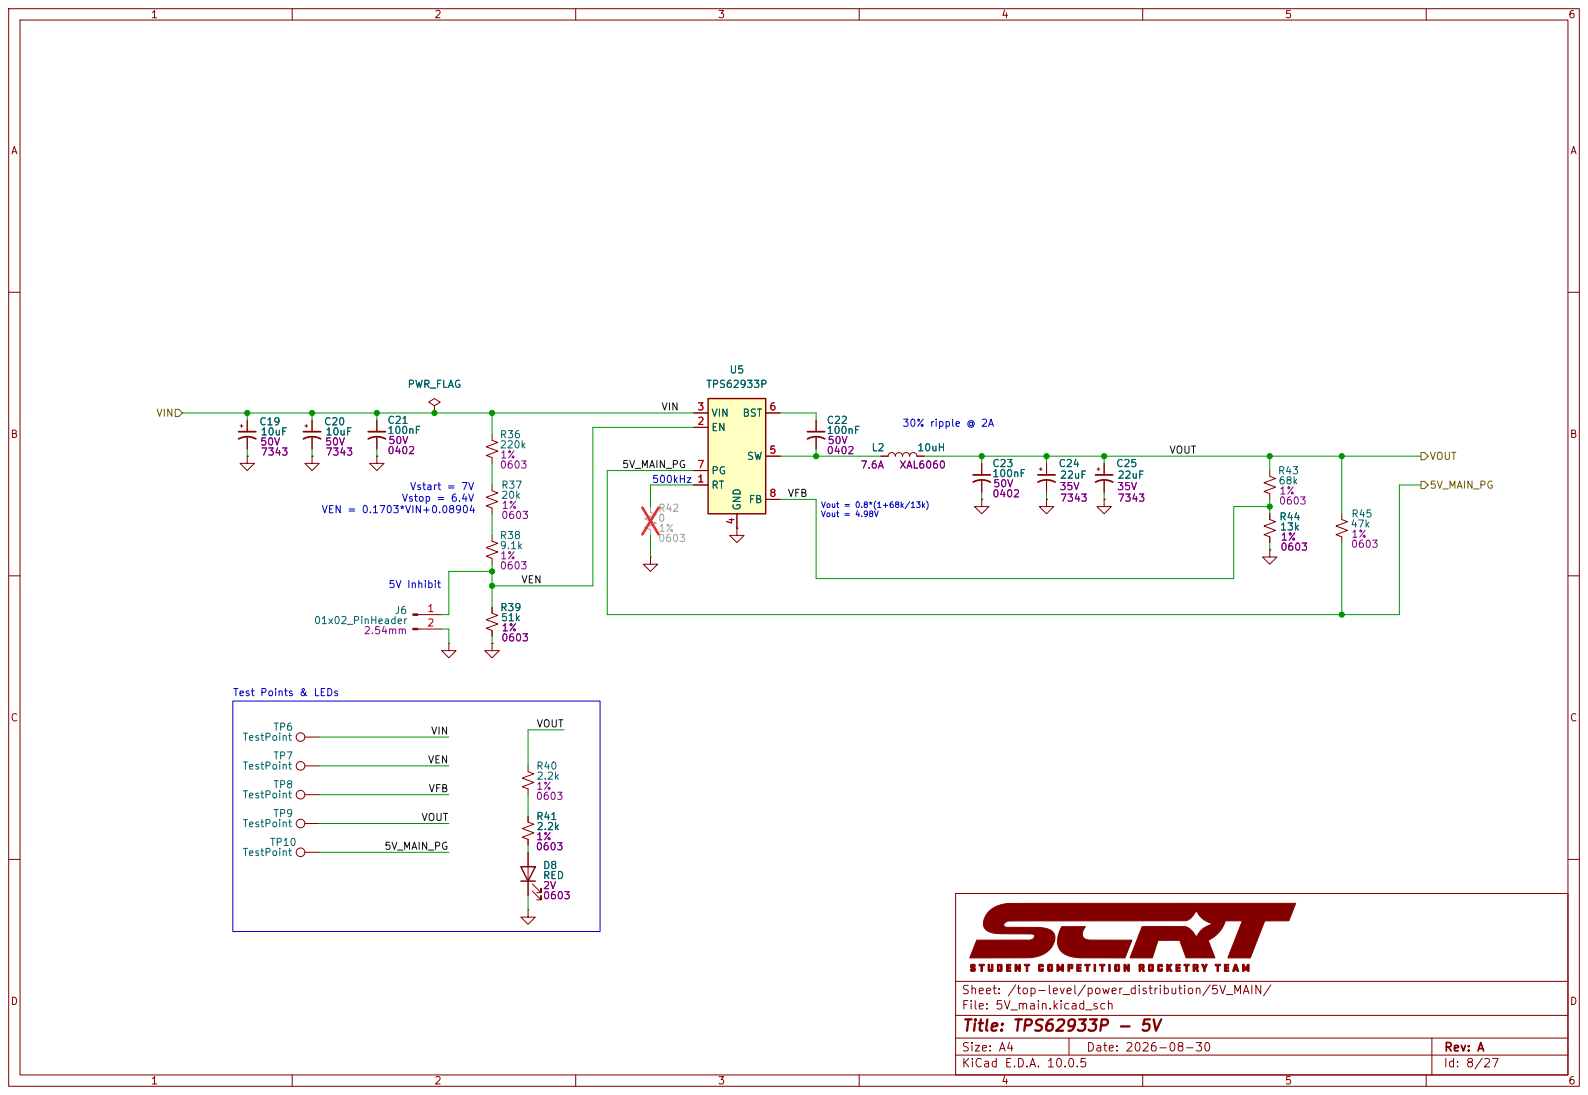
[picture p110: page 8]

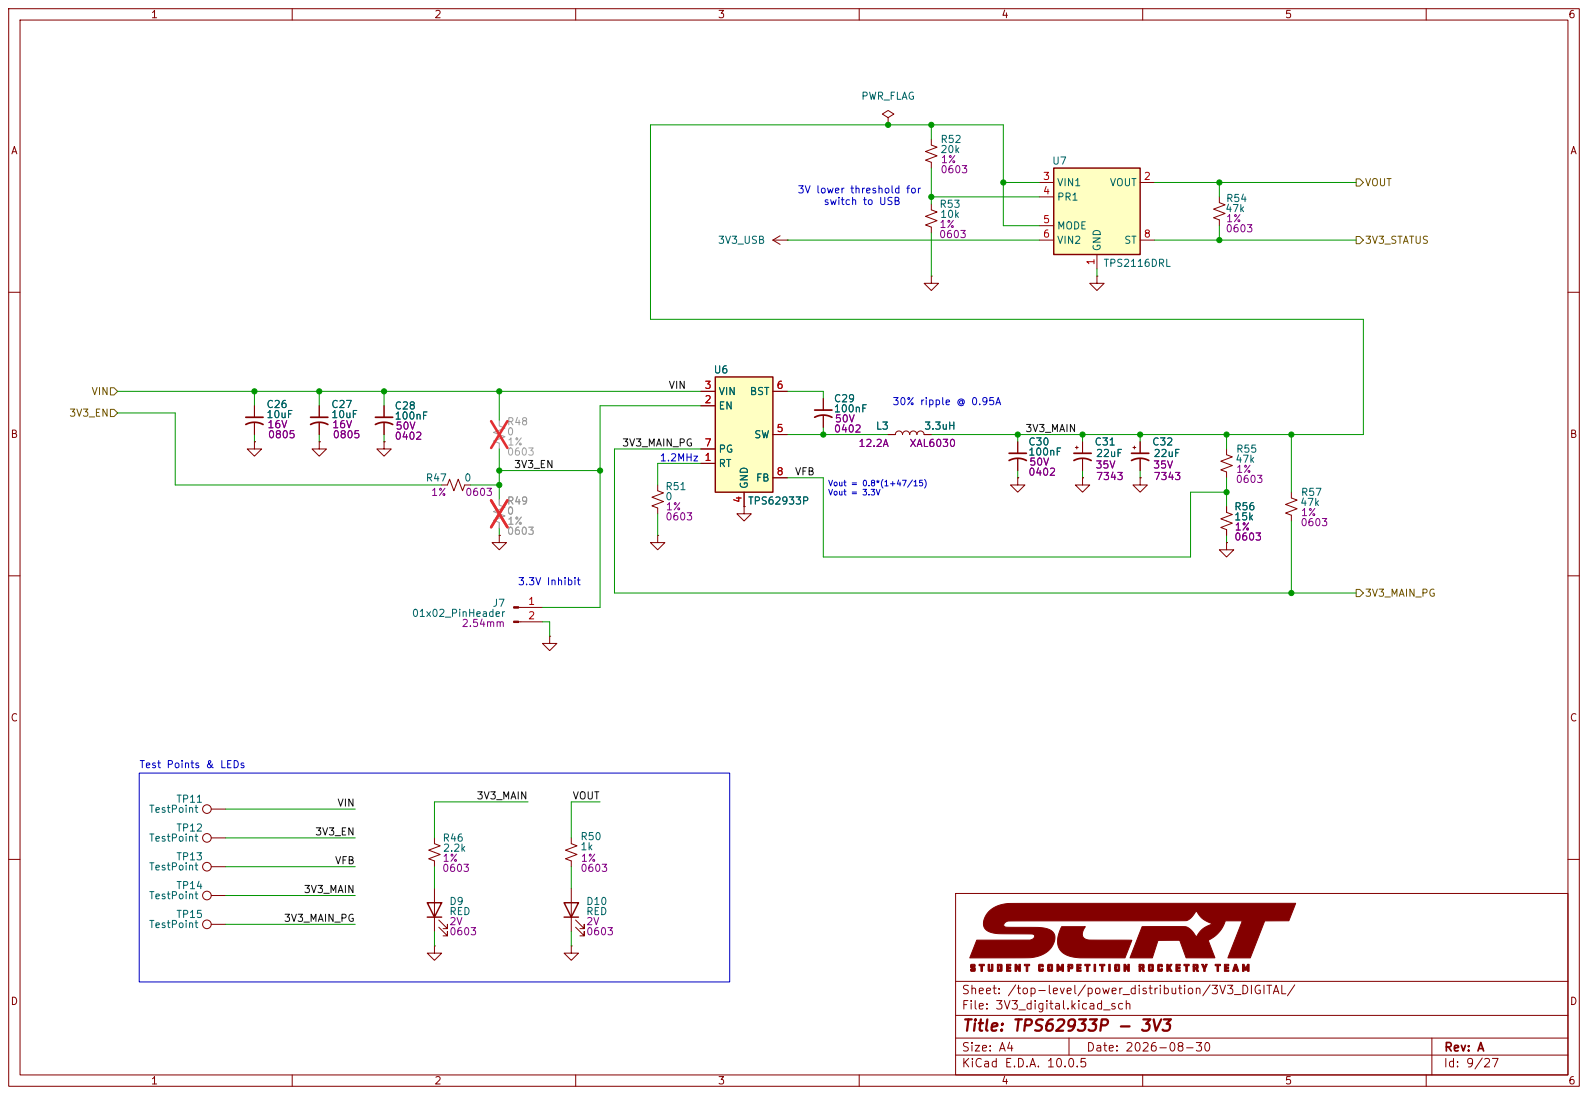
[picture p111: page 9]

3V lower threshold for switch to USB

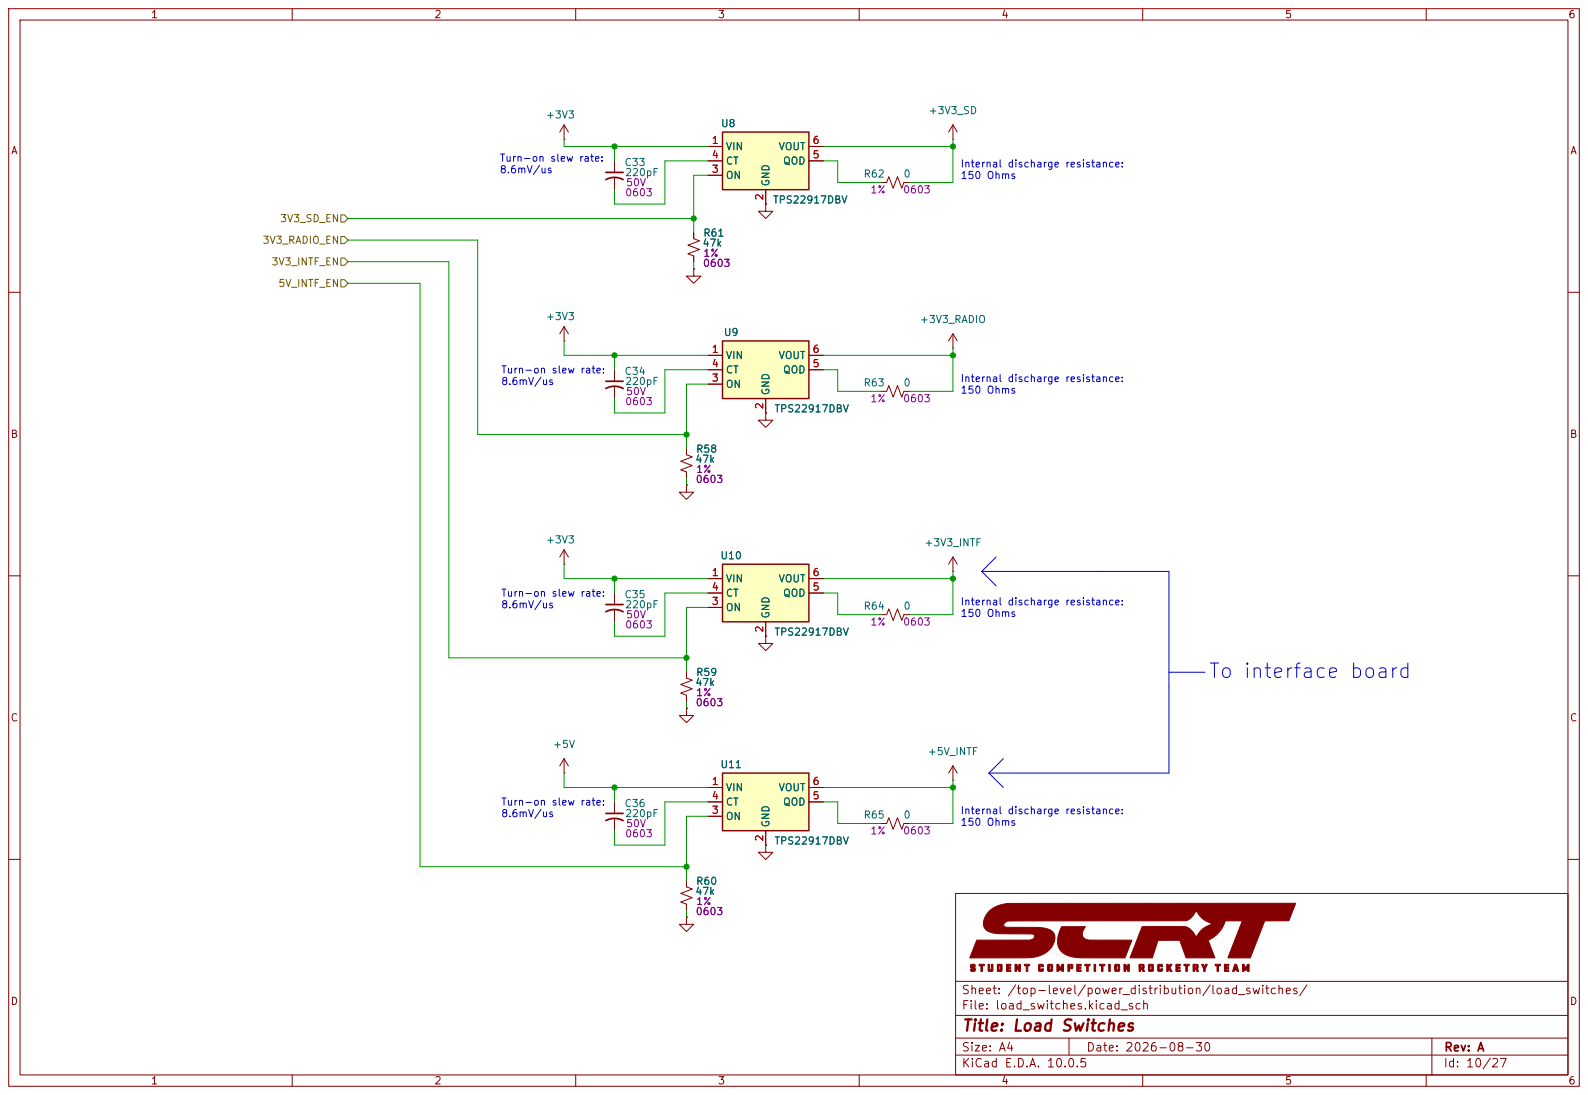
[picture p112: page 10]

Turn-on slew rate: 8.6mV/us

Internal discharge resistance: 150 Ohms

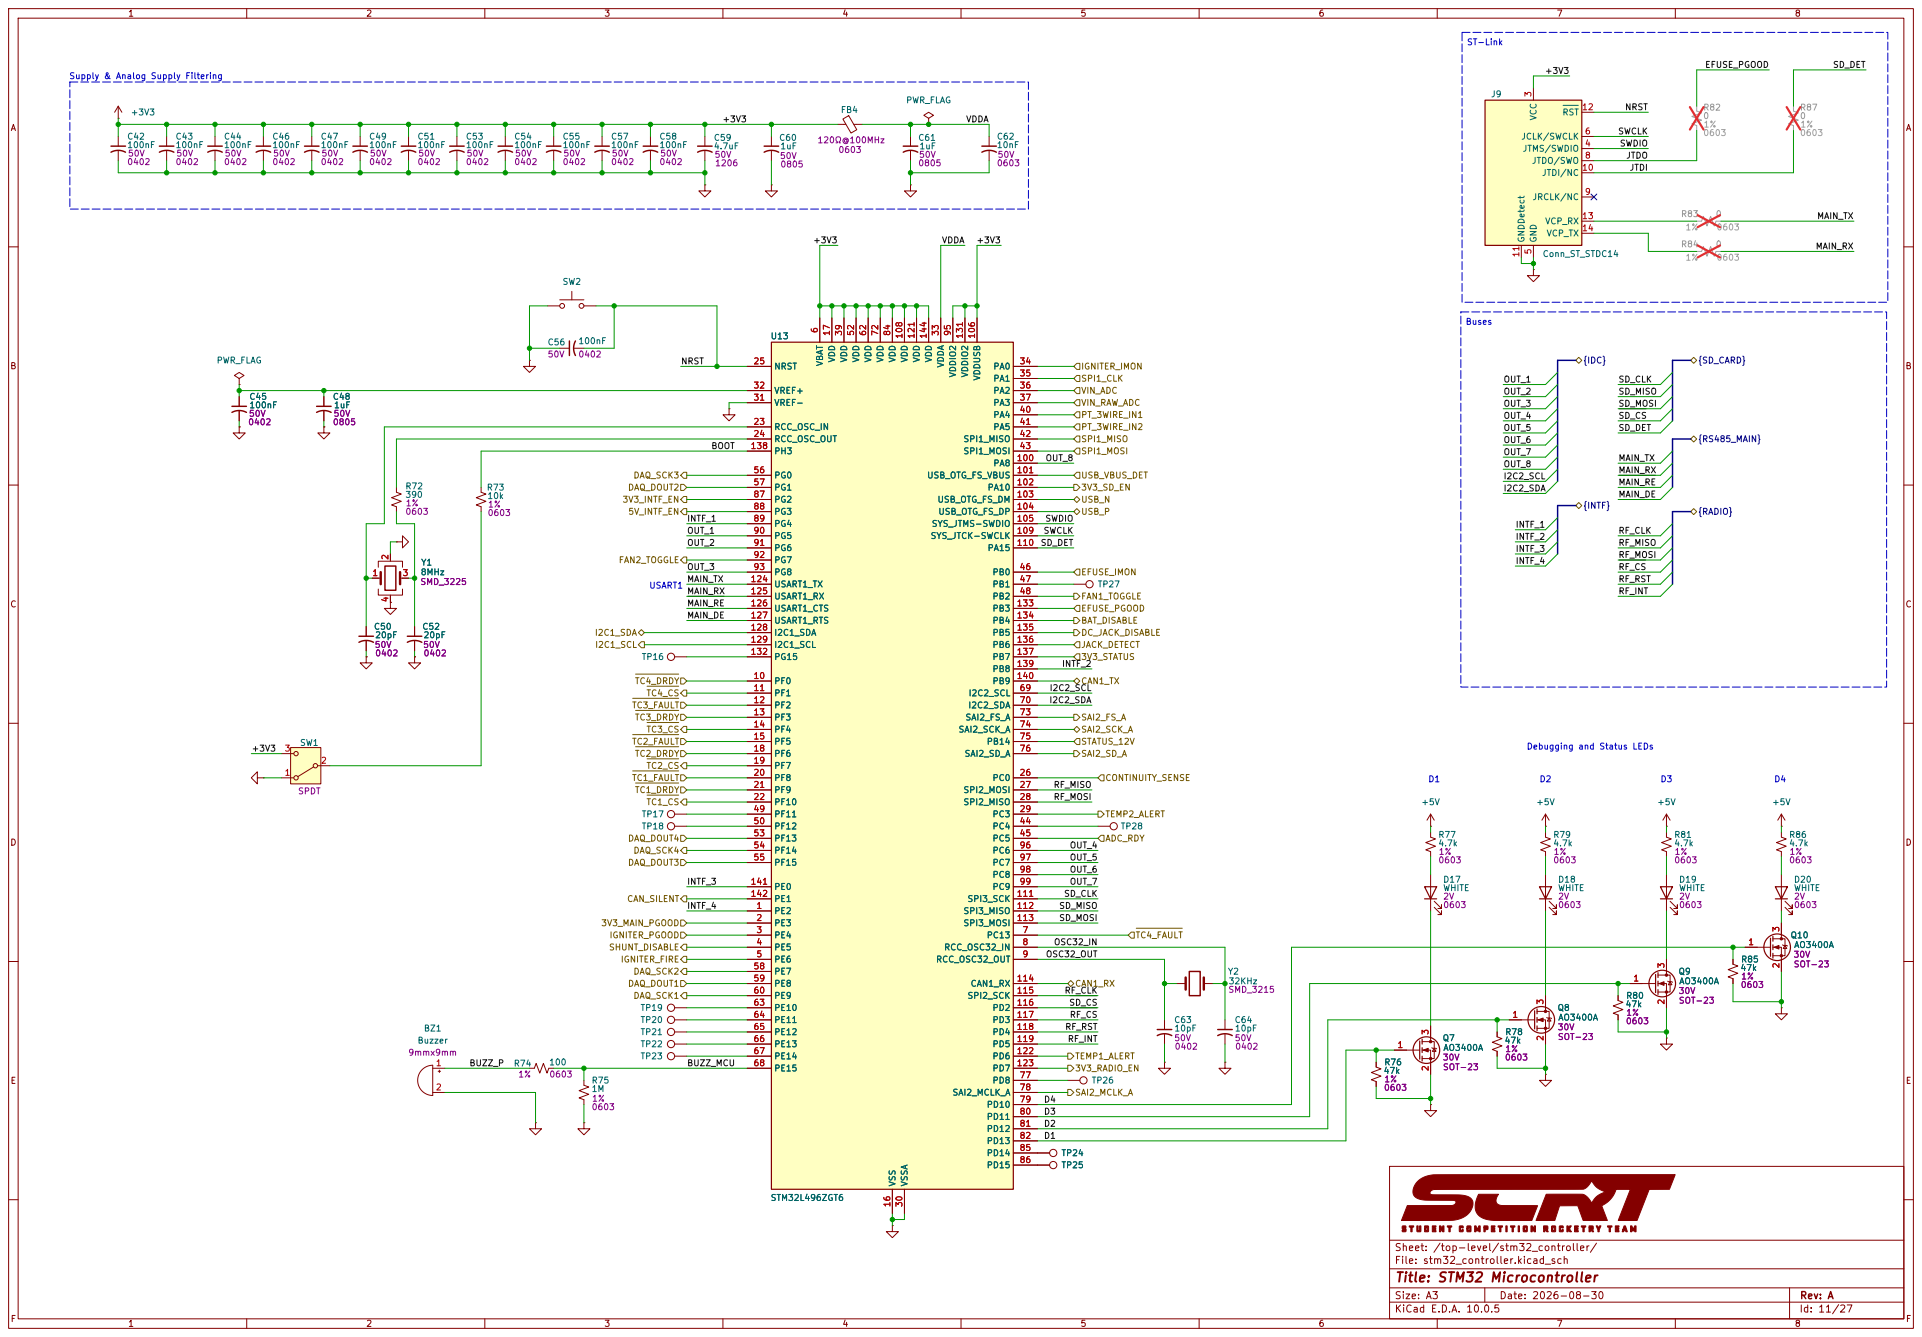
[picture p113: page 11]

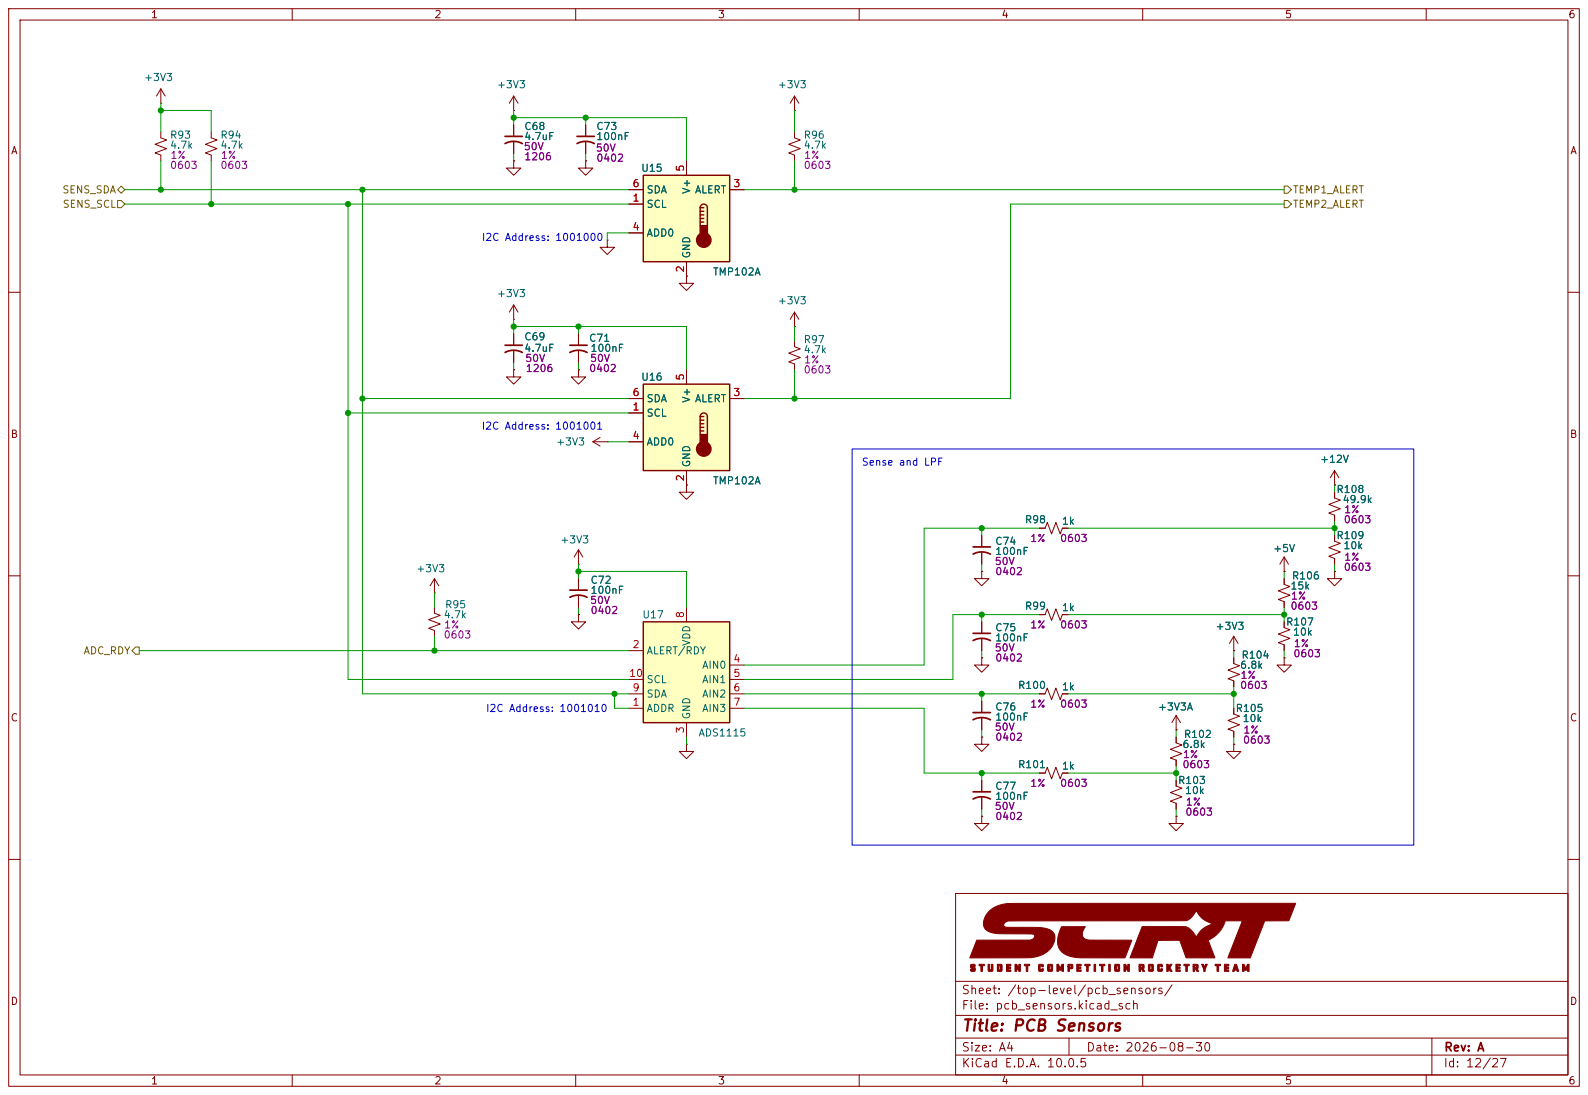
[picture p114: page 12]

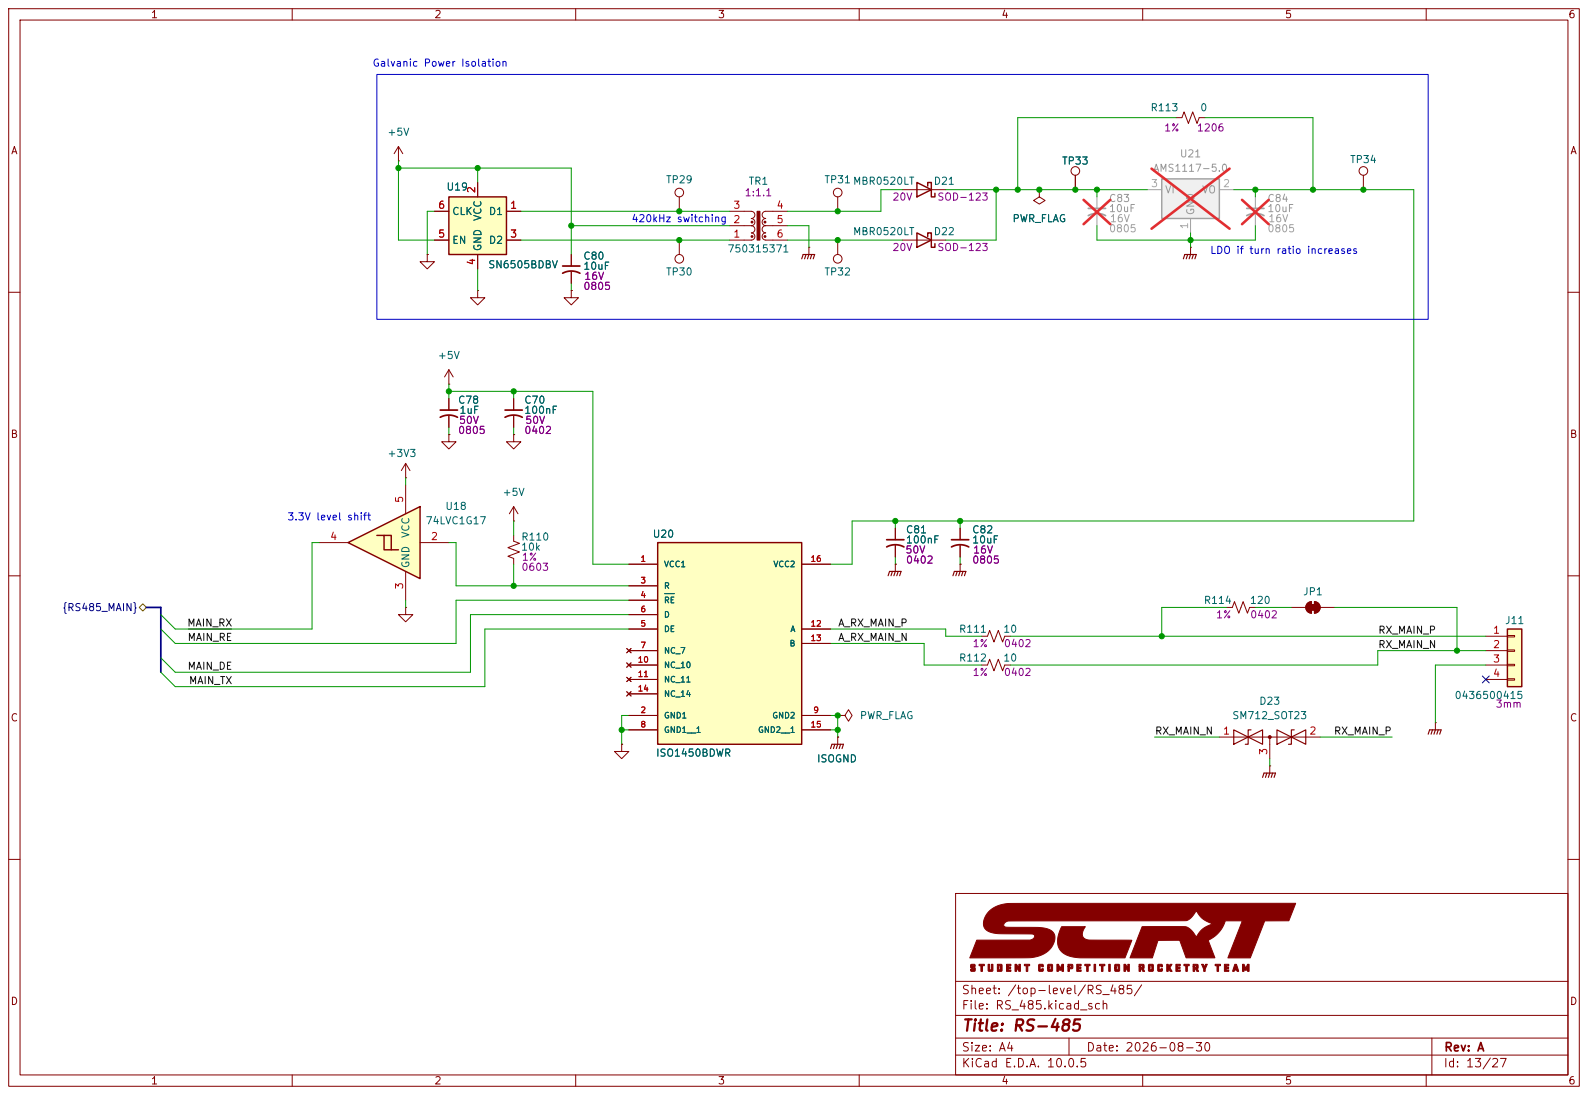
[picture p115: page 13]

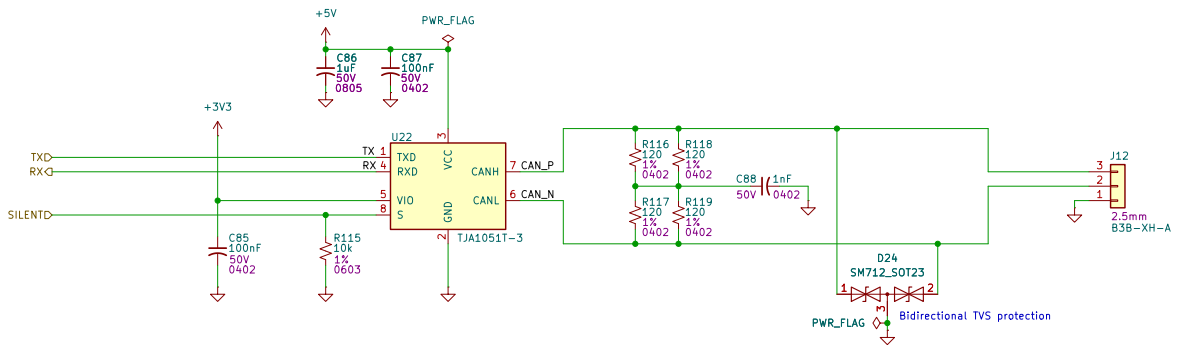
[picture p116: page 14]

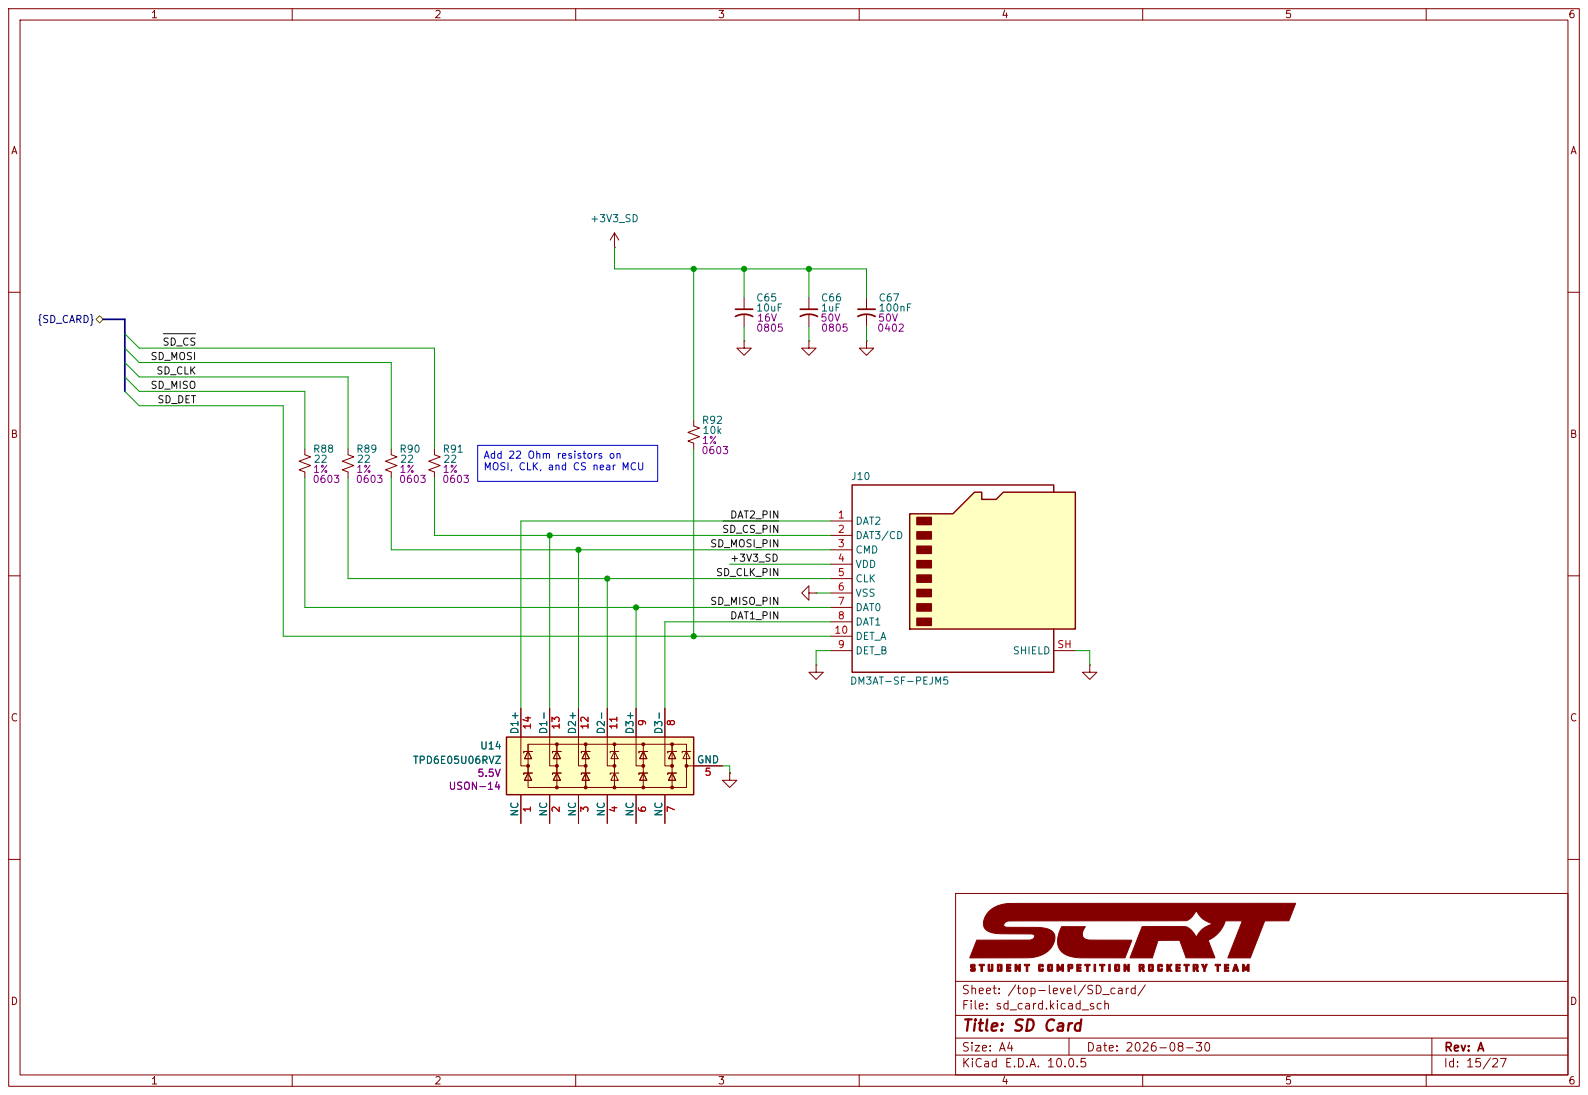
[picture p117: page 15]

Add 22 Ohm resistors on MOSI, CLK, and CS near MCU

SD_CS_PIN
SD_MOSI_PIN
SD_CLK_PIN | VDD 4 CLK 5

SD_MISO_PIN
DAT1_PIN

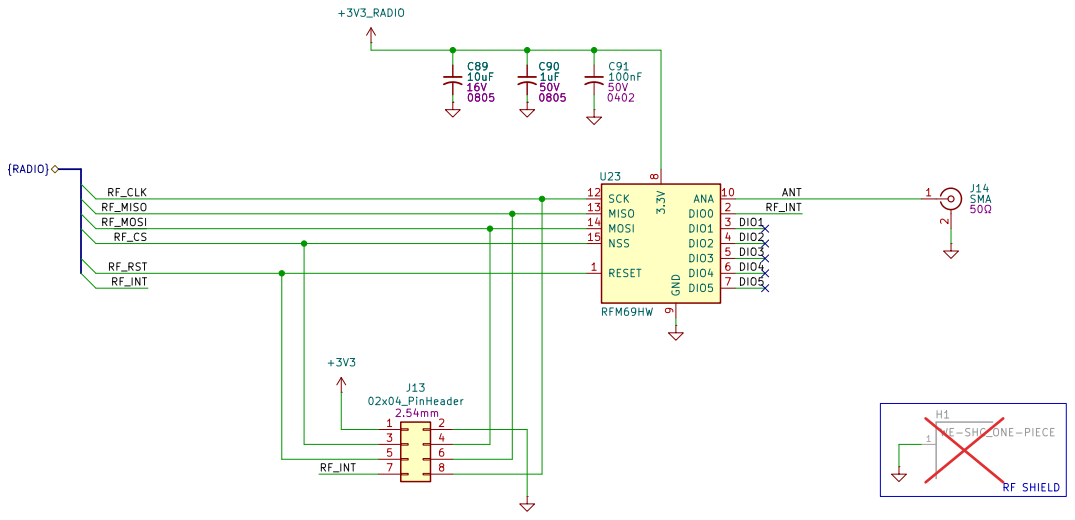
[picture p118: page 16]

Sheet: /top-level/rf/
File: rf.kicad_sch
Title: LoRa Radio

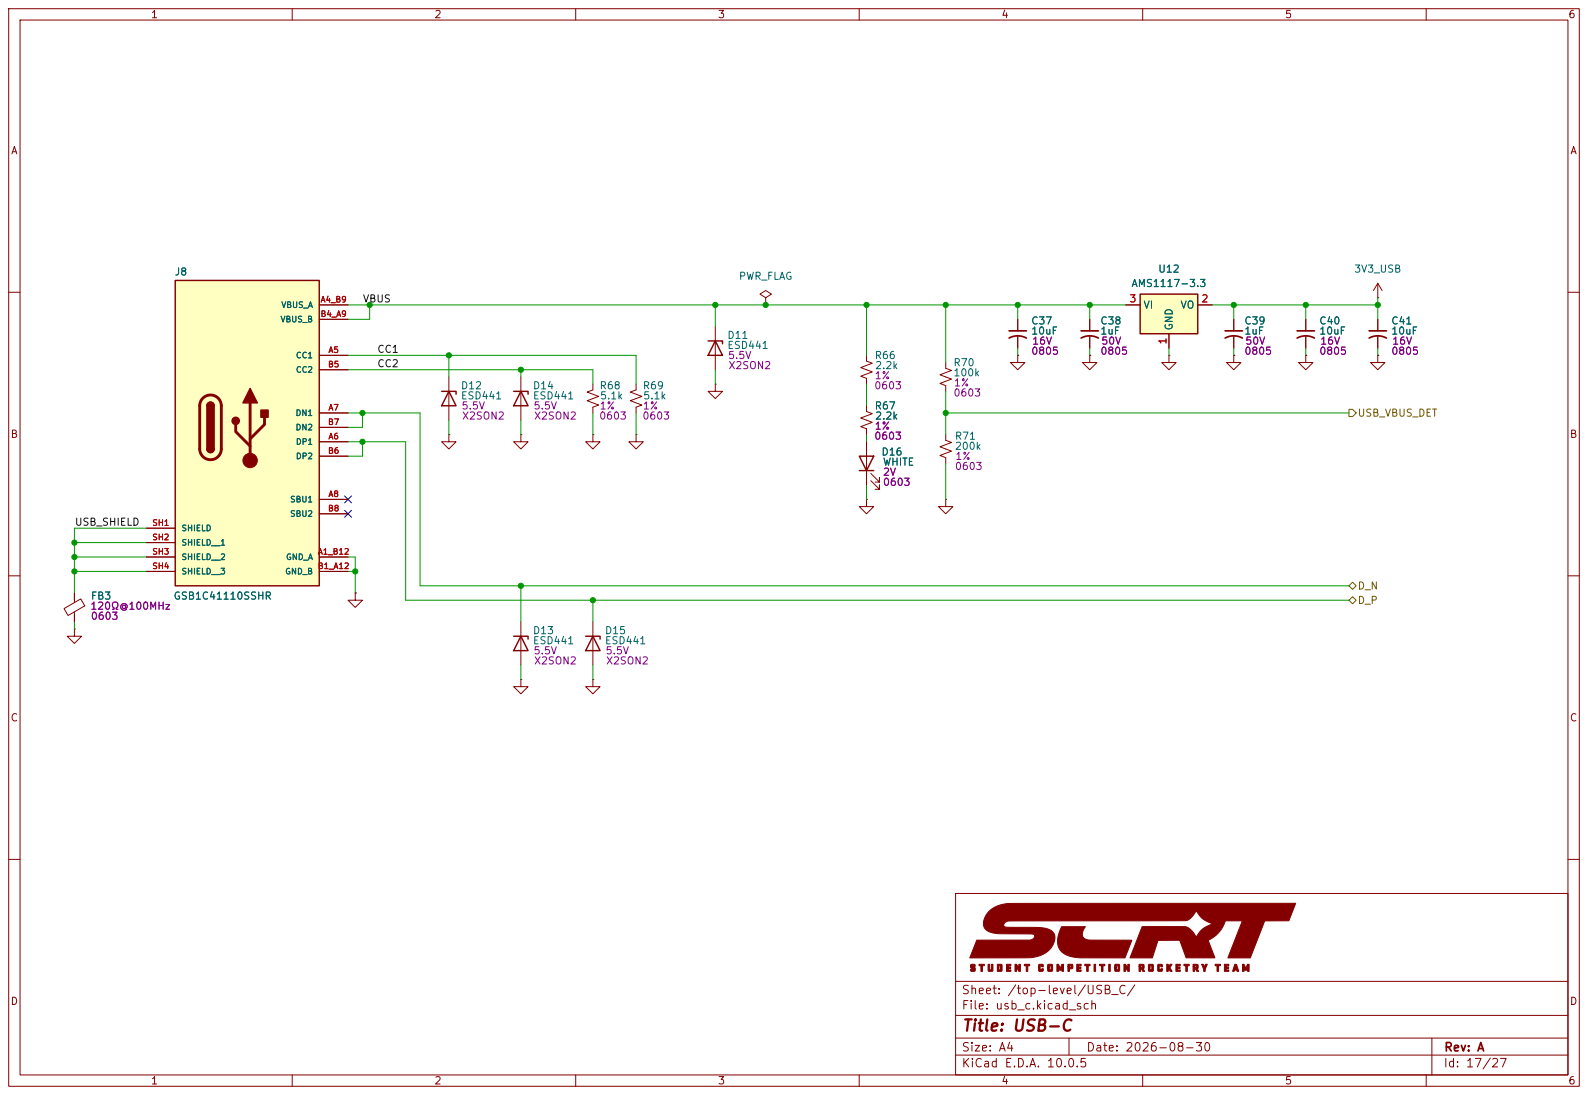
[picture p119: page 17]

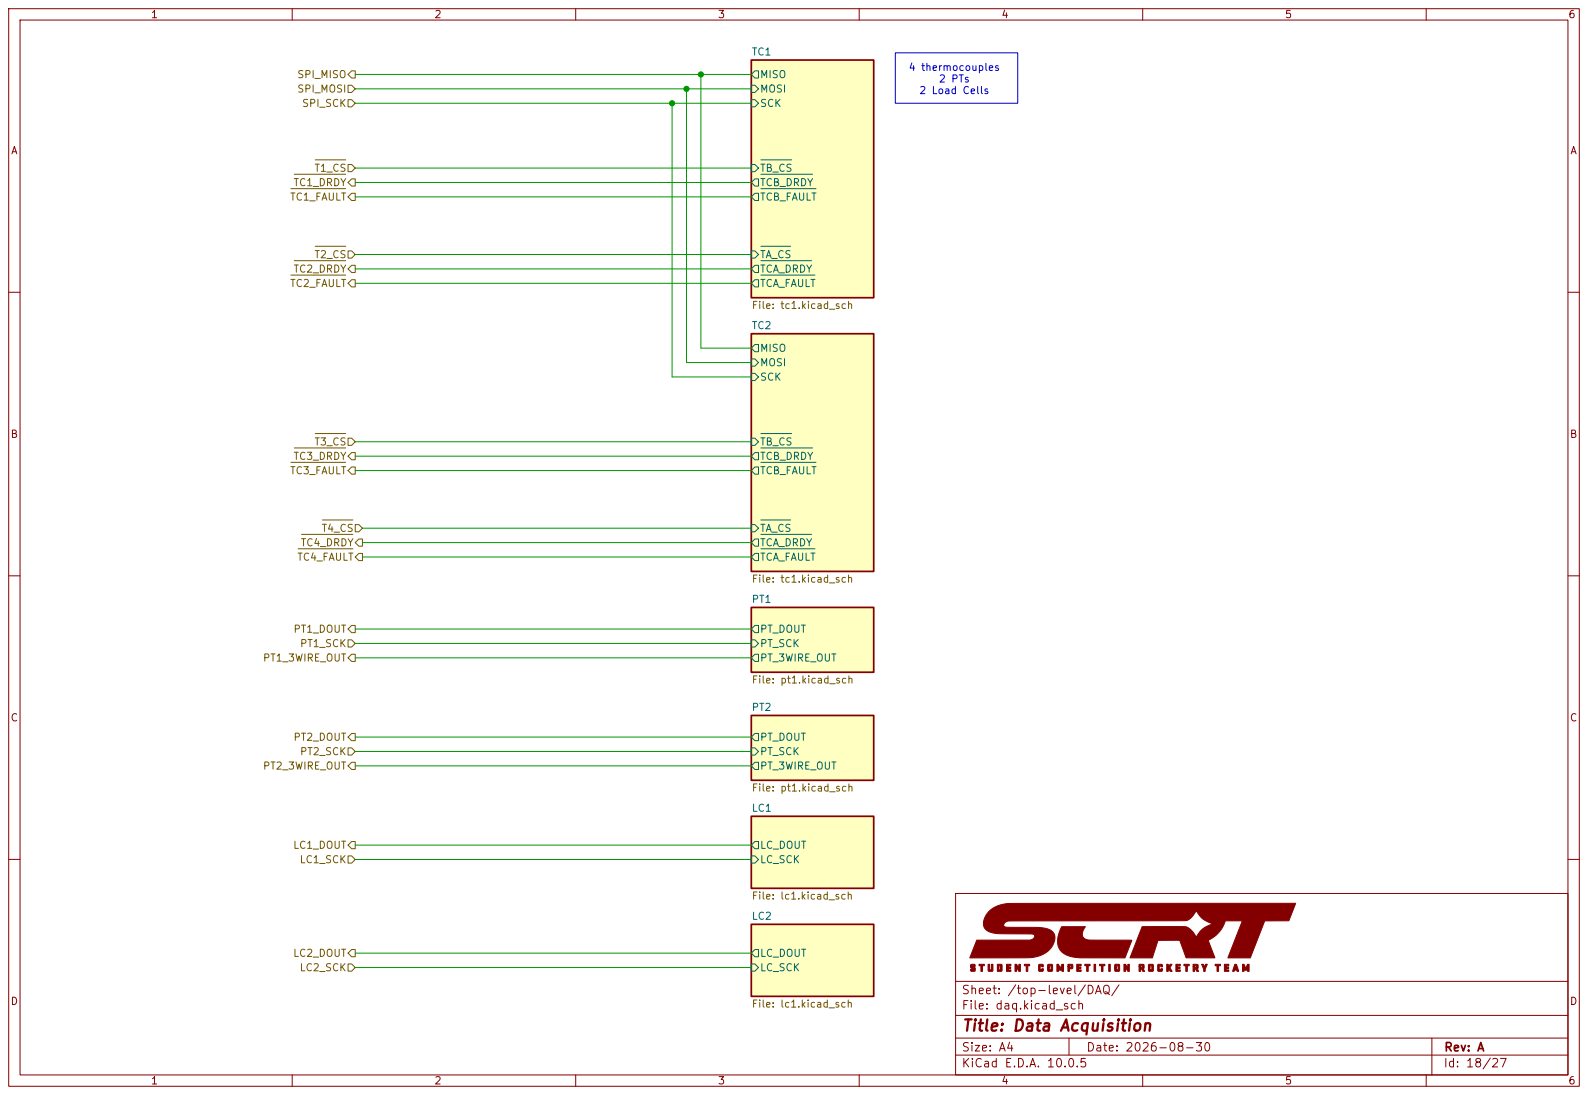
[picture p120: page 18]

Sheet: /top-level/DAQ/
File: daq.kicad_sch
Title: Data Acquisition

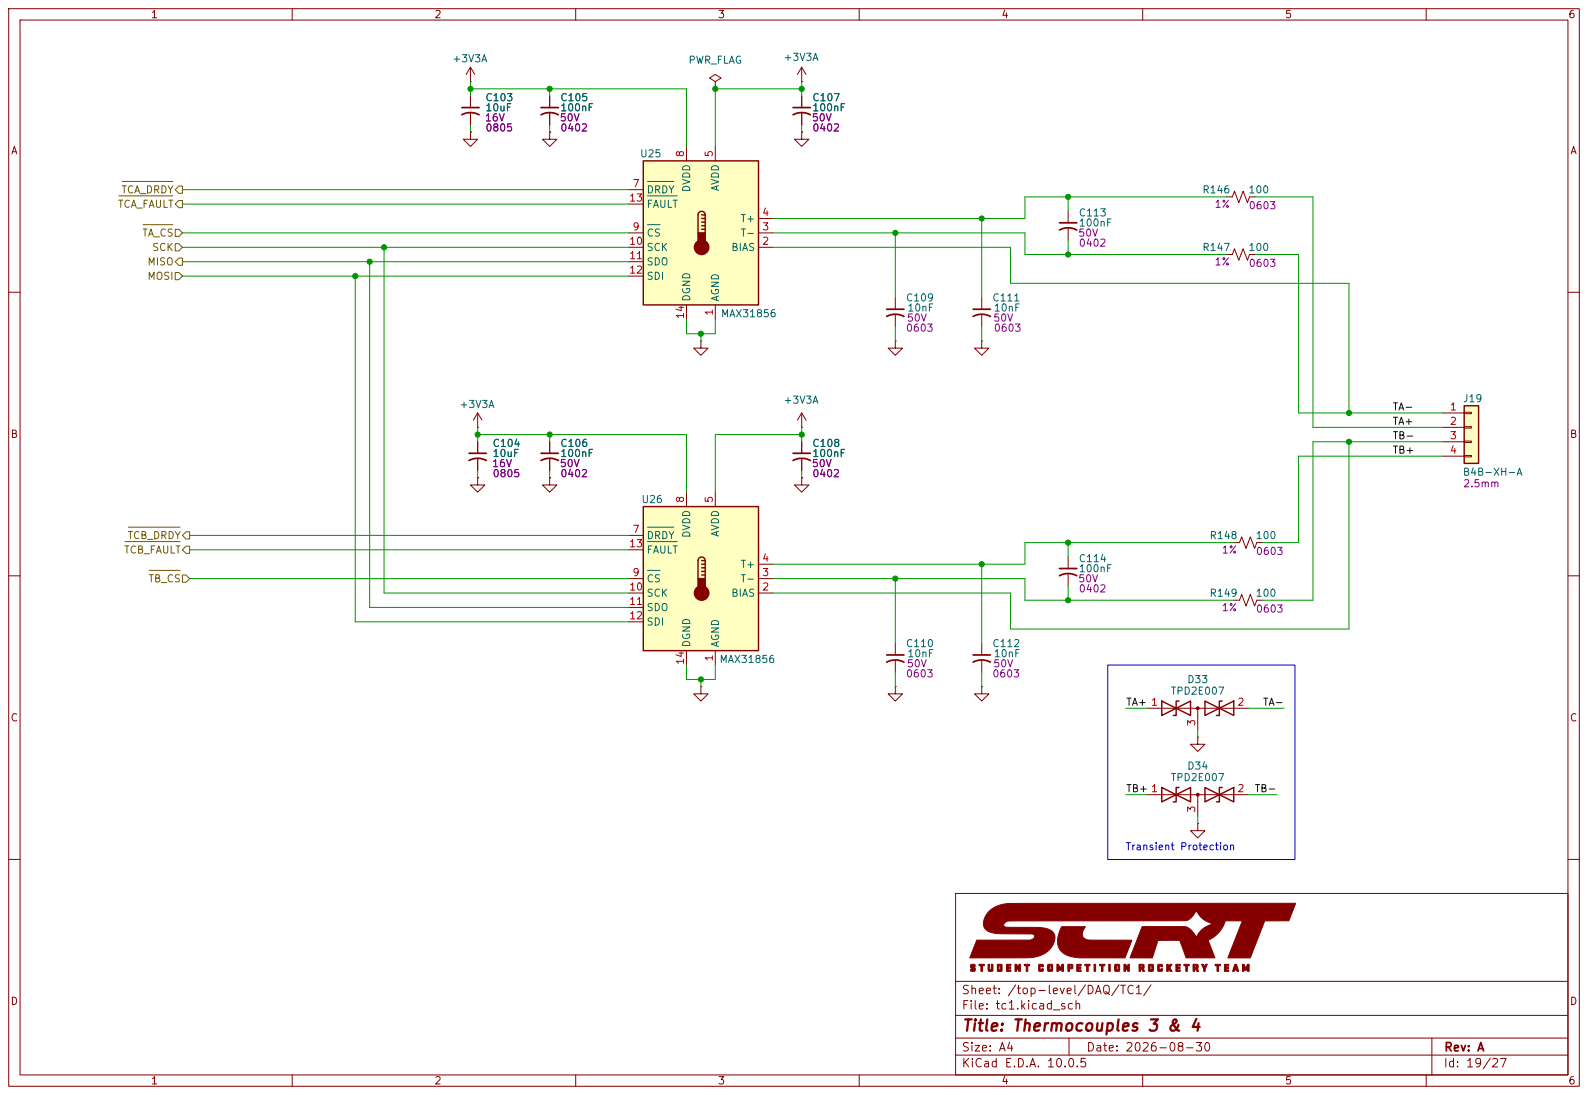
[picture p121: page 19]

Sheet: /top-level/DAQ/TC1/
File: tc1.kicad_sch
Title: Thermocouples 3 & 4

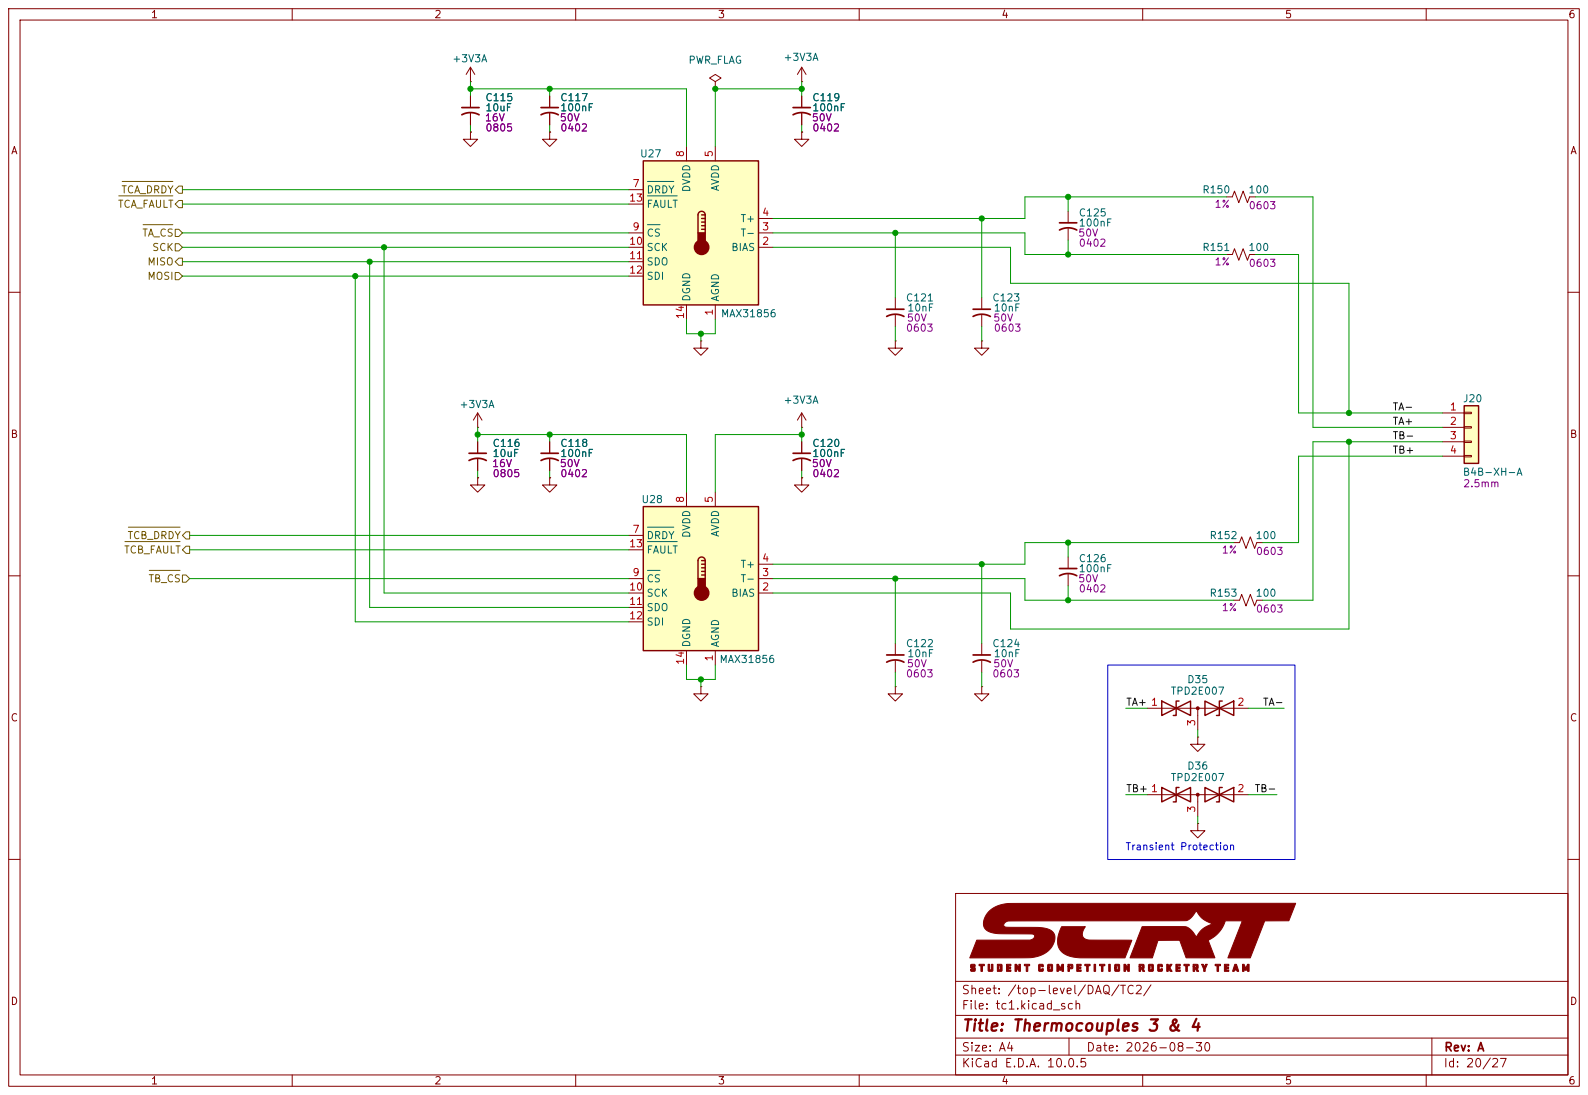
[picture p122: page 20]

Sheet: /top-level/DAQ/TC2/
File: tc1.kicad_sch
Title: Thermocouples 3 & 4

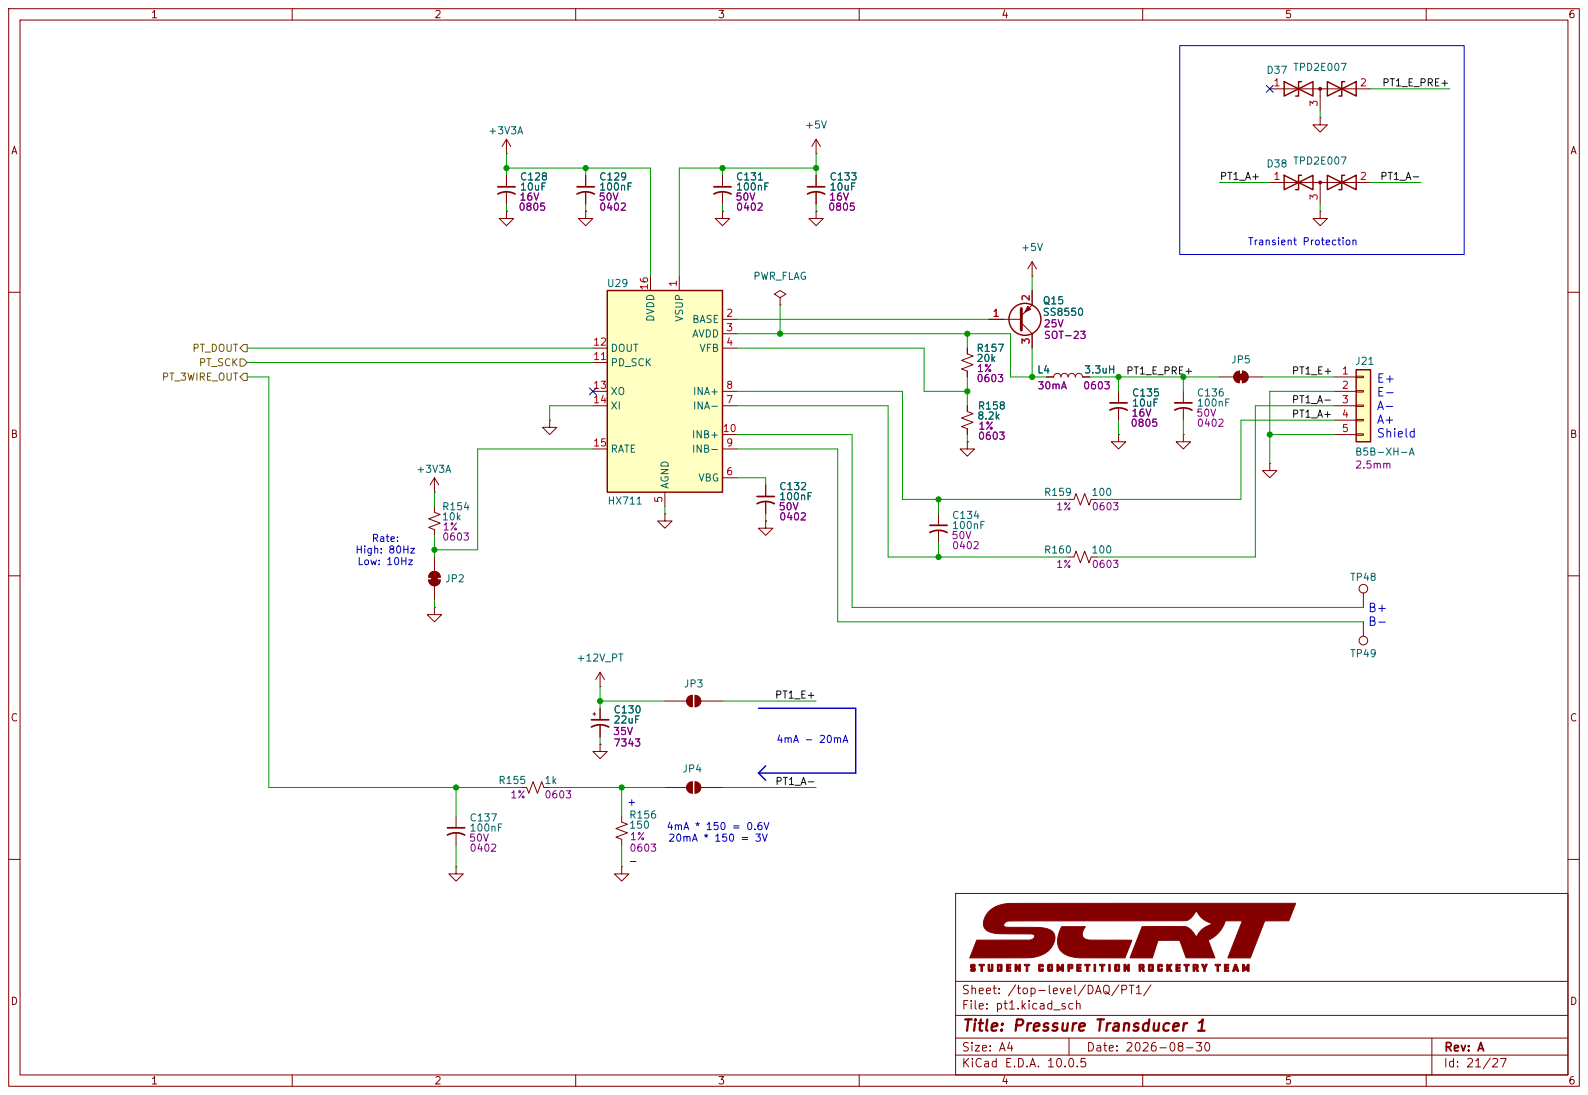
[picture p123: page 21]

Sheet: /top-level/DAQ/PT1/
File: pt1.kicad_sch
Title: Pressure Transducer 1

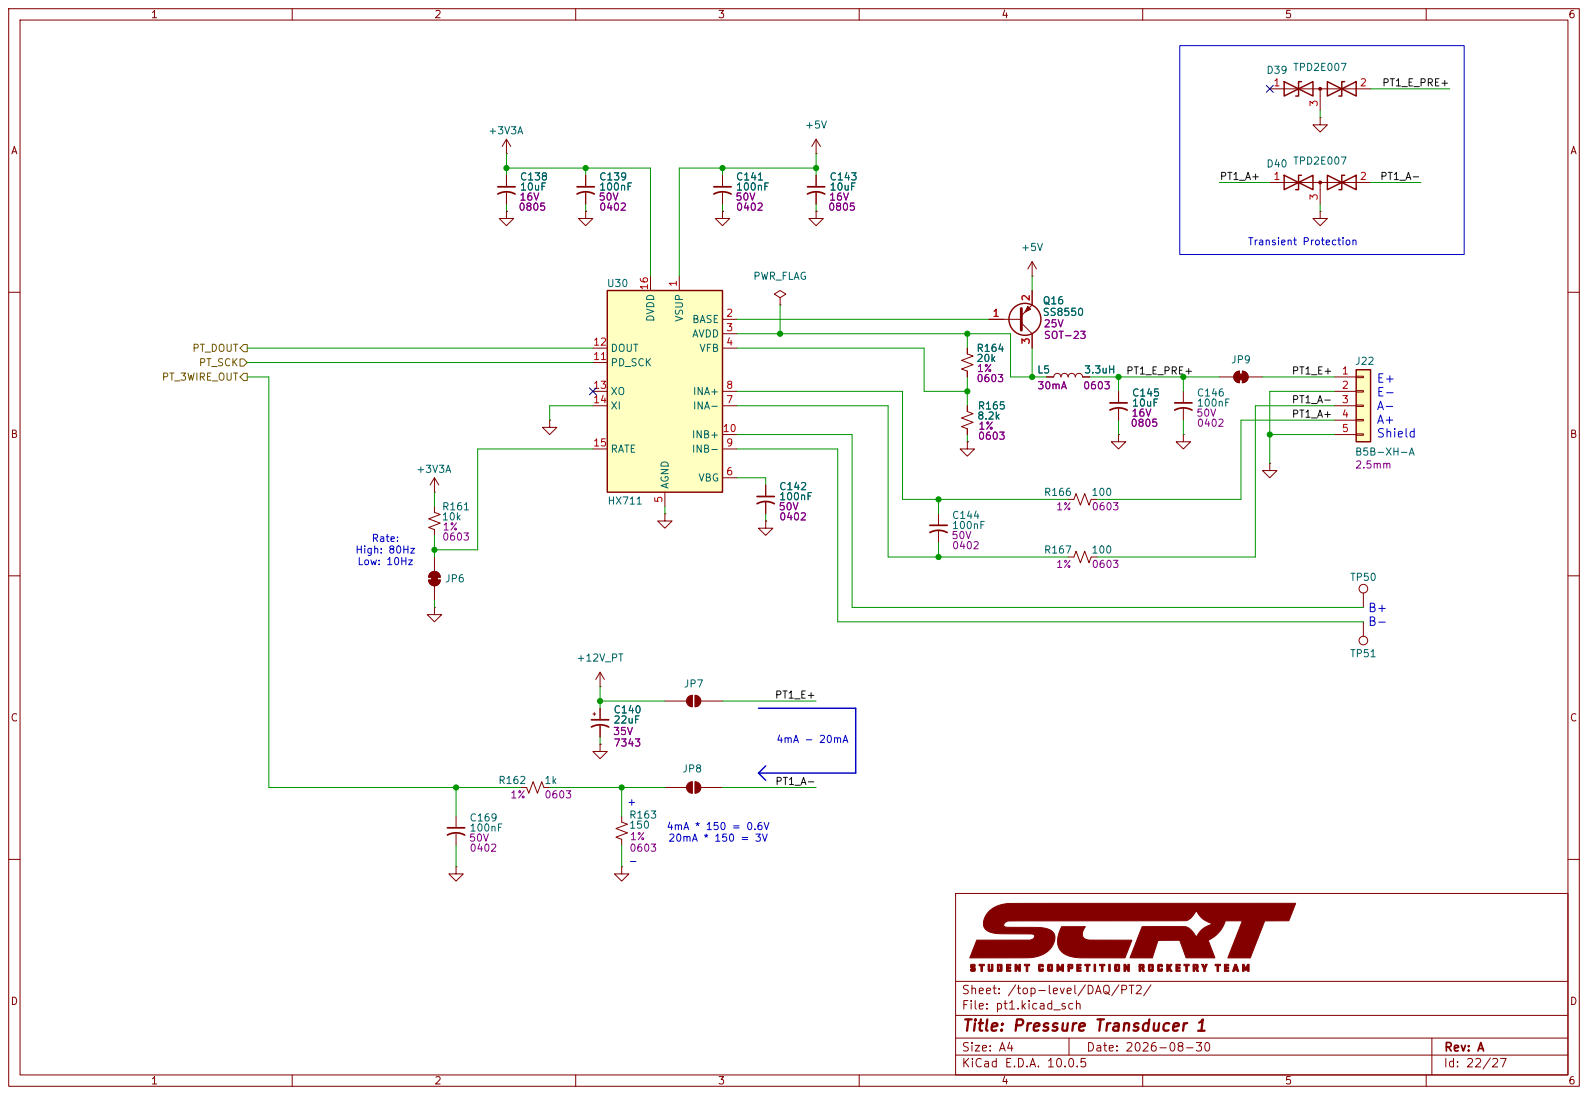
[picture p124: page 22]

Sheet: /top-level/DAQ/PT2/
File: pt1.kicad_sch
Title: Pressure Transducer 1

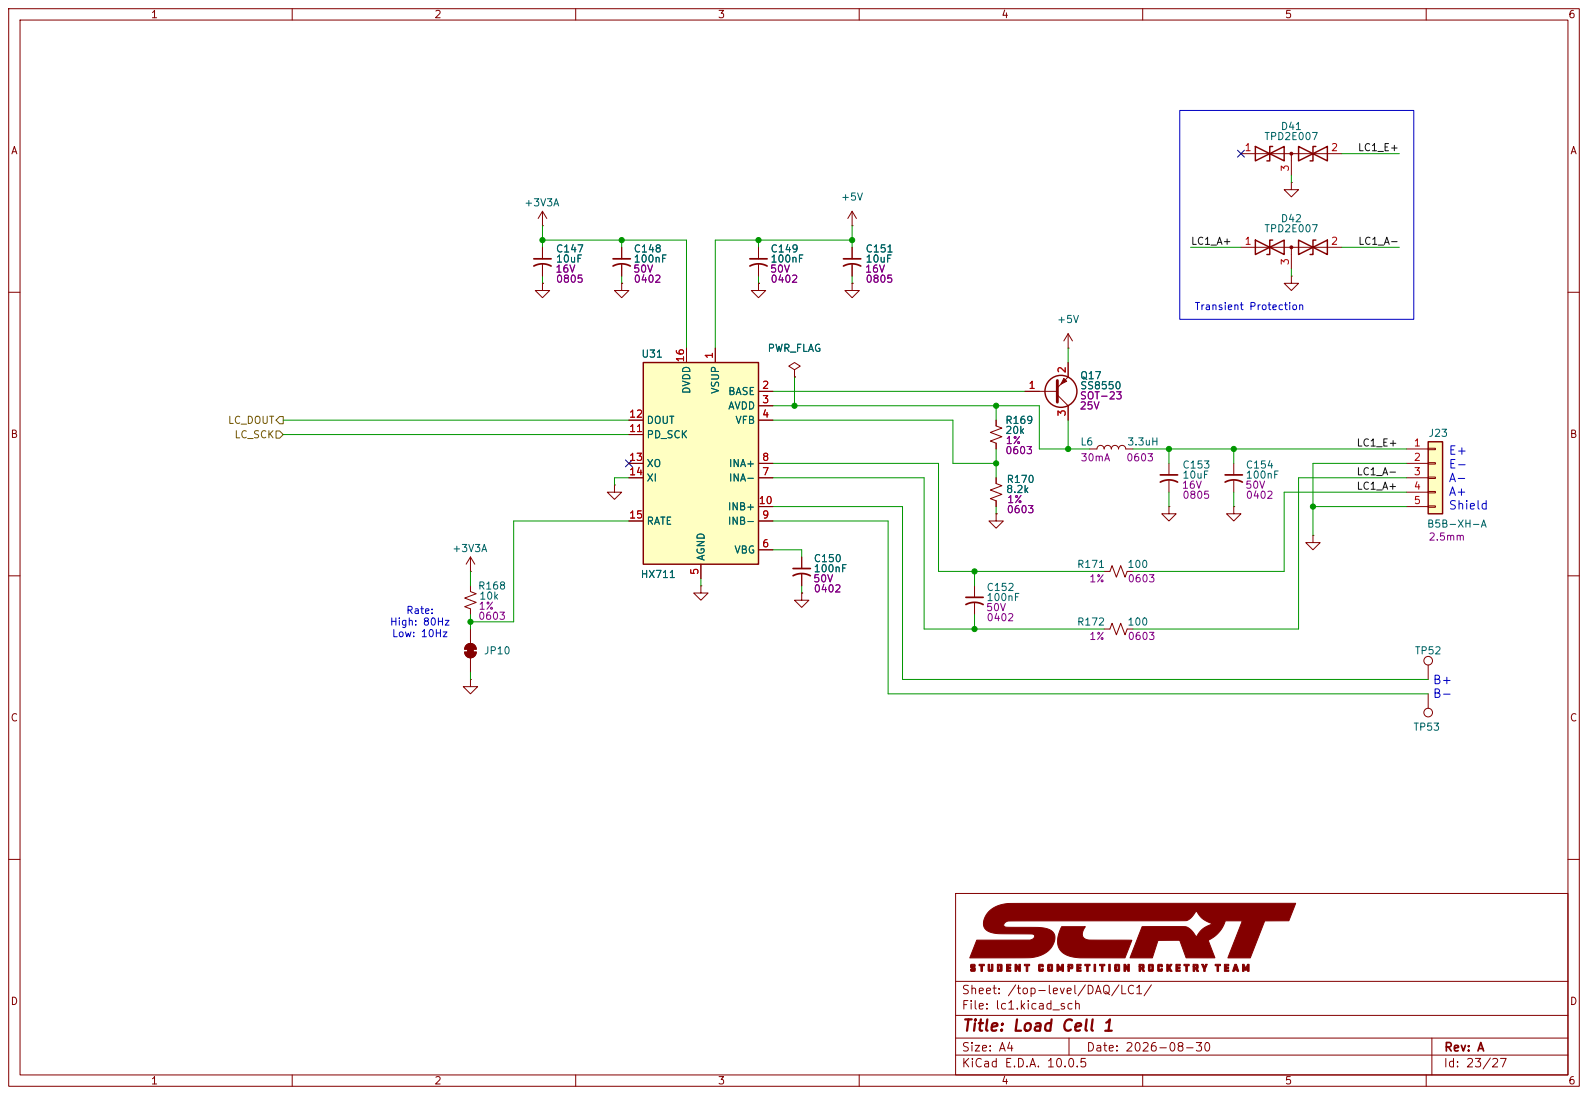
[picture p125: page 23]

Sheet: /top-level/DAQ/LC1/
File: lc1.kicad_sch
Title: Load Cell 1

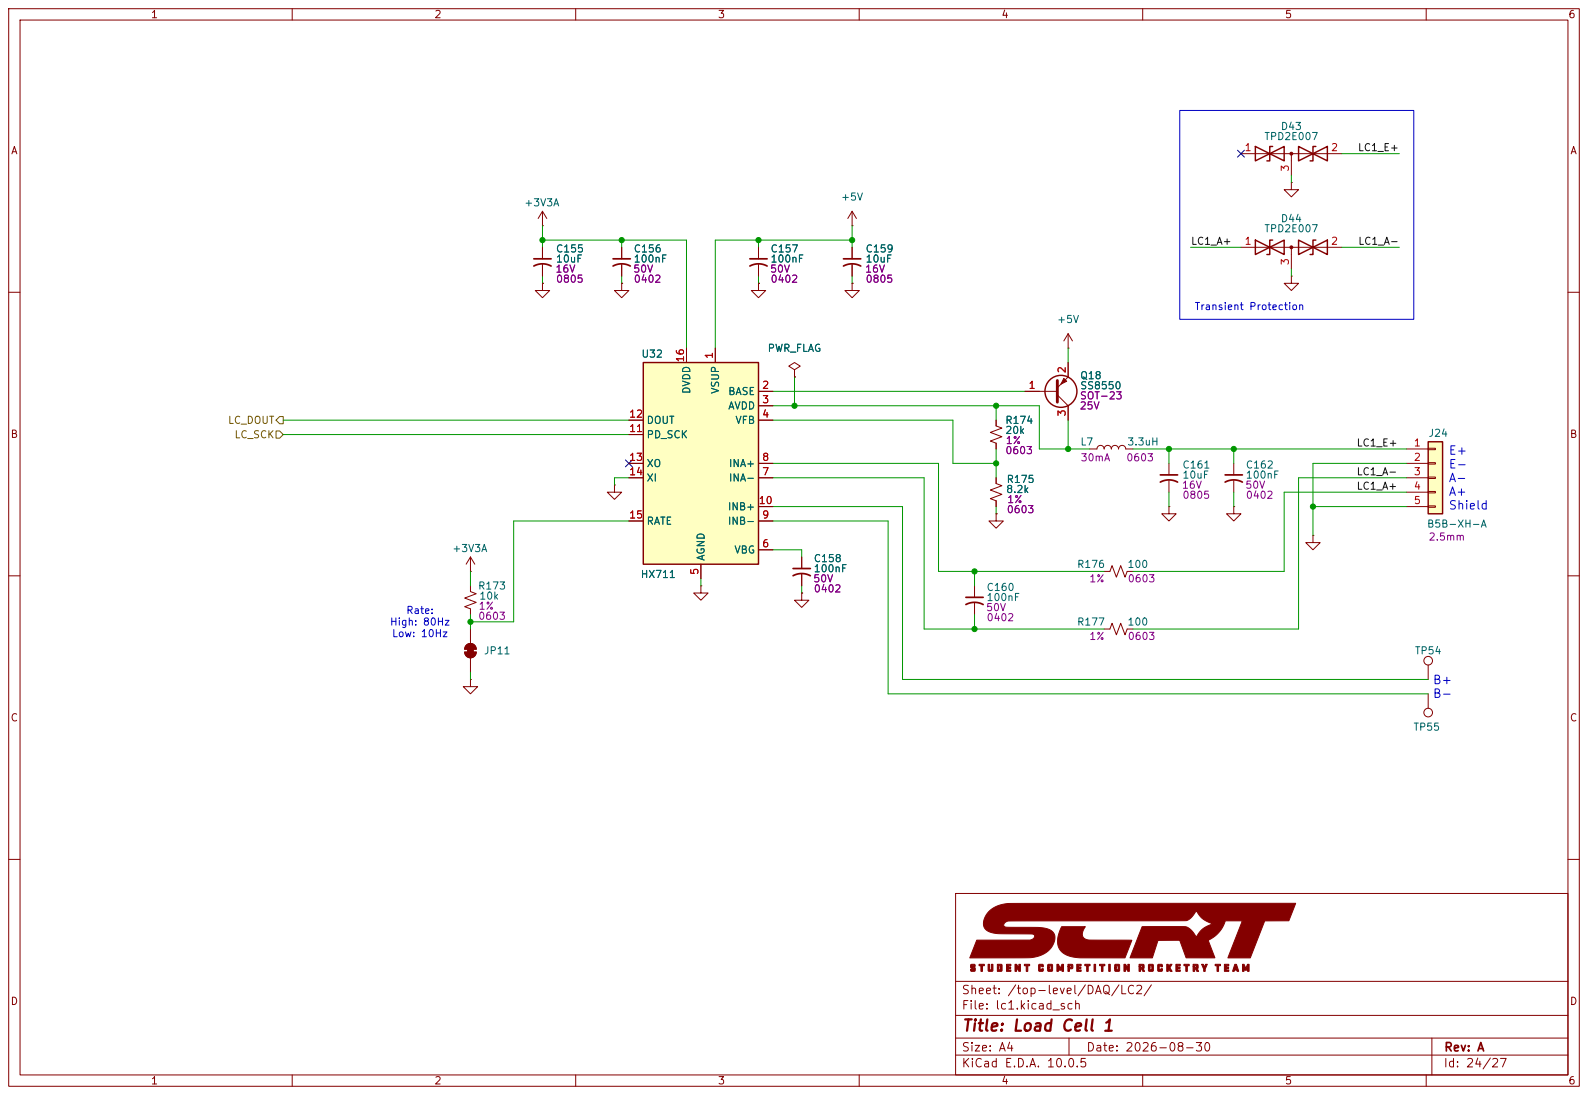
[picture p126: page 24]

Sheet: /top-level/DAQ/LC2/
File: lc1.kicad_sch
Title: Load Cell 1

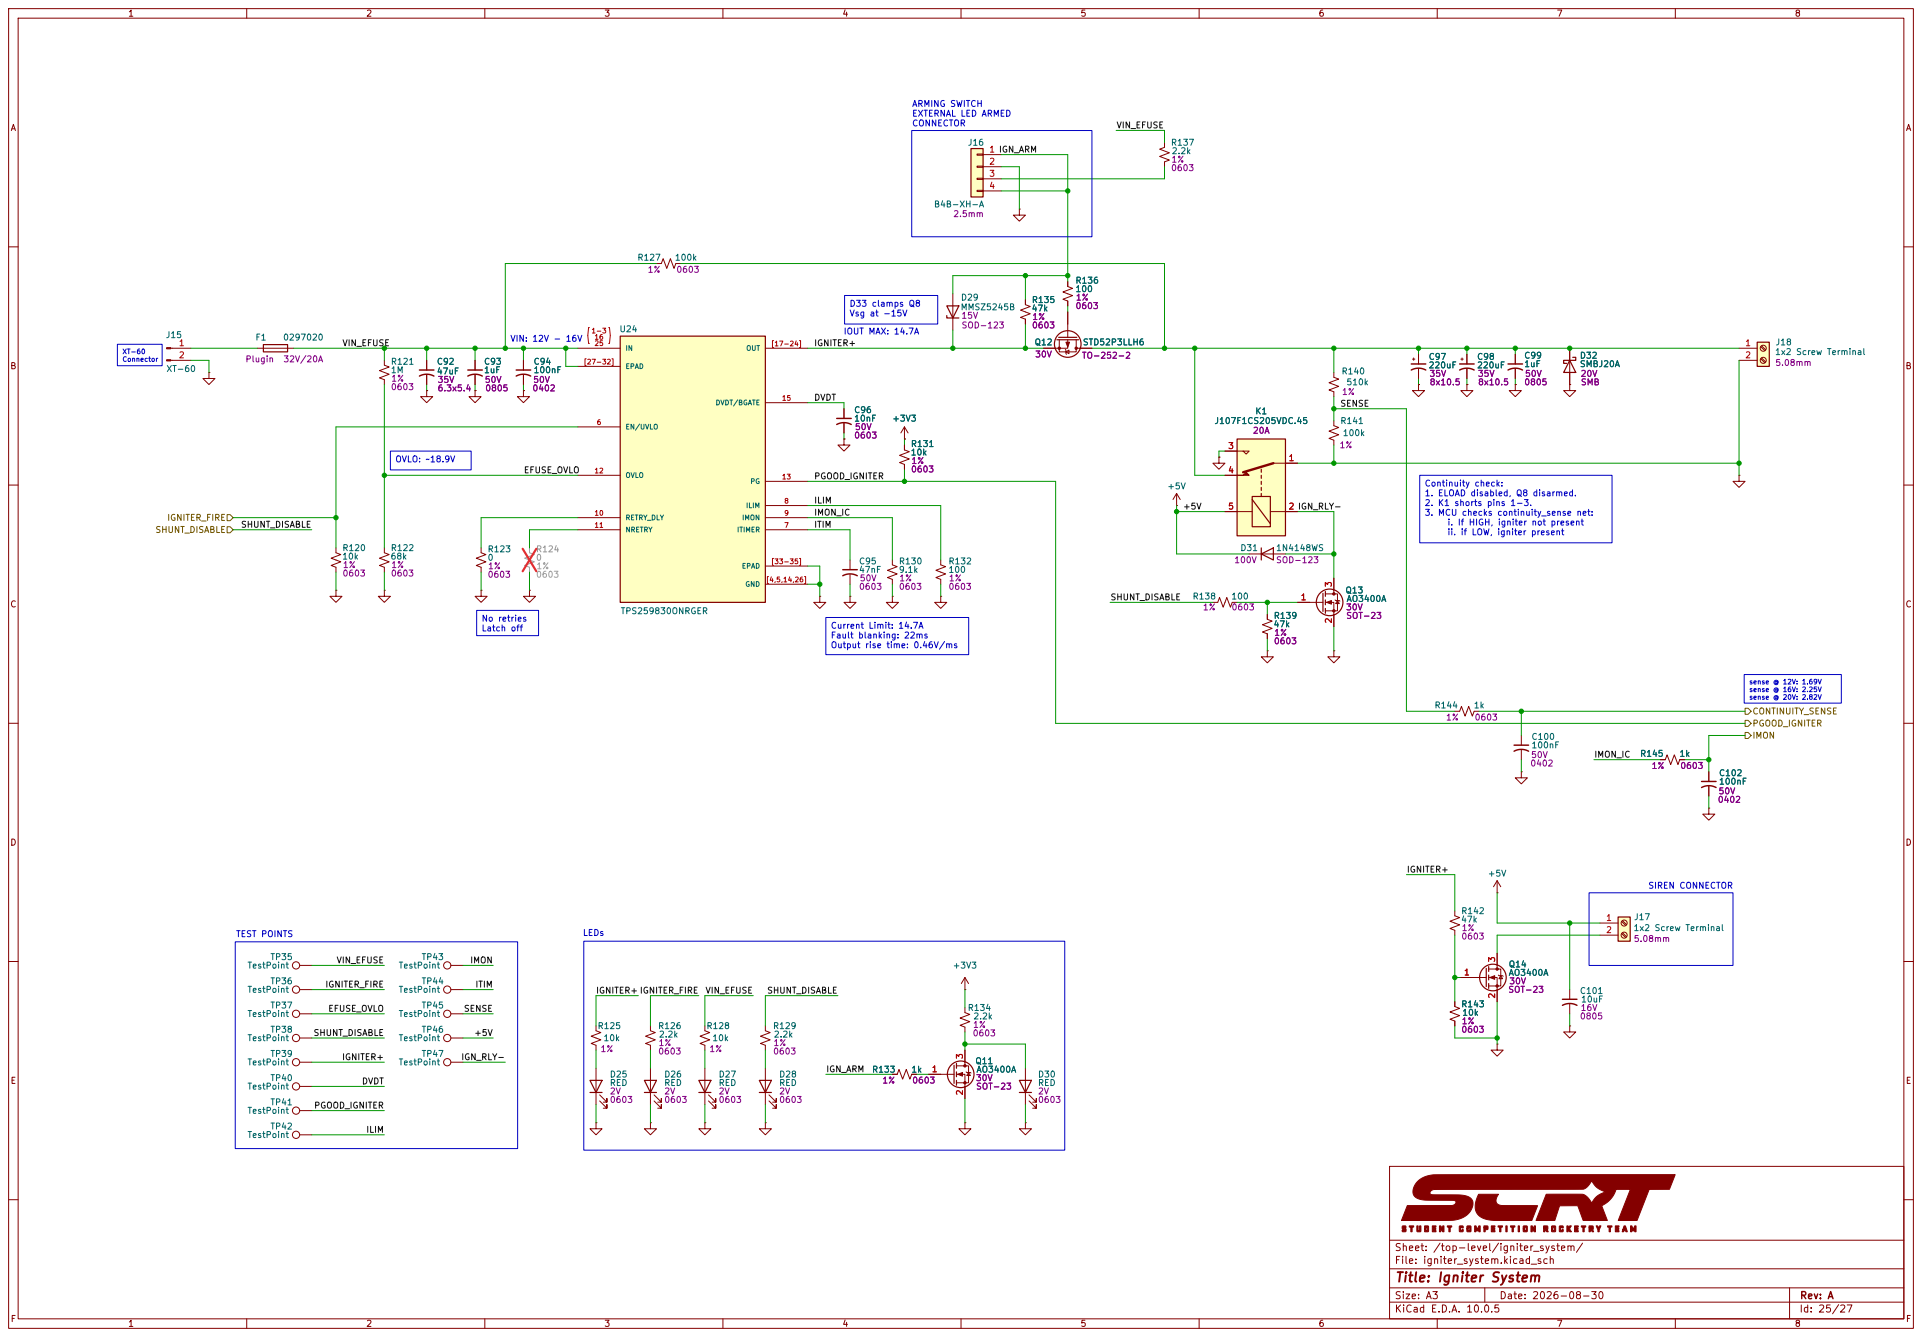
[picture p127: page 25]

Vsg at -15V Current Limit: 14.7A

i. If HIGH, igniter not present

Fault blanking: 22ms Output rise time: 0.46V/ms No retries

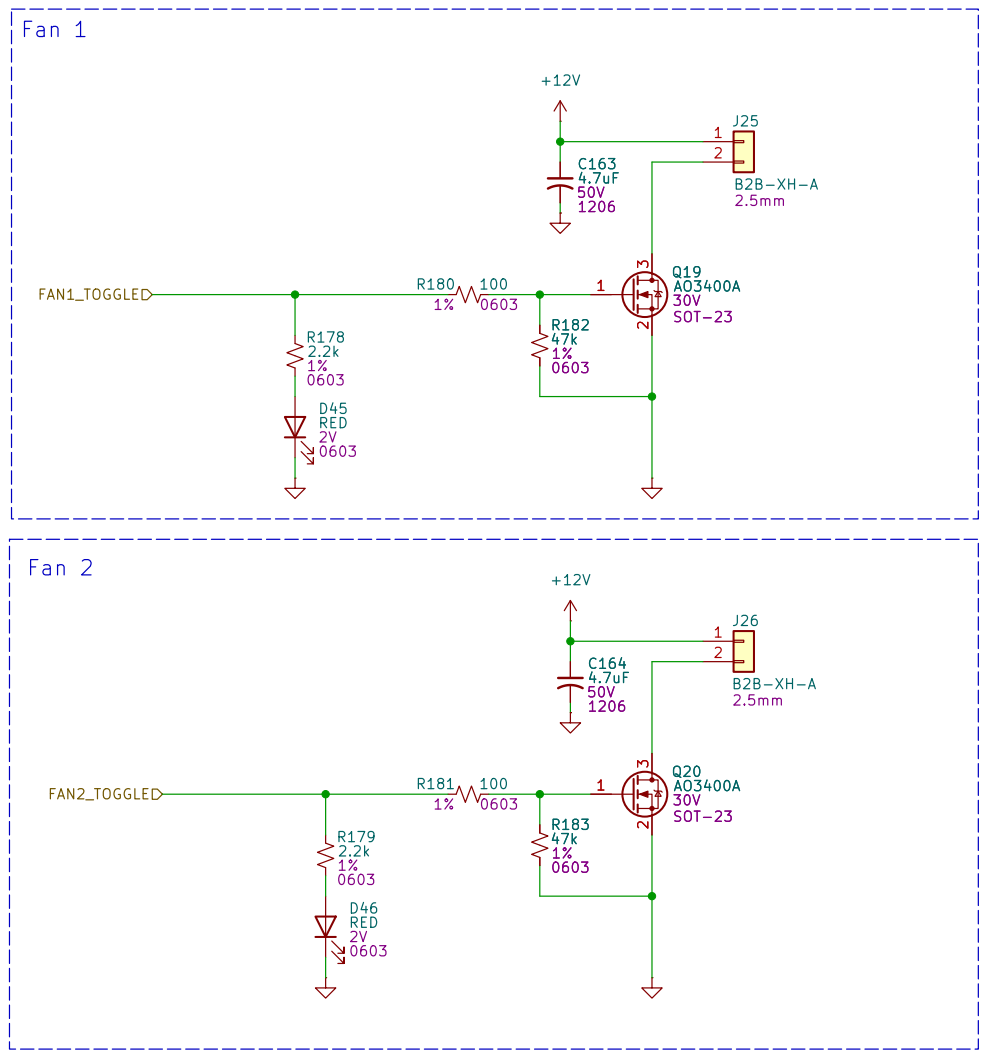
[picture p128: page 26]

Sheet: /top-level/fans/
File: fans.kicad_sch
Title: Fans

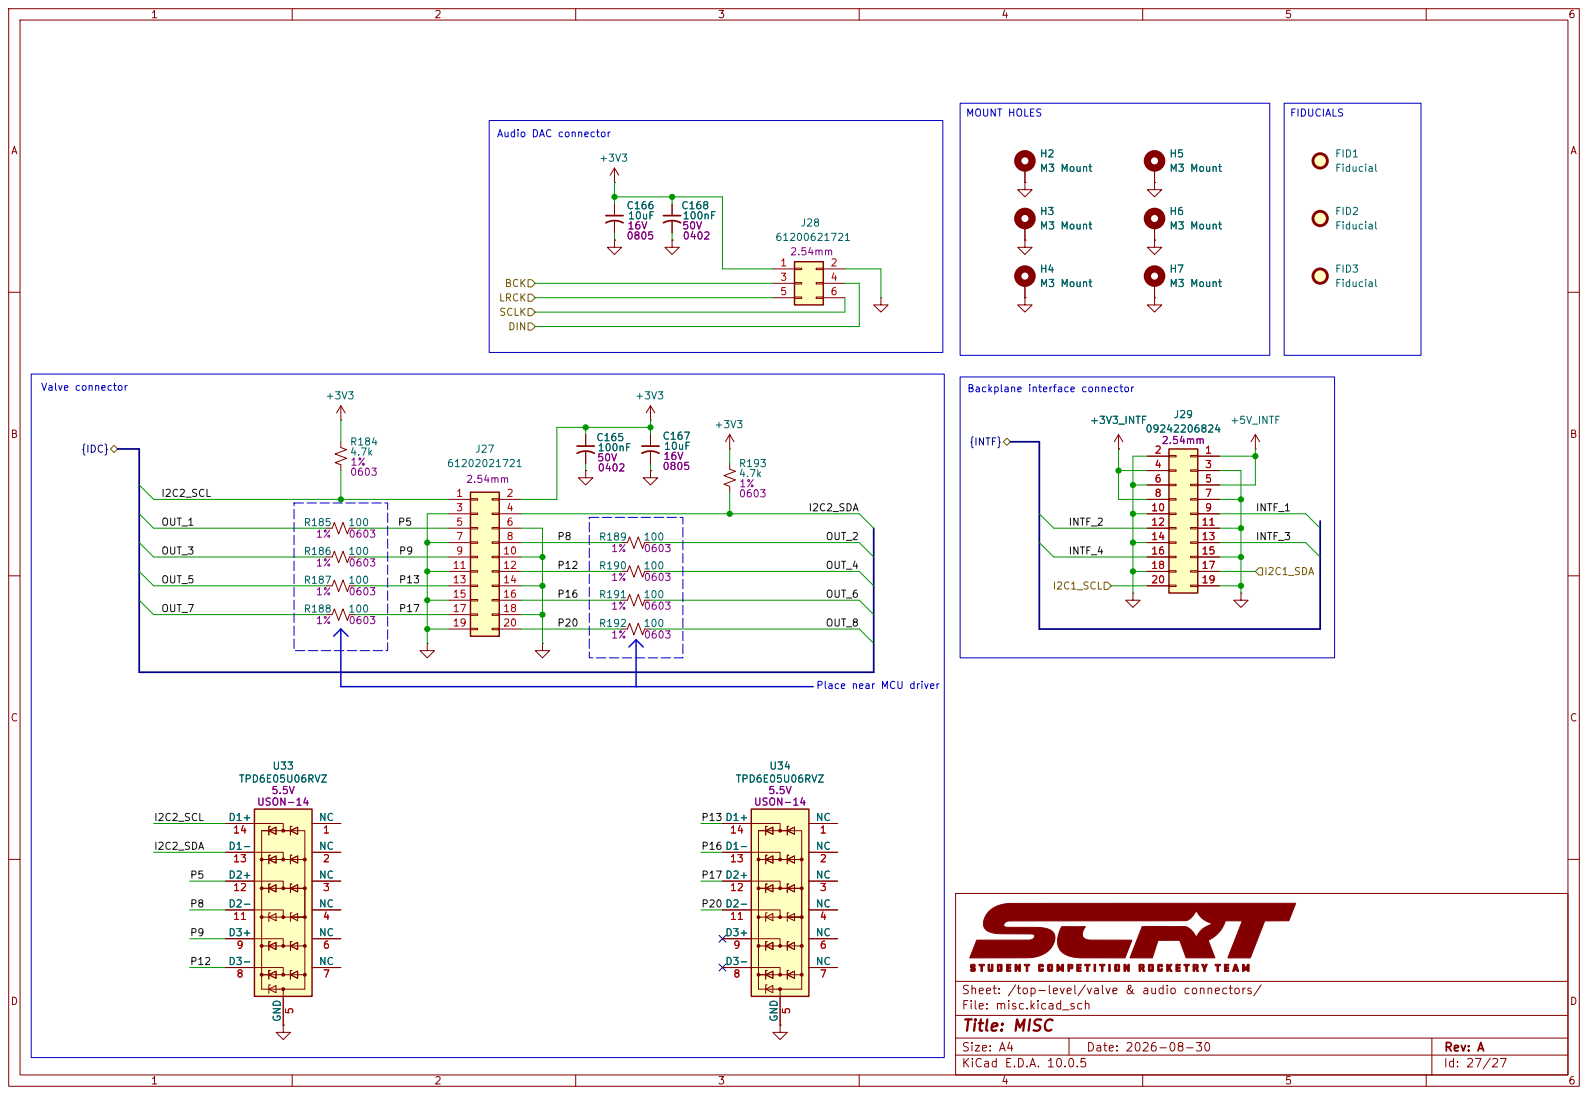
[picture p129: page 27]

Fiducial H2M3 Mount+3V3_INTF H3M3 Mount NC

4 4 | | 3 3
6 6 | | 5 5
8 8 | | 7 7

Sheet: /top-level/valve & audio connectors/
File: misc.kicad_sch
Title: MISC
