Ground-Support-Equipment-SCRT/Pad-Side-Systems/(list of files, drawings)

Other design files:
LRUs/Valve Control Unit/Electrical/Valve Power Board/valve_control_pcb/components/LIB_76829-0102/76829-0102/Altium/76829-0102.SchLib
LRUs/Valve Control Unit/Electrical/Valve Power Board/valve_control_pcb/components/LIB_76829-0102/76829-0102/Altium/768290102.PcbLib
LRUs/Valve Control Unit/Electrical/Valve Power Board/valve_control_pcb/components/LIB_76829-0106/76829-0106/Altium/76829-0106.SchLib
LRUs/Valve Control Unit/Electrical/Valve Power Board/valve_control_pcb/components/LIB_76829-0106/76829-0106/Altium/768290106.PcbLib
