Ground-Support-Equipment-SCRT/Pad-Side-Systems/LRUs/Valve Control Unit/Electrical/Valve Power Board/valve_control_pcb/valve_control_pcb.kicad_pcb

## KiCad design LRUs/Valve Control Unit/Electrical/Valve Power Board/valve_control_pcb/valve_control_pcb.kicad_pcb (2026-10-17)

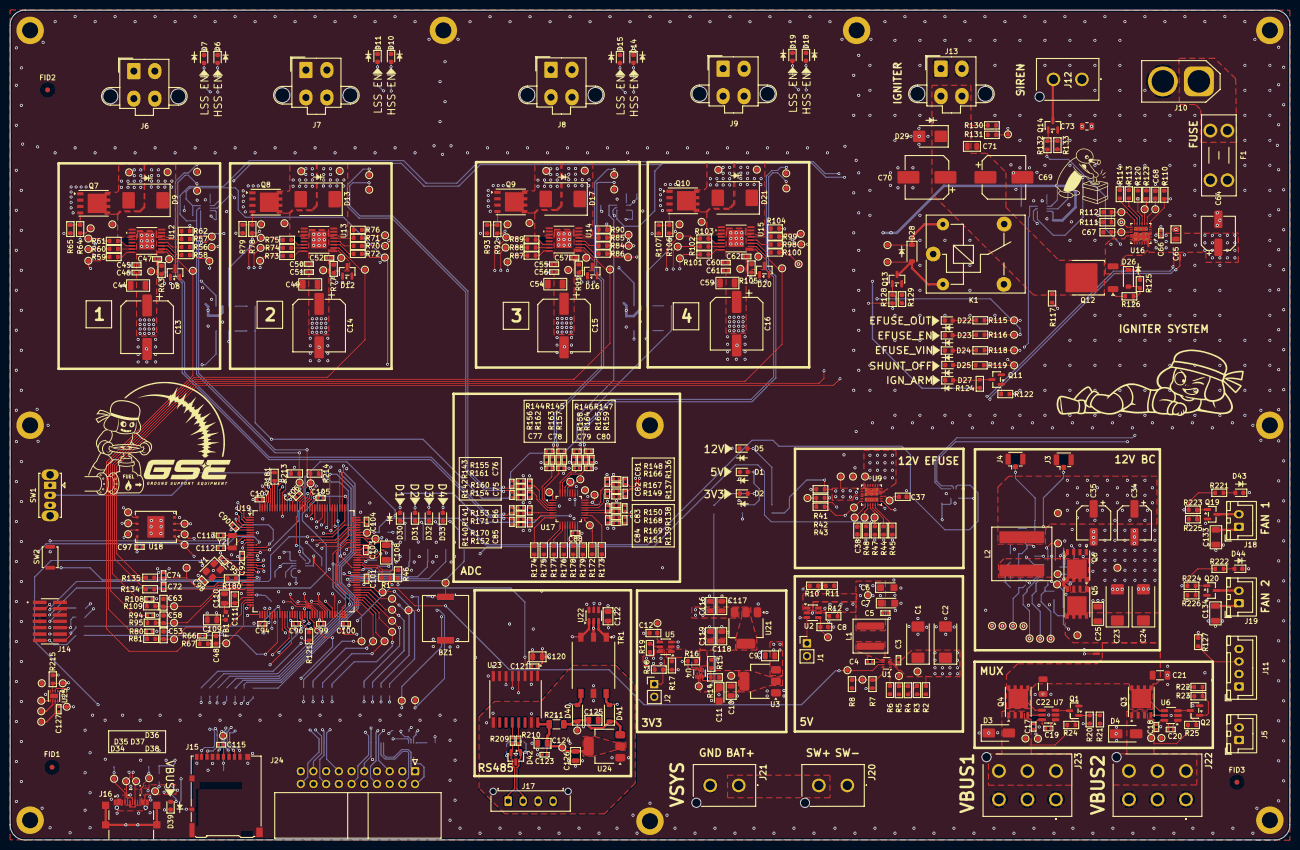
[picture p130: board LRUs/Valve Control Unit/Electrical/Valve Power Board/valve_control_pc… from above]

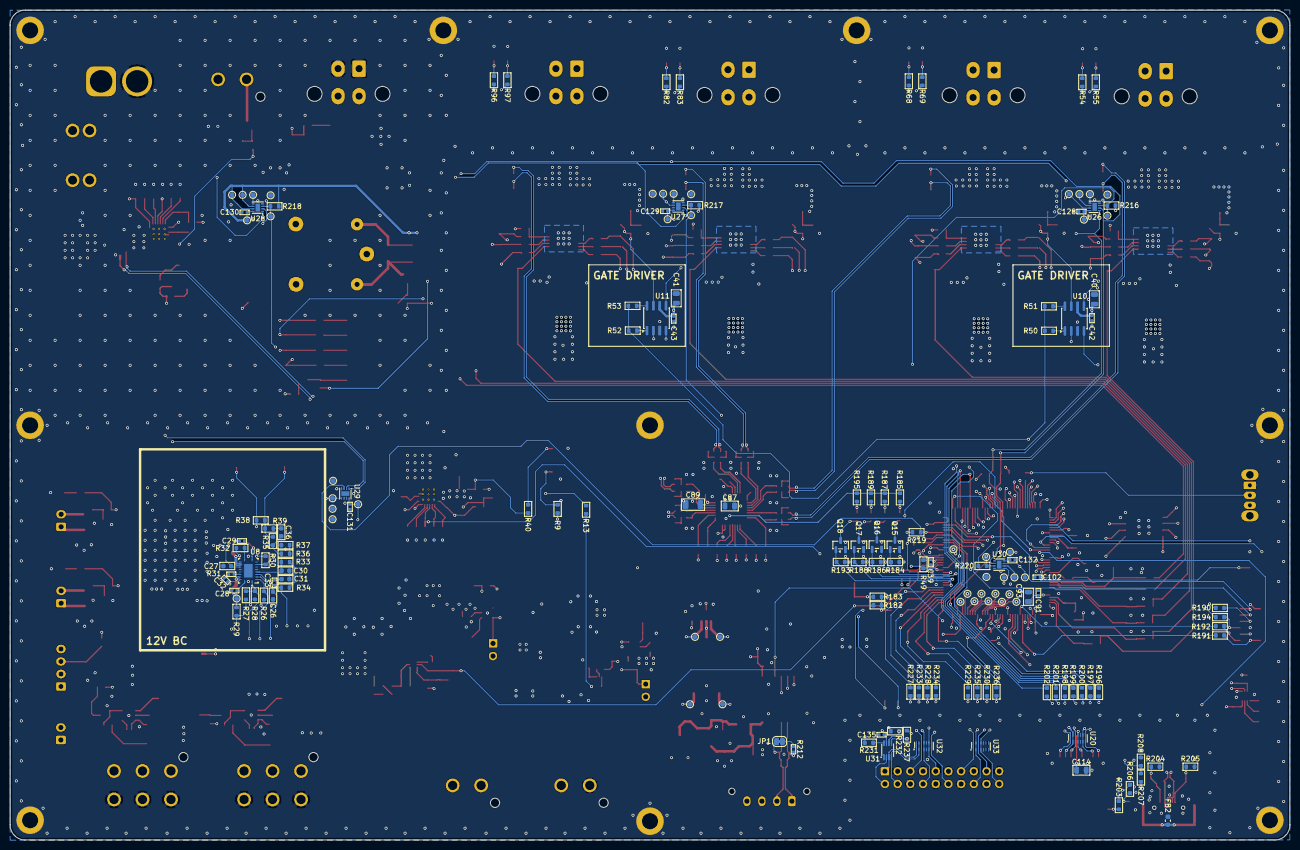
[picture p131: board LRUs/Valve Control Unit/Electrical/Valve Power Board/valve_control_pc… from below]

Board: 6 copper layers, 256.0 x 166.0 mm, 719 parts (162 on the bottom side), 374 nets.

Parts:
BZ1: Buzzer; Buzzer_Murata_PKMCS0909E
C1, C2, C23, C24: 10uF; CP_EIA-7343-31_Kemet-D
C3, C4, C5, C17, C18, C19, C20, C28, C32, C39, C42, C43, C45, C46, C47, C50, C51, C52, C55, C56, C57, C60, C61, C62, C66, C72, C74, C75, C76, C77, C78, C79, C80, C81, C82, C83, C84, C85, C86, C88, C90, C91, C92, C94, C96, C97, C99, C100, C101, C102, C103, C104, C105, C106, C107, C115, C121, C123, C127, C128, C129, C130, C131, C132, C135: 100nF; C_0402_1005Metric
C6, C7, C11: 10uF; CP_EIA-3216-18_Kemet-A
C8, C12, C37, C48, C53, C58, C63, C67, C111: 10nF; C_0603_1608Metric
C9, C10, C40, C41, C65, C71, C87, C93, C109, C110, C117, C118, C120: 1uF; C_0805_2012Metric
C13, C14, C15, C16: 120uF; CP_Elec_10x12.6
C21, C22, C25, C44, C49, C54, C59, C89, C108, C133, C134: 4.7uF; C_1206_3216Metric
C26, C38, C68: 47nF; C_0603_1608Metric
C27: 2.2uF; C_0603_1608Metric
C29, C33, C112, C113: 10pF; C_0402_1005Metric
C30, C31, C36: 330pF; C_0603_1608Metric
C34, C35, C64: 47uF; CP_Elec_6.3x5.4
C69, C70: 220uF; CP_Elec_8x10.5
C73, C114, C116, C119, C122, C124, C125, C126: 10uF; C_0805_2012Metric
C95, C98: 20pF; C_0402_1005Metric
D1, D2, D5, D6, D7, D10, D11, D14, D15, D18, D19, D43, D44: RED; LED_0603_1608Metric
D3, D4: SMAJ24A; D_SMA
D8, D12, D16, D20: BAS21; SOT-23
D9, D13, D17, D21: S3M-E3/57T; D_SMC
D22, D23, D24, D25, D27, D30, D31, D32, D33, D39: WHITE; LED_0603_1608Metric
D26: MMSZ5245B; D_SOD-123
D28: 1N4148WS; D_SOD-123
D29: SMBJ20A; D_SMB
D34, D35, D36, D37, D38: ESD441; X2SON2_DPL_TEX
D40, D41: MBR0520LT1G; D_SOD-123
D42: SM712_SOT23; SOT-23
F1: 0297020; Fuseholder_Blade_Mini_Keystone_3568
FB1, FB2: 120R; L_0603_1608Metric
FID1, FID2, FID3: Fiducial; Fiducial_1mm_Mask3mm
H1, H2, H3, H4, H5, H6, H7, H8, H9, H10: MountingHole_Pad; MountingHole_3.2mm_M3_ISO14580_Pad
J1: 01x02_PinHeader; PinHeader_1x02_P2.54mm_Vertical
J2: Conn_01x02_Pin; PinHeader_1x02_P2.54mm_Vertical
J3, J4: Conn_Coaxial; U.FL_Hirose_U.FL-R-SMT-1_Vertical
J5, J18, J19: B2B-XH-A; JST_XH_B2B-XH-A_1x02_P2.50mm_Vertical
J6, J7, J8, J9, J13: 0039299047; Molex_Mini-Fit_Jr_5566-04A2_2x02_P4.20mm_Vertical
J10: XT-60; AMASS_XT60-M_1x02_P7.20mm_Vertical
J11: B4B-XH-A; JST_XH_B4B-XH-A_1x04_P2.50mm_Vertical
J12, J20, J21: 0768290102; 768290102
J14: Conn_ST_STDC14; SAMTEC_FTSH-107-01-X-DV-K
J15: Micro_SD_Card_Det2; microSD_HC_Hirose_DM3AT-SF-PEJM5
J16: GSB1C41110SSHR; AMPHENOL_GSB1C41110SSHR
J17: 0436500415; Molex_Micro-Fit_3.0_43650-0415_1x04_P3.00mm_Vertical
J22, J23: 0768290106; 768290106
J24: IDC-Header_2x10; IDC-Header_2x10_P2.54mm_Horizontal
JP1: SolderJumper_2_Bridged; SolderJumper-2_P1.3mm_Bridged_RoundedPad1.0x1.5mm
K1: J107F1CS205VDC.45; Relay_SPDT_SANYOU_SRD_Series_Form_C
L1: 15uH; L_Coilcraft_XAL6060-XXX
L2: 4.7uH; L_Coilcraft_XAL1010-XXX
NT1, NT2: NetTie_2; NetTie-2_SMD_Pad0.5mm
Q1, Q2, Q11, Q13, Q14, Q15, Q16, Q17, Q18, Q19, Q20: AO3400A; SOT-23
Q3, Q4, Q5, Q6, Q7, Q8, Q9, Q10: SIR5108DP; PowerPAK_SO-8_Single
Q12: STD52P3LLH6; TO-252-2
R1, R16, R125, R129, R132, R184, R186, R188, R193, R225, R226: 47k; R_0603_1608Metric
R2: 220k; R_0603_1608Metric
R3, R14, R26, R30: 20k; R_0603_1608Metric
R4, R47, R120: 9.1k; R_0603_1608Metric
R5, R11: 51k; R_0603_1608Metric
R6, R44, R45, R50, R51, R52, R53, R113, R114, R172, R173, R174, R175, R176, R177, R178, R179, R190, R191, R192, R194, R196, R197, R198, R200, R201, R202, R227, R228, R229, R230, R233, R234, R235, R236: 0; R_0603_1608Metric
R7, R27, R112: 68k; R_0603_1608Metric
R8: 13k; R_0603_1608Metric
R9, R206: 2k; R_0603_1608Metric
R10, R17: 150k; R_0603_1608Metric
R12, R15, R19, R40, R46, R62, R65, R76, R79, R90, R93, R104, R107, R110, R115, R118, R121, R133, R181, R203: 10k; R_0603_1608Metric
R13: 220; R_0603_1608Metric
R18, R21, R23, R24, R25, R43, R117, R131, R207: 100k; R_0603_1608Metric
R20, R22, R49, R122, R134, R135: 1k; R_0603_1608Metric
R28: 8.2k; R_0603_1608Metric
R29: 2; R_0603_1608Metric
R31, R209, R210: 10; R_0402_1005Metric_GSE
R32: 680; R_0603_1608Metric
R33, R48, R64, R78, R92, R106, R123, R126, R128, R183, R223, R224: 100; R_0603_1608Metric
R34: 1.8k; R_0603_1608Metric
R35: 18k; R_0603_1608Metric
R36: 1.2k; R_0603_1608Metric
R37, R39: 75; R_0603_1608Metric
R38: 10; R_0603_1608Metric
R41, R111, R182: 1M; R_0603_1608Metric
R42: 22k; R_0603_1608Metric
R54, R55, R63, R68, R69, R77, R82, R83, R91, R96, R97, R105, R185, R187, R189, R195, R213, R214, R215, R216, R217, R218, R219, R220, R232, R237: 4.7k; R_0603_1608Metric
R56, R57, R58, R59, R60, R61, R67, R70, R71, R72, R73, R74, R75, R81, R84, R85, R86, R87, R88, R89, R95, R98, R99, R100, R101, R102, R103, R109: 15k; R_0603_1608Metric
R66, R80, R94, R108: 680; R_0402_1005Metric_GSE
R116, R119, R124, R127, R221, R222: 2.2k; R_0603_1608Metric
R130: 510k; R_0603_1608Metric
R136, R137, R138, R139, R140, R141, R142, R143, R144, R145, R146, R147: 15k; R_0402_1005Metric_GSE
R148, R149, R150, R151, R152, R153, R154, R155, R156, R157, R158, R159: 90.9k; R_0402_1005Metric_GSE
R160, R161, R162, R163, R164, R165, R166, R167, R168, R169, R170, R171: 1k; R_0402_1005Metric_GSE
R180: 390; R_0603_1608Metric
R199: 22; R_0603_1608Metric
R204, R205: 5.1k; R_0603_1608Metric
R208, R231: 200k; R_0603_1608Metric
R211: 0; R_1206_3216Metric
R212: 120; R_0402_1005Metric_GSE
SW1: SW_SPDT; SW_Slide_SPDT_Straight_CK_OS102011MS2Q
SW2: SW_Push; SW_Push_SPST_NO_Alps_SKRK
TP1, TP2, TP3, TP4, TP5, TP6, TP7, TP8, TP9, TP10, TP11, TP12, TP13, TP14, TP15, TP16, TP17, TP18, TP19, TP20, TP21, TP22, TP23, TP24, TP25, TP26, TP27, TP28, TP29, TP30, TP31, TP32, TP33, TP34, TP35, TP36, TP37, TP38, TP39, TP40, TP41, TP42, TP43, TP44, TP45, TP46, TP47, TP48, TP49, TP50, TP51, TP52, TP53, TP54, TP55, TP56, TP57, TP58, TP59, TP60, TP61, TP62, TP63, TP64, TP65, TP66, TP67, TP68, TP69, TP70, TP71, TP72, TP73, TP74, TP75, TP76, TP77, TP78, TP79, TP80, TP81, TP82, TP83, TP84, TP85, TP86, TP87, TP88, TP89, TP90, TP91, TP92, TP93, TP94, TP95, TP96, TP97, TP98, TP99, TP100, TP101, TP102, TP103, TP104, TP105, TP106, TP107, TP108, TP109, TP110, TP111, TP112, TP113, TP114, TP115, TP116, TP117, TP118, TP119, TP120, TP121, TP122, TP123, TP124, TP125, TP126, TP127, TP128, TP129, TP130, TP131, TP132, TP133, TP134, TP135, TP136, TP137, TP138, TP139, TP140, TP141, TP142, TP143, TP144, TP145, TP146, TP147, TP148, TP149, TP150, TP151, TP152, TP153, TP154, TP155, TP156, TP157, TP158, TP159, TP160, TP161, TP162, TP163, TP164, TP165, TP166, TP167, TP168, TP169, TP170, TP171, TP172, TP173, TP174, TP175, TP176, TP177, TP178, TP179, TP180, TP181, TP182, TP183, TP184, TP185, TP186, TP187, TP188, TP189, TP190, TP191, TP192, TP193, TP194, TP195, TP196, TP197, TP198: TestPoint; TestPoint_Pad_D1.0mm
TR1: 750315371; Transformer_Wuerth_750315371
U1: TPS62933P; SOT-583-8
U2, U5: TPS22810DBV; SOT-23-6
U3, U21: AMS1117-3.3; SOT-223-3_TabPin2
U4: TPS2116DRL; SOT-583-8
U6, U7: LM74700; SOT-23-6_Handsoldering
U8: LM5145RGYR
U9: TPS259830; IC_TPS259830ONRGER
U10, U11: UCC27524D; SOIC-8_3.9x4.9mm_P1.27mm
U12, U13, U14, U15: TPS27SA08CPWPR; TSSOP_CPWPR_TEX
U16: TPS259830ONRGER; IC_TPS259830ONRGER
U17: ADS124S08IPBSR; QFP50P700X700X120-32N
U18: W25Q128JVE; WSON-8-1EP_8x6mm_P1.27mm_EP3.4x4.3mm
U19: STM32L496ZGT6; LQFP-144_20x20mm_P0.5mm
U20, U32, U33: TPD6E05U06RVZ; Texas_R-PUSON-N14
U22: SN6505BDBVR; SOT-23-6
U23: ISO1450BDWR; SOIC127P1030X265-16N
U24: AMS1117-5.0; SOT-223-3_TabPin2
U25, U26, U27, U28, U29, U30: TMP1075DSGR; Texas_DSG0008A_WSON-8-1EP_2x2mm_P0.5mm_EP0.9x1.6mm
U31: PCA9306DC1Z; VSSOP-8_2.3x2mm_P0.5mm
Y1: 8MHz; Crystal_SMD_3225-4Pin_3.2x2.5mm
Y2: 32KHz; Crystal_SMD_3215-2Pin_3.2x1.5mm

Connections:
3V3_EXT: J24.2, U31.2 (VREF1)
3V3_STATUS: R16.2, U4.8 (ST), U19.15 (PF5)
3V3_USB: C118.1, C119.1, U4.6 (VIN2), U21.2 (VO)
5V_MAIN_PG: R1.2, TP1.1 (1_1), U1.7 (PG), U19.89 (PG4)
+3V3: C88.1, C90.1, C92.1, C94.1, C96.1, C97.1, C99.1, C100.1, C101.1, C103.1, C104.1, C105.1, C106.1, C107.1, C108.1, C109.1, C114.1, C115.1, C120.1, C121.1, C127.1, C128.1, C129.1, C130.1, C131.1, C132.1, C135.1, FB1.1, J14.3 (VCC), J15.4 (VDD), R1.1, R19.2, R46.1, R62.1, R76.1, R90.1, R104.1, R121.1, R124.1, R203.1, R213.2, R214.2, R215.2, R216.2, R217.2, R218.2, R219.2, R220.2, R231.2, R232.2, R237.2, SW1.3 (C), TP134.1 (1_1), TP153.1 (1_1), TP155.1 (1_1), TP159.1 (1_1), TP162.1 (1_1), TP165.1 (1_1), TP167.1 (1_1), TP168.1 (1_1), TP171.1 (1_1), TP175.1 (1_1), TP177.1 (1_1), TP179.1 (1_1), TP181.1 (1_1), TP183.1 (1_1), U5.6 (VOUT), U17.15 (IOVDD), U17.16 (DVDD), U18.8 (VCC), U19.6 (VBAT), U19.17 (VDD), U19.39 (VDD), U19.52 (VDD), U19.62 (VDD), U19.72 (VDD), U19.84 (VDD), U19.95 (VDDIO2), U19.106 (VDDUSB), U19.108 (VDD), U19.121 (VDD), U19.131 (VDDIO2), U19.144 (VDD), U23.1 (VCC1), U25.8 (V+), U26.7 (A0), U26.8 (V+), U27.6 (A1), U27.8 (V+), U28.6 (A1), U28.7 (A0), U28.8 (V+), U29.5 (A2), U29.8 (V+), U30.5 (A2), U30.7 (A0), U30.8 (V+), U31.7 (VREF2)
+5V: C40.1, C41.1, C42.1, C43.1, C87.1, C122.1, D28.1 (K), K1.5, R12.2, R185.2, R187.2, R189.2, R195.2, TP108.1 (1_1), TR1.2, U2.6 (VOUT), U10.6 (V_{DD}), U11.6 (V_{DD}), U17.26 (AVDD), U22.2 (VCC), U22.5 (EN)
+12V: C34.1, C35.1, C73.1, C133.1, C134.1, J3.1 (In), J12.1, J18.1, J19.1, L2.2, R38.2, R40.1, R41.2, TP23.1 (1_1), TP24.1 (1_1), U9.1 (IN), U9.2 (IN), U9.3 (IN), U9.16 (IN), U9.25 (IN), U9.27 (EPAD), U9.28 (EPAD), U9.29 (EPAD), U9.30 (EPAD), U9.31 (EPAD), U9.32 (EPAD)
/ADC/AINCOM: TP112.1 (1_1), U17.1 (AINCOM)
/ADC/CLK: R172.2, TP114.1 (1_1), U17.17 (CLK)
/ADC/IGN_VSENSE_DIV_N: R137.1, R149.2, R167.2
/ADC/IGN_VSENSE_DIV_P: R136.1, R148.2, R166.2
/ADC/IGN_VSENSE_FILT_N: C82.1, R167.1, U17.21 (GPIO1/AIN9)
/ADC/IGN_VSENSE_FILT_P: C81.1, R166.1, U17.22 (GPIO0/AIN8)
/ADC/MISO: R178.2, U17.12 (DOUT/~DRDY)
/ADC/MOSI: R177.2, U17.10 (DIN)
/ADC/REFN0: TP110.1 (1_1), U17.29 (REFN0)
/ADC/REFOUT: C89.1, TP115.1 (1_1), U17.23 (REFOUT)
/ADC/REFP0: TP111.1 (1_1), U17.30 (REFP0)
/ADC/SCLK: R176.2, U17.11 (SCLK)
/ADC/START: R174.2, U17.8 (START/SYNC)
/ADC/VALVE1_VSENSE_DIV_N: R141.1, R153.2, R171.2
/ADC/VALVE1_VSENSE_DIV_P: R140.1, R152.2, R170.2
/ADC/VALVE1_VSENSE_FILT_N: C86.1, R171.1, U17.6 (AIN1)
/ADC/VALVE1_VSENSE_FILT_P: C85.1, R170.1, U17.7 (AIN0)
/ADC/VALVE2_VSENSE_DIV_N: R143.1, R155.2, R161.2
/ADC/VALVE2_VSENSE_DIV_P: R142.1, R154.2, R160.2
/ADC/VALVE2_VSENSE_FILT_N: C76.1, R161.1, U17.4 (AIN3)
/ADC/VALVE2_VSENSE_FILT_P: C75.1, R160.1, U17.5 (AIN2)
/ADC/VALVE3_VSENSE_DIV_N: R145.1, R157.2, R163.2
/ADC/VALVE3_VSENSE_DIV_P: R144.1, R156.2, R162.2
/ADC/VALVE3_VSENSE_FILT_N: C78.1, R163.1, U17.2 (AIN5)
/ADC/VALVE3_VSENSE_FILT_P: C77.1, R162.1, U17.3 (AIN4)
/ADC/VALVE4_VSENSE_DIV_N: R147.1, R159.2, R165.2
/ADC/VALVE4_VSENSE_DIV_P: R146.1, R158.2, R164.2
/ADC/VALVE4_VSENSE_FILT_N: C80.1, R165.1, U17.31 (REFN1/AIN7)
/ADC/VALVE4_VSENSE_FILT_P: C79.1, R164.1, U17.32 (REFP1/AIN6)
/ADC/VBUS_VSENSE_DIV_N: R139.1, R151.2, R169.2
/ADC/VBUS_VSENSE_DIV_P: R138.1, R150.2, R168.2
/ADC/VBUS_VSENSE_FILT_N: C84.1, R169.1, U17.19 (GPIO3/AIN11)
/ADC/VBUS_VSENSE_FILT_P: C83.1, R168.1, U17.20 (GPIO2/AIN10)
/ADC/~CS: R175.2, U17.9 (~CS)
/ADC/~DRDY: R179.2, U17.13 (~DRDY)
/ADC/~RESET: R173.2, U17.18 (~RESET)
/Connectors/I2C_SLAVE_SCL: J24.1, U31.3 (SCL1), U32.14 (D1+)
/Connectors/I2C_SLAVE_SDA: J24.4, U31.4 (SDA1), U32.13 (D1-)
/Connectors/PIN5: J24.5, R227.1, U32.12 (D2+)
/Connectors/PIN8: J24.8, R233.2, U32.11 (D2-)
/Connectors/PIN9: J24.9, R228.1, U32.9 (D3+)
/Connectors/PIN12: J24.12, R234.2, U32.8 (D3-)
/Connectors/PIN13: J24.13, R229.1, U33.14 (D1+)
/Connectors/PIN16: J24.16, R235.2, U33.13 (D1-)
/Connectors/PIN17: J24.17, R230.1, U33.12 (D2+)
/Connectors/PIN20: J24.20, R236.2, U33.11 (D2-)
/Connectors/VSYS_BAT+: J20.2, J21.1
/Igniter/DVDT: C67.1, TP102.1 (1_1), U16.15 (DVDT/BGATE)
/Igniter/EFUSE_OVLO: R111.1, R112.1, TP99.1 (1_1), U16.12 (OVLO)
/Igniter/IGNITER+: D26.1 (K), Q12.3 (S), R115.1, R125.2, R132.1, TP101.1 (1_1), U16.17 (OUT), U16.18 (OUT), U16.19 (OUT), U16.20 (OUT), U16.21 (OUT), U16.22 (OUT), U16.23 (OUT), U16.24 (OUT)
/Igniter/IGN_ARM: D26.2 (A), J11.1, J11.4, R122.2, R125.1, R126.2
/Igniter/IGN_RLY-: D28.2 (A), K1.2, Q13.3 (D), TP109.1 (1_1)
/Igniter/ILIM: R123.2, TP104.1 (1_1), U16.8 (ILIM)
/Igniter/IMON_IC: R120.2, R135.2, U16.9 (IMON)
/Igniter/ITIM: C68.1, TP106.1 (1_1), U16.7 (ITIMER)
/Igniter/SENSE: R130.1, R131.2, R134.2, TP107.1 (1_1)
/RS-485/5V_ISO: C125.1, D40.1 (K), D41.1 (K), R211.2, TP145.1 (1_1), U24.3 (VI)
/RS-485/5V_ISO_FILT: C123.1, C124.1, C126.1, R211.1, TP146.1 (1_1), U23.16 (VCC2), U24.2 (VO)
/RS-485/A1: TP141.1 (1_1), TR1.3, U22.1 (D1)
/RS-485/A2: TP142.1 (1_1), TR1.1, U22.3 (D2)
/RS-485/A_RX_MAIN_N: R210.2, U23.13 (B)
/RS-485/A_RX_MAIN_P: R209.2, U23.12 (A)
/RS-485/B1: D40.2 (A), TP143.1 (1_1), TR1.4
/RS-485/B2: D41.2 (A), TP144.1 (1_1), TR1.6
/RS-485/RX_MAIN_N: D42.1 (A1), J17.2, JP1.1 (A), R210.1
/RS-485/RX_MAIN_P: D42.2 (A2), J17.1, R209.1, R212.2
/STM32/BOOT: R181.1, U19.138 (PH3)
/STM32/D1: Q15.1 (G), R184.1, U19.86 (PD15)
/STM32/D2: Q16.1 (G), R186.1, U19.85 (PD14)
/STM32/D3: Q17.1 (G), R188.1, U19.82 (PD13)
/STM32/D4: Q18.1 (G), R193.1, U19.81 (PD12)
/STM32/JTDI: J14.10 (JTDI/NC), R194.1
/STM32/JTDI_STM32: R194.2, U19.110 (SYS_JTDI)
/STM32/JTDO: J14.8 (JTDO/SWO), R190.1
/STM32/NRST: C102.2, J14.12 (~RST), SW2.2, U19.25 (NRST)
/STM32/QUADSPI_BK1_IO0: TP118.1 (1_1), U18.5 (DI/IO_{0}), U19.20 (QUADSPI_BK1_IO0)
/STM32/QUADSPI_BK1_IO1: TP119.1 (1_1), U18.2 (DO/IO_{1}), U19.21 (QUADSPI_BK1_IO1)
/STM32/QUADSPI_BK1_IO2: TP117.1 (1_1), U18.3 (~WP/IO_{2}), U19.19 (QUADSPI_BK1_IO2)
/STM32/QUADSPI_BK1_IO3: TP116.1 (1_1), U18.7 (~HOLD/~RESET/IO_{3}), U19.18 (QUADSPI_BK1_IO3)
/STM32/QUADSPI_CLK: TP120.1 (1_1), U18.6 (CLK), U19.22 (QUADSPI_CLK)
/STM32/SWCLK: J14.6 (JCLK/SWCLK), U19.109 (SYS_JTCK-SWCLK)
/STM32/SWDIO: J14.4 (JTMS/SWDIO), U19.105 (SYS_JTMS-SWDIO)
/STM32/VDDA: C110.1, C111.1, FB1.2, U19.33 (VDDA)
/STM32/~QUADSPI_BK1_NCS: TP121.1 (1_1), U18.1 (~CS), U19.36 (QUADSPI_BK1_NCS)
/System Power/LDO 3V3/VIN: C5.1, C6.1, C7.1, C9.1, L1.2, R7.1, R9.2, R10.2, TP4.1 (1_1), U2.1 (VIN), U3.3 (VI)
/System Power/LDO 3V3/VOUT: C10.1, C11.1, R13.1, R14.2, TP7.1 (1_1), U3.2 (VO), U4.3 (VIN1), U4.5 (MODE)
/System Power/LSW 3V3/CT: C12.1, TP9.1 (1_1), U5.4 (CT)
/System Power/LSW 3V3/EN_UVLO: J2.1, R17.1, R18.2, U5.3 (EN/UVLO)
/System Power/LSW 3V3/QOD: R19.1, U5.5 (QOD)
/System Power/LSW 3V3/VIN: R16.1, R17.2, TP8.1 (1_1), U4.2 (VOUT), U4.7 (VOUT), U5.1 (VIN)
/System Power/LSW 5V/CT: C8.1, TP6.1 (1_1), U2.4 (CT)
/System Power/LSW 5V/EN_UVLO: J1.1, R10.1, R11.1, U2.3 (EN/UVLO)
/System Power/LSW 5V/QOD: R12.1, U2.5 (QOD)
/System Power/MUX 3V3/PR1: R14.1, R15.1, U4.4 (PR1)
/System Power/System 5V/BST: C4.1, U1.6 (BST)
/System Power/System 5V/FB: R7.2, R8.1, TP5.1 (1_1), U1.8 (FB)
/System Power/System 5V/RT: R6.2, U1.1 (RT)
/System Power/System 5V/SW: C4.2, L1.1, U1.5 (SW)
/System Power/System 5V/VEN: R4.1, R5.1, TP3.1 (1_1), U1.2 (EN)
/USB-C/V5P0_USB: C116.1, C117.1, D38.1 (K), J16.A4_B9 (VBUS_A), J16.B4_A9 (VBUS_B), R206.2, R207.2, TP135.1 (1_1), U21.3 (VI)
/Valves/12V_VALVES: C13.1, C14.1, C15.1, C16.1, C44.1, C45.1, C46.1, C47.1, C49.1, C50.1, C51.1, C52.1, C54.1, C55.1, C56.1, C57.1, C59.1, C60.1, C61.1, C62.1, TP32.1 (1_1), TP33.1 (1_1), TP49.1 (1_1), TP65.1 (1_1), TP81.1 (1_1), U9.17 (OUT), U9.18 (OUT), U9.19 (OUT), U9.20 (OUT), U9.21 (OUT), U9.22 (OUT), U9.23 (OUT), U9.24 (OUT), U12.EPAD (VBB), U13.EPAD (VBB), U14.EPAD (VBB), U15.EPAD (VBB)
/Valves/12V_main/BST: R31.2, U8.17 (BST)
/Valves/12V_main/COMP: C31.2, C33.1, TP17.1 (1_1), U8.4 (COMP)
/Valves/12V_main/EN_UVLO: R27.1, R28.2, TP14.1 (1_1), U8.1 (EN_UVLO)
/Valves/12V_main/FB: C30.1, C36.2, R33.1, R35.1, R36.2, TP20.1 (1_1), U8.5 (FB)
/Valves/12V_main/HO: Q5.4 (G), U8.18 (HO)
/Valves/12V_main/ILIM: C29.1, R32.2, U8.11 (ILIM)
/Valves/12V_main/LO: Q6.4 (G), U8.13 (LO)
/Valves/12V_main/RT: R26.2, TP12.1 (1_1), U8.2 (RT)
/Valves/12V_main/SENSE_OUT: J4.1 (In), R35.2, R38.1, R39.2
/Valves/12V_main/SS_TRK: C26.1, TP13.1 (1_1), U8.3 (SS_TRK)
/Valves/12V_main/SW: C32.2, L2.1, Q5.1 (S), Q5.2 (S), Q5.3 (S), Q6.5 (D), R32.1, TP21.1 (1_1), U8.19 (SW)
/Valves/12V_main/SYNCIN: R30.2, TP15.1 (1_1), U8.8 (SYNCIN)
/Valves/12V_main/VCC: C27.1, R30.1, U8.14 (VCC)
/Valves/12V_main/VIN_S: C28.1, R29.1, TP16.1 (1_1), U8.20 (VIN)
/Valves/Gate Drivers/OUTA1: R69.2, R78.2, TP51.1 (1_1), U10.7 (OUTA)
/Valves/Gate Drivers/OUTA2: R97.2, R106.2, TP83.1 (1_1), U11.7 (OUTA)
/Valves/Gate Drivers/OUTB1: R55.2, R64.2, TP35.1 (1_1), U10.5 (OUTB)
/Valves/Gate Drivers/OUTB2: R83.2, R92.2, TP67.1 (1_1), U11.5 (OUTB)
/Valves/Valve 1/12V_OUT+: D9.1 (K), J6.4, TP44.1 (1_1), U12.6 (VOUT), U12.7 (VOUT), U12.8 (VOUT), U12.9 (VOUT), U12.10 (VOUT), U12.11 (VOUT)
/Valves/Valve 1/12V_OUT-: D9.2 (A), J6.3, Q7.5 (D), TP45.1 (1_1)
/Valves/Valve 1/LFET_GATE: Q7.4 (G), R64.1, R65.1
/Valves/Valve 1/LSW_DIA_EN_PROT: R59.1, U12.16 (DIA_EN)
/Valves/Valve 1/LSW_LATCH_PROT: R58.1, U12.3 (LATCH)
/Valves/Valve 1/LSW_SEL1_PROT: R61.1, U12.14 (SEL1)
/Valves/Valve 1/LSW_SEL2_PROT: R60.1, U12.15 (SEL2)
/Valves/Valve 1/LSW_SNS_PROT: R66.2, R67.2, TP43.1 (1_1), U12.2 (SNS)
/Valves/Valve 1/MODGND: C47.2, D8.3 (K), R63.2, TP41.1 (1_1), U12.1 (GND)
/Valves/Valve 1/~LSW_ST_PROT: R57.1, R62.2, U12.5 (~ST)
/Valves/Valve 2/12V_OUT+: D13.1 (K), J7.4, TP60.1 (1_1), U13.6 (VOUT), U13.7 (VOUT), U13.8 (VOUT), U13.9 (VOUT), U13.10 (VOUT), U13.11 (VOUT)
/Valves/Valve 2/12V_OUT-: D13.2 (A), J7.3, Q8.5 (D), TP61.1 (1_1)
/Valves/Valve 2/LFET_GATE: Q8.4 (G), R78.1, R79.1
/Valves/Valve 2/LSW_DIA_EN_PROT: R73.1, U13.16 (DIA_EN)
/Valves/Valve 2/LSW_LATCH_PROT: R72.1, U13.3 (LATCH)
/Valves/Valve 2/LSW_SEL1_PROT: R75.1, U13.14 (SEL1)
/Valves/Valve 2/LSW_SEL2_PROT: R74.1, U13.15 (SEL2)
/Valves/Valve 2/LSW_SNS_PROT: R80.2, R81.2, TP59.1 (1_1), U13.2 (SNS)
/Valves/Valve 2/MODGND: C52.2, D12.3 (K), R77.2, TP57.1 (1_1), U13.1 (GND)
/Valves/Valve 2/~LSW_ST_PROT: R71.1, R76.2, U13.5 (~ST)
/Valves/Valve 3/12V_OUT+: D17.1 (K), J8.4, TP76.1 (1_1), U14.6 (VOUT), U14.7 (VOUT), U14.8 (VOUT), U14.9 (VOUT), U14.10 (VOUT), U14.11 (VOUT)
/Valves/Valve 3/12V_OUT-: D17.2 (A), J8.3, Q9.5 (D), TP77.1 (1_1)
/Valves/Valve 3/LFET_GATE: Q9.4 (G), R92.1, R93.1
/Valves/Valve 3/LSW_DIA_EN_PROT: R87.1, U14.16 (DIA_EN)
/Valves/Valve 3/LSW_LATCH_PROT: R86.1, U14.3 (LATCH)
/Valves/Valve 3/LSW_SEL1_PROT: R89.1, U14.14 (SEL1)
/Valves/Valve 3/LSW_SEL2_PROT: R88.1, U14.15 (SEL2)
/Valves/Valve 3/LSW_SNS_PROT: R94.2, R95.2, TP75.1 (1_1), U14.2 (SNS)
/Valves/Valve 3/MODGND: C57.2, D16.3 (K), R91.2, TP73.1 (1_1), U14.1 (GND)
/Valves/Valve 3/~LSW_ST_PROT: R85.1, R90.2, U14.5 (~ST)
/Valves/Valve 4/12V_OUT+: D21.1 (K), J9.4, TP92.1 (1_1), U15.6 (VOUT), U15.7 (VOUT), U15.8 (VOUT), U15.9 (VOUT), U15.10 (VOUT), U15.11 (VOUT)
/Valves/Valve 4/12V_OUT-: D21.2 (A), J9.3, Q10.5 (D), TP93.1 (1_1)
/Valves/Valve 4/LFET_GATE: Q10.4 (G), R106.1, R107.1
/Valves/Valve 4/LSW_DIA_EN_PROT: R101.1, U15.16 (DIA_EN)
/Valves/Valve 4/LSW_LATCH_PROT: R100.1, U15.3 (LATCH)
/Valves/Valve 4/LSW_SEL1_PROT: R103.1, U15.14 (SEL1)
/Valves/Valve 4/LSW_SEL2_PROT: R102.1, U15.15 (SEL2)
/Valves/Valve 4/LSW_SNS_PROT: R108.2, R109.2, TP91.1 (1_1), U15.2 (SNS)
/Valves/Valve 4/MODGND: C62.2, D20.3 (K), R105.2, TP89.1 (1_1), U15.1 (GND)
/Valves/Valve 4/~LSW_ST_PROT: R99.1, R104.2, U15.5 (~ST)
/Valves/input_mux/VIN1_DIS_GATE: Q1.1 (G), R20.1, R21.2
/Valves/input_mux/VIN1_GATE: Q4.4 (G), U7.5 (GATE)
/Valves/input_mux/VIN2_DIS_GATE: Q2.1 (G), R22.1, R23.2
/Valves/input_mux/VIN2_GATE: Q3.4 (G), U6.5 (GATE)
/Valves/input_mux/~VIN1_SHDN: Q1.3 (D), R24.1, U7.3 (EN)
/Valves/input_mux/~VIN2_SHDN: Q2.3 (D), R25.1, U6.3 (EN)
/Valves/master_efuse/DVDT: C37.1, TP28.1 (1_1), U9.15 (DVDT/BGATE)
/Valves/master_efuse/ILIM: R48.2, TP31.1 (1_1), U9.8 (ILIM)
/Valves/master_efuse/IMON_IC: R47.2, R49.2, TP30.1 (1_1), U9.9 (IMON)
/Valves/master_efuse/ITIM: C38.1, TP29.1 (1_1), U9.7 (ITIMER)
ADC_MISO: R178.1, U19.42 (SPI1_MISO)
ADC_MOSI: R177.1, U19.43 (SPI1_MOSI)
ADC_SCLK: R176.1, U19.41 (PA5)
ADC_START: R174.1, U19.49 (PF11)
CONTINUITY_SENSE: C72.1, R134.1, U19.27 (PC1)
D_N: D35.1 (K), J16.A7 (DN1), J16.B7 (DN2), TP139.1 (1_1), U19.103 (USB_OTG_FS_DM)
D_P: D37.1 (K), J16.A6 (DP1), J16.B6 (DP2), TP140.1 (1_1), U19.104 (USB_OTG_FS_DP)
EFUSE_IMON: C39.1, R49.1, U19.91 (PG6)
EFUSE_PG: R46.2, U9.13 (PG), U19.90 (PG5)
FAN1_TOGGLE: R221.1, R223.1, U19.13 (PF3)
FAN2_TOGGLE: R222.1, R224.1, U19.12 (PF2)
GND: BZ1.2 (-), C1.2, C2.2, C3.2, C5.2, C6.2, C7.2, C8.2, C9.2, C10.2, C11.2, C12.2, C13.2, C14.2, C15.2, C16.2, C17.2, C18.2, C21.2, C22.2, C23.2, C24.2, C25.2, C26.2, C27.2, C28.2, C29.2, C34.2, C35.2, C37.2, C38.2, C39.2, C40.2, C41.2, C42.2, C43.2, C44.2, C45.2, C46.2, C48.2, C49.2, C50.2, C51.2, C53.2, C54.2, C55.2, C56.2, C58.2, C59.2, C60.2, C61.2, C63.2, C64.2, C65.2, C66.2, C67.2, C68.2, C69.2, C70.2, C71.2, C72.2, C73.2, C74.2, C75.2, C76.2, C77.2, C78.2, C79.2, C80.2, C81.2, C82.2, C83.2, C84.2, C85.2, C86.2, C87.2, C88.2, C89.2, C90.2, C91.2, C92.2, C93.2, C94.2, C95.2, C96.2, C97.2, C98.2, C99.2, C100.2, C101.2, C102.1, C103.2, C104.2, C105.2, C106.2, C107.2, C108.2, C109.2, C110.2, C111.2, C112.2, C113.2, C114.2, C115.2, C116.2, C117.2, C118.2, C119.2, C120.2, C121.2, C122.2, C127.2, C128.2, C129.2, C130.2, C131.2, C132.2, C133.2, C134.2, C135.2, D1.1 (K), D2.1 (K), D3.1 (K), D4.1 (K), D5.1 (K), D6.1 (K), D7.1 (K), D8.1 (A), D10.1 (K), D11.1 (K), D12.1 (A), D14.1 (K), D15.1 (K), D16.1 (A), D18.1 (K), D19.1 (K), D20.1 (A), D22.1 (K), D23.1 (K), D24.1 (K), D25.1 (K), D27.1 (K), D29.2 (A), D34.2 (A), D35.2 (A), D36.2 (A), D37.2 (A), D38.2 (A), D39.1 (K), D43.1 (K), D44.1 (K), FB2.2, H1.1 (1_1), H2.1 (1_1), H3.1 (1_1), H4.1 (1_1), H5.1 (1_1), H6.1 (1_1), H7.1 (1_1), H8.1 (1_1), H9.1 (1_1), H10.1 (1_1), J1.2, J2.2, J3.2 (Ext), J4.2 (Ext), J10.2, J11.2, J13.1, J13.2, J14.5 (GND), J14.7 (GND), J14.11 (GNDDetect), J15.6 (VSS), J15.9 (DET_B), J15.SH (SHIELD), J16.A1_B12 (GND_A), J16.B1_A12 (GND_B), J21.2, J22.1, J22.2, J22.3, J23.1, J23.2, J23.3, J24.3, J24.6, J24.7, J24.10, J24.11, J24.14, J24.15, J24.18, J24.19, K1.1, K1.3, NT1.1, NT2.1, Q1.2 (S), Q2.2 (S), Q6.1 (S), Q6.2 (S), Q6.3 (S), Q7.1 (S), Q7.2 (S), Q7.3 (S), Q8.1 (S), Q8.2 (S), Q8.3 (S), Q9.1 (S), Q9.2 (S), Q9.3 (S), Q10.1 (S), Q10.2 (S), Q10.3 (S), Q11.2 (S), Q13.2 (S), Q14.2 (S), Q15.2 (S), Q16.2 (S), Q17.2 (S), Q18.2 (S), Q19.2 (S), Q20.2 (S), R5.2, R6.1, R8.2, R11.2, R15.2, R18.1, R21.1, R23.1, R26.1, R28.1, R37.1, R43.1, R44.1, R45.1, R47.1, R48.1, R63.1, R65.2, R66.1, R77.1, R79.2, R80.1, R91.1, R93.2, R94.1, R105.1, R107.2, R108.1, R110.2, R112.2, R113.1, R114.1, R120.1, R123.1, R129.2, R131.1, R133.2, R148.1, R149.1, R150.1, R151.1, R152.1, R153.1, R154.1, R155.1, R156.1, R157.1, R158.1, R159.1, R172.1, R182.1, R184.2, R186.2, R188.2, R193.2, R204.2, R205.2, R208.1, R225.2, R226.2, SW1.1 (A), SW2.1, TP18.1 (1_1), TP19.1 (1_1), TP27.1 (1_1), TP42.1 (1_1), TP58.1 (1_1), TP74.1 (1_1), TP90.1 (1_1), TP113.1 (1_1), TP149.1 (1_1), TP150.1 (1_1), TP151.1 (1_1), TP152.1 (1_1), TP156.1 (1_1), TP157.1 (1_1), TP158.1 (1_1), TP161.1 (1_1), TP163.1 (1_1), TP164.1 (1_1), TP169.1 (1_1), TP170.1 (1_1), TP173.1 (1_1), TP174.1 (1_1), TP176.1 (1_1), TP180.1 (1_1), TP182.1 (1_1), TP186.1 (1_1), TP188.1 (1_1), U1.4 (GND), U2.2 (GND), U3.1 (GND), U4.1 (GND), U5.2 (GND), U6.2 (GND), U7.2 (GND), U8.6 (AGND), U8.12 (PGND), U8.15 (EP), U8.21 (EP), U9.4 (GND), U9.5 (GND), U9.14 (GND), U9.26 (GND), U9.33 (EPAD), U9.34 (EPAD), U9.35 (EPAD), U10.3 (GND), U11.3 (GND), U16.4 (GND), U16.5 (GND), U16.14 (GND), U16.26 (GND), U16.33 (EPAD), U16.34 (EPAD), U16.35 (EPAD), U17.14 (DGND), U17.24 (REFCOM), U17.27 (AVSS), U17.28 (AVSS-SW), U18.4 (GND), U18.9 (EP), U19.16 (VSS), U19.30 (VSSA), U19.31 (VREF-), U19.38 (VSS), U19.51 (VSS), U19.61 (VSS), U19.71 (VSS), U19.83 (VSS), U19.94 (VSS), U19.107 (VSS), U19.120 (VSS), U19.130 (VSS), U19.143 (VSS), U20.5 (GND), U20.10 (GND), U21.1 (GND), U22.4 (GND), U22.6 (CLK), U23.2 (GND1), U23.8 (GND1__1), U25.4 (GND), U25.5 (A2), U25.6 (A1), U25.7 (A0), U25.9 (EP), U26.4 (GND), U26.5 (A2), U26.6 (A1), U26.9 (EP), U27.4 (GND), U27.5 (A2), U27.7 (A0), U27.9 (EP), U28.4 (GND), U28.5 (A2), U28.9 (EP), U29.4 (GND), U29.6 (A1), U29.7 (A0), U29.9 (EP), U30.4 (GND), U30.6 (A1), U30.9 (EP), U31.1 (GND), U32.5 (GND), U32.10 (GND), U33.5 (GND), U33.10 (GND), Y1.2, Y1.4
I2C1_SCL: R213.1, TP148.1 (1_1), U19.129 (I2C1_SCL), U25.2 (SCL), U26.2 (SCL), U27.2 (SCL), U28.2 (SCL), U29.2 (SCL), U30.2 (SCL)
I2C1_SDA: R214.1, TP147.1 (1_1), U19.128 (I2C1_SDA), U25.1 (SDA), U26.1 (SDA), U27.1 (SDA), U28.1 (SDA), U29.1 (SDA), U30.1 (SDA)
I2C3_SCL: R232.1, TP197.1 (1_1), U19.92 (I2C3_SCL), U31.6 (SCL2)
I2C3_SDA: R237.1, TP198.1 (1_1), U19.93 (I2C3_SDA), U31.5 (SDA2)
IGNITER_FIRE: R110.1, R116.1, TP98.1 (1_1), U16.6 (EN/UVLO), U19.54 (PF14)
IGN_VSENSE_N: NT2.2, R137.2
IGN_VSENSE_P: C64.1, C65.1, C66.1, F1.2, R111.2, R117.2, R118.1, R127.1, R136.2, TP97.1 (1_1), U16.1 (IN), U16.2 (IN), U16.3 (IN), U16.16 (IN), U16.25 (IN), U16.27 (EPAD), U16.28 (EPAD), U16.29 (EPAD), U16.30 (EPAD), U16.31 (EPAD), U16.32 (EPAD)
IMON: C74.1, R135.1, TP105.1 (1_1), U19.26 (PC0)
ISOGND: C123.2, C124.2, C125.2, C126.2, D42.3 (common), J17.3, TR1.5, U23.9 (GND2), U23.15 (GND2__1), U24.1 (GND)
MAIN_DE: U19.47 (LPUART1_DE), U23.6 (D)
MAIN_RX: R192.1, U19.45 (USART3_RX), U23.3 (R)
MAIN_TX: R191.1, U19.44 (USART3_TX), U23.5 (DE)
unnamed: BZ1.1 (+), R183.1, TP133.1 (1_1)
unnamed: C30.2, C31.1
unnamed: C32.1, R31.1
unnamed: C33.2, R34.2, TP22.1 (1_1)
unnamed: C36.1, R39.1
unnamed: C98.1, R180.2, Y1.3
unnamed: D1.2 (A), R9.1
unnamed: D2.2 (A), R13.2
unnamed: D5.2 (A), R40.2
unnamed: D6.2 (A), R54.1
unnamed: D7.2 (A), R55.1
unnamed: D10.2 (A), R68.1
unnamed: D11.2 (A), R69.1
unnamed: D14.2 (A), R82.1
unnamed: D15.2 (A), R83.1
unnamed: D18.2 (A), R96.1
unnamed: D19.2 (A), R97.1
unnamed: D22.2 (A), R115.2
unnamed: D23.2 (A), R116.2
unnamed: D24.2 (A), R118.2
unnamed: D25.2 (A), R119.2
unnamed: D27.2 (A), Q11.3 (D), R124.2
unnamed: C69.1, C70.1, C71.1, D29.1 (K), J13.3, J13.4, K1.4, Q12.2 (D), R117.1, R130.2
unnamed: D30.2 (A), R185.1
unnamed: D30.1 (K), Q15.3 (D)
unnamed: D31.2 (A), R187.1
unnamed: D31.1 (K), Q16.3 (D)
unnamed: D32.2 (A), R189.1
unnamed: D32.1 (K), Q17.3 (D)
unnamed: D33.2 (A), R195.1
unnamed: D33.1 (K), Q18.3 (D)
unnamed: D34.1 (K), J16.A5 (CC1), R205.1, TP136.1 (1_1)
unnamed: D36.1 (K), J16.B5 (CC2), R204.1, TP137.1 (1_1)
unnamed: D39.2 (A), R206.1
unnamed: D43.2 (A), R221.2
unnamed: D44.2 (A), R222.2
unnamed: J5.1, R41.1
unnamed: J5.2, R42.2, TP25.1 (1_1), U9.6 (EN/UVLO)
unnamed: F1.1, J10.1
unnamed: J11.3, R127.2
unnamed: J12.2, Q14.3 (D)
unnamed: J14.13 (VCP_RX), R191.2
unnamed: J14.14 (VCP_TX), R192.2
unnamed: J15.5 (CLK), R199.2, U20.11 (D2-)
unnamed: J15.3 (CMD), R198.1, U20.12 (D2+)
unnamed: J15.7 (DAT0), R200.1, U20.9 (D3+)
unnamed: J15.8 (DAT1), R197.1, U20.8 (D3-)
unnamed: J15.1 (DAT2), R202.1, U20.14 (D1+)
unnamed: J15.2 (DAT3/CD), R201.1, U20.13 (D1-)
unnamed: J15.10 (DET_A), R196.1, R203.2
unnamed: FB2.1, J16.SH1 (SHIELD), J16.SH2 (SHIELD__1), J16.SH3 (SHIELD__2), J16.SH4 (SHIELD__3)
unnamed: J18.2, Q19.3 (D)
unnamed: J19.2, Q20.3 (D)
unnamed: JP1.2 (B), R212.1
unnamed: Q11.1 (G), R122.1
unnamed: Q12.1 (G), R126.1
unnamed: Q13.1 (G), R128.1, R129.1
unnamed: Q14.1 (G), R132.2, R133.1
unnamed: Q19.1 (G), R223.2, R225.1
unnamed: Q20.1 (G), R224.2, R226.1
unnamed: R2.1, R3.2
unnamed: R3.1, R4.2
unnamed: R33.2, R34.1
unnamed: R36.1, R37.2
unnamed: R181.2, SW1.2 (B)
unnamed: C20.2, U6.1 (VCAP)
unnamed: C19.2, U7.1 (VCAP)
unnamed: R45.2, U9.11 (NRETRY)
unnamed: R42.1, R43.2, TP26.1 (1_1), U9.12 (OVLO)
unnamed: R44.2, U9.10 (RETRY_DLY)
unnamed: R50.1, U10.1 (ENA)
unnamed: R51.1, U10.8 (ENB)
unnamed: R52.1, U11.1 (ENA)
unnamed: R53.1, U11.8 (ENB)
unnamed: R56.1, U12.4 (EN)
unnamed: R70.1, U13.4 (EN)
unnamed: R84.1, U14.4 (EN)
unnamed: R98.1, U15.4 (EN)
unnamed: R114.2, U16.11 (NRETRY)
unnamed: R113.2, U16.10 (RETRY_DLY)
unnamed: R182.2, R183.2, TP132.1 (1_1), U19.69 (PB10)
unnamed: TP131.1 (1_1), U19.96 (PC6)
unnamed: C113.1, U19.8 (RCC_OSC32_IN), Y2.1
unnamed: C112.1, U19.9 (RCC_OSC32_OUT), Y2.2
unnamed: TP122.1 (1_1), U19.58 (PE7)
unnamed: TP123.1 (1_1), U19.59 (PE8)
unnamed: TP124.1 (1_1), U19.60 (PE9)
unnamed: TP125.1 (1_1), U19.63 (PE10)
unnamed: TP126.1 (1_1), U19.64 (PE11)
unnamed: TP127.1 (1_1), U19.65 (PE12)
unnamed: TP128.1 (1_1), U19.66 (PE13)
unnamed: TP129.1 (1_1), U19.67 (PE14)
unnamed: TP130.1 (1_1), U19.68 (PE15)
unnamed: C95.1, U19.23 (RCC_OSC_IN), Y1.1
unnamed: R180.1, U19.24 (RCC_OSC_OUT)
unnamed: C91.1, C93.1, U19.32 (VREF+)
unnamed: R231.1, U31.8 (EN)
PGOOD_IGNITER: R121.2, TP103.1 (1_1), U16.13 (PG), U19.53 (PF13)
PIN5_STM32: R227.2, TP189.1 (1_1), U19.80 (PD11)
PIN8_STM32: R233.1, TP193.1 (1_1), U19.79 (PD10)
PIN9_STM32: R228.2, TP190.1 (1_1), U19.78 (PD9)
PIN12_STM32: R234.1, TP194.1 (1_1), U19.77 (PD8)
PIN13_STM32: R229.2, TP191.1 (1_1), U19.76 (PB15)
PIN16_STM32: R235.1, TP195.1 (1_1), U19.75 (PB14)
PIN17_STM32: R230.2, TP192.1 (1_1), U19.74 (PB13)
PIN20_STM32: R236.1, TP196.1 (1_1), U19.73 (PB12)
SDMMC1_CK: R199.1, U19.113 (SDMMC1_CK)
SDMMC1_CMD: R198.2, U19.116 (PD2)
SDMMC1_D0: R200.2, U19.98 (SDMMC1_D0)
SDMMC1_D1: R197.2, U19.99 (SDMMC1_D1)
SDMMC1_D2: R202.2, U19.111 (SDMMC1_D2)
SDMMC1_D3: R201.2, U19.112 (SDMMC1_D3)
SD_DET: R196.2, U19.97 (PC7)
SHUNT_DISABLE: R119.1, R128.2, TP100.1 (1_1), U19.55 (PF15)
TEMP_ALERT1: R215.1, TP154.1 (1_1), U19.37 (PA3), U25.3 (ALERT)
TEMP_ALERT2: R216.1, TP160.1 (1_1), U19.88 (PG3), U26.3 (ALERT)
TEMP_ALERT3: R217.1, TP166.1 (1_1), U19.87 (PG2), U27.3 (ALERT)
TEMP_ALERT4: R218.1, TP172.1 (1_1), U19.100 (PA8), U28.3 (ALERT)
TEMP_ALERT5: R219.1, TP178.1 (1_1), U19.102 (PA10), U29.3 (ALERT)
TEMP_ALERT6: R220.1, TP184.1 (1_1), U19.70 (PB11), U30.3 (ALERT)
USB_VBUS_DET: R207.1, R208.2, TP138.1 (1_1), U19.101 (USB_OTG_FS_VBUS)
V-12P0_MAIN_PG: TP11.1 (1_1), U8.10 (PGOOD), U19.14 (PF4)
VALVE1.LSW_DIA_EN: R59.2, TP38.1 (1_1), U19.11 (PF1)
VALVE1.LSW_LATCH: R58.2, TP37.1 (1_1), U19.2 (PE3)
VALVE1.LSW_SEL1: R61.2, TP40.1 (1_1), U19.5 (PE6)
VALVE1.LSW_SEL2: R60.2, TP39.1 (1_1), U19.10 (PF0)
VALVE1.~LSW_ST: R57.2, TP36.1 (1_1), U19.3 (PE4)
VALVE1_HSS_EN: R54.2, R56.2, TP34.1 (1_1), U19.1 (PE2)
VALVE1_LSS_EN: U10.4 (INB), U19.4 (PE5)
VALVE1_LSW_SNS: C48.1, R67.1, TP46.1 (1_1), U19.35 (PA1)
VALVE1_VSENSE_N: J6.1, R141.2, TP47.1 (1_1)
VALVE1_VSENSE_P: J6.2, R140.2, TP48.1 (1_1)
VALVE2.LSW_DIA_EN: R73.2, TP54.1 (1_1), U19.139 (PB8)
VALVE2.LSW_LATCH: R72.2, R190.2, TP53.1 (1_1), U19.135 (PB5)
VALVE2.LSW_SEL1: R75.2, TP56.1 (1_1), U19.141 (PE0)
VALVE2.LSW_SEL2: R74.2, TP55.1 (1_1), U19.140 (PB9)
VALVE2.~LSW_ST: R71.2, TP52.1 (1_1), U19.137 (PB7)
VALVE2_HSS_EN: R68.2, R70.2, TP50.1 (1_1), U19.136 (PB6)
VALVE2_LSS_EN: U10.2 (INA), U19.142 (PE1)
VALVE2_LSW_SNS: C53.1, R81.1, TP62.1 (1_1), U19.34 (PA0)
VALVE2_VSENSE_N: J7.1, R143.2, TP63.1 (1_1)
VALVE2_VSENSE_P: J7.2, R142.2, TP64.1 (1_1)
VALVE3.LSW_DIA_EN: R87.2, TP70.1 (1_1), U19.127 (PG12)
VALVE3.LSW_LATCH: R86.2, TP69.1 (1_1), U19.124 (PG9)
VALVE3.LSW_SEL1: R89.2, TP72.1 (1_1), U19.133 (PB3)
VALVE3.LSW_SEL2: R88.2, TP71.1 (1_1), U19.132 (PG15)
VALVE3.~LSW_ST: R85.2, TP68.1 (1_1), U19.126 (PG11)
VALVE3_HSS_EN: R82.2, R84.2, TP66.1 (1_1), U19.125 (PG10)
VALVE3_LSS_EN: U11.4 (INB), U19.134 (PB4)
VALVE3_LSW_SNS: C58.1, R95.1, TP78.1 (1_1), U19.29 (PC3)
VALVE3_VSENSE_N: J8.1, R145.2, TP79.1 (1_1)
VALVE3_VSENSE_P: J8.2, R144.2, TP80.1 (1_1)
VALVE4.LSW_DIA_EN: R101.2, TP86.1 (1_1), U19.118 (PD4)
VALVE4.LSW_LATCH: R100.2, TP85.1 (1_1), U19.114 (PD0)
VALVE4.LSW_SEL1: R103.2, TP88.1 (1_1), U19.122 (PD6)
VALVE4.LSW_SEL2: R102.2, TP87.1 (1_1), U19.119 (PD5)
VALVE4.~LSW_ST: R99.2, TP84.1 (1_1), U19.117 (PD3)
VALVE4_HSS_EN: R96.2, R98.2, TP82.1 (1_1), U19.115 (PD1)
VALVE4_LSS_EN: U11.2 (INA), U19.123 (PD7)
VALVE4_LSW_SNS: C63.1, R109.1, TP94.1 (1_1), U19.28 (PC2)
VALVE4_VSENSE_N: J9.1, R147.2, TP95.1 (1_1)
VALVE4_VSENSE_P: J9.2, R146.2, TP96.1 (1_1)
VALVE_GLOBAL_CTRL: R50.2, R51.2, R52.2, R53.2, U19.7 (PC13)
VBUS1: C17.1, C19.1, D3.2 (A), J23.4, J23.5, J23.6, Q4.1 (S), Q4.2 (S), Q4.3 (S), R24.2, TP187.1 (1_1), U7.6 (ANODE)
VBUS1_DISABLE: R20.2, U19.57 (PG1)
VBUS2: C18.1, C20.1, D4.2 (A), J22.4, J22.5, J22.6, Q3.1 (S), Q3.2 (S), Q3.3 (S), R25.2, TP185.1 (1_1), U6.6 (ANODE)
VBUS2_DISABLE: R22.2, U19.56 (PG0)
VBUS_VSENSE_N: NT1.2, R139.2
VBUS_VSENSE_P: C21.1, C22.1, C23.1, C24.1, C25.1, Q3.5 (D), Q4.5 (D), Q5.5 (D), R27.2, R29.2, R138.2, TP10.1 (1_1), U6.4 (CATHODE), U7.4 (CATHODE)
VSYS: C1.1, C2.1, C3.1, J20.1, R2.2, TP2.1 (1_1), U1.3 (VIN)
~ADC_CS: R175.1, U19.40 (PA4)
~ADC_DRDY: R179.1, U19.50 (PF12)
~ADC_RESET: R173.1, U19.46 (PB0)
~MAIN_RE: U19.48 (PB2), U23.4 (~RE)
