Ground-Support-Equipment-SCRT/Pad-Side-Systems/LRUs/Pad Control Unit/IDC Interface Board/idc_interface_board/idc_interface_board.kicad_pcb

## KiCad design LRUs/Pad Control Unit/IDC Interface Board/idc_interface_board/idc_interface_board.kicad_pcb (2026-10-17)

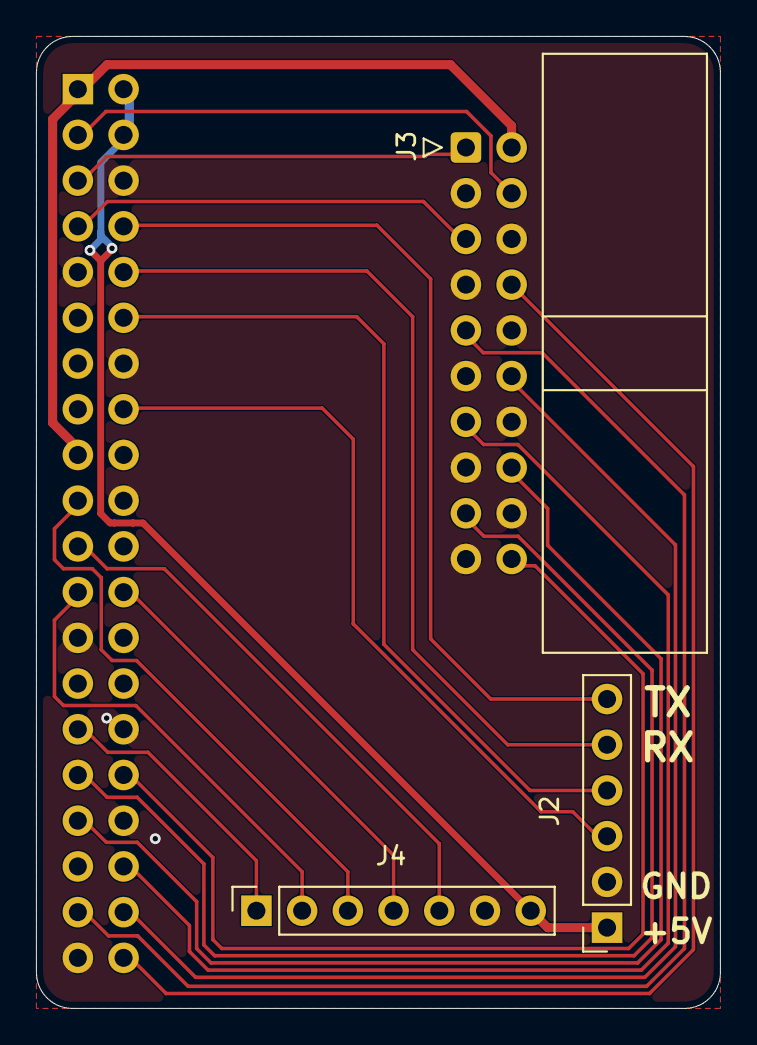
[picture p132: board idc_interface_board.kicad_pcb from above]

Board: 2 copper layers, 38.0 x 54.0 mm, 4 parts (1 on the bottom side), 22 nets.

Parts:
J1: Conn_01x40; PinSocket_2x20_P2.54mm_Vertical
J2: Conn_01x06; PinSocket_1x06_P2.54mm_Vertical
J3: Conn_01x20; IDC-Header_2x10_P2.54mm_Horizontal
J4: Conn_01x07; PinSocket_1x07_P2.54mm_Vertical

Connections:
+3V3: J1.1, J1.17, J3.2
+5V: J1.2, J1.4, J2.1, J4.7
/Connectors/GPIO4: J1.7, J3.5
/Connectors/GPIO5: J1.29, J4.1
/Connectors/GPIO6: J1.31, J3.17
/Connectors/GPIO12: J1.32, J3.20
/Connectors/GPIO13: J1.33, J3.16
/Connectors/GPIO16: J1.36, J3.13
/Connectors/GPIO18: J1.12, J2.4
/Connectors/GPIO20: J1.38, J3.12
/Connectors/GPIO21: J1.40, J3.8
/Connectors/GPIO23: J1.16, J2.3
/Connectors/GPIO26: J1.37, J3.9
/Connectors/I2C1_SCL: J1.5, J3.1
/Connectors/I2C1_SDA: J1.3, J3.4
/Connectors/SPI0_CE0: J1.24, J4.4
/Connectors/SPI0_MISO: J1.21, J4.5
/Connectors/SPI0_MOSI: J1.19, J4.3
/Connectors/SPI0_SCLK: J1.23, J4.2
/Connectors/UART0_RX: J1.10, J2.5
/Connectors/UART0_TX: J1.8, J2.6
GND: J1.6, J1.9, J1.14, J1.20, J1.25, J1.30, J1.34, J1.39, J2.2, J3.3, J3.6, J3.7, J3.10, J3.11, J3.14, J3.15, J3.18, J3.19, J4.6
