Ground-Support-Equipment-SCRT/Pad-Side-Systems/LRUs/Valve Control Unit/Electrical/Valve Power Board/valve_control_pcb/_restore_backup_2026-08-23T13-21-27-038/valve_control_pcb.kicad_pcb

## KiCad design LRUs/Valve Control Unit/Electrical/Valve Power Board/valve_control_pcb/_restore_backup_2026-08-23T13-21-27-038/valve_control_pcb.kicad_pcb (2026-08-24)

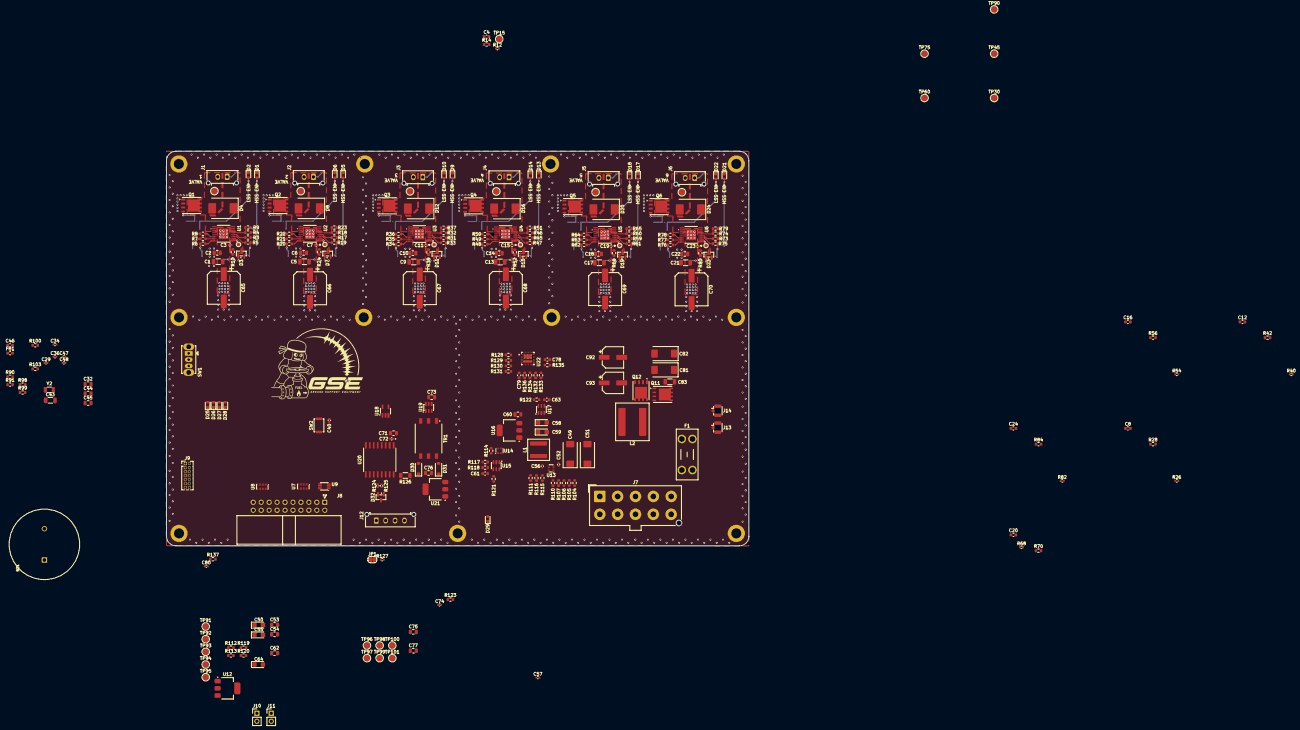
[picture p133: board LRUs/Valve Control Unit/Electrical/Valve Power Board/valve_control_pc… from above]

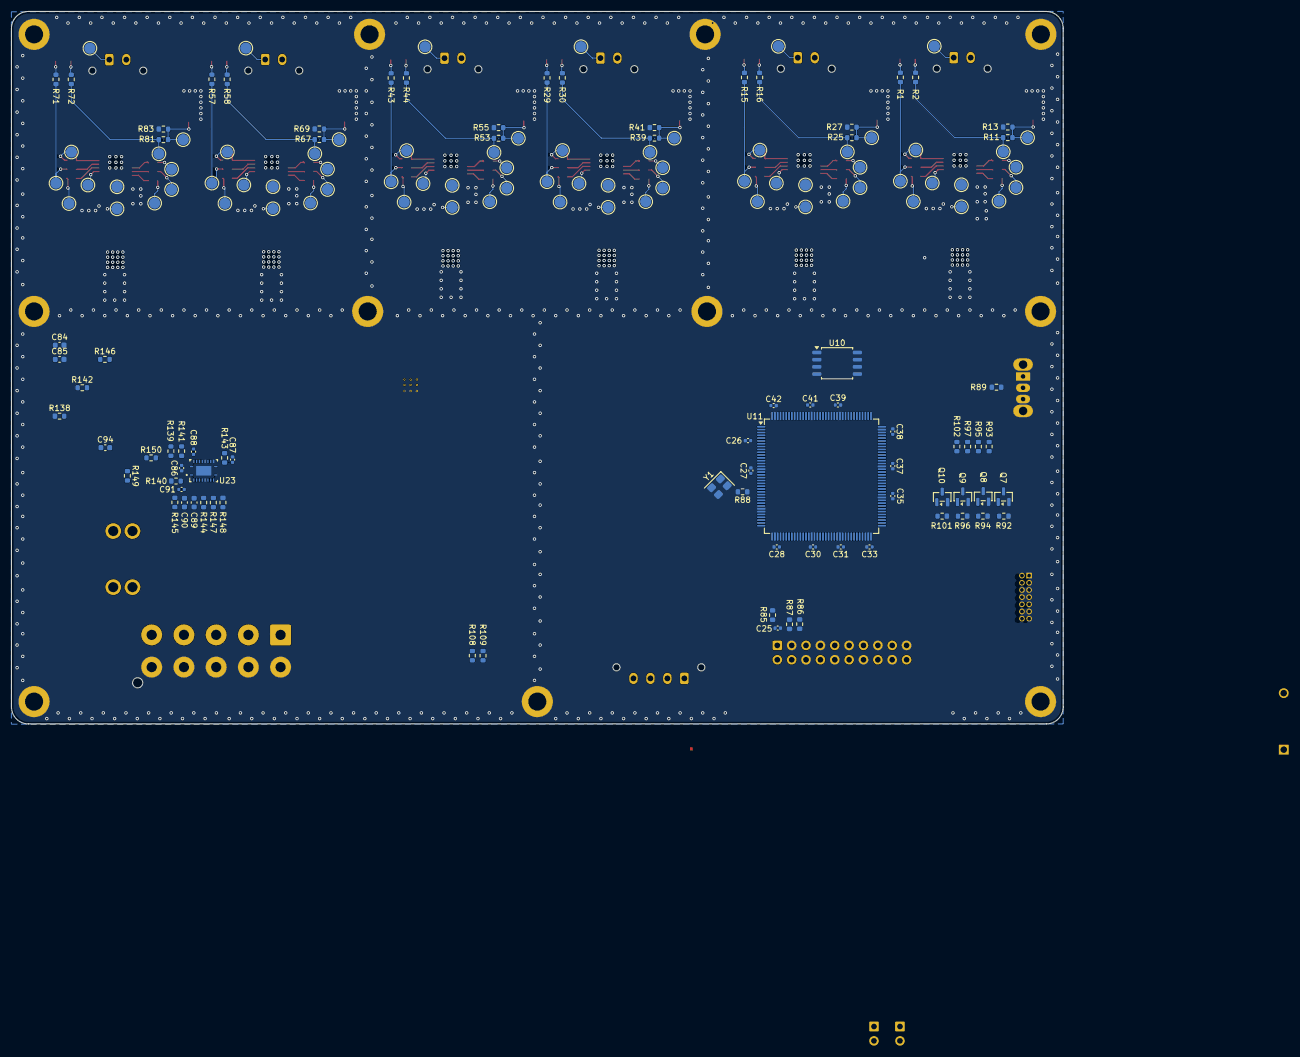
[picture p134: board LRUs/Valve Control Unit/Electrical/Valve Power Board/valve_control_pc… from below]

Board: 4 copper layers, 186.0 x 126.0 mm, 448 parts (154 on the bottom side), 235 nets.

Parts:
BZ1: Buzzer; MURATA_ELECTRONICS_NORTH_AMERICA_PKM22EPPH2002-B0_0
C1, C5, C9, C13, C17, C21, C43, C83: 4.7uF; C_1206_3216Metric
C2, C6, C10, C14, C18, C22: 220nF; C_0805_2012Metric
C3, C7, C11, C15, C19, C23, C26, C27, C28, C29, C30, C31, C33, C35, C37, C38, C39, C40, C41, C42, C52, C56, C57, C72, C74, C80, C86, C88: 100nF; C_0402_1005Metric
C4, C8, C12, C16, C20, C24, C46, C61, C63, C78: 10nF; C_0603_1608Metric
C25: 100pF; C_0402_1005Metric
C32, C44, C45, C53, C54, C60, C62, C71: 1uF; C_0805_2012Metric
C34, C36: 20pF; C_0402_1005Metric
C47, C48, C87, C91: 10pF; C_0402_1005Metric
C49, C51, C81, C82: 10uF; CP_EIA-7343-31_Kemet-D
C50, C55, C58, C59, C64: 10uF; CP_EIA-3216-18_Kemet-A
C65, C66, C67, C68, C69, C70: 120uF; CP_Elec_10x12.6
C73, C75, C76, C77: 10uF; C_0805_2012Metric
C79, C84: 47nF; C_0603_1608Metric
C85: 2.2uF; C_0603_1608Metric
C89, C90, C94: 330pF; C_0603_1608Metric
C92, C93: 47uF; CP_Elec_6.3x5.4
D1, D2, D5, D6, D9, D10, D13, D14, D17, D18, D21, D22, D29: RED; LED_0603_1608Metric
D3, D7, D11, D15, D19, D23: BAS21; SOT-23
D4, D8, D12, D16, D20, D24: S3M-E3/57T; D_SMC
D25, D26, D27, D28: WHITE; LED_0603_1608Metric
D30, D31: MBR0520LT; D_SOD-123
D32: SM712_SOT23; SOT-23
F1: 0297020; Fuseholder_Blade_Mini_Keystone_3568
FB1: 120R; L_0603_1608Metric
H1, H2, H3, H4, H5, H6, H7, H8, H9, H10, H11: MountingHole_Pad; MountingHole_3.2mm_M3_ISO14580_Pad
J1, J2, J3, J4, J5, J6: 0436500215; Molex_Micro-Fit_3.0_43650-0215_1x02_P3.00mm_Vertical
J7: 0768290110; Molex_Mega-Fit_76829-0110_2x05_P5.70mm_Vertical
J8: Conn_02x10_Odd_Even; IDC-Header_2x10_P2.54mm_Horizontal
J9: Conn_ST_STDC14; PinHeader_2x07_P1.27mm_Vertical
J10: Conn_01x02_Pin; PinHeader_1x02_P2.54mm_Vertical
J11: 01x02_PinHeader; PinHeader_1x02_P2.54mm_Vertical
J12: Conn_01x04; Molex_Micro-Fit_3.0_43650-0415_1x04_P3.00mm_Vertical
J13, J14: Conn_Coaxial; U.FL_Hirose_U.FL-R-SMT-1_Vertical
JP1: SolderJumper_2_Bridged; SolderJumper-2_P1.3mm_Bridged_RoundedPad1.0x1.5mm
L1: 15uH; L_Coilcraft_XAL6060-XXX
L2: 4.7uH; L_Coilcraft_XAL1010-XXX
Q1, Q2, Q3, Q4, Q5, Q6, Q11, Q12: SiR882ADP; PowerPAK_SO-8_Single
Q7, Q8, Q9, Q10: AO3400A; SOT-23
R1, R2, R10, R15, R16, R24, R29, R30, R38, R43, R44, R52, R57, R58, R66, R71, R72, R80, R86, R87, R93, R95, R97, R102: 4.7k; R_0603_1608Metric
R3, R4, R5, R6, R7, R8, R14, R17, R18, R19, R20, R21, R22, R28, R31, R32, R33, R34, R35, R36, R42, R45, R46, R47, R48, R49, R50, R56, R59, R60, R61, R62, R63, R64, R70, R73, R74, R75, R76, R77, R78, R84: 15k; R_0603_1608Metric
R9, R23, R37, R51, R65, R79, R89, R113, R121, R122, R123, R131, R135: 10k; R_0603_1608Metric
R11, R25, R39, R53, R67, R81, R90, R136, R144: 100; R_0603_1608Metric
R12, R26, R40, R54, R68, R82: 680; R_0402_1005Metric
R13, R27, R41, R55, R69, R83, R92, R94, R96, R101, R111, R114: 47k; R_0603_1608Metric
R85: 200k; R_0603_1608Metric
R88: 390; R_0603_1608Metric
R91: 1M; R_0603_1608Metric
R98, R99, R100, R103, R110, R132, R133: 0; R_0603_1608Metric
R104: 220k; R_0603_1608Metric
R105, R112, R138, R142: 20k; R_0603_1608Metric
R106, R134: 9.1k; R_0603_1608Metric
R107, R120: 51k; R_0603_1608Metric
R108, R109: 2.2k; R_0603_1608Metric
R115, R139: 68k; R_0603_1608Metric
R116: 13k; R_0603_1608Metric
R117, R119, R128: 150k; R_0603_1608Metric
R118: 100k; R_0603_1608Metric
R124, R125: 10; R_0402_1005Metric
R126: 0; R_1206_3216Metric
R127: 120; R_0402_1005Metric
R129, R146: 18k; R_0603_1608Metric
R130: 27k; R_0603_1608Metric
R137: 1k; R_0603_1608Metric
R140: 8.2k; R_0603_1608Metric
R141: 2; R_0603_1608Metric
R143: 680; R_0603_1608Metric
R145: 1.8k; R_0603_1608Metric
R147: 1.2k; R_0603_1608Metric
R148, R150: 75; R_0603_1608Metric
R149: 10; R_0603_1608Metric
SW1: SW_SPDT; SW_Slide_SPDT_Straight_CK_OS102011MS2Q
SW2: SW_Push; SW_Push_SPST_NO_Alps_SKRK
TP1, TP2, TP3, TP4, TP5, TP6, TP7, TP8, TP10, TP11, TP12, TP13, TP14, TP15, TP16, TP17, TP18, TP19, TP20, TP21, TP22, TP23, TP25, TP26, TP27, TP28, TP29, TP30, TP31, TP32, TP33, TP34, TP35, TP36, TP37, TP38, TP40, TP41, TP42, TP43, TP44, TP45, TP46, TP47, TP48, TP49, TP50, TP51, TP52, TP53, TP55, TP56, TP57, TP58, TP59, TP60, TP61, TP62, TP63, TP64, TP65, TP66, TP67, TP68, TP70, TP71, TP72, TP73, TP74, TP75, TP76, TP77, TP78, TP79, TP80, TP81, TP82, TP83, TP85, TP86, TP87, TP88, TP89, TP90, TP91, TP92, TP93, TP94, TP95, TP96, TP97, TP98, TP99, TP100, TP101: TestPoint; TestPoint_Pad_D2.0mm
TP9, TP24, TP39, TP54, TP69, TP84: TestPoint; TestPoint_Pad_D1.0mm
TR1: 750315371; Transformer_Wuerth_750315371
U1, U2, U3, U4, U5, U6: TPS27SA08CPWPR; TSSOP_CPWPR_TEX
U7, U8: TPD6E05U06RVZ; Texas_R-PUSON-N14
U9: PCA9306DC; VSSOP-8_2.3x2mm_P0.5mm
U10: W25Q128JVS; SOIC-8_5.3x5.3mm_P1.27mm
U11: STM32L496ZGTx; LQFP-144_20x20mm_P0.5mm
U12, U16: AMS1117-3.3; SOT-223-3_TabPin2
U13: TPS62933P; SOT-583-8
U14: TPS2116DRL; SOT-583-8
U15, U17: TPS22810DBV; SOT-23-6
U18: 74LVC1G17; SOT-23-5_HandSoldering
U19: SN6505BDBV; SOT-23-6
U20: ISO1450BDWR; SOIC127P1030X265-16N
U21: AMS1117-5.0; SOT-223-3_TabPin2
U22: IC_TPS259830ONRGER
U23: LM5145RGYR
Y1: 8MHz; Crystal_SMD_3225-4Pin_3.2x2.5mm
Y2: 32KHz; Crystal_SMD_3215-2Pin_3.2x1.5mm

Connections:
3V3_EXT: J8.2, U9.2 (VREF1)
+3V3: C25.1, C26.1, C27.1, C28.1, C30.1, C31.1, C33.1, C35.1, C37.1, C38.1, C39.1, C41.1, C42.1, C43.1, C44.1, FB1.1, J9.3 (VCC), R9.1, R23.1, R37.1, R51.1, R65.1, R79.1, R85.2, R86.2, R87.2, R111.1, R121.2, R135.1, SW1.3 (C), U9.7 (VREF2), U11.6 (VBAT), U11.17 (VDD), U11.39 (VDD), U11.52 (VDD), U11.62 (VDD), U11.72 (VDD), U11.84 (VDD), U11.95 (VDDIO2), U11.106 (VDDUSB), U11.108 (VDD), U11.121 (VDD), U11.131 (VDDIO2), U11.144 (VDD), U15.6 (VOUT), U18.5 (VCC)
+5V: C71.1, C72.1, C73.1, R93.2, R95.2, R97.2, R102.2, R122.2, R123.1, TR1.2, U17.6 (VOUT), U19.2 (VCC), U19.5 (EN), U20.1 (VCC1)
/Connectors/I2C_MASTER_SCL: J8.1, U7.14 (D1+), U9.3 (SCL1)
/Connectors/I2C_MASTER_SDA: J8.4, U7.13 (D1-), U9.4 (SDA1)
/Connectors/I2C_SCL: R86.1, U9.6 (SCL2)
/Connectors/I2C_SDA: R87.1, U9.5 (SDA2)
/Connectors/PIN5: J8.5, U7.12 (D2+)
/Connectors/PIN8: J8.8, U7.11 (D2-)
/Connectors/PIN9: J8.9, U7.9 (D3+)
/Connectors/PIN12: J8.12, U7.8 (D3-)
/Connectors/PIN13: J8.13, U8.14 (D1+)
/Connectors/PIN16: J8.16, U8.13 (D1-)
/Connectors/PIN17: J8.17, U8.12 (D2+)
/Connectors/PIN20: J8.20, U8.11 (D2-)
/Root/RS_485/A_RX_MAIN_N: R125.2, U20.13 (B)
/Root/RS_485/A_RX_MAIN_P: R124.2, U20.12 (A)
/Root/RS_485/RX_MAIN_N: D32.1 (A1), J12.2, JP1.1 (A), R125.1
/Root/RS_485/RX_MAIN_P: D32.2 (A2), J12.1, R124.1, R127.2
/Root/stm32_microcontroller/BOOT: R89.1, U11.138 (PH3)
/Root/stm32_microcontroller/D1: Q7.1 (G), R92.1, U11.82 (PD13)
/Root/stm32_microcontroller/D2: Q8.1 (G), R94.1, U11.81 (PD12)
/Root/stm32_microcontroller/D3: Q9.1 (G), R96.1, U11.80 (PD11)
/Root/stm32_microcontroller/D4: Q10.1 (G), R101.1, U11.79 (PD10)
/Root/stm32_microcontroller/JTDI: J9.10 (JTDI/NC), R103.1
/Root/stm32_microcontroller/JTDO: J9.8 (JTDO/SWO), R98.1
/Root/stm32_microcontroller/NRST: C40.2, J9.12 (~RST), SW2.2, U11.25 (NRST)
/Root/stm32_microcontroller/VDDA: C45.1, C46.1, FB1.2, U11.33 (VDDA)
/System Power/3V3_STATUS: R114.2, U14.8 (ST)
/System Power/5V_MAIN_PG: R111.2, TP95.1 (1_1), U13.7 (PG)
/System Power/V-3P3_LDO: C62.1, C64.1, R112.2, U14.3 (VIN1), U14.5 (MODE), U16.2 (VO)
/System Power/V-5P0_BUCK: C57.1, C58.1, C59.1, C60.1, L1.2, R108.1, R115.1, R119.2, U16.3 (VI), U17.1 (VIN)
/System Power/VEN: R106.1, R107.1, TP92.1 (1_1), U13.2 (EN)
/System Power/VFB: R115.2, R116.1, TP93.1 (1_1), U13.8 (FB)
/Valves/12V_main/SENSE_OUT: J14.1 (In), R146.2, R149.1, R150.2
/Valves/12V_main/VOUT_MAIN: C92.1, C93.1, J13.1 (In), L2.2, R128.2, R149.2, U22.1 (IN), U22.2 (IN), U22.3 (IN), U22.16 (IN), U22.25 (IN), U22.27 (EPAD), U22.28 (EPAD), U22.29 (EPAD), U22.30 (EPAD), U22.31 (EPAD), U22.32 (EPAD)
/Valves/Valve 1/12V_OUT+: D4.1 (K), J1.1, TP13.1 (1_1), U1.6 (VOUT), U1.7 (VOUT), U1.8 (VOUT), U1.9 (VOUT), U1.10 (VOUT), U1.11 (VOUT)
/Valves/Valve 1/12V_OUT-: D4.2 (A), J1.2, Q1.5 (D), TP14.1 (1_1)
/Valves/Valve 1/LFET_GATE: Q1.4 (G), R11.1, R13.1, TP11.1 (1_1)
/Valves/Valve 1/LSW_DIA_EN_PROT: R6.1, U1.16 (DIA_EN)
/Valves/Valve 1/LSW_LATCH_PROT: R5.1, U1.3 (LATCH)
/Valves/Valve 1/LSW_SEL1_PROT: R8.1, U1.14 (SEL1)
/Valves/Valve 1/LSW_SEL2_PROT: R7.1, U1.15 (SEL2)
/Valves/Valve 1/LSW_SNS_PROT: R12.2, R14.2, TP12.1 (1_1), U1.2 (SNS)
/Valves/Valve 1/VIN: C1.1, C2.1, C3.1, C5.1, C6.1, C7.1, C9.1, C10.1, C11.1, C13.1, C14.1, C15.1, C17.1, C18.1, C19.1, C21.1, C22.1, C23.1, C65.1, C66.1, C67.1, C68.1, C69.1, C70.1, TP3.1 (1_1), TP18.1 (1_1), TP33.1 (1_1), TP48.1 (1_1), TP63.1 (1_1), TP78.1 (1_1), U1.EPAD (VBB), U2.EPAD (VBB), U3.EPAD (VBB), U4.EPAD (VBB), U5.EPAD (VBB), U6.EPAD (VBB), U22.17 (OUT), U22.18 (OUT), U22.19 (OUT), U22.20 (OUT), U22.21 (OUT), U22.22 (OUT), U22.23 (OUT), U22.24 (OUT)
/Valves/Valve 1/~LSW_ST_PROT: R4.1, R9.2, U1.5 (~ST)
/Valves/Valve 2/12V_OUT+: D8.1 (K), J2.1, TP28.1 (1_1), U2.6 (VOUT), U2.7 (VOUT), U2.8 (VOUT), U2.9 (VOUT), U2.10 (VOUT), U2.11 (VOUT)
/Valves/Valve 2/12V_OUT-: D8.2 (A), J2.2, Q2.5 (D), TP29.1 (1_1)
/Valves/Valve 2/LFET_GATE: Q2.4 (G), R25.1, R27.1, TP26.1 (1_1)
/Valves/Valve 2/LSW_DIA_EN_PROT: R20.1, U2.16 (DIA_EN)
/Valves/Valve 2/LSW_LATCH_PROT: R19.1, U2.3 (LATCH)
/Valves/Valve 2/LSW_SEL1_PROT: R22.1, U2.14 (SEL1)
/Valves/Valve 2/LSW_SEL2_PROT: R21.1, U2.15 (SEL2)
/Valves/Valve 2/LSW_SNS_PROT: R26.2, R28.2, TP27.1 (1_1), U2.2 (SNS)
/Valves/Valve 2/~LSW_ST_PROT: R18.1, R23.2, U2.5 (~ST)
/Valves/Valve 3/12V_OUT+: D12.1 (K), J3.1, TP43.1 (1_1), U3.6 (VOUT), U3.7 (VOUT), U3.8 (VOUT), U3.9 (VOUT), U3.10 (VOUT), U3.11 (VOUT)
/Valves/Valve 3/12V_OUT-: D12.2 (A), J3.2, Q3.5 (D), TP44.1 (1_1)
/Valves/Valve 3/LFET_GATE: Q3.4 (G), R39.1, R41.1, TP41.1 (1_1)
/Valves/Valve 3/LSW_DIA_EN_PROT: R34.1, U3.16 (DIA_EN)
/Valves/Valve 3/LSW_LATCH_PROT: R33.1, U3.3 (LATCH)
/Valves/Valve 3/LSW_SEL1_PROT: R36.1, U3.14 (SEL1)
/Valves/Valve 3/LSW_SEL2_PROT: R35.1, U3.15 (SEL2)
/Valves/Valve 3/LSW_SNS_PROT: R40.2, R42.2, TP42.1 (1_1), U3.2 (SNS)
/Valves/Valve 3/~LSW_ST_PROT: R32.1, R37.2, U3.5 (~ST)
/Valves/Valve 4/12V_OUT+: D16.1 (K), J4.1, TP58.1 (1_1), U4.6 (VOUT), U4.7 (VOUT), U4.8 (VOUT), U4.9 (VOUT), U4.10 (VOUT), U4.11 (VOUT)
/Valves/Valve 4/12V_OUT-: D16.2 (A), J4.2, Q4.5 (D), TP59.1 (1_1)
/Valves/Valve 4/LFET_GATE: Q4.4 (G), R53.1, R55.1, TP56.1 (1_1)
/Valves/Valve 4/LSW_DIA_EN_PROT: R48.1, U4.16 (DIA_EN)
/Valves/Valve 4/LSW_LATCH_PROT: R47.1, U4.3 (LATCH)
/Valves/Valve 4/LSW_SEL1_PROT: R50.1, U4.14 (SEL1)
/Valves/Valve 4/LSW_SEL2_PROT: R49.1, U4.15 (SEL2)
/Valves/Valve 4/LSW_SNS_PROT: R54.2, R56.2, TP57.1 (1_1), U4.2 (SNS)
/Valves/Valve 4/~LSW_ST_PROT: R46.1, R51.2, U4.5 (~ST)
/Valves/Valve 5/12V_OUT+: D20.1 (K), J5.1, TP73.1 (1_1), U5.6 (VOUT), U5.7 (VOUT), U5.8 (VOUT), U5.9 (VOUT), U5.10 (VOUT), U5.11 (VOUT)
/Valves/Valve 5/12V_OUT-: D20.2 (A), J5.2, Q5.5 (D), TP74.1 (1_1)
/Valves/Valve 5/LFET_GATE: Q5.4 (G), R67.1, R69.1, TP71.1 (1_1)
/Valves/Valve 5/LSW_DIA_EN_PROT: R62.1, U5.16 (DIA_EN)
/Valves/Valve 5/LSW_LATCH_PROT: R61.1, U5.3 (LATCH)
/Valves/Valve 5/LSW_SEL1_PROT: R64.1, U5.14 (SEL1)
/Valves/Valve 5/LSW_SEL2_PROT: R63.1, U5.15 (SEL2)
/Valves/Valve 5/LSW_SNS_PROT: R68.2, R70.2, TP72.1 (1_1), U5.2 (SNS)
/Valves/Valve 5/~LSW_ST_PROT: R60.1, R65.2, U5.5 (~ST)
/Valves/Valve 6/12V_OUT+: D24.1 (K), J6.1, TP88.1 (1_1), U6.6 (VOUT), U6.7 (VOUT), U6.8 (VOUT), U6.9 (VOUT), U6.10 (VOUT), U6.11 (VOUT)
/Valves/Valve 6/12V_OUT-: D24.2 (A), J6.2, Q6.5 (D), TP89.1 (1_1)
/Valves/Valve 6/LFET_GATE: Q6.4 (G), R81.1, R83.1, TP86.1 (1_1)
/Valves/Valve 6/LSW_DIA_EN_PROT: R76.1, U6.16 (DIA_EN)
/Valves/Valve 6/LSW_LATCH_PROT: R75.1, U6.3 (LATCH)
/Valves/Valve 6/LSW_SEL1_PROT: R78.1, U6.14 (SEL1)
/Valves/Valve 6/LSW_SEL2_PROT: R77.1, U6.15 (SEL2)
/Valves/Valve 6/LSW_SNS_PROT: R82.2, R84.2, TP87.1 (1_1), U6.2 (SNS)
/Valves/Valve 6/~LSW_ST_PROT: R74.1, R79.2, U6.5 (~ST)
/Valves/master_efuse/DVDT: C78.1, U22.15 (DVDT/BGATE)
/Valves/master_efuse/ILIM: R136.2, U22.8 (ILIM)
/Valves/master_efuse/IMON_IC: R134.2, R137.2, U22.9 (IMON)
/Valves/master_efuse/ITIM: C79.1, U22.7 (ITIMER)
EFUSE_IMON: C80.1, R137.1
EFUSE_PG: R135.2, U22.13 (PG)
GND: BZ1.2 (-), C1.2, C2.2, C4.2, C5.2, C6.2, C8.2, C9.2, C10.2, C12.2, C13.2, C14.2, C16.2, C17.2, C18.2, C20.2, C21.2, C22.2, C24.2, C25.2, C26.2, C27.2, C28.2, C29.2, C30.2, C31.2, C32.2, C33.2, C34.2, C35.2, C36.2, C37.2, C38.2, C39.2, C40.1, C41.2, C42.2, C43.2, C44.2, C45.2, C46.2, C47.2, C48.2, C49.2, C50.2, C51.2, C52.2, C53.2, C54.2, C55.2, C57.2, C58.2, C59.2, C60.2, C61.2, C62.2, C63.2, C64.2, C65.2, C66.2, C67.2, C68.2, C69.2, C70.2, C71.2, C72.2, C73.2, C78.2, C79.2, C80.2, C81.2, C82.2, C83.2, C84.2, C85.2, C86.2, C87.2, C92.2, C93.2, D1.1 (K), D2.1 (K), D3.1 (A), D5.1 (K), D6.1 (K), D7.1 (A), D9.1 (K), D10.1 (K), D11.1 (A), D13.1 (K), D14.1 (K), D15.1 (A), D17.1 (K), D18.1 (K), D19.1 (A), D21.1 (K), D22.1 (K), D23.1 (A), D29.1 (K), H1.1 (1_1), H2.1 (1_1), H3.1 (1_1), H4.1 (1_1), H5.1 (1_1), H6.1 (1_1), H7.1 (1_1), H8.1 (1_1), H9.1 (1_1), H10.1 (1_1), H11.1 (1_1), J7.6, J7.7, J7.8, J7.9, J7.10, J8.3, J8.6, J8.7, J8.10, J8.11, J8.14, J8.15, J8.18, J8.19, J9.5 (GND), J9.7 (GND), J9.11 (GNDDetect), J10.2, J11.2, J13.2 (Ext), J14.2 (Ext), Q1.1 (S), Q1.2 (S), Q1.3 (S), Q2.1 (S), Q2.2 (S), Q2.3 (S), Q3.1 (S), Q3.2 (S), Q3.3 (S), Q4.1 (S), Q4.2 (S), Q4.3 (S), Q5.1 (S), Q5.2 (S), Q5.3 (S), Q6.1 (S), Q6.2 (S), Q6.3 (S), Q7.2 (S), Q8.2 (S), Q9.2 (S), Q10.2 (S), Q12.1 (S), Q12.2 (S), Q12.3 (S), R10.1, R12.1, R13.2, R24.1, R26.1, R27.2, R38.1, R40.1, R41.2, R52.1, R54.1, R55.2, R66.1, R68.1, R69.2, R80.1, R82.1, R83.2, R91.1, R92.2, R94.2, R96.2, R101.2, R107.2, R110.1, R113.2, R116.2, R118.1, R120.2, R131.1, R132.1, R133.1, R134.1, R136.1, R138.1, R140.1, R148.1, SW1.1 (A), SW2.1, TP10.1 (1_1), TP25.1 (1_1), TP40.1 (1_1), TP55.1 (1_1), TP70.1 (1_1), TP85.1 (1_1), U7.5 (GND), U7.10 (GND), U8.5 (GND), U8.10 (GND), U9.1 (GND), U11.16 (VSS), U11.30 (VSSA), U11.31 (VREF-), U11.38 (VSS), U11.51 (VSS), U11.61 (VSS), U11.71 (VSS), U11.83 (VSS), U11.94 (VSS), U11.107 (VSS), U11.120 (VSS), U11.130 (VSS), U11.143 (VSS), U12.1 (GND), U13.4 (GND), U14.1 (GND), U15.2 (GND), U16.1 (GND), U17.2 (GND), U18.3 (GND), U19.4 (GND), U19.6 (CLK), U20.2 (GND1), U20.8 (GND1__1), U22.4 (GND), U22.5 (GND), U22.14 (GND), U22.26 (GND), U22.33 (EPAD), U22.34 (EPAD), U22.35 (EPAD), U23.6 (AGND), U23.12 (PGND), U23.15 (EP), U23.21 (EP), Y1.2, Y1.4
ISOGND: C74.2, C75.2, C76.2, C77.2, D32.3 (common), J12.3, TR1.5, U20.9 (GND2), U20.15 (GND2__1), U21.1 (GND)
MODGND: C3.2, C7.2, C11.2, C15.2, C19.2, C23.2, D3.3 (K), D7.3 (K), D11.3 (K), D15.3 (K), D19.3 (K), D23.3 (K), R10.2, R24.2, R38.2, R52.2, R66.2, R80.2, TP9.1 (1_1), TP24.1 (1_1), TP39.1 (1_1), TP54.1 (1_1), TP69.1 (1_1), TP84.1 (1_1), U1.1 (GND), U2.1 (GND), U3.1 (GND), U4.1 (GND), U5.1 (GND), U6.1 (GND)
unnamed: BZ1.1 (+), R90.2
unnamed: C36.1, R88.2, Y1.3
unnamed: C89.2, C90.1
unnamed: C91.2, R145.2
unnamed: C94.1, R150.1
unnamed: D1.2 (A), R1.1
unnamed: D2.2 (A), R2.1
unnamed: D5.2 (A), R15.1
unnamed: D6.2 (A), R16.1
unnamed: D9.2 (A), R29.1
unnamed: D10.2 (A), R30.1
unnamed: D13.2 (A), R43.1
unnamed: D14.2 (A), R44.1
unnamed: D17.2 (A), R57.1
unnamed: D18.2 (A), R58.1
unnamed: D21.2 (A), R71.1
unnamed: D22.2 (A), R72.1
unnamed: D25.2 (A), R93.1
unnamed: D25.1 (K), Q7.3 (D)
unnamed: D26.2 (A), R95.1
unnamed: D26.1 (K), Q8.3 (D)
unnamed: D27.2 (A), R97.1
unnamed: D27.1 (K), Q9.3 (D)
unnamed: D28.2 (A), R102.1
unnamed: D28.1 (K), Q10.3 (D)
unnamed: D29.2 (A), R109.2
unnamed: D30.2 (A), TP98.1 (1_1), TR1.4
unnamed: C76.1, D30.1 (K), D31.1 (K), R126.2, TP100.1 (1_1), U21.3 (VI)
unnamed: D31.2 (A), TP99.1 (1_1), TR1.6
unnamed: F1.1, J7.1, J7.2, J7.3, J7.4, J7.5
unnamed: J9.13 (VCP_RX), R99.2
unnamed: J9.14 (VCP_TX), R100.2
unnamed: J10.1, R117.1, R118.2, U15.3 (EN/UVLO)
unnamed: J11.1, R119.1, R120.1, U17.3 (EN/UVLO)
unnamed: JP1.2 (B), R127.1
unnamed: Q11.4 (G), U23.18 (HO)
unnamed: C88.2, L2.1, Q11.1 (S), Q11.2 (S), Q11.3 (S), Q12.5 (D), R143.1, U23.19 (SW)
unnamed: Q12.4 (G), U23.13 (LO)
unnamed: R104.1, R105.2
unnamed: R105.1, R106.2
unnamed: R108.2, R109.1
unnamed: R128.1, R129.2
unnamed: R144.2, R145.1
unnamed: R147.1, R148.2
unnamed: R89.2, SW1.2 (B)
unnamed: R3.1, U1.4 (EN)
unnamed: R17.1, U2.4 (EN)
unnamed: R31.1, U3.4 (EN)
unnamed: R45.1, U4.4 (EN)
unnamed: R59.1, U5.4 (EN)
unnamed: R73.1, U6.4 (EN)
unnamed: R85.1, U9.8 (EN)
unnamed: C48.1, U11.8 (RCC_OSC32_IN), Y2.1
unnamed: C47.1, U11.9 (RCC_OSC32_OUT), Y2.2
unnamed: R90.1, R91.2, U11.68 (PE15)
unnamed: C34.1, U11.23 (RCC_OSC_IN), Y1.1
unnamed: R88.1, U11.24 (RCC_OSC_OUT)
unnamed: C29.1, C32.1, U11.32 (VREF+)
unnamed: C54.1, C55.1, U12.2 (VO), U14.6 (VIN2)
unnamed: C56.1, U13.6 (BST)
unnamed: R110.2, U13.1 (RT)
unnamed: C56.2, L1.1, U13.5 (SW)
unnamed: R112.1, R113.1, U14.4 (PR1)
unnamed: C61.1, U15.4 (CT)
unnamed: R121.1, U15.5 (QOD)
unnamed: R114.1, R117.2, U14.2 (VOUT), U14.7 (VOUT), U15.1 (VIN)
unnamed: C63.1, U17.4 (CT)
unnamed: R122.1, U17.5 (QOD)
unnamed: TP96.1 (1_1), TR1.3, U19.1 (D1)
unnamed: TP97.1 (1_1), TR1.1, U19.3 (D2)
unnamed: R123.2, U18.2, U20.3 (R)
unnamed: C74.1, C75.1, C77.1, R126.1, TP101.1 (1_1), U20.16 (VCC2), U21.2 (VO)
unnamed: R129.1, R130.2, U22.6 (EN/UVLO)
unnamed: R133.2, U22.11 (NRETRY)
unnamed: R130.1, R131.2, U22.12 (OVLO)
unnamed: R132.2, U22.10 (RETRY_DLY)
unnamed: C88.1, U23.17 (BST)
unnamed: C90.2, C91.1, U23.4 (COMP)
unnamed: R139.1, R140.2, U23.1 (EN_UVLO)
unnamed: C89.1, C94.2, R144.1, R146.1, R147.2, U23.5 (FB)
unnamed: C87.1, R143.2, U23.11 (ILIM)
unnamed: R138.2, U23.2 (RT)
unnamed: C84.1, U23.3 (SS_TRK)
unnamed: R142.2, U23.8 (SYNCIN)
unnamed: C85.1, R142.1, U23.14 (VCC)
unnamed: C86.1, R141.1, U23.20 (VIN)
VALVE1.LSW_DIA_EN: R6.2, TP6.1 (1_1)
VALVE1.LSW_LATCH: R5.2, TP5.1 (1_1)
VALVE1.LSW_SEL1: R8.2, TP8.1 (1_1)
VALVE1.LSW_SEL2: R7.2, TP7.1 (1_1)
VALVE1.~LSW_ST: R4.2, TP4.1 (1_1)
VALVE1_HSS_EN: R1.2, R3.2, TP1.1 (1_1)
VALVE1_LSS_EN: R2.2, R11.2, TP2.1 (1_1)
VALVE1_LSW_SNS: C4.1, R14.1, TP15.1 (1_1)
VALVE2.LSW_DIA_EN: R20.2, TP21.1 (1_1)
VALVE2.LSW_LATCH: R19.2, TP20.1 (1_1)
VALVE2.LSW_SEL1: R22.2, TP23.1 (1_1)
VALVE2.LSW_SEL2: R21.2, TP22.1 (1_1)
VALVE2.~LSW_ST: R18.2, TP19.1 (1_1)
VALVE2_HSS_EN: R15.2, R17.2, TP16.1 (1_1)
VALVE2_LSS_EN: R16.2, R25.2, TP17.1 (1_1)
VALVE2_LSW_SNS: C8.1, R28.1, TP30.1 (1_1)
VALVE3.LSW_DIA_EN: R34.2, TP36.1 (1_1)
VALVE3.LSW_LATCH: R33.2, TP35.1 (1_1)
VALVE3.LSW_SEL1: R36.2, TP38.1 (1_1)
VALVE3.LSW_SEL2: R35.2, TP37.1 (1_1)
VALVE3.~LSW_ST: R32.2, TP34.1 (1_1)
VALVE3_HSS_EN: R29.2, R31.2, TP31.1 (1_1)
VALVE3_LSS_EN: R30.2, R39.2, TP32.1 (1_1)
VALVE3_LSW_SNS: C12.1, R42.1, TP45.1 (1_1)
VALVE4.LSW_DIA_EN: R48.2, TP51.1 (1_1)
VALVE4.LSW_LATCH: R47.2, TP50.1 (1_1)
VALVE4.LSW_SEL1: R50.2, TP53.1 (1_1)
VALVE4.LSW_SEL2: R49.2, TP52.1 (1_1)
VALVE4.~LSW_ST: R46.2, TP49.1 (1_1)
VALVE4_HSS_EN: R43.2, R45.2, TP46.1 (1_1)
VALVE4_LSS_EN: R44.2, R53.2, TP47.1 (1_1)
VALVE4_LSW_SNS: C16.1, R56.1, TP60.1 (1_1)
VALVE5.LSW_DIA_EN: R62.2, TP66.1 (1_1)
VALVE5.LSW_LATCH: R61.2, TP65.1 (1_1)
VALVE5.LSW_SEL1: R64.2, TP68.1 (1_1)
VALVE5.LSW_SEL2: R63.2, TP67.1 (1_1)
VALVE5.~LSW_ST: R60.2, TP64.1 (1_1)
VALVE5_HSS_EN: R57.2, R59.2, TP61.1 (1_1)
VALVE5_LSS_EN: R58.2, R67.2, TP62.1 (1_1)
VALVE5_LSW_SNS: C20.1, R70.1, TP75.1 (1_1)
VALVE6.LSW_DIA_EN: R76.2, TP81.1 (1_1)
VALVE6.LSW_LATCH: R75.2, TP80.1 (1_1)
VALVE6.LSW_SEL1: R78.2, TP83.1 (1_1)
VALVE6.LSW_SEL2: R77.2, TP82.1 (1_1)
VALVE6.~LSW_ST: R74.2, TP79.1 (1_1)
VALVE6_HSS_EN: R71.2, R73.2, TP76.1 (1_1)
VALVE6_LSS_EN: R72.2, R81.2, TP77.1 (1_1)
VALVE6_LSW_SNS: C24.1, R84.1, TP90.1 (1_1)
VBUS: C49.1, C50.1, C51.1, C52.1, C53.1, C81.1, C82.1, C83.1, F1.2, Q11.5 (D), R104.2, R139.2, R141.2, TP91.1 (1_1), U12.3 (VI), U13.3 (VIN)
