Ground-Support-Equipment-SCRT/Pad-Side-Systems/LRUs/Valve Control Unit/Software/STM32CubeProject/Valve Board STM32/Valve Board STM32.ioc

Mcu.UserName=STM32L496ZGTx
PA0.Signal=ADCx_IN5
PA1.Signal=ADCx_IN6
PA11.Signal=USB_OTG_FS_DM
PA12.Signal=USB_OTG_FS_DP
PA2.Signal=QUADSPI_BK1_NCS
PA3.Signal=ADCx_IN8
PA4.Signal=SPI1_NSS
PA5.Signal=SPI1_SCK
PA6.Signal=SPI1_MISO
PA7.Signal=SPI1_MOSI
PA9.Signal=USB_OTG_FS_VBUS
PB1.Signal=USART3_DE
PB10.Signal=GPIO_Output
PB5.Signal=GPIO_Output
PB6.Signal=GPIO_Output
PB7.Signal=GPIO_Output
PB8.Signal=GPIO_Output
PB9.Signal=GPIO_Output
PC0.Signal=ADCx_IN1
PC1.Signal=ADCx_IN2
PC10.Signal=SDMMC1_D2
PC11.Signal=SDMMC1_D3
PC12.Signal=SDMMC1_CK
PC13.Signal=SYS_WKUP2
PC2.Signal=ADCx_IN3
PC3.Signal=ADCx_IN4
PC4.Signal=USART3_TX
PC5.Signal=USART3_RX
PC8.Signal=SDMMC1_D0
PC9.Signal=SDMMC1_D1
PD0.GPIO_Label=VALVE1_LSS_EN
PD0.Signal=GPIO_Output
PD1.GPIO_Label=VALVE1_HSS_EN
PD1.Signal=GPIO_Output
PD2.Signal=SDMMC1_CMD
PD3.GPIO_Label=VALVE1_LSW_SEL1
PD3.Signal=GPIO_Input
PD4.GPIO_Label=VALVE1_LSW_SEL2
PD4.Signal=GPIO_Input
PD5.GPIO_Label=VALVE1_LSW_DIA_EN
PD5.Signal=GPIO_Input
PD6.GPIO_Label=VALVE1_LSW_LATCH
PD6.Signal=GPIO_Input
PD7.GPIO_Label=VALVE1_LSW_STn
PD7.Signal=GPIO_Output
PE0.Signal=GPIO_Output
PE1.Signal=GPIO_Input
PE10.Signal=GPIO_Output
PE11.Signal=GPIO_Output
PE12.Signal=GPIO_Output
PE13.Signal=GPIO_Output
PE14.Signal=GPIO_Output
PE15.Signal=GPIO_Output
PE2.Signal=GPIO_Output
PE3.Signal=GPIO_Output
PE4.Signal=GPIO_Output
PE5.Signal=GPIO_Output
PE6.Signal=GPIO_Output
PE7.Signal=GPIO_Output
PE8.Signal=GPIO_Output
PE9.Signal=GPIO_Input
PF0.Signal=GPIO_Output
PF1.Signal=GPIO_Input
PF10.Signal=QUADSPI_CLK
PF13.Signal=GPIO_Input
PF14.Signal=GPIO_Output
PF15.Signal=GPIO_Output
PF6.Signal=QUADSPI_BK1_IO3
PF7.Signal=QUADSPI_BK1_IO2
PF8.Signal=QUADSPI_BK1_IO0
PF9.Signal=QUADSPI_BK1_IO1
PG0.Signal=GPIO_Output
PG1.Signal=GPIO_Output
PG10.Signal=GPIO_Output
PG11.Signal=GPIO_Output
PG12.Signal=GPIO_Output
PG13.Signal=I2C1_SDA
PG14.Signal=I2C1_SCL
PG15.Signal=GPIO_Output
PG7.Signal=I2C3_SCL
PG8.Signal=I2C3_SDA
PG9.Signal=GPIO_Output
