Ground-Support-Equipment-SCRT/Pad-Side-Systems/(commit log)

2026-07-26 Add main controller board
    [09242206824.stp, 12V_main.kicad_sch, 3V3_digital.kicad_sch, 5V_main.kicad_sch, CQ-USB-C16PSMT01--3DModel-STEP-1.STEP, DPL0002A.stp, Download_STP_WE-SHC-36903255S+%28rev1%29.stp, GSB1C41110SSHR.step]
2026-07-26 Layout changes
    [master_gse_pcb_project.kicad_pcb]
2026-07-26 New layout changes
    [master_gse_pcb_project.kicad_pcb]
2026-08-24 Create text.txt
    Create Valve folder
2026-08-24 Committ latest changes
    [12V_main.kicad_sch, 3V3_digital.kicad_sch, 436500415.STEP, 436500600.STEP, 5V_main.kicad_sch, 750315371.stp, ISO1450BDWR.step, ISO3080DWR.step]
2026-08-24 Add .gitignore for KiCad project files
2026-08-24 Commit valve pcb
    [12V_aux.kicad_sch, 12V_main.kicad_sch, 3V3_main.kicad_sch, 436500215.STEP, 436500415.STEP, 5V_main.kicad_sch, 768290110.STEP, INA220AIDGSR.step]
2026-08-24 Update valve
    [09242206824.stp, 12V_aux-Henry-comp.kicad_sch, 3V3_main-Henry-comp.kicad_sch, 436500600.STEP, 5V_main-Henry-comp.kicad_sch, 750315371.stp, CQ-USB-C16PSMT01--3DModel-STEP-1.STEP, DPL0002A.stp]
2026-08-30 Commit valve board updates
    [12V_main.kicad_sch, 39299047.STEP, 3V3_digital.kicad_sch, 5V_main.kicad_sch, ADS124S08IPBSR.step, RS_485.kicad_sch, TMP1075.kicad_sch, adc.kicad_sch]
2026-10-01 Commit da changes
    [12V_main.kicad_sch, 3V3_digital.kicad_sch, 5V_main.kicad_sch, FTSH-107-01-X-DV-K.step, RS_485.kicad_sch, TMP1075.kicad_sch, W25Q128JVSIQ TR.step, adc.kicad_sch]
2026-10-08 Major changes due to architecture
    Added battery muxing for valve power, igniter system, and separate system battery for control electronics
    [76829-0102.SchLib, 76829-0102.stp, 76829-0106.SchLib, 76829-0106.stp, 768290102.PcbLib, 768290102.psm, 768290106.PcbLib, 768290106.psm]
2026-10-08 Commit updates
    [12V_main.kicad_sch, TMP1075.kicad_sch, adc.kicad_sch, block_diagrams.kicad_sch, connectors.kicad_sch, fans.kicad_sch, gate_driver.kicad_sch, igniter.kicad_sch]
2026-10-08 Major changes
    [12V_main.kicad_sch, TMP1075.kicad_sch, adc.kicad_sch, block_diagrams.kicad_sch, connectors.kicad_sch, fans.kicad_sch, gate_driver.kicad_sch, igniter.kicad_sch]
2026-10-08 New schematic
2026-10-08 Small updates
    [12V_main.kicad_sch, gate_driver.kicad_sch, igniter.kicad_sch, ldo_3V3.kicad_sch, rs-485.kicad_sch, sd_card.kicad_sch, system_5V.kicad_sch, usb-c.kicad_sch]
2026-10-10 Fixes
    Added hops, fixed the planes, and fixed minor issues
    [12V_main.kicad_sch, TMP1075.kicad_sch, adc.kicad_sch, block_diagrams.kicad_sch, connectors.kicad_sch, fans.kicad_sch, gate_driver.kicad_sch, igniter.kicad_sch]
