Ground-Support-Equipment-SCRT/Pad-Side-Systems/(notices)

Notices in the files:
LRUs/Valve Control Unit/Electrical/Valve Power Board/valve_control_pcb/components/FTSH_107_01_L_DV_K/FTSH-107-01-X-DV-K.step:
author */ ('License CC BY-ND 4.0'),
